Rhys-Q/album/hardware/reference/gdep133c02/README.md

# GDEP133C02 参考资料登记

审阅/获取日期：2026-10-01。用途：相框方案设计与后续 KiCad 电路审核。这里是厂家资料和人工整理表，不是已验证的 PCB 工程。当前结论（用户接受，2026-10-01）：**屏幕资料与设计决策已闭环，可进入最小驱动原型阶段**。到货匹配、器件选型与电气实测转实施验收，尚未完成；原图冲突仍保留，不声称厂家已解释。硬件尚未到货，未编译示例、未接屏或测量。

## 文件与来源

校验值、字节数、版本和审阅范围见 [manifest.json](manifest.json)。

| 文件 | 来源及用途 |
| --- | --- |
| [屏幕外围原理图](ESP32-133C02-screen-peripheral-V1.0.pdf) | [厂家附件](https://v4.cecdn.yun300.cn/100001_1909185148/Schematic%20for%20ESP32-133C02.pdf)，入口 [companyfile/2036](https://www.good-display.com/companyfile/2036.html)；13.3E6、V1.0、2024-07-17 更新、1 页。含电源、温度传感器、FPC；不含 MCU、SD、USB 或 AA 降压器。 |
| [开发板手册](EN-ESP32-133C02-Rev2.0.pdf) | [厂家附件](https://v4.cecdn.yun300.cn/100001_1909185148/EN-ESP32-133C02.pdf)，Rev2.0、2026-03-12、23 页。用于 GPIO、双片选与使用须知。 |
| [TPS22913 数据手册](TPS22913-SLVSB49F.pdf) | [TI 原文](https://www.ti.com/lit/ds/symlink/tps22913.pdf)，SLVSB49F、37 页。用于 U5 输入范围、使能、输出放电及封装审核。 |
| [TCN75A 数据手册](TCN75A-DS21935C.pdf) | [Microchip 原文](https://ww1.microchip.com/downloads/en/DeviceDoc/21935c.pdf)，DS21935C、32 页。用于 U4 电源、地址和功耗审核。 |
| [逐脚核对表](pin-map.csv) | 用户规格书 p6–7 与外围电路 p1 的人工交叉录入；60 行。电路详细节点仍以原图为准，不是自动生成的网表。 |
| [参考器件表](reference-bom.csv) | 外围电路 p1 的位号和值；包含 U1/U2/U3 三只 200mΩ 采样电阻。不是可直接下单的生产 BOM。 |

用户确认新增资料来自[商家提供的厂家产品页](https://www.good-display.cn/product/503.html)。用户提供的 [规格书](../../../docs/raw/GDEP133C02.pdf) 和 [源码 ZIP](<../../../docs/raw/GDEP133C02-ESP32 code example.zip>) 保留在原位置；不重复归档 ZIP 中约 48MB 的源码及旧构建缓存。源码审阅结果见 [PCB 方案 2.4](../../../docs/design/pcb.md#24-用户提供资料的审阅结果与闭环判定)。厂家 `Schematic for ESP32-133C02-IL.pdf` 与已归档单页电路 SHA-256 相同；不能因为文件名有 IL 就认定它解释了另一硬件版本。

附件来自厂家公开下载，未发现独立的再分发许可；保留原始版权，当前作为项目内部技术审阅资料，公开再发布时核对权利条件。用户已说明新增ZIP来源为商家提供的厂家页面；使用/再分发许可仍待核对。图纸含 EasyEDA 标志，仅作为电路参考；正式设计仍使用 KiCad。

下载注意：厂家 CDN 直接访问可能返回 403；本次通过官方站点 Referer 下载成功。归档时验证了 PDF 内容、页数和哈希；失败响应未作为 PDF 归档。后续核对附件版本，不以网页时间覆盖文档日期。

## 已取得的电路依据

- `EPD_VDD` → U5 → `VIN`；`VIN` 分成逻辑供电（L4 → EPD_3.3V → VDD/VDDIO）和模拟供电（L5/R31/C31/C32/R32 → AVDD）。电路本身没有输入稳压器；本项目选择前级稳压 3.3V，不能从 AA 原电池或 USB 5V 直接接入。
- 外置正/负压、电荷泵和 TFT_VCOM 使用面板控制/反馈脚与分立 MOS、BJT、二极管、电感；图中没有额外独立的专用升压控制 IC。本项目使用现有初始化与面板内置VCOM（规格书p12）；OTP/波形与温度命令按到货及最小显示结果验证。
- U4 TCN75A 与其 TSCL/TSDA 上拉均在 EPD_3.3V 域；A0–A2 接地。不能把它改为常供电，或直接当成 MCU I²C 外设。
- BUSY 通过 R1=2kΩ 上拉到 VDDIO。Pin12/18 为相连的内部 VCC；Pin13/14、16/17 分别为 VDDP/VDDN；六组源极输出/输入对分别相连。NC11/15/57 保持不接。连接器61/62为固定焊脚，不是面板信号61/62。
- 参考电容没有完整耐压、介质、有效容量或封装信息；15uH 电感没有 Isat/DCR。所有关键器件必须完成实际料号选型和布局审核。

## 采用决策及实施验收

用户于2026-10-01接受现有资料和以下方案，完成资料与设计决策闭环。详细流程以[PCB方案2.4.5](../../../docs/design/pcb.md#245-用户接受的设计基线与闭环判定)为准；资料闭环不代表硬件验证或生产放行。

| 项目 | 本项目采用决策 | 实施验收/历史差异 |
| --- | --- | --- |
| BS0/BS1及D/C | Standard SPI；BS0/BS1接受控VDD，D/C接GND | 规格书p6/8/13和8bit示例为依据。原图R24/R25接地矛盾保留，不复制到设计；不等待厂家解释 |
| DRVN2及VNCP | Pin40不接外部支路；Pin41经R16=0Ω接Pin56 | 沿用参考负压拓扑；原型测负压/显示，不宣称面板批次保证 |
| 面板/初始化 | 现有GDEP133C02规格书与原生示例，面板内置VCOM | 到货核对标签/FPC/连接器，验证OTP/波形与温度处理；不匹配时复核基线 |
| 正常关机 | 刷新完成、POF、正确等待BUSY、深睡、接口断电安全处理、关闭输入 | 规格书p22串口停止到输入下降间隔>10µs，原型起点1ms；全轨放电时间另测，不用固定20ms代替BUSY完成 |
| 异常掉电 | 未取得厂家安全保证，不声称已验证 | 原型阶段测试欠压、MCU复位、超时、各轨衰减、反灌及恢复；不得无限重试 |
| 纯手动刷新 | 无24h自动刷新或180s强制间隔 | 厂家建议差异保留，后续评估长期保持及快速换图的残影/寿命 |
| 器件与工程 | 按参考表推进自制KiCad最小原型 | 精确连接器、SI2/SI3未用输入处理、被动参数、完整采购BOM和电路审核在实施阶段完成 |

逐脚表新增 `adopted_design_connection` 字段；`reference_connection` 保留参考图事实。BS0/BS1、D/C和DRVN2按采用字段绘制项目电路；参考器件表仍是原图录入，R24/R25的原图值不能代替本项目绑带连接。

新增交叉依据：

- [微雪官方13.3寸驱动板原理图p1](https://files.waveshare.com/wiki/13.3inch%20e-Paper%20HAT%2B/13.3inch_e-Paper_HAT%2B.pdf)：也以0Ω连接VNCP_3P5V/VBB_3P5V，DRVN2没有外部支路，支持所选拓扑的工程推断。不同产品电感/器件值不直接移植，不将其当佳显面板批次保证。
- [GDEP133C02开源驱动](https://github.com/philippwaller/esphome-epaper-spectra6-133)：支持深睡后关闭外部电源，并要求验证开关关断行为。仅作实现交叉参考，不替代厂家资料或本项目实测。

上述在线资料未下载归档；URL及本次审阅范围登记在manifest的`online_references`中。

## 新增用户资料对比记录

- `GDEP133C02 (1).pdf` 与原规格书字节及SHA-256相同，不是新版本。
- `GDEP133C02-ESP32程序示例.zip` 与英文ZIP包装不同；统一工程路径后1432个文件内容全部相同，包含源码、配置及旧build，无驱动改动。
- 中文开发板手册标V1.1、2025/6/5，实际20页（页脚总数写21）；英文标Rev2.0、2026/03/12、23页。GPIO、双IC及电压/刷新建议一致，远程传图流程与附加刷机章节不同。
- 中文目录4.4、正文5.5.2与4.4下载入口混用，英文还有4.4.7章节；源码锁定4.4.4。首轮干净构建以源码基线为准，手册不能证明5.5.2兼容。

## 连接器采购线索

规格书给出 `196070-60041`；[P-TWO 196070 系列](https://www.p-two.com/index.php?do=prod&id=748) 为 0.5mm、前翻锁、下接触、2.2mm 高度；[TI 官方参考 BOM](https://www.ti.com/lit/df/tidrd16/tidrd16.pdf) 将该 60Pin 料号归于 P-TWO。外围图采用不同的 `FPC-05FB-60PH20`；[XUNPU 产品系列](https://www.xunpu.com.cn/product/413.html) 和 [嘉立创 C2856839](https://jlcpcb.com/partdetail/XUNPU-FPC_05FB60PH20/C2856839) 提供采购线索。两料号不能视为同封装替换；采购页面不替代厂家焊盘图、实际 FPC 插接或当前库存检查。

## 给厂家的具体确认清单

保留作后续适用说明和问题排查，不作为已接受方案闭环的前置条件。若厂家提供与采用基线不同的明确说明，记录差异并复核受影响电路/测试。

1. 对应实际屏幕标签/FPC批次的规格书、初始化、OTP/波形/VCOM和温度设置版本是哪一套？
2. 首版使用8bit单线 Standard 4-wire SPI：BS0/BS1、D/C#、SI2/SI3正确接法是什么？为何V1.0参考图两个BS电阻接地？
3. 该外围拓扑中 DRVN2 是否允许不接？Pin41与Pin56相连是否适用于此屏幕？
4. 正常 POF、等待 BUSY、0x07/0xA5、撤销输入的保证顺序是什么？刷新中 MCU 复位或输入消失时有哪些禁止条件、最大残压/放电时间和恢复程序？
5. 规格书电流对应哪个测量节点？高负载最低输入、浪涌/刷新最坏值与全温超时上限是什么？待机电流/功率矛盾如何解释？
6. 长期纯手动静态显示、超过24h不刷新和用户180s内连续换图是否允许？影响残影/寿命的条件是什么？
7. 提供连接器完整尺寸/焊盘图、关键电容耐压/电感规格、可复现 BOM 和示例使用许可。

仅准备了问题清单，未向厂家发送消息。Quad 不是首版必须项；后续希望启用时再获取对应协议与实测。
