Rhys-Q/album/hardware/pcb/gdep133c02-driver/releases/jlc-cn-review-v0.11-basic17-2026-10-11/README.md

# v0.11 17组基础库原型制造审阅包

147个装配件，145个顶面SMD，其中138个机器贴片、9个手工装配；36组完整BOM、29组机器BOM、7组手工BOM。BOM/CPL/制造文件来源见verification.json。

CAD及原生KiCad更新预览已通过；电气实板性能尚未验收。

Gerber压缩包含四层铜、双面阻焊/丝印、板框及PTH/NPTH钻孔。基础库17组由用户指定采用；3组参数审核通过，14组等效性能未验证。组合新增43件，不承诺订单总价节省。C15008 SMT库存未知，部分公开库存刷新未成功；订单重核。剩余7组保留原型号；E02/E07/E16/E23/E25由用户淘宝采购手工装配，机器贴片只保留E06/E24两组收费例外。J1/J2也手工装配。

新增密集区部分位号仅在F.Fab，装配时结合assembly-top.pdf与BOM。Q7保留R49；低栅压驱动、瞬态、偏压容量、温升、显示和安全掉电需焊后验收。

装配清单修订：2026-10-11，U4/U5/Q3/D3/D5/D6/FPC1从机器BOM及CPL移除，转入手工BOM。原理图、PCB、Gerber及钻孔字节不变；既有CAD验收结果沿用，本次验证装配集合和来源哈希。positions-kicad.csv仍含所有145个SMD，是CAD原生坐标参考；嘉立创下单只用bom-smt.csv和cpl-smt.csv。完整BOM保留147件；不要漏装手工器件。
