Rhys-Q/album/hardware/pcb/gdep133c02-driver/releases/jlc-cn-review-v0.10-e01-2026-10-11/README.md

# v0.10 E01 C440198 原型制造审阅包

104个装配件，102个顶面SMT；BOM/CPL/制造文件来源见verification.json。

CAD检查及GUI更新预览已通过；实板性能尚未验收。

Gerber压缩包包含四层铜、双面阻焊/丝印、板框及PTH/NPTH钻孔。钢网仅在锡膏工艺时按需使用。采购费用缺口留空，Q7国内现货未闭环。E01 22只改为C440198基础库0805 X5R，85℃上限；偏压容量/ESR/纹波等效未验证。较v0.9经济型规则再减少20元/订单；102件SMT仍全部列入机器BOM/CPL，其余24组普通扩展保留，尚未实施混合装配。其他加工费及完整采购仍有缺口，详见E01改版说明及采购CSV。
