Rhys-Q/album/hardware/pcb/gdep133c02-driver/releases/jlc-cn-review-v0.9-resistors-2026-10-10/README.md

# v0.9 三组电阻免换料费制造审阅包

104个装配件，102个顶面SMT；BOM/CPL/制造文件来源见verification.json。

CAD检查及GUI更新预览已通过；实板性能尚未验收。

Gerber压缩包包含四层铜、双面阻焊/丝印、板框及PTH/NPTH钻孔。钢网仅在锡膏工艺时按需使用。采购费用缺口留空，Q7国内现货未闭环。仅三组电阻改为免换料费型号，经济型规则下减少60元/订单；102件SMT仍全部列入机器BOM/CPL，其余25组普通扩展保留，尚未实施混合装配。其他加工费及完整采购仍有缺口，详见三组改版说明及采购CSV。
