Rhys-Q/album/docs/design/单独购买.md

# 自行购买元器件清单（v0.11）

依据最新release的`gdep133c02-driver-bom-manual.csv`整理，2026-10-11。以下为已分配手工装配的7组、每板9件；这不是未焊元件删减版电路，全部仍应按设计装配。

用户已下单，但本文件没有读取实际订单贴片数量。请按**需要完成焊接的板数**计算，不按工厂赠送/附带的裸板数直接购买。

| 位号 | 用途 | 准确型号 | 封装 | C编号（检索参考） | 每板必需 | 1板＋每型号2件备品 | 5板必需 | 5板＋每型号2件备品 |
|---|---|---|---|---|---:|---:|---:|---:|
|U4|温度传感器|TCN75AVOA713|SOIC-8|C144313|1|3|5|7|
|U5|电源负载开关|TPS22917DBVR|SOT-23-6|C2681320|1|3|5|7|
|Q3|PNP三极管|MMBT3906-7-F|SOT-23|C82762|1|3|5|7|
|D3,D5,D6|串联双肖特基二极管|BAT54SLT1G|SOT-23|C19726|3|5|15|17|
|FPC1|屏幕可插拔插座|FPC-05FB-60PH20|FPC 60P 0.5mm|C2856839|1|3|5|7|
|J1|3.3V输入，1×2直排针|TJC8-2.54-2A|PinHeader 1x02 2.54mm|C42410552|1|3|5|7|
|J2|主机接口，2×8直排针|SH-PZ254V-2x8P|PinHeader 2x08 2.54mm|C55629829|1|3|5|7|

数量公式：每种采购量＝每板用量×待装配板数＋备品。备品列统一按每种型号加2件，属于建议，不是强制；淘宝商家按包销售时向上取整。

- 完成1板：最低9件；按每型号加2件备品共23件。
- 完成5板：最低45件；按每型号加2件备品共59件。
- J1/J2虽然没有列在此前5组淘宝采购的例外中，但一直由用户手工装配，仍需自行准备。排针使用2.54mm直插，J1为单排2针，J2为双排2×8共16针；尺寸与原封装匹配，长排针可按实际结构裁切。

## 购买时核对

- TCN75AVOA713：SOIC-8；不要未经审核改用LM75/TMP75等相似名字的芯片。
- TPS22917DBVR：SOT-23-6；不要买成不同封装或功能不同的负载开关。
- MMBT3906-7-F：SOT-23，PNP，B/E/C=1/2/3；不要买成NPN的3904或直插2N3906。其他厂商3906不能仅凭简称确认等效。
- BAT54SLT1G：SOT-23，必须是**串联双肖特基**，1=A1、2=K2、3=中点；BAT54A/BAT54C内部连接不同，不能替代。
- FPC-05FB-60PH20：60P、0.5mm、现有接触方向/排线厚度/锁扣结构必须相同；不要只按“60P 0.5mm”购买。
- 淘宝商品标题或商家给出的同类替代不等于已通过本板审核；核对实物丝印、包装型号及封装。

## 不需要重复购买

E06的U1/U2/U3采样电阻、E24的L1/L2/L3功率电感仍在机器贴片BOM内；其他138个机器贴片器件也不在本清单中。此判断依据提交的release装配分配，若订单实际匹配时出现未贴/缺料，再补买对应器件。

铜测试点、安装孔是PCB结构，不是要购买的器件。屏幕、主机板、接口线缆、3.3V供电及安装螺丝不在这份手工BOM中；已拥有的无需重复采购，缺少的需另外准备。

## 来源

[最新手工BOM](../../hardware/pcb/gdep133c02-driver/releases/jlc-cn-review-v0.11-basic17-2026-10-11/gdep133c02-driver-bom-manual.csv)；[手焊说明](../../hardware/pcb/gdep133c02-driver/releases/jlc-cn-review-v0.11-basic17-2026-10-11/手焊说明-v0.11.md)。
