Rhys-Q/album/docs/design/原理图子图元器件统计与必要性.md

> 2026-10-10 v0.8：6组电阻共8位号换合格低价料；D3/D5/D6变为BAT54SLT1G；C28变为4.7µF/50V并入既有料，元件数量保持。逐项来源、成本及未采用原因见[降本审核](../../hardware/pcb/gdep133c02-driver/docs/降本审核-v0.8.md)。

> 2026-10-09 v0.7：L1–L3改用PCR1040-150-M，C28改用CL32B225KBJNNNE，C36改用0805CG102J500NT；连接与功能保持，参数和焊盘依据见工程docs/三组现货替代-v0.7.md。

# GDEP133C02驱动板：逐页、逐子图元器件统计与必要性

统计日期：2026-10-09。对象为当前 **v0.6 国内采购手焊版**原生KiCad工程，已按用户要求移除L4/L5、同步原理图/PCB及制造审阅文件，DNP状态不变。以下数量直接按当前原理图符号位号核对，并用本次KiCad导出网表确认器件值及网络，不以旧教程的标题数量推算。

## 1. 如何理解数量和“必须/可选”

每个实际器件位号计1件：60针FPC插座算1件，BAT54S内部两只二极管也只算1件；同型号并联的多只电容分别计数。GND/PWR_FLAG、标签、导线、连接点、NC叉号、功能框和分层入口不属于采购元器件；4个PCB安装孔不在原理图数量内。

| 判定 | 本文含义 | 当前装配建议 |
|---|---|---|
| **必须** | 实现当前电路、默认状态、容量/反馈预算所需；并不表示将来不能重新设计 | 按当前BOM装配 |
| **条件可选** | 有明确的替代接线、桥接或替代功能方案后可以取消；条件尚未验证 | 当前仍按BOM装配，不能仅因标“可选”少焊 |
| **可选（铜测试点）** | 只帮助测试；不参与电路功能，也不是要采购的器件 | PCB已有铜焊盘，无需装配 |

必要性判定是基于当前拓扑、接口约定和功能范围的工程判断，不是厂家给出的“最少元件数量”，也不是已经实测通过的减配结论。

本版104个装配件中：**92件按当前设计必须保留，12件为需改接线/验证的条件可选**；另有26个可选铜测试点。**当前没有已确认可以直接空焊而不改设计的装配件。** 未指定必须满足的新功能、并取得相关器件/面板数据及实测前，不能把“基本能亮”当作可以删件的依据。

## 2. 总数与子图导航

| 原理图 | 装配元件 | DNP铜测试点 | 非电源符号实体总数 | 说明 |
|---|---:|---:|---:|---|
| 顶层gdep133c02-driver.kicad_sch | 0 | 0 | 0 | 只提供三个分层页入口，不再重复计算页内元件 |
| power.kicad_sch | 56 | 2 | 58 | 六个电源功能区 |
| panel.kicad_sch | 37 | 0 | 37 | 四个功能框；含六组源极电容 |
| interface.kicad_sch | 11 | 24 | 35 | 主控连接器、五路输出和铜测试点 |
| **合计** | **104** | **26** | **130** | 102个SMT＋J1/J2两个直插装配件 |

子图按图中功能框和连线归属划分。Panel的C8/C9目前画在功能区2框内，本统计在那里列出，并注明实际为电极输出旁路；R20/R21虽然位于温度框外，按实际TSCL/TSDA连接归入温度功能区3。这样既能在现有图上找到元件，也不误解电路功能。Interface没有编号功能框，按同一行通道分子图；公共J2只计一次。

| 页面 | 子图 | 数量：装配/铜测试点 | 必须/条件可选/测试点可选 |
|---|---|---:|---:|
| power | P1 功能区1：3.3V输入、负载开关和供电分配 | 10/0 | 9/1/0 |
| power | P2 功能区2：VDDP正电源升压 | 7/0 | 7/0/0 |
| power | P3 功能区3：VDDN负电源反相 | 7/0 | 7/0/0 |
| power | P4 功能区4：VCOM所需负偏置供电 | 8/2 | 7/1/2 |
| power | P5 功能区5：VGH正栅极电荷泵 | 11/0 | 11/0/0 |
| power | P6 功能区6：VGL负栅极电荷泵 | 13/0 | 13/0/0 |
| panel | N1 功能区1：屏幕连接器与内部/边框旁路 | 4/0 | 4/0/0 |
| panel | N2 功能区2：SPI模式/信号默认状态及本框电极电容 | 5/0 | 5/0/0 |
| panel | N3 功能区3：屏幕控制的温度检测 | 4/0 | 0/4/0 |
| panel | N4 功能区4：六组源极输出配对与电容阵列 | 24/0 | 24/0/0 |
| interface | I1 主控连接器J2 | 1/0 | 0/1/0 |
| interface | I2 时钟SCLK输出通道 | 2/0 | 1/1/0 |
| interface | I3 写数据MOSI/SI0输出通道 | 2/0 | 1/1/0 |
| interface | I4 Master片选输出通道 | 2/0 | 1/1/0 |
| interface | I5 Slave片选输出通道 | 2/0 | 1/1/0 |
| interface | I6 RESET输出通道 | 2/0 | 1/1/0 |
| interface | I7 电源、状态和地参考铜测试点 | 0/24 | 0/0/24 |

两条没有独立元件的Interface连线也属于子电路：BUSY_N和SI1直接返回J2，新增器件数为0；EPD_PWR_EN从J2直接去电源页，新增器件数为0，U5/R30在power页统计。不能把跨页复用的器件再加一次。

## 3. Power：六个电源子图（56个装配件＋2个铜测试点）

能量路径为稳压3.3V输入→U5→逻辑/模拟分支→三路电感变换器及两路栅极泵。屏幕内部控制器负责GDR/DRV和反馈控制；SPI主控没有直接生成这些功率级PWM。

### P1 功能区1：3.3V输入、负载开关和供电分配

10件＝J1、U5、R30和7只电容。只有一台外部3.3V源，BENCH_3V3为开关前；EPD_3V3为开关后，逻辑与功率用同网铜线分支供电。L4/L5已删除，不需购买，也不需要0Ω替代。U5不是稳压器；QOD不能证明全部高压轨都已安全放电。

| 位号 | 当前值/器件类型 | 作用 | 必须或可选 | 保留理由或省略条件 |
|---|---|---|---|---|
| J1 | 3V3 BENCH ONLY | 稳压3.3V电源输入排针；1为正、2为地。 | **条件可选** | 只有改用可靠电线/其他连接器接原焊盘才可不装排针；电源连接本身必须存在。 |
| C28 | 4.7µF/50V | U5输入侧本地去耦，给开关启动与负载瞬态提供局部电荷。 | **必须** | 保留输入去耦，不能因外部电源已有大电容就直接省略。 |
| U5 | TPS22917DBVR | 高有效TPS22917负载开关，通断屏幕低压输入；QOD接输出参与关断放电。 | **必须** | 当前依赖它控制上电/关机；不装会断电，直接短接会取消受控供电及放电设计。 |
| R30 | 100kΩ | EPD_PWR_EN到地100k下拉，使主控高阻时U5默认关闭。 | **必须** | 必须保留明确的默认关断状态；EN=3.3V时该电阻电流约33µA。 |
| C29 | 4.7µF/50V | EPD_3V3到地4.7µF输出去耦，缓冲局部负载变化。 | **必须** | 与C30虽并联，但局部回路和总有效容量都要满足，未验证可减为单只。 |
| C30 | 4.7µF/50V | EPD_3V3到地第二只4.7µF去耦，按分布位置支持后级电流。 | **必须** | 不能只因与C29同网就判断重复；删减须重新验收容量和瞬态。 |
| C31 | 100µF/6.3V | EPD_3V3到地100µF储能，供应三路功率级的负载变化。 | **必须** | 与C32构成名义200µF容量组；减量或换料须核对偏压有效容量、启动和环路。 |
| C32 | 100µF/6.3V | EPD_3V3到地另一只100µF，与C31共同承担储能。 | **必须** | 不能按“并联所以可选”省略；当前容量预算包括这只。 |
| C33 | 100nF/50V | EPD_3V3到地100nF逻辑高频去耦。 | **必须** | 小电容和短回路处理快速扰动，不能由远处大储能电容替代。 |
| C36 | 1nF/50V C0G | 1nF软启动斜率电容，接U5 CT与芯片输入BENCH_3V3。 | **必须** | 本板的大电容启动方案依赖该参数；不可改接地，尚未验证可以不装。 |

### P2 功能区2：VDDP正电源升压

7件。Q1导通让L1储能，关断时经D1将能量送到VDDP；U1检测电流，C13维持输出。

输出电压依据：屏幕[GDEP133C02规格书](../raw/GDEP133C02.pdf)第21页的上电时序图标注VDDP为**+16～+19V**；不是第11页VGH的典型+27V。实际设定及容差需要匹配控制器初始化/内部配置并实测，不由15µH电感单独决定。L1=15µH、U1=0.2Ω、R2=1MΩ、C12=4.7µF、C13=10µF及Q1/D1型号沿用[厂家外围参考图](../../hardware/reference/gdep133c02/ESP32-133C02-screen-peripheral-V1.0.pdf)。目前属于参考设计取值，尚未取得实际开关频率、VDDP最大负载、RESEP峰值阈值及补偿参数，不能声称完成独立参数计算或硬件验收。详见[电源原理说明](../../hardware/pcb/gdep133c02-driver/docs/power-circuit-explained.md)。

| 位号 | 当前值/器件类型 | 作用 | 必须或可选 | 保留理由或省略条件 |
|---|---|---|---|---|
| L1 | 15µH | EPD_3V3到LX的15µH电感，Q1导通储能、关断向正输出送能。 | **必须** | 升压能量转换核心，不能删或用导线代替。 |
| Q1 | DMN3065LW-7 | NMOS低边开关，屏幕GDRP驱动它周期性将LX拉低。 | **必须** | 正升压开关核心；型号/引脚或驱动改变须重审。 |
| D1 | MBR230S1F-7 | LX到VDDP的肖特基整流，开关关断时向正输出送电。 | **必须** | 提供整流和续流路径，删掉不能正常建立正输出。 |
| U1 | 0.2Ω | 0.2Ω电流采样电阻，RESEP到GND，将Q1电流变为采样压差。 | **必须** | 虽用U位号，实际是电阻；短接或省略会破坏采样/电流回路。 |
| R2 | 1MΩ | 1M栅极下拉，GDRP高阻时使Q1倾向关闭。 | **必须** | 默认关断和栅极泄放功能应保留，不等同可删的测量电阻。 |
| C12 | 4.7µF/50V | 正升压输入EPD_3V3本地4.7µF去耦，缩短导通脉冲回路。 | **必须** | 远处C31/C32不能替代此处的局部回路。 |
| C13 | 10µF/50V | VDDP到地10µF输出储能，D1不送电时支持负载。 | **必须** | 维持正输出及纹波/环路条件；不能省略。 |

### P3 功能区3：VDDN负电源反相

7件。Q8高边导通给L2储能，关断时开关节点拉负，经D2形成VDDN；U2为高边采样。

| 位号 | 当前值/器件类型 | 作用 | 必须或可选 | 保留理由或省略条件 |
|---|---|---|---|---|
| Q8 | DMP3068L-7 | PMOS高边开关，GDRN使其导通，驱动L2反相变换。 | **必须** | 负电源功率开关核心，必须满足实际负VGS驱动。 |
| U2 | 0.2Ω | 0.2Ω高边采样，EPD_3V3到RESEN，检测反相支路电流。 | **必须** | 采样和主电流路径必须保留，不能改为普通0Ω。 |
| L2 | 15µH | SW_N到地15µH电感；关断时SW_N拉负形成负电源。 | **必须** | 反相储能核心，与L1不同接法，不能替代为导线。 |
| D2 | MBR230S1F-7 | VDDN到SW_N的肖特基，反相关断时给电感续流并从输出抽电荷。 | **必须** | 二极管方向决定负输出；删掉或反接会破坏变换。 |
| R3 | 1MΩ | 1M从EPD_3V3拉到GDRN，驱动高阻时使PMOS倾向关闭。 | **必须** | 保留默认关断，不能因阻值大就省略。 |
| C14 | 4.7µF/50V | 反相支路EPD_3V3本地4.7µF输入去耦。 | **必须** | 为高边开关脉冲提供局部回路。 |
| C15 | 10µF/50V | VDDN到地10µF负输出储能和纹波滤波。 | **必须** | 负输出所需；现用无极性陶瓷，换有极性电容须重新审核方向与参数。 |

### P4 功能区4：VCOM所需负偏置供电

8个装配件＋2个铜测试点。参考PMOS反相电路建立屏幕41/56脚负偏置，不是直接生成55脚TFT_VCOM波形；Q7/GDRC驱动匹配仍待测量。

| 位号 | 当前值/器件类型 | 作用 | 必须或可选 | 保留理由或省略条件 |
|---|---|---|---|---|
| Q7 | PJA3433_R1_00001 | 参考方案采用的PMOS高边开关，GDRC驱动负偏置支路。 | **必须** | 此支路必须有匹配的开关；规格书驱动描述与参考PMOS存在待测差异，保留不等于已验证。 |
| U3 | 0.2Ω | 0.2Ω高边采样，EPD_3V3到RESEC，检测偏置支路电流。 | **必须** | 不能删/短接采样元件。 |
| L3 | 15µH | SW_VCOM到地15µH电感，生成VCOM相关负偏置供电。 | **必须** | 偏置电源能量转换核心；不直接生成TFT_VCOM波形。 |
| D4 | B0530W-7-F | VBB_3P5V到SW_VCOM肖特基，给偏置反相支路整流/续流。 | **必须** | 必须保留方向和电流/耐压合适的整流通路。 |
| R13 | 1MΩ | 1M从EPD_3V3拉到Q7_GATE，使驱动释放时Q7趋向关闭。 | **必须** | 保留默认状态；实际驱动极性仍需测量。 |
| C19 | 4.7µF/50V | 负偏置支路EPD_3V3本地4.7µF去耦。 | **必须** | 支持局部脉冲电流，不能仅依赖总输入电容。 |
| C20 | 10µF/50V | VBB_3P5V到地10µF负偏置储能，供屏幕41/56脚共用节点。 | **必须** | 偏置轨必须有足够有效容量；不能直接省略。 |
| R49 | 0Ω，0805 | GDRC至Q7_GATE的可拆调试断点，正常工作连通屏幕输出与Q7栅极。 | **条件可选** | 当前按BOM装；取消电阻必须用铜线或可靠桥接替代，不能空焊。 |
| TP25 | GDRC | 屏幕驱动输出侧铜测试点。 | **可选（铜测试点）** | DNP，不采购；拆R49后可测控制器空载输出。 |
| TP26 | Q7_GATE | Q7栅极侧铜测试点。 | **可选（铜测试点）** | DNP，不采购；与RESEC差分测量VGS，R13保留在此侧。 |

### P5 功能区5：VGH正栅极电荷泵

**11件**。Q3/Q4控制正泵基准，C17和D3转移/整流电荷，R7/R8将输出电压反馈到FBP。旧电源教程该小节标题的“12件”多计1件，当前实际位号只有下面11件。

| 位号 | 当前值/器件类型 | 作用 | 必须或可选 | 保留理由或省略条件 |
|---|---|---|---|---|
| Q3 | MMBT3906-7-F | PNP高电位供电/调节管，从VDDP向正泵基准PUMP_P_LOW送电。 | **必须** | 正泵受控基准的核心，直接删除不能等效。 |
| Q4 | DMN3065LW-7 | NMOS由DRVP驱动，抽取Q3基极电流，实现高电位侧控制。 | **必须** | 屏幕低压控制到PNP控制的必要路径。 |
| R11 | 100kΩ | 100k从VDDP拉到Q3基极，Q4关闭时使PNP默认关闭。 | **必须** | 需要基极释放及确定默认状态。 |
| R12 | 1.5kΩ | 1.5k接Q4源极到地，源极退化并约束基极吸入电流。 | **必须** | 不是无功能跳线；短接会改变调节和电流条件。 |
| D3 | BAT54SLT1G | BAT54S双肖特基，分别给飞跨节点钳位和向VGH整流。 | **必须** | 两个内部二极管仍只算一个物理器件；正泵核心。 |
| C16 | 4.7µF/50V | VGH到地4.7µF最终正栅极输出储能。 | **必须** | 支持栅极负载及输出纹波。 |
| C17 | 470nF/50V | 470nF飞跨电容，LX跳变时搬运电荷到正泵。 | **必须** | 能量转移核心，不是普通可选去耦。 |
| C18 | 220nF/50V | 220nF接正泵受控基准到地，稳定Q3送电节点。 | **必须** | 基准储能/动态负载的一部分，改变会影响泵响应。 |
| R7 | 4.3kΩ | 4.3k从FBP到地，正输出电压反馈分压下臂。 | **必须** | 反馈必需，与R8共同设定检测比例；删/短会失去正确反馈。 |
| R8 | 110kΩ | 110k从VGH到FBP，正输出反馈分压上臂。 | **必须** | 反馈必需，不能为了省焊接改掉比例。 |
| R10 | 2.2Ω | 2.2Ω串在LX到正泵飞跨驱动中，阻尼并约束充放电脉冲。 | **必须** | 当前动态设计包括此阻值；未经波形/环路验证不能直接短接。 |

### P6 功能区6：VGL负栅极电荷泵

13件。Q6控制负泵基准，两级D6/C24与D5/C23建立VGL，R17/R18以REG_VGN为参考反馈。

| 位号 | 当前值/器件类型 | 作用 | 必须或可选 | 保留理由或省略条件 |
|---|---|---|---|---|
| Q6 | MMBT3904-7-F | NPN由DRVN驱动，下拉/钳位负泵基准节点。 | **必须** | 负泵控制核心；基极直接驱动能力仍需实测。 |
| D5 | BAT54SLT1G | BAT54S双肖特基，第二级负泵的钳位和整流。 | **必须** | 建立更负VGL的核心，不能删去一级。 |
| D6 | BAT54SLT1G | BAT54S双肖特基，第一级负泵的钳位和整流。 | **必须** | 建立中间负电位的核心。 |
| C21 | 4.7µF/50V | VGL到地4.7µF最终负栅极电源储能。 | **必须** | 维持负栅极轨及纹波。 |
| C22 | 1µF/50V | 1µF接两级负泵中间节点到地，存储第一级负电位。 | **必须** | 第二级所需储能基准，不与C21重复。 |
| C23 | 470nF/50V | 470nF第二级飞跨电容，驱动PUMP_N_UP。 | **必须** | 第二级电荷转移核心。 |
| C24 | 470nF/50V | 470nF第一级飞跨电容，驱动PUMP_N_DOWN。 | **必须** | 第一级电荷转移核心；与C23同值但不是可合并的同一节点。 |
| C25 | 1µF/50V | REG_VGN到地1µF去耦，稳定内部参考电压输出。 | **必须** | 负反馈使用该参考，不可把参考当成GND或省其去耦。 |
| C26 | 47nF/50V | 负泵Q6钳位节点到地47nF局部储能/去耦。 | **必须** | 决定基准瞬态的一部分，不能仅因容量小就删除。 |
| R17 | 200kΩ | 与R50串联，合计400kΩ，从VGL到FBN构成负输出反馈网络一臂。 | **必须** | 与R18/REG_VGN形成带参考电位的反馈，必须保留。 |
| R50 | 200kΩ | 与R17串联，使用常见0805阻值；中点VGL_FB_MID无额外负载。 | **必须** | 新增后两只均需装，不能单只空焊。 |
| R18 | 16kΩ | 16k从FBN到REG_VGN，负反馈的参考电位一臂。 | **必须** | 另一端不是地；删除或接地会改变负压调节。 |
| R19 | 2.2Ω | 2.2Ω串联驱动两个负泵飞跨电容，提供阻尼及脉冲约束。 | **必须** | 不能直接短接；其脉冲负担为两只飞跨电容之和。 |

## 4. Panel：四个子图（37件）

### N1 功能区1：屏幕连接器与内部/边框旁路

4件。FPC1是排线插座；C7旁路内部供电，C10/C11分别旁路Master/Slave边框驱动。

| 位号 | 当前值/器件类型 | 作用 | 必须或可选 | 保留理由或省略条件 |
|---|---|---|---|---|
| FPC1 | FPC-05FB-60PH20 | 60针0.5mm屏幕排线插座，连接电源、功率驱动、SPI和显示节点。 | **必须** | 当前用户要求可插拔排线底座；不能不焊底座并直接把软排线焊板作为本版实现。 |
| C7 | 10µF/50V | 10µF接VCC到地；FPC12内部LDO输出与18内部供电脚配对后的旁路。 | **必须** | 内部供电稳定所需，不能与外部3.3V直接合并。 |
| C10 | 470nF/50V | 470nF，Master边框驱动VCOMBD_M到地旁路/电荷缓冲。 | **必须** | 屏幕边框输出的参考负载和动态网络，未经面板资料及显示验证不删。 |
| C11 | 470nF/50V | 470nF，Slave边框驱动VCOMBD_S到地旁路/电荷缓冲。 | **必须** | 与C10作用类似但属于另一输出节点，不能合并。 |

### N2 功能区2：SPI模式/信号默认状态及本框电极电容

5件＝3只默认状态电阻＋2只画在此框中的电极旁路电容。BS0/BS1已直接接EPD_3V3，D/C直接接地，因此绑带本身新增器件数为0。

| 位号 | 当前值/器件类型 | 作用 | 必须或可选 | 保留理由或省略条件 |
|---|---|---|---|---|
| R1 | 2kΩ | BUSY_N到EPD_3V3的2k上拉，使忙状态线有正确供电域的高电平来源。 | **必须** | 沿用厂家接口；当前未证实可用内部驱动完全代替，不能改拉到主控常供电。 |
| R35 | 100kΩ | 100k从未用SI2输入到地，避免其悬空。 | **必须** | 当前未确认内部有可靠默认拉电阻，保留未用输入的明确状态。 |
| R36 | 100kΩ | 100k从未用SI3输入到地，避免其悬空。 | **必须** | 与R35作用类似但属于另一个输入；不能直接不接。 |
| C9 | 470nF/50V | 470nF，FPL_VCOM公共电极驱动输出到地旁路/电荷缓冲。 | **必须** | 虽画在SPI默认状态框中，功能属于电极驱动负载，不是SPI滤波电容。 |
| C8 | 4.7µF/50V | 4.7µF，TFT_VCOM公共电极驱动输出到地旁路/电荷缓冲。 | **必须** | 与C9不同节点及容量，不能认为两者重复；未经动态验证不删。 |

### N3 功能区3：屏幕控制的温度检测

4件。U4由屏幕专用温度接口控制，R20/R21上拉、C27去耦；不是J2上的主控I²C。U4.3 ALERT为NC，R22/R23已经删除。取消此功能需要先确认并实现替代温度方案，当前没有这样的固件验收。

| 位号 | 当前值/器件类型 | 作用 | 必须或可选 | 保留理由或省略条件 |
|---|---|---|---|---|
| U4 | TCN75AVOA713 | TCN75A温度传感器，由屏幕TSCL/TSDA接口读取，地址绑带0x48。 | **条件可选** | 只有确认屏幕固件可不用外部传感器、具备有效替代温度来源/策略并验证刷新后，才可整组删除；当前仍装。 |
| R20 | 4.7kΩ | 4.7k，TSCL到EPD_3V3上拉，为温度串行时钟提供释放后的高电平。 | **条件可选** | 使用当前温度通路时必须；放弃并验证替代温度方案时才可与整组删除。 |
| R21 | 4.7kΩ | 4.7k，TSDA到EPD_3V3上拉，为开漏数据线提供高电平。 | **条件可选** | 使用当前温度通路时必须；不能仅删一只仍期待传感器正常工作。 |
| C27 | 100nF/50V | 100nF，U4供电到地的本地去耦。 | **条件可选** | U4保留时必须；只有整组温度检测取消后它才不再需要。 |

### N4 功能区4：六组源极输出配对与电容阵列

24件。六组配对节点各用4只电容，按当前组合每只都计入所需容量；同网并联不等于任何一只可以随意删去。

| 源极网络 | 屏幕配对引脚 | 四个电容位号 | 名义总容量 |
|---|---|---|---|
| VSPH | 42/45 | C1、C103、C104、C105 | 3×10µF＋3.3µF＝33.3µF |
| VSPL | 43/46 | C2、C106、C107、C108 | 3×10µF＋3.3µF＝33.3µF |
| VSPL2 | 44/47 | C3、C109、C110、C111 | 3×10µF＋3.3µF＝33.3µF |
| VSNH | 48/53 | C4、C112、C113、C114 | 3×10µF＋3.3µF＝33.3µF |
| VSNL | 49/52 | C5、C115、C116、C117 | 3×10µF＋3.3µF＝33.3µF |
| VSNL2 | 50/51 | C6、C118、C119、C120 | 3×10µF＋3.3µF＝33.3µF |

下面仍逐只列出，避免把“六组电容”误统计成六个元件。

| 位号 | 当前值/器件类型 | 作用 | 必须或可选 | 保留理由或省略条件 |
|---|---|---|---|---|
| C1 | 10µF/50V | VSPH到地的10µF并联储能电容，组内第1只10µF；缓冲源极驱动电流并维持节点电压。 | **必须（容量组）** | 必须（按当前容量组）；每组3×10µF＋3.3µF，不能逐只当作冗余。少装或改单只替代须验证高压偏置有效容量、纹波和环路。 |
| C103 | 10µF/50V | VSPH到地的10µF并联储能电容，组内第2只10µF；缓冲源极驱动电流并维持节点电压。 | **必须（容量组）** | 必须（按当前容量组）；每组3×10µF＋3.3µF，不能逐只当作冗余。少装或改单只替代须验证高压偏置有效容量、纹波和环路。 |
| C104 | 10µF/50V | VSPH到地的10µF并联储能电容，组内第3只10µF；缓冲源极驱动电流并维持节点电压。 | **必须（容量组）** | 必须（按当前容量组）；每组3×10µF＋3.3µF，不能逐只当作冗余。少装或改单只替代须验证高压偏置有效容量、纹波和环路。 |
| C105 | 3.3µF/50V | VSPH到地的3.3µF并联储能电容，补足该组名义33.3µF；缓冲源极驱动电流并维持节点电压。 | **必须（容量组）** | 必须（按当前容量组）；每组3×10µF＋3.3µF，不能逐只当作冗余。少装或改单只替代须验证高压偏置有效容量、纹波和环路。 |
| C2 | 10µF/50V | VSPL到地的10µF并联储能电容，组内第1只10µF；缓冲源极驱动电流并维持节点电压。 | **必须（容量组）** | 必须（按当前容量组）；每组3×10µF＋3.3µF，不能逐只当作冗余。少装或改单只替代须验证高压偏置有效容量、纹波和环路。 |
| C106 | 10µF/50V | VSPL到地的10µF并联储能电容，组内第2只10µF；缓冲源极驱动电流并维持节点电压。 | **必须（容量组）** | 必须（按当前容量组）；每组3×10µF＋3.3µF，不能逐只当作冗余。少装或改单只替代须验证高压偏置有效容量、纹波和环路。 |
| C107 | 10µF/50V | VSPL到地的10µF并联储能电容，组内第3只10µF；缓冲源极驱动电流并维持节点电压。 | **必须（容量组）** | 必须（按当前容量组）；每组3×10µF＋3.3µF，不能逐只当作冗余。少装或改单只替代须验证高压偏置有效容量、纹波和环路。 |
| C108 | 3.3µF/50V | VSPL到地的3.3µF并联储能电容，补足该组名义33.3µF；缓冲源极驱动电流并维持节点电压。 | **必须（容量组）** | 必须（按当前容量组）；每组3×10µF＋3.3µF，不能逐只当作冗余。少装或改单只替代须验证高压偏置有效容量、纹波和环路。 |
| C3 | 10µF/50V | VSPL2到地的10µF并联储能电容，组内第1只10µF；缓冲源极驱动电流并维持节点电压。 | **必须（容量组）** | 必须（按当前容量组）；每组3×10µF＋3.3µF，不能逐只当作冗余。少装或改单只替代须验证高压偏置有效容量、纹波和环路。 |
| C109 | 10µF/50V | VSPL2到地的10µF并联储能电容，组内第2只10µF；缓冲源极驱动电流并维持节点电压。 | **必须（容量组）** | 必须（按当前容量组）；每组3×10µF＋3.3µF，不能逐只当作冗余。少装或改单只替代须验证高压偏置有效容量、纹波和环路。 |
| C110 | 10µF/50V | VSPL2到地的10µF并联储能电容，组内第3只10µF；缓冲源极驱动电流并维持节点电压。 | **必须（容量组）** | 必须（按当前容量组）；每组3×10µF＋3.3µF，不能逐只当作冗余。少装或改单只替代须验证高压偏置有效容量、纹波和环路。 |
| C111 | 3.3µF/50V | VSPL2到地的3.3µF并联储能电容，补足该组名义33.3µF；缓冲源极驱动电流并维持节点电压。 | **必须（容量组）** | 必须（按当前容量组）；每组3×10µF＋3.3µF，不能逐只当作冗余。少装或改单只替代须验证高压偏置有效容量、纹波和环路。 |
| C4 | 10µF/50V | VSNH到地的10µF并联储能电容，组内第1只10µF；缓冲源极驱动电流并维持节点电压。 | **必须（容量组）** | 必须（按当前容量组）；每组3×10µF＋3.3µF，不能逐只当作冗余。少装或改单只替代须验证高压偏置有效容量、纹波和环路。 |
| C112 | 10µF/50V | VSNH到地的10µF并联储能电容，组内第2只10µF；缓冲源极驱动电流并维持节点电压。 | **必须（容量组）** | 必须（按当前容量组）；每组3×10µF＋3.3µF，不能逐只当作冗余。少装或改单只替代须验证高压偏置有效容量、纹波和环路。 |
| C113 | 10µF/50V | VSNH到地的10µF并联储能电容，组内第3只10µF；缓冲源极驱动电流并维持节点电压。 | **必须（容量组）** | 必须（按当前容量组）；每组3×10µF＋3.3µF，不能逐只当作冗余。少装或改单只替代须验证高压偏置有效容量、纹波和环路。 |
| C114 | 3.3µF/50V | VSNH到地的3.3µF并联储能电容，补足该组名义33.3µF；缓冲源极驱动电流并维持节点电压。 | **必须（容量组）** | 必须（按当前容量组）；每组3×10µF＋3.3µF，不能逐只当作冗余。少装或改单只替代须验证高压偏置有效容量、纹波和环路。 |
| C5 | 10µF/50V | VSNL到地的10µF并联储能电容，组内第1只10µF；缓冲源极驱动电流并维持节点电压。 | **必须（容量组）** | 必须（按当前容量组）；每组3×10µF＋3.3µF，不能逐只当作冗余。少装或改单只替代须验证高压偏置有效容量、纹波和环路。 |
| C115 | 10µF/50V | VSNL到地的10µF并联储能电容，组内第2只10µF；缓冲源极驱动电流并维持节点电压。 | **必须（容量组）** | 必须（按当前容量组）；每组3×10µF＋3.3µF，不能逐只当作冗余。少装或改单只替代须验证高压偏置有效容量、纹波和环路。 |
| C116 | 10µF/50V | VSNL到地的10µF并联储能电容，组内第3只10µF；缓冲源极驱动电流并维持节点电压。 | **必须（容量组）** | 必须（按当前容量组）；每组3×10µF＋3.3µF，不能逐只当作冗余。少装或改单只替代须验证高压偏置有效容量、纹波和环路。 |
| C117 | 3.3µF/50V | VSNL到地的3.3µF并联储能电容，补足该组名义33.3µF；缓冲源极驱动电流并维持节点电压。 | **必须（容量组）** | 必须（按当前容量组）；每组3×10µF＋3.3µF，不能逐只当作冗余。少装或改单只替代须验证高压偏置有效容量、纹波和环路。 |
| C6 | 10µF/50V | VSNL2到地的10µF并联储能电容，组内第1只10µF；缓冲源极驱动电流并维持节点电压。 | **必须（容量组）** | 必须（按当前容量组）；每组3×10µF＋3.3µF，不能逐只当作冗余。少装或改单只替代须验证高压偏置有效容量、纹波和环路。 |
| C118 | 10µF/50V | VSNL2到地的10µF并联储能电容，组内第2只10µF；缓冲源极驱动电流并维持节点电压。 | **必须（容量组）** | 必须（按当前容量组）；每组3×10µF＋3.3µF，不能逐只当作冗余。少装或改单只替代须验证高压偏置有效容量、纹波和环路。 |
| C119 | 10µF/50V | VSNL2到地的10µF并联储能电容，组内第3只10µF；缓冲源极驱动电流并维持节点电压。 | **必须（容量组）** | 必须（按当前容量组）；每组3×10µF＋3.3µF，不能逐只当作冗余。少装或改单只替代须验证高压偏置有效容量、纹波和环路。 |
| C120 | 3.3µF/50V | VSNL2到地的3.3µF并联储能电容，补足该组名义33.3µF；缓冲源极驱动电流并维持节点电压。 | **必须（容量组）** | 必须（按当前容量组）；每组3×10µF＋3.3µF，不能逐只当作冗余。少装或改单只替代须验证高压偏置有效容量、纹波和环路。 |

## 5. Interface：主控及测试子图（11件＋24铜焊盘）

本版删除U6/U7、Q9/Q10及其外围，信号直连；33Ω和100k电阻不提供电平转换或掉电隔离。

### I1 主控连接器J2

1件。主控排针只计一次；16脚NC，不再连接HOST_3V3；BUSY_N、SI1为主控输入。

| 位号 | 当前值/器件类型 | 作用 | 必须或可选 | 保留理由或省略条件 |
|---|---|---|---|---|
| J2 | HOST DIRECT 3V3 | 2×8主控排针，承载SPI、BUSY、使能及共地；16脚NC。 | **条件可选** | 可改成可靠直焊线/其他连接器，但信号和共地连接必须保留；不装不是通信仍自动可用。 |

### I2 时钟SCLK输出通道

2件：33Ω串联＋100k默认下拉。

| 位号 | 当前值/器件类型 | 作用 | 必须或可选 | 保留理由或省略条件 |
|---|---|---|---|---|
| R39 | 33Ω | 33Ω串在HOST_SCLK到SCLK之间，减缓边沿振铃及脉冲尖峰。 | **条件可选** | 只有桥接/重画铜线并验证短排线SPI边沿和可靠性后才可取消串联电阻；空焊盘会直接断信号。 |
| R44 | 100kΩ | 100k将SCLK下拉到GND，使时钟默认低。 | **必须** | 保留复位/启动时的确定默认电平；这些拉电阻不能隔离或阻止错误GPIO高电平反灌。 |

### I3 写数据MOSI/SI0输出通道

2件：33Ω串联＋100k默认下拉。

| 位号 | 当前值/器件类型 | 作用 | 必须或可选 | 保留理由或省略条件 |
|---|---|---|---|---|
| R40 | 33Ω | 33Ω串在HOST_MOSI到SI0之间，减缓边沿振铃及脉冲尖峰。 | **条件可选** | 只有桥接/重画铜线并验证短排线SPI边沿和可靠性后才可取消串联电阻；空焊盘会直接断信号。 |
| R45 | 100kΩ | 100k将SI0下拉到GND，使写数据默认低。 | **必须** | 保留复位/启动时的确定默认电平；这些拉电阻不能隔离或阻止错误GPIO高电平反灌。 |

### I4 Master片选输出通道

2件：33Ω串联＋100k屏幕供电域上拉。

| 位号 | 当前值/器件类型 | 作用 | 必须或可选 | 保留理由或省略条件 |
|---|---|---|---|---|
| R41 | 33Ω | 33Ω串在HOST_CS_M_N到CS_M_N之间，减缓边沿振铃及脉冲尖峰。 | **条件可选** | 只有桥接/重画铜线并验证短排线SPI边沿和可靠性后才可取消串联电阻；空焊盘会直接断信号。 |
| R46 | 100kΩ | 100k将CS_M_N上拉到EPD_3V3，使屏幕有电且主控高阻时片选默认不选中。 | **必须** | 保留复位/启动时的确定默认电平；这些拉电阻不能隔离或阻止错误GPIO高电平反灌。 |

### I5 Slave片选输出通道

2件：33Ω串联＋100k屏幕供电域上拉。

| 位号 | 当前值/器件类型 | 作用 | 必须或可选 | 保留理由或省略条件 |
|---|---|---|---|---|
| R42 | 33Ω | 33Ω串在HOST_CS_S_N到CS_S_N之间，减缓边沿振铃及脉冲尖峰。 | **条件可选** | 只有桥接/重画铜线并验证短排线SPI边沿和可靠性后才可取消串联电阻；空焊盘会直接断信号。 |
| R47 | 100kΩ | 100k将CS_S_N上拉到EPD_3V3，使同理设置Slave片选默认不选中。 | **必须** | 保留复位/启动时的确定默认电平；这些拉电阻不能隔离或阻止错误GPIO高电平反灌。 |

### I6 RESET输出通道

2件：33Ω串联＋100k默认下拉。

| 位号 | 当前值/器件类型 | 作用 | 必须或可选 | 保留理由或省略条件 |
|---|---|---|---|---|
| R43 | 33Ω | 33Ω串在HOST_RES_N到RES_N之间，减缓边沿振铃及脉冲尖峰。 | **条件可选** | 只有桥接/重画铜线并验证短排线SPI边沿和可靠性后才可取消串联电阻；空焊盘会直接断信号。 |
| R48 | 100kΩ | 100k将RES_N下拉到GND，使主控高阻时保持复位。 | **必须** | 保留复位/启动时的确定默认电平；这些拉电阻不能隔离或阻止错误GPIO高电平反灌。 |

### I7 电源、状态和地参考铜测试点

24个铜测试点，实际装配数量为0；TP10虽然Value保留旧名字VNCP_3P5V，实际网络和TP9相同，均为VBB_3P5V；这只是两个探针位置，不是两路独立电源。

| 位号 | 当前值/器件类型 | 作用 | 必须或可选 | 保留理由或省略条件 |
|---|---|---|---|---|
| TP1 | BENCH_3V3 | BENCH_3V3网络的探针接触铜焊盘，用于测量该节点电压/状态。 | **可选（铜测试点）** | 已有铜焊盘，无需购买/焊接器件；改板时可删该测试位置，代价是测量和排查更难。 |
| TP2 | EPD_3V3 | EPD_3V3输出分配区域的探针接触铜焊盘，用于测量该节点电压/状态。 | **可选（铜测试点）** | 已有铜焊盘，无需购买/焊接器件；改板时可删该测试位置，代价是测量和排查更难。 |
| TP3 | EPD_3V3 | EPD_3V3功率分支的探针接触铜焊盘，用于测量该节点电压/状态。 | **可选（铜测试点）** | 已有铜焊盘，无需购买/焊接器件；改板时可删该测试位置，代价是测量和排查更难。 |
| TP4 | EPD_3V3 | EPD_3V3网络的探针接触铜焊盘，用于测量该节点电压/状态。 | **可选（铜测试点）** | 已有铜焊盘，无需购买/焊接器件；改板时可删该测试位置，代价是测量和排查更难。 |
| TP5 | VDDP | VDDP网络的探针接触铜焊盘，用于测量该节点电压/状态。 | **可选（铜测试点）** | 已有铜焊盘，无需购买/焊接器件；改板时可删该测试位置，代价是测量和排查更难。 |
| TP6 | VDDN | VDDN网络的探针接触铜焊盘，用于测量该节点电压/状态。 | **可选（铜测试点）** | 已有铜焊盘，无需购买/焊接器件；改板时可删该测试位置，代价是测量和排查更难。 |
| TP7 | VGH | VGH网络的探针接触铜焊盘，用于测量该节点电压/状态。 | **可选（铜测试点）** | 已有铜焊盘，无需购买/焊接器件；改板时可删该测试位置，代价是测量和排查更难。 |
| TP8 | VGL | VGL网络的探针接触铜焊盘，用于测量该节点电压/状态。 | **可选（铜测试点）** | 已有铜焊盘，无需购买/焊接器件；改板时可删该测试位置，代价是测量和排查更难。 |
| TP9 | VBB_3P5V | VBB_3P5V网络的探针接触铜焊盘，用于测量该节点电压/状态。 | **可选（铜测试点）** | 已有铜焊盘，无需购买/焊接器件；改板时可删该测试位置，代价是测量和排查更难。 |
| TP10 | VNCP_3P5V | VBB_3P5V网络的探针接触铜焊盘，用于测量该节点电压/状态。 | **可选（铜测试点）** | 已有铜焊盘，无需购买/焊接器件；改板时可删该测试位置，代价是测量和排查更难。 |
| TP11 | TFT_VCOM | TFT_VCOM网络的探针接触铜焊盘，用于测量该节点电压/状态。 | **可选（铜测试点）** | 已有铜焊盘，无需购买/焊接器件；改板时可删该测试位置，代价是测量和排查更难。 |
| TP12 | VCC | VCC网络的探针接触铜焊盘，用于测量该节点电压/状态。 | **可选（铜测试点）** | 已有铜焊盘，无需购买/焊接器件；改板时可删该测试位置，代价是测量和排查更难。 |
| TP13 | BUSY_N | BUSY_N网络的探针接触铜焊盘，用于测量该节点电压/状态。 | **可选（铜测试点）** | 已有铜焊盘，无需购买/焊接器件；改板时可删该测试位置，代价是测量和排查更难。 |
| TP14 | EPD_PWR_EN | EPD_PWR_EN网络的探针接触铜焊盘，用于测量该节点电压/状态。 | **可选（铜测试点）** | 已有铜焊盘，无需购买/焊接器件；改板时可删该测试位置，代价是测量和排查更难。 |
| TP15 | RES_N | RES_N网络的探针接触铜焊盘，用于测量该节点电压/状态。 | **可选（铜测试点）** | 已有铜焊盘，无需购买/焊接器件；改板时可删该测试位置，代价是测量和排查更难。 |
| TP16 | GND | GND网络的探针接触铜焊盘，作为测量地参考。 | **可选（铜测试点）** | 已有铜焊盘，无需购买/焊接器件；改板时可删该测试位置，代价是测量和排查更难。 |
| TP17 | GND | GND网络的探针接触铜焊盘，作为测量地参考。 | **可选（铜测试点）** | 已有铜焊盘，无需购买/焊接器件；改板时可删该测试位置，代价是测量和排查更难。 |
| TP18 | GND | GND网络的探针接触铜焊盘，作为测量地参考。 | **可选（铜测试点）** | 已有铜焊盘，无需购买/焊接器件；改板时可删该测试位置，代价是测量和排查更难。 |
| TP19 | GND | GND网络的探针接触铜焊盘，作为测量地参考。 | **可选（铜测试点）** | 已有铜焊盘，无需购买/焊接器件；改板时可删该测试位置，代价是测量和排查更难。 |
| TP20 | GND | GND网络的探针接触铜焊盘，作为测量地参考。 | **可选（铜测试点）** | 已有铜焊盘，无需购买/焊接器件；改板时可删该测试位置，代价是测量和排查更难。 |
| TP21 | GND | GND网络的探针接触铜焊盘，作为测量地参考。 | **可选（铜测试点）** | 已有铜焊盘，无需购买/焊接器件；改板时可删该测试位置，代价是测量和排查更难。 |
| TP22 | GND | GND网络的探针接触铜焊盘，作为测量地参考。 | **可选（铜测试点）** | 已有铜焊盘，无需购买/焊接器件；改板时可删该测试位置，代价是测量和排查更难。 |
| TP23 | GND | GND网络的探针接触铜焊盘，作为测量地参考。 | **可选（铜测试点）** | 已有铜焊盘，无需购买/焊接器件；改板时可删该测试位置，代价是测量和排查更难。 |
| TP24 | GND | GND网络的探针接触铜焊盘，作为测量地参考。 | **可选（铜测试点）** | 已有铜焊盘，无需购买/焊接器件；改板时可删该测试位置，代价是测量和排查更难。 |

## 6. 哪些是可选，实际能省什么

| 条件可选类别 | 位号 | 数量 | 必须做的替代/验证 |
|---|---|---:|---|
| 连接器本体 | J1、J2 | 2 | 改可靠接线方式，供电、共地和信号连接保留；FPC1仍按可插拔底座装配 |
| 信号串联阻尼 | R39–R43 | 5 | 桥接/重新布铜保证信号连续，验证短排线边沿、过冲、可靠性 |
| 外部温度检测功能 | U4、R20、R21、C27 | 4 | 确认面板支持替代温度方案，调整并验证控制器/固件；不能只删传感器、让程序继续等待外部温度 |
| MOS调试断点 | R49 | 1 | 若取消，须可靠桥接GDRC与Q7_GATE；正常装0Ω，拆除仅用于断电后的隔离调试 |
| 测试位置 | TP1–TP26 | 26个铜焊盘 | 不采购不焊接；本来就没有装配成本，删除不会少买24个器件 |

12个条件可选不能简单相加成为“可直接少焊12件”的建议。温度方案尚未验证；五只串联电阻取消后仍需重新改线和验证。当前BOM为104件；L4/L5已经从CAD/BOM删除，全部去耦保留，新增共用供电噪声验收项。

电源开关、启动电容、默认下拉、电感/MOS/整流、采样、反馈、飞跨电容及高压储能，均按当前功能判为必须。对C29/C30、C31/C32和六组并联电容，将来可以重新选择数量或封装，但必须满足有效容量和布局要求；那是重新设计，不是现成的可选焊接配置。标称33.3µF并不证明高压偏置下仍有33.3µF，当前项目尚未完成这一验收。

## 7. 当前图面与统计中容易混淆的地方

- Panel页仍有“R23 DNP: alert output is not strapped to ground”旧文字，但当前符号/网表没有R23，也没有R22；**不计入数量，也不采购**。该文字仅记录未使用的ALERT接法，与本次P1改版无关。
- 旧电源教程VGH子图标题写12件，实际为11件；本文以实际符号核数。电源总数为10＋7＋7＋8＋11＋12＝55，另有P4两个铜测试点。
- U1/U2/U3是三个0.2Ω采样电阻，不是三个IC；L4/L5已删除；L1/L2/L3仍是必需的功率储能电感。
- 26个TP是DNP铜焊盘；GND与PWR_FLAG符号、功能框、标签不算装配器件。4个PCB安装孔也不进入原理图BOM。
- C8/C9虽位于Panel功能区2框内，实际属于电极输出旁路；R20/R21位于温度框外，但电气上属于温度检测。元件归属按本节说明，避免同一元件在两个功能区重复计数。
- 必须保留的电路功能不等于器件型号、参数和硬件行为已验收。当前GUI打开已通过；实物FPC配接、功率峰值/温升、容量与全轨掉电仍有待验收项。

## 8. 查图、查详细原理与复核依据

当前工程：[KiCad项目](../../hardware/pcb/gdep133c02-driver/gdep133c02-driver.kicad_pro)、[整套原理图PDF](../../hardware/pcb/gdep133c02-driver/reports/schematic.pdf)。逐项原理：[Power详解](../../hardware/pcb/gdep133c02-driver/docs/power-circuit-explained.md)、[Panel详解](../../hardware/pcb/gdep133c02-driver/docs/panel-circuit-explained.md)、[Interface详解](../../hardware/pcb/gdep133c02-driver/docs/interface-circuit-explained.md)。

上电和关机约束见[接口供电约定](../../hardware/pcb/gdep133c02-driver/docs/interface-power-state.md)：3.3V逻辑、主控先上电最后断电、关屏前全部GPIO输出低/输入无上拉、禁止热插拔。需要更少器件时先明确保留哪些功能，再改原理图、PCB及固件，重新检查和实测。

本次复核：当前v0.8保持104个装配件、37组采购行，130个实体位号。原生ERC、DRC、未连接与原理图/PCB一致性检查均为0；KiCad工程模式更新预览无新增器件。来源与制造产物哈希见最新release的verification.json。实板性能仍需焊后验证。

统计所用原理图SHA256（用于日后判断本文是否对应当前图）：

| 原理图 | SHA256 |
|---|---|
| gdep133c02-driver.kicad_sch | `5fb141347861a05383ce12cd1c3f999ef93cf21704997589a919dcbec45026e1` |
| power.kicad_sch | `22a53dde8e58be364575dd9e47d62158d7dbaf09eb2f80d0cf11d9ce4ed27d6d` |
| panel.kicad_sch | `2057dee4422aa8bfc64c3f682547d8eddaecaf06d9fc9fd8a3792d1c41d226a2` |
| interface.kicad_sch | `3d2e5271d4cb08c107c6f6b832704c17050b8ceedcbfb118d3b716ec08812090` |
