Rhys-Q/album/docs/design/仓库目录与维护约定.md

# 仓库目录与维护约定

2026-10-08整理。正式工程和原厂资料保留，只保留最新制造审阅包。

| 目录 | 用途 |
|---|---|
| `docs/design/` | 总体/PCB设计、新手教程、器件统计及维护说明 |
| `docs/raw/` | 原始屏幕资料、厂家示例和嘉立创下单说明 |
| `hardware/reference/` | 屏幕外围电路和器件原厂参考资料 |
| `hardware/pcb/gdep133c02-driver/` | 当前KiCad原生工程、设计记录、本地库及所需模型 |
| 工程 `docs/` | 三页电路详解、供电/调试/配接和使用约定 |
| 工程 `reports/` | 当前ERC/DRC、网表、检查来源、GUI预览、图面及清理清单 |
| 工程 `releases/jlc-cn-review-v0.5-linkfix-2026-10-08/` | 唯一保留的当前制造审阅包 |
| 工程 `scripts/` | 当前检查、导出和原生文件解析工具 |

本次清理了旧release、历史CAD备份、失败/中间DRC和布线输入输出、旧专项审核文档、一次性迁移脚本、未使用的封装/符号/模型、完成的任务草稿及自动历史/缓存。原始PDF、厂家示例和用于选型的资料没有按日期删除；它们是设计依据。

当前CAD电路和制造几何没有变化；仍为103装配件、101顶面SMT、26铜测试点。源文件与当前库的SHA256已同步到检查来源及最新release清单。旧工程版本由主仓库Git历史查阅，不在当前目录堆放副本；Git主仓库和提交历史未删除。

删除前已备份待删除内容及相关文档，包含 `.history` 的未提交文件和内部Git数据，备份位于仓库外：`/tmp/album-cleanup-20261008-222921.tar.gz`。这是临时恢复备份，不是新的工程release；系统临时目录不适合长期归档，需要长期留存时另行保存。具体清理路径见工程 `reports/cleanup-manifest.json`。

后续修改先同步原理图/PCB/设计记录，检查ERC、DRC及符号关联，再导出新版本。确认新包完整后移除旧release，并更新README和下单说明。导出脚本拒绝覆盖现有目录，不能靠删除当前唯一release绕过保护。自动历史、锁文件、缓存和本机界面设置由ignore规则排除；不要在仓库复制完整旧工程。
