Rhys-Q/album/hardware/pcb/gdep133c02-driver/docs/剩余24组基础库重新审核-2026-10-11.md

> 本文是改版前的审核快照。2026-10-11用户随后指定采用其中3＋14组，当前CAD/BOM及未验证项见[基础库17组改版-v0.11.md](基础库17组改版-v0.11.md)。

# 剩余24组基础库重新审核（2026-10-11）

> 基线：当前 v0.10-e01 原生 KiCad 工程；E01 已实施，不在这24组中。本报告为选型审核，不是新release、生产批准或实板验收。正式工程及现有release没有修改。

## 1. 这次得到什么结论

24个是**型号组**，不是24只元器件。重新审核后，不能再说“这24组在基础库中都没有替代”。

- **3组具备下一轮实施条件**：E21普通低压去耦同0805替换；E20、E22用两只基础库电阻串联，参数审核通过，需增加位号和布局。
- **14组找到基础库候选或组合路径，但还未满足正式替换标准**：存在偏压容量、驱动/损耗、库存证据或调整收益问题。具体缺口逐组列出。
- **7组本轮未取得合格免费方案**：E02、E06、E07、E16、E23、E24、E25。它表示已查候选没有形成合格免费结论，**不是证明全库绝无替代**。扩展标签也不排除需另外核实的合作免换料费身份。

原生工程仍为37组、104件；本次没有新增符号、改封装、重新布线或发布。129个既有release源文件哈希均与当前文件一致。

完整商业记录：[候选与库存、MOQ、阶梯、1/5板费用CSV](剩余24组基础库候选-2026-10-11.csv)。设计取舍：[待决定CSV](剩余24组基础库待决定-2026-10-11.csv)。

## 2. 上次为什么漏查，如何避免重犯

上次检索脚本对原件是1210等封装时只保留原封装，而用户的约定是优先0805、允许改变封装。这是脚本自行加入的限制，并不是用户要求。此外，上次主要依赖商城给出的有限替代推荐，推荐列表没有某个C号，不能当作基础库没有该料的证据。

这次先按电路参数找型号，再核对准确C号的国内产品页面和原厂资料；原封装不作筛除条件。网上/海外目录只提供线索，国内基础库结论以本次国内页面为准。正常公开检索未能访问的页面记录为未知，不绕过滑动验证。

同时修正分类：找到型号、取得免费标签、取得SMT库存、完成电气核验、CAD实施通过，是不同阶段。本文用这些阶段解释保留原因。

## 3. 三组优先实施建议

|组|当前|建议|封装/数量变化|审核结论|
|---|---|---|---|---|
|E21 C27/C33|C1711 三星100nF/50V/X7R/0805|**C28233 / CL21B104KCFNNNE**，100nF/100V/X7R/0805|数量和XY封装不变；名义厚度0.85→1.25mm|3.3V去耦参数通过；CAD中需检查高度和丝印/装配属性|
|E20 R18|C2774511 16kΩ/0805/333mW|**C17475 / 0805W8F1502T5E** 15kΩ＋**C17513 / 0805W8F1001T5E** 1kΩ串联|两只0805，新增1只|阻值、误差、温漂与正常反馈功耗通过；需同意增加器件后实施|
|E22 R8|C5140228 110kΩ/0805|**C149504 / 0805W8F1003T5E** 100kΩ＋**C17414 / 0805W8F1002T5E** 10kΩ串联|两只0805，新增1只；100k料工程已有|反馈比例和功率审核通过；需同意增加器件后实施|

三组选定C号本次均为国内**SMT基础库**且有SMT库存。普通电阻两只各±1%，串联总阻值最坏误差仍±1%；有效TCR是阻值加权平均，保持±100ppm/℃界限，不能误写成±2%。与另一反馈臂组合后的比值误差仍要按两臂计算，并没有因此降为0。

### R18功率为什么可以用125mW的基础库电阻

正常高阻反馈输入下，R17＋R50=400kΩ，与R18=16kΩ串成VGL—FBN—REG_VGN反馈链。R18不是直接跨整路负输出。保守假设VGL与REG_VGN两端差100V（只是审核包络，不是允许工作电压），则：

```text
I ≈ 100V / (400kΩ + 16kΩ) = 0.2404mA
P15k ≈ I² × 15kΩ = 0.867mW
P1k  ≈ I² × 1kΩ  = 0.0578mW
```

±1%容差不会改变两个数量级的余量。厚声普通0805额定125mW@70℃，70℃以上按原厂曲线降额；在85℃仍约103mW。上述核算是正常反馈链，不能代替对异常电源波形、控制器反馈输入行为的实板验证。反馈取样走线要短，串联中点不接其他负载。

### R8串联方案

100kΩ＋10kΩ保持110kΩ，与原4.3kΩ下臂保持反馈比例。仅对上臂两端取50V审核包络，电流约0.4545mA，100k和10k分别约20.66mW、2.07mW，低于85℃降额能力；两只额定工作电压150V。50V是计算包络，实际电源仍应留耐压裕量并测尖峰。

## 4. 全24组结论

|组|当前位号 / 型号|本轮结论|主要候选|
|---|---|---|---|
|E02|U4<br>TCN75AVOA713 / C144313|本轮未取得合格免费方案|C7963, C30389, C636980, C28085|
|E03|C105,C108,C111,C114,C117,C120<br>GRM32DR71H335KA88L / C397310|需设计调整|C1021610, C28323, C28233|
|E04|C31,C32<br>GRM32ER60J107ME20L / C88154|已找到基础库，待证据|C15008, C96123, C16133, C49066|
|E05|C28,C29,C30,C12,C14,C19,C16,C21,C8<br>GRM32ER71H475KA88L / C86052|已找到基础库，按节点分审|C29823, C338088|
|E06|U1,U2,U3<br>WSL1206R2000FEA / C2073442|本轮未取得合格免费方案|C42460613|
|E07|U5<br>TPS22917DBVR / C2681320|本轮未取得合格免费方案|C5359093, C15127, C20917|
|E08|Q7<br>PJA3433_R1_00001 / C6628419|已找到基础库，驱动证据不足|C15127, C10487, C545575, C5337195, C5224069|
|E09|Q1,Q4<br>DMN3065LW-7 / C150506|已找到基础库，驱动证据不足|C20917, C3290106, C5245314|
|E10|Q8<br>DMP3068L-7 / C151010|已找到基础库，驱动证据不足|C15127, C10487|
|E11|D1,D2<br>MBR230S1F-7 / C151335|已找到基础库，损耗证据不足|C8678, C22452, C2480, C509950|
|E12|C26<br>0805B473K500NT / C1745|已找到基础库，容量证据不足|C1622|
|E13|C17,C23,C24,C9,C10,C11<br>GRM21BR71H474KA88L / C86043|已找到基础库，容量证据不足|C13967, C1623|
|E14|C36<br>0805CG102J500NT / C29925|需设计调整|C1636, C1588, C14858|
|E15|Q6<br>MMBT3904-7-F / C94514|已找到基础库，热/动态证据不足|C20526, C8512, C2145|
|E16|Q3<br>MMBT3906-7-F / C82762|本轮未取得合格免费方案|C2143, C8543|
|E17|D4<br>B0530W-7-F / C124188|已找到基础库，损耗证据不足|C8598, C2480|
|E18|C18<br>GRM21BR71H224KA01L / C86042|需设计调整|C21120, C28233, C1729|
|E19|C22,C25<br>GRM21BR71H105KA12L / C77083|已找到基础库，容量证据不足|C28323, C15849|
|E20|R18<br>HP05W3F1602T5E / C2774511|需设计调整；串联参数通过|C17490, C4210, C17475, C17513|
|E21|C33,C27<br>CL21B104KBCNNNC / C1711|电气参数通过，待CAD实施|C28233|
|E22|R8<br>SCR0805F110K / C5140228|需设计调整；串联参数通过|C17422, C25805, C149504, C17414|
|E23|D3,D5,D6<br>BAT54SLT1G / C19726|本轮未取得合格免费方案|C47546, C8591, C2500|
|E24|L1,L2,L3<br>PCR1040-150-M / C53896892|本轮未取得合格免费方案|C3040358, C167715, C9169|
|E25|FPC1<br>FPC-05FB-60PH20 / C2856839|本轮未取得合格免费方案|未取得配接一致的免费型号|

## 5. 每组实际要求、发现和保留原因

### E02：U4

U4：3.3V/I2C，地址脚接地；需要温度寄存器、分辨率、关断/唤醒及固件兼容。

LM75AD、TMP75、另一包装TCN75A均是国内扩展库标签，未取得国内明确免换料费证据；不能把I2C/SOIC8直接视为兼容。

**建议：** 保留TCN75A；SOIC8适合自焊，机器贴与自焊作为装配选择。

当前节点：U4:TSDA,TSCL,NC,GND,GND,GND,GND,EPD_3V3。

查询依据：[C7963国内商品页](https://item.szlcsc.com/8440.html)；[所附原厂资料](https://datasheet.lcsc.com/datasheet/pdf/839148d3214d46819d64b2ce62c66f50.pdf?productCode=C7963)。其余候选及每条查询时间见CSV。

### E03：C105,C108,C111,C114,C117,C120

六个源极储能支路各3×10µF＋3.3µF，标称33.3µF；六支路、50V及总容量不减少。

同值3.3µF/50V C1021610为扩展库。基础库可由每支路3×C28323(1µF)＋3×C28233(0.1µF)合成3.3µF，但总计新增30个电容，偏压有效容量/ESR仍需核算。

**建议：** 不建议为一组20元费用增加30件；保留单只3.3µF，自焊优先；组合未获准。

当前节点：C105:VSPH,GND；C108:VSPL,GND；C111:VSPL2,GND；C114:VSNH,GND；C117:VSNL,GND；C120:VSNL2,GND。

查询依据：[C1021610国内商品页](https://item.szlcsc.com/1111779.html)；[所附原厂资料](https://datasheet.lcsc.com/datasheet/pdf/c452b6d91307da20cc5991a8b4b3e46f.pdf?productCode=C1021610)。其余候选及每条查询时间见CSV。

### E04：C31,C32

C31/C32：3.3V输入侧储能，100µF/6.3V；需要3.3V有效容量、输入开关浪涌与ESR。

C15008是100µF/6.3V X5R 1206国内基础库、商城有货，但SMT库存未返回，不能当作0或有货；偏压曲线未取得。C96123为47µF/6.3V基础库，商城0、SMT有货，2×47µF＋4.7µF需调整且不可直接用标称证明。C16133钽电容ESR标称1.7Ω@100kHz，有极性和浪涌约束，不是陶瓷直替。

**建议：** 优先补C15008的国内SMT可用性及3.3V容量数据，保留原件直到核验通过。

当前节点：C31:EPD_3V3,GND；C32:EPD_3V3,GND。

查询依据：[C15008国内商品页](https://item.szlcsc.com/15681.html)；[所附原厂资料](https://datasheet.lcsc.com/datasheet/pdf/02336ea48ea44ca18c72517dd3cb7b47.pdf?productCode=C15008)。其余候选及每条查询时间见CSV。

### E05：C28,C29,C30,C12,C14,C19,C16,C21,C8

C28/C29/C30/C12/C14/C19是3.3V去耦；C16为VGH、C21为VGL、C8为TFT_VCOM输出储能。保持4.7µF/50V。

C29823：4.7µF/50V/X7R/±10%/1206，国内基础库、SMT有货。需要1210→1206焊盘；低压六只优先审核，高压三只需实际偏压容量和ESR证据，不能整组套用低压结论。C338088虽在海外线索中出现，国内标签为扩展库，不计免费。

**建议：** 先补C29823容量数据；若高压部分不能通过，允许分组采用，原型号仍占一个收费型号，不能声称整组省20元。

当前节点：C28:BENCH_3V3,GND；C29:EPD_3V3,GND；C30:EPD_3V3,GND；C12:EPD_3V3,GND；C14:EPD_3V3,GND；C19:EPD_3V3,GND；C16:VGH,GND；C21:VGL,GND；C8:TFT_VCOM,GND。

查询依据：[C29823国内商品页](https://item.szlcsc.com/30577.html)；[所附原厂资料](https://datasheet.lcsc.com/datasheet/pdf/09fe2daf22580a99fa7fea93ccb20fb7.pdf?productCode=C29823)。其余候选及每条查询时间见CSV。

### E06：U1,U2,U3

U1/U2/U3：0.2Ω、1%金属采样电阻；需要温漂、脉冲能量、寄生电感及Kelvin采样。

原WSL1206额定250mW、±75ppm/℃；候选MFCR1206为1W、±50ppm/℃但仍是扩展库，1W不自动证明短脉冲等效。没有拿普通厚膜低阻替换金属采样。

**建议：** 保留WSL，1206可自焊；现有候选未产生免换料费收益。

当前节点：U1:RESEP,GND；U2:EPD_3V3,RESEN；U3:EPD_3V3,RESEC。

查询依据：[C42460613国内商品页](https://item.szlcsc.com/44545414.html)；[所附原厂资料](https://datasheet.lcsc.com/datasheet/pdf/20a3f4fe86689d5b8dc6667972aa3137.pdf?productCode=C42460613)。其余候选及每条查询时间见CSV。

### E07：U5

U5：3.3V负载开关，CT软启动、QOD放电、反向阻断及低待机电流都要保留。

MX22917T23仍为扩展库且需要Ron/瞬态等对照。单只基础库MOS不同时提供CT、QOD及反灌阻断；简单删IC会改变上/掉电，不构成合格免费调整。

**建议：** 保留TPS22917；先比较一组机器换料费与SOT23-6自焊成本。

当前节点：U5:BENCH_3V3,GND,EPD_PWR_EN,SW_CT,EPD_3V3,EPD_3V3。

查询依据：[C5359093国内商品页](https://item.szlcsc.com/6170961.html)；[所附原厂资料](https://datasheet.lcsc.com/datasheet/pdf/4124348dd26a59864c44cab701c67afb.pdf?productCode=C5359093)。其余候选及每条查询时间见CSV。

### E08：Q7

Q7 P4：P沟道30V MOS；保留PJA3433与R49支路，核对真实GDRC栅源电压及驱动能力。

AO3401A C15127为30V基础库，但Qg典型7nC@4.5V，原PJA3433约1.6nC@4.5V；Ciss645pF对125pF。原件提供-1.8V的Ron保证，AO3401A最低Ron保证条件为-2.5V；不能用阈值代替导通保证。C10487为20V，耐压降低不通过。原Q7商城/SMT均0。

**建议：** 保持缺货未闭环；AO3401A仅候选，先取得驱动幅度/频率/电流或实测验证，不直接替换。

当前节点：Q7:Q7_GATE,RESEC,SW_VCOM。

查询依据：[C15127国内商品页](https://item.szlcsc.com/15801.html)；[所附原厂资料](https://datasheet.lcsc.com/datasheet/pdf/fee353dd1e9e0bc90b295f14f381aa4c.pdf?productCode=C15127)。其余候选及每条查询时间见CSV。

### E09：Q1,Q4

Q1 GDRP正升压；Q4 DRVP正泵开关，两处栅/源参考不同；N沟道30V。

AO3400A C20917国内基础库，SOT23需要替换SOT323焊盘，2.5V Ron≤48mΩ。Qg典型6nC@4.5V，对DMN3065约5.5nC@4.5V，条件并不完全相同；AO与原件栅源绝对限值均±12V，并未降低；Ciss典型630pF对原465pF，增约35%，需要分别核对Q1/Q4驱动负载与源极摆幅。-13包装候选SMT库存0且非免费。

**建议：** 分别审核Q1和Q4，不以一个型号组共用结论；电流/温升和驱动边界通过后才能采用。

当前节点：Q1:GDRP,RESEP,LX；Q4:DRVP,SOURCE_VGP,BASE_P。

查询依据：[C20917国内商品页](https://item.szlcsc.com/21629.html)；[所附原厂资料](https://datasheet.lcsc.com/datasheet/pdf/130876b936da464599428c58fd8de8f6.pdf?productCode=C20917)。其余候选及每条查询时间见CSV。

### E10：Q8

Q8 GDRN负升压：P沟道30V，SOT23，实际VGS、Qg、损耗和热能力。

AO3401A C15127有基础库库存，与原件同为栅源极±12V。Qg约7nC@4.5V对原7.3nC，不能说总栅电荷显著变大；但Qgd典型2.5nC对1.7nC，原DMP还提供-1.8V的Ron保证而AO只到-2.5V。需核对低栅压导通、Miller段驱动、体二极管恢复；20V C10487不满足保持30V耐压要求。

**建议：** 保留DMP3068L，获取GDRN真实驱动与尖峰后再批准AO3401A。

当前节点：Q8:GDRN,RESEN,SW_N。

查询依据：[C15127国内商品页](https://item.szlcsc.com/15801.html)；[所附原厂资料](https://datasheet.lcsc.com/datasheet/pdf/fee353dd1e9e0bc90b295f14f381aa4c.pdf?productCode=C15127)。其余候选及每条查询时间见CSV。

### E11：D1,D2

D1/D2：功率肖特基，至少30V/2A；两处导通/反偏波形不同，保持极性。

SS34 C8678(40V/3A)、SS54 C22452(40V/5A)为基础库，封装改SMA，需要Vf/I、结电容、反向漏电和热评估。SS14 C2480仅1A，不作2A直替。RBR2MM30A仍为扩展库。

**建议：** 优先评估SS34，不能凭更大额定电流宣告低损耗等效；为SMA预留功率回路重布线。

当前节点：D1:VDDP,LX；D2:SW_N,VDDN。

查询依据：[C8678国内商品页](https://item.szlcsc.com/9178.html)；[所附原厂资料](https://datasheet.lcsc.com/datasheet/pdf/dfa1ff67dea875d0135103ba9ada713a.pdf?productCode=C8678)。其余候选及每条查询时间见CSV。

### E12：C26

C26：PUMP_N_LOW对地47nF/50V/X7R/±10%，不能用3.3V输入去耦的判断。

C1622 CL10B473KB8NNNC为0603基础库，有国内SMT库存；标称参数匹配，但0805→0603偏压容量及泵纹波未对照。

**建议：** 保留50V；补节点电压与偏压容量后再缩封装。

当前节点：C26:PUMP_N_LOW,GND。

查询依据：[C1622国内商品页](https://item.szlcsc.com/1974.html)；[所附原厂资料](https://datasheet.lcsc.com/datasheet/pdf/02336ea48ea44ca18c72517dd3cb7b47.pdf?productCode=C1622)。其余候选及每条查询时间见CSV。

### E13：C17,C23,C24,C9,C10,C11

六只470nF/50V，包括飞跨电容；保持X7R/±10%和充放电能力。

C13967 CL21B474KBFNNNE为0805基础库、50V/X7R/±10%，无XY尺寸缩小；仍需高压偏压容量/ESR对照。C1623为25V，明确不通过。

**建议：** 优先补C13967工作电压下容量数据，合格后无需拓扑改动。

当前节点：C17:PUMP_P_MID,PUMP_P_AC；C23:PUMP_N_UP,PUMP_N_AC；C24:PUMP_N_DOWN,PUMP_N_AC；C9:FPL_VCOM,GND；C10:VCOMBD_M,GND；C11:VCOMBD_S,GND。

查询依据：[C13967国内商品页](https://item.szlcsc.com/14623.html)；[所附原厂资料](https://datasheet.lcsc.com/datasheet/pdf/02336ea48ea44ca18c72517dd3cb7b47.pdf?productCode=C13967)。其余候选及每条查询时间见CSV。

### E14：C36

C36：SW_CT与BENCH_3V3之间1nF/50V/C0G/±5%，定时稳定性必须保留。

C1636同参数0603为扩展库；C1588是X7R，不是C0G，网上表格错误，禁止直替。基础库C14858为100pF/50V/C0G/±5%，十只并联可得到1nF±5%，但多9件、多焊点和CT走线寄生。

**建议：** 建议保留单只C0G自焊，不为一组费用增加9只；十并联为待决定设计方案，未实施。

当前节点：C36:BENCH_3V3,SW_CT。

查询依据：[C1636国内商品页](https://item.szlcsc.com/1988.html)；[所附原厂资料](https://datasheet.lcsc.com/datasheet/pdf/09fe2daf22580a99fa7fea93ccb20fb7.pdf?productCode=C1636)。其余候选及每条查询时间见CSV。

### E15：Q6

Q6：DRVN驱动的NPN电荷泵开关，40V/200mA、B/E/C=1/2/3。

C20526 CJ MMBT3904为基础库，40V/200mA同脚序，hFE=100~300@10mA；额定200mW/625℃每W，原Diodes表列310/350mW(两种试验PCB)，需要脉冲电流与实际散热。CJ储存时间表给200ns，不能只按名字视为动态一致。C8512 2222A及C2145 5551为不同器件，不自动批准。

**建议：** 优先审核同族C20526；补Q6脉冲电流/频率及热预算，不把热额定差异当作已经失效。

当前节点：Q6:DRVN,GND,PUMP_N_LOW。

查询依据：[C20526国内商品页](https://item.szlcsc.com/21237.html)；[所附原厂资料](https://datasheet.lcsc.com/datasheet/pdf/9335632bcfa83df8351353eab379720e.pdf?productCode=C20526)。其余候选及每条查询时间见CSV。

### E16：Q3

Q3：正泵PNP，原40V/200mA SOT23；B/E/C=1/2/3。

同族CJ MMBT3906 C2143国内标签为扩展库，没有取得免换料费证据。基础库S9012 C8543仅25V且饱和/动态不同，不能降低原40V额定直接替换。

**建议：** 保留MMBT3906；继续核对合作免换料费身份或选择自焊。

当前节点：Q3:BASE_P,VDDP,PUMP_P_LOW。

查询依据：[C2143国内商品页](https://item.szlcsc.com/2500.html)；[所附原厂资料](https://datasheet.lcsc.com/datasheet/pdf/550597da53734df4a72fadeaed7e7aa7.pdf?productCode=C2143)。其余候选及每条查询时间见CSV。

### E17：D4

D4：P4功率肖特基30V/0.5A，SW_VCOM到VBB支路，核对低Vf及结电容。

C8598 B5819W SL为40V/1A/SOD123基础库；SS14 C2480为40V/1A/SMA基础库。额定值不降低，但需要实际电流下Vf、漏电、结电容及低压负电源效率对照。

**建议：** 优先C8598同封装，补D4波形/损耗后批准；SMA没有必要优先。

当前节点：D4:SW_VCOM,VBB_3P5V。

查询依据：[C8598国内商品页](https://item.szlcsc.com/9093.html)；[所附原厂资料](https://datasheet.lcsc.com/datasheet/pdf/4ac2c059be7c462694ab0715ce987a85.pdf?productCode=C8598)。其余候选及每条查询时间见CSV。

### E18：C18

C18：PUMP_P_LOW对地220nF/50V/X7R/±10%，保持未知峰值50V要求。

基础库C21120仅25V，不通过。2×C28233(100nF/100V)＋C1729(22nF/50V)为222nF，标称增加0.91%；总公差仍±10%，但多2件，偏压后容量、ESR和布局需要复核。

**建议：** 建议单只原料自焊；组合为待验证调整，不等于批准222nF替代。

当前节点：C18:PUMP_P_LOW,GND。

查询依据：[C21120国内商品页](https://item.szlcsc.com/21832.html)；[所附原厂资料](https://datasheet.lcsc.com/datasheet/pdf/02336ea48ea44ca18c72517dd3cb7b47.pdf?productCode=C21120)。其余候选及每条查询时间见CSV。

### E19：C22,C25

C22 PUMP_N_MID、C25 REG_VGN对地1µF/50V，两个节点独立核对。

C28323 CL21B105KBFNNNE为0805/50V/X7R/±10%国内基础库，有SMT库存。C15849虽免费但0603/X5R，温度及偏压属性变化更大，不优先。

**建议：** 优先同尺寸X7R C28323，补工作电压下有效容量与参考输出稳定性。

当前节点：C22:PUMP_N_MID,GND；C25:REG_VGN,GND。

查询依据：[C28323国内商品页](https://item.szlcsc.com/29074.html)；[所附原厂资料](https://datasheet.lcsc.com/datasheet/pdf/02336ea48ea44ca18c72517dd3cb7b47.pdf?productCode=C28323)。其余候选及每条查询时间见CSV。

### E20：R18

R18：FBN到REG_VGN 16kΩ，与VGL到FBN的400kΩ组成高阻反馈链；不是16k直接跨VGL。

C17490与C4210直接16k均为国内扩展库标签。基础库15k C17475＋1k C17513串联保持16k±1%、TCR界限±100ppm/℃；保守端点差100V、416k总链，电流约240µA，15k功耗约0.87mW，远低于125mW。两个0805、多1件、需新位号及反馈短线。

**建议：** 推荐串联方案；需决定增加一个0805器件的布局取舍，然后执行CAD验证。

当前节点：R18:FBN,REG_VGN。

查询依据：[C17490国内商品页](https://item.szlcsc.com/18178.html)；[所附原厂资料](https://datasheet.lcsc.com/datasheet/pdf/0a975aaa49b7c97f38a963127be4a823.pdf?productCode=C17490)。其余候选及每条查询时间见CSV。

### E21：C33,C27

C27/C33：3.3V低压去耦，100nF/50V/X7R/±10%0805；不是泵储能。

C28233 CL21B104KCFNNNE：100nF/100V/X7R/±10%0805基础库，有国内SMT库存；原/新同三星CL21B系列，耐压提升，温度特性保持。普通3.3V/100nF去耦不要求取得两份完全相同的高压偏压曲线才可推荐；保留旁边大电容。厚度代码C→F，名义0.85→1.25mm，实施时检查高度及courtyard。

**建议：** 推荐同0805直接换；正式原理图/PCB属性同步及CAD检查后才能发布。

当前节点：C33:EPD_3V3,GND；C27:EPD_3V3,GND。

查询依据：[C28233国内商品页](https://item.szlcsc.com/28983.html)；[所附原厂资料](https://datasheet.lcsc.com/datasheet/pdf/02336ea48ea44ca18c72517dd3cb7b47.pdf?productCode=C28233)。其余候选及每条查询时间见CSV。

### E22：R8

R8：VGH到FBP的110kΩ上臂，与4.3k下臂构成正反馈。

C17422(0805)与C25805(0603)国内均为扩展库标签，不用海外Basic代替国内结论。C149504基础库100k＋C17414基础库10k串联保持110k±1%、TCR界限±100ppm/℃；两只150V/125mW，在上臂端差50V保守条件下100k约20.66mW、10k约2.07mW，多1件。

**建议：** 推荐串联；100k沿用已在工程中的料，10k新免费组；须新增位号并复核反馈布局。

当前节点：R8:FBP,VGH。

查询依据：[C17422国内商品页](https://item.szlcsc.com/18110.html)；[所附原厂资料](https://datasheet.lcsc.com/datasheet/pdf/0a975aaa49b7c97f38a963127be4a823.pdf?productCode=C17422)。其余候选及每条查询时间见CSV。

### E23：D3,D5,D6

D3/D5/D6：BAT54S串联双肖特基30V；1=A1、2=K2、3=K1/A2。

C47546 BAT54S,215为扩展库标签，未取得明确免费合作证据；C8591 BAT54A为共阳连接，不能用；C2500 BAV99,215是国内基础库但为硅开关二极管，Vf/泵损耗不同，不能按串联双管直接替换。

**建议：** 保留BAT54SLT1G，三个SOT23可自焊；免费合作方案仍待直接国内SMT身份核验。

当前节点：D3:PUMP_P_LOW,VGH,PUMP_P_MID；D5:VGL,PUMP_N_MID,PUMP_N_UP；D6:PUMP_N_MID,PUMP_N_LOW,PUMP_N_DOWN。

查询依据：[C47546国内商品页](https://item.szlcsc.com/48551.html)；[所附原厂资料](https://datasheet.lcsc.com/datasheet/pdf/3fa70e0d1f2c320a83604c0e0e47ce24.pdf?productCode=C47546)。其余候选及每条查询时间见CSV。

### E24：L1,L2,L3

L1/L2/L3：15µH屏蔽功率电感；现PCR1040页面额定6.5A、Isat7A、DCR50mΩ，不能只按电感值替换。

FAUL0630-150MT C3040358为15µH、额定3A/Isat4A/DCR113mΩ且扩展库；体积变小但不能直接证明功率等效或免费。C167715实际3.3µH、C9169实际100µH，非合格候选。屏蔽、饱和定义、温升、DCR、绝缘及实际峰值都需OEM证据。

**建议：** 保留PCR1040；两端大焊盘自焊容易，缩小电感不是本轮免换料费收益。

当前节点：L1:EPD_3V3,LX；L2:SW_N,GND；L3:SW_VCOM,GND。

查询依据：[C3040358国内商品页](https://item.szlcsc.com/3597535.html)；[所附原厂资料](https://datasheet.lcsc.com/datasheet/pdf/32af2183bdd67e2b3e88428d2f37731f.pdf?productCode=C3040358)。其余候选及每条查询时间见CSV。

### E25：FPC1

FPC1：60P/0.5mm可插拔连接器，现有接触方向、屏幕尾线厚度及锁扣尺寸；保持接口位置。

未取得同配接条件的国内免费基础库/合作型号。不能拿常见排针、焊盘或不同接触方向连接器替换；当前料商城及SMT均有货。

**建议：** 保留原FPC；间距0.5mm自焊难度高，优先作为机器贴收费例外。

当前节点：FPC1:VCOMBD_M,RESEC,GDRC,RESEN,GDRN,RESEP,GDRP,GND,EPD_3V3,EPD_3V3,NC,VCC,VDDP,VDDP,NC,VDDN,VDDN,VCC,EPD_3V3,TSCL,TSDA,EPD_3V3,EPD_3V3,RES_N,BUSY_N,GND,CS_M_N,SCLK,SI0,SI1,SI2,SI3,DRVP,FBP,GND,VCOMBD_S,DRVN,FBN,REG_VGN,NC,VBB_3P5V,VSPH,VSPL,VSPL2,VSPH,VSPL,VSPL2,VSNH,VSNL,VSNL2,VSNL2,VSNL,VSNH,FPL_VCOM,TFT_VCOM,VBB_3P5V,NC,CS_S_N,VGH,VGL。

查询依据：[C2856839国内商品页](https://item.szlcsc.com/3056937.html)；[所附原厂资料](https://datasheet.lcsc.com/datasheet/pdf/bb83a8cf0950fd2606a9d5c5ac50ca05.pdf?productCode=C2856839)。其余候选及每条查询时间见CSV。

## 6. 采购与加工费分开算

[嘉立创国内经济型规则](https://m.jlc.com/portal/q2i38538.html)区分基础库/明确免费合作料与普通收费扩展型号。本次以准确C号的国内`productRecord.smtLabel`验证基础库，以`webData.smtStockNumber`记录SMT库存。商城现货字段另列。普通扩展标签没有明确免费标志时，本报告记为“未取得免费证据”，不会仅据这个字段断言合作料一定收费。

三组推荐若均在相同经济型订单中从普通收费型号改为免换料费型号，按20元/型号规则，**换料费一项可减少60元/订单**；不是本次已经实施的节省，也不是总订单净节省。新增两只电阻会增加贴装点数，C28233元件单价可能更高；元件费、贴装费、工程费、损耗、备品和运输需同条件订单复核。不能直接把60元从旧615元加工报价中扣掉，因为目前并未取得同条件新版报价。

下表为**商城独立采购**、各新MPN加2只备品、按本次公开人民币阶梯/MOQ/购买倍数计算，不是SMT报价，也不能与另一表中的SMT元件单价混用。相同C号必须在全板订单中合并；下表不累计成整板费用。

|组 / 候选|1板＋2备品：购买量 / 商城付款|5板＋2备品：购买量 / 商城付款|采购限制|
|---|---|---|---|
|E04 C15008|10只 / ¥7.712|20只 / ¥15.424|SMT库存未知，暂不能冻结SMT采购|
|E05 C29823|20只 / ¥20.548|50只 / ¥51.37|9只全换假设；未整组批准|
|E13 C13967|20只 / ¥2.796|40只 / ¥5.592|按独立采购计算，非正式采用|
|E19 C28323|10只 / ¥2.448|20只 / ¥4.896|按独立采购计算，非正式采用|
|E21 C28233|50只 / ¥10.21|50只 / ¥10.21|按独立采购计算，非正式采用|
|E20 C17475|100只 / ¥3.58|100只 / ¥3.58|按独立采购计算，非正式采用|
|E20 C17513|100只 / ¥2.11|100只 / ¥2.11|按独立采购计算，非正式采用|
|E22 C149504|100只 / ¥3.61|100只 / ¥3.61|按独立采购计算，非正式采用|
|E22 C17414|100只 / ¥2.02|100只 / ¥2.02|按独立采购计算，非正式采用|

C28233商城MOQ为50只，两个去耦电容的商城采购会被MOQ放大；SMT平台是否按实际消耗计价必须以订单为准。C29823商品费比当前4.7µF料更高，如果高压三只保留原料，原收费型号仍存在，拆分不能自动带来整组换料费节省。缺货的Q7价格即便返回，也不是可执行采购。

CSV保留1/5板、不加备品与每MPN加2备品四种商城方案。SMT单价、SMT购买倍数、损耗未取得的字段留空；查询缺失写“未知”，不写0。部分候选属于排查后拒绝，价格仅用于复核，不是购买推荐。

## 7. 证据边界与下一步

本次查询102个准确C号；24组正文和88条组内商业记录分别保留在JSON/CSV。其中若干C号来自参数搜索/公开索引的线索，查验后发现值不对或库身份不符，已经拒绝。网页返回是查询时刻的快照，不保证下一次下单库存相同。

原厂资料阅读结果与文件SHA256见[资料核验清单](../reports/basic-library-recheck-2026-10-11/datasheet-evidence.json)。取得的是一般MLCC规格书时，不把它冒充具体MPN的DC-bias曲线。个别资料URL下载超时已保留失败记录；同系列通用目录可以解释编码，但不能补出缺失的工作偏压有效容量。浏览器库存查询工具本轮超时，国内公开SSR产品数据正常可读；需要登录SMT页才可确定的合作免换料费标记/订单价格仍未确认。

电气证据缺口的具体下一步：

- C15008：取得国内SMT可用库存与3.3V容量数据；不能让用户仅凭商城有货批准。
- C29823/C13967/C28323/C1622：取得具体MPN的工作偏压容量数据，按实际节点审核；厂家最低所需有效容量与实际波形未明确的高压支路保持原件。
- AO3400A/AO3401A：分别记录GDRP、DRVP、GDRN、GDRC相对源极的VGS峰值、频率和驱动能力，完成损耗/热预算。Q7的原料缺货独立处理。
- 肖特基和Q6：补实际脉冲电流/频率、Vf或储存时间造成的损耗以及热预算。
- 标为扩展库的同族PNP、双肖特基、温度IC：继续以准确C号核查国内SMT合作免费标记；商品扩展标签不能替代这一步。

仅真正涉及设计取舍的组合方式与FPC装配建议进入待决定CSV；资料搜集和正常等效性审核仍由我继续完成，不要求用户自己逐组查资料。推荐下一轮先做E21与E20/E22；不建议为省单个型号费用把3.3µF拆成6只或把CT拆成10只。

冻结采用型号后才修改KiCad属性/本地封装/布局布线，保留旧UUID、新电阻新位号；再做ERC、DRC、未连接、原理图—PCB一致性、KiCad实际打开及重复更新检查，生成新release。未经这些验收，不把本报告候选加入生产BOM。显示、瞬态、温升、配接及安全掉电仍为焊后验收。
