Rhys-Q/album/hardware/pcb/gdep133c02-driver/docs/基础库17组改版-v0.11.md

# v0.11：17组基础库原型改版

用户于2026-10-11指定将“3＋14组”采用本轮找到的基础库器件。3组（E20/E21/E22）有参数审核结论；其余14组为用户指定的原型试验，**性能等效未验证**。本版不代表可以直接量产，也没有把“基础库有货”当作“电气合格”。E01此前指定的22只C440198不变，其偏压容量/纹波与85℃温度上限仍须验收。

## 实施内容

|组|本版器件或组合|变化|
|---|---|---|
|E03|C28323 1µF/50V＋C28233 100nF/100V|六支路每个3.3µF改3×1µF＋3×100nF，增加30件；原3×10µF保留，每支路标称33.3µF|
|E04|C15008 CL31A107MQHNNNE|100µF/6.3V，1210→1206；国内SMT库存未返回，保持未知|
|E05|C29823 1206B475K500NT|九只4.7µF/50V，1210→1206；低压去耦与高压输出分别验收|
|E08/E10|C15127 AO3401A|Q7/Q8，30V P沟道；Q7保留R49，−1.8V导通保证缺口及驱动动态待验收|
|E09|C20917 AO3400A|Q1/Q4，30V N沟道，SOT-323→SOT-23，分别核对栅源波形|
|E11|C8678 SS34|D1/D2，40V/3A SMA；正确K/A脚序，重新布置功率支路|
|E12|C1622 CL10B473KB8NNNC|C26 47nF/50V，0805→0603|
|E13|C13967 CL21B474KBFNNNE|六只470nF/50V/X7R/0805|
|E14|C14858 CL10C101JB8NNNC|C36＋C151–C159共10×100pF/50V/C0G并联为1nF，增加9件；连接BENCH_3V3与SW_CT，不接GND|
|E15|C20526 MMBT3904(RANGE:100-300)|Q6，SOT-23，B/E/C=1/2/3；热/储存时间待验收|
|E17|C8598 B5819W SL|D4，40V/1A/SOD-123；Vf/漏电/结电容待验收|
|E18|C28233＋C1729 CL21B223KBANNNC|C18＋C160＋C161为2×100nF＋22nF=222nF，标称增加0.91%，增加2件|
|E19|C28323 CL21B105KBFNNNE|C22/C25，1µF/50V/X7R/0805；两个不同节点分别验收|
|E20|C17475 15k＋C17513 1k|R18＋R51串联16k，新增R18_FB_MID；不改变400k反馈上臂|
|E21|C28233 CL21B104KCFNNNE|C27/C33，100nF/100V/X7R/0805|
|E22|C149504 100k＋C17414 10k|R8＋R52串联110k，新增R8_FB_MID；不改变4.3k反馈下臂|

104→147装配件，102→145顶面SMT，J1/J2仍为手工插件；共36组采购型号。新增43件：C121–C161、R51/R52；原有符号UUID保留，PCB与原生原理图关联不变。新增basic-composites.kicad_sch是组合补充页，原来的符号仍在各原理图页。

## 参数与费用边界

R18与400k串联反馈链在保守100V端点差下电流约240µA，15k约0.87mW，1k约0.058mW；R8上臂110k在50V端点差下，100k约20.66mW、10k约2.07mW，均低于125mW并有85℃降额余量。两个串联组合的最坏总公差仍为±1%，温漂界限±100ppm/℃。这些计算不能证明屏幕反馈环路实测稳定性。

未验收：所有换料电容的工作偏压有效容量/ESR/纹波，Q7原件Qg约1.6nC而AO3401A约7nC/Ciss约645pF，Q8的Miller驱动和−1.8V导通缺口，Q1/Q4实际栅源电压与驱动负载，Q6脉冲损耗/散热，肖特基实际Vf/漏电/结电容。保留50V或更高耐压，CT不采用X7R，双肖特基D3/D5/D6连接形式不变。

按经济型SMT普通扩展库20元/型号/订单的场景，原24组例外中的17组采用基础库标签器件后，收费例外剩7组，理论换料费480→140元，减少340元/订单。**这是规则估算，不是新订单报价或总价节省。** 43个新增贴片件、购买倍数、备品及贴片费会改变付款。615元旧加工报价的订单条件未完整取得，不能直接宣称新版只需195元加工费。商城单价不作为SMT订单单价，SMT单价、MOQ、损耗及其他加工费未知时留空。

采购CSV按准确C编号汇总1板/5板，以及每型号组加2件备品的商城理论付款；同型号合并后再计算MOQ/倍数，未取得公开价格的留空。不含运费。此次公开接口刷新有部分失败，CSV分别保留“有效查询时间”和“本次刷新状态”，不能把历史库存当作实时保证。C15008的SMT库存仍未知；订单提交前必须核对。

## 剩余7组

E02 U4温度传感器、E06金属采样电阻、E07负载开关、E16 Q3 PNP、E23串联双肖特基、E24功率电感、E25 FPC保持原型号。尚未决定混合装配，机器BOM/CPL仍包括145个SMT位号。Q7旧料缺货已改为有基础库候选的AO3401A，但其低栅压/驱动性能缺口仍未闭环。

## 使用与验收

CAD验收以reports/ERC、DRC、引脚映射、GUI更新预览及release/verification.json为准。CAD通过不等于实板性能通过。首次仅建议小批原型；限流3.3V供电，先验证软启动/安全掉电和各正负电源波形，再接屏幕运行显示与温升测试。尤其关注Q7/R49两端GDRC的VGS幅度、尖峰、占空比、驱动负载和发热，以及六组源极电源的纹波和最低电压。

来源：[嘉立创元件库及经济型规则](https://m.jlc.com/portal/q2i38538.html)；准确C编号、国内库标签、库存、时间及厂家PDF见采购CSV和reports/procurement-v011.json。旧v0.9/v0.10文档与24组审核是历史快照；以本版逐位号对照和采购清单为当前选型。
