Rhys-Q/album/hardware/pcb/gdep133c02-driver/docs/current-configuration.md

> 当前v0.10：用户指定E01全部22只改为村田C440198 / GRM21BR61H106KE43L、0805、X5R、10µF/50V。六组各3×10µF+3.3µF，数量保持；85℃上限，偏压容量等效未验证。见[E01改版](E01改版-v0.10.md)。以下历史说明涉及E01时以当前改版为准。

> 当前v0.9-resistors：仅R7、R10/R19、R17/R50改为免换料费料，104件与全102件SMT装配保持；其他v0.8配置继续有效。当前采购及型号见[三组改版](三组电阻免换料费改版-v0.9.md)。

> v0.8：C28为4.7µF/50V，与既有4.7µF合并采购；D3/D5/D6改为BAT54SLT1G；六组电阻替代见[降本审核](降本审核-v0.8.md)。历史版本详情仅作为变更记录，当前型号以v0.8 BOM为准。

# 当前驱动板配置与手焊说明

2026-10-10 v0.8改版说明：普通电阻已扩大0805；R17由400kΩ改为R17+R50两只200kΩ串联；部分小电容扩大0805。电路功能说明仍适用，现用型号、封装及装配数量以[本版审查](国内采购与手焊改版-v0.8.md)和本版BOM为准。GUI/采购缺口见当前验收记录，旧版验收不能替代新版。
2026-10-10，电路版本v0.8-cost，包含PCB符号关联修复。完整BOM为104件，其中102个顶面SMT、J1/J2两个直插排针；26个铜测试点不采购。

## 当前配置

- 外接稳压3.3V供电，外接3.3V主控，保留五路33Ω信号串联电阻及默认电平拉电阻。无SPI/BUSY/SI1硬件隔离，无板载主控、USB、SD或电池管理。
- U5为TPS22917DBVR/SOT-23-6：1=BENCH_3V3、2=GND、3=EPD_PWR_EN、4=SW_CT、5/6=EPD_3V3。C36=1nF/50V、C0G、0805，接CT与输入，不接地；QOD接输出。TPS22917L使能极性不同，不可直接混购。
- P1不装L4/L5，以EPD_3V3共网铜线分支供电，保留输入/输出及各功率级去耦。详见[P1说明](p1-supply.md)。
- 三路电感变换器、正负栅极电荷泵、采样反馈、温度传感器和高压储能保留。六组源极电容为50V陶瓷并联，名义每组33.3µF，偏压有效容量仍待验证。
- P4增加R49 0Ω/0805和TP25/TP26；R13位于Q7栅极侧。正常装R49，拆除只用于断电后的隔离调试，见[GDRC说明](gdrc-debug.md)。
- BS0/BS1直接接EPD_3V3，D/C接地；DRVN2、U4.3和J2.16不接。屏幕41/56脚共接VBB_3P5V，FPC底座可插拔。

## 手焊与使用

仍有0.5mm间距FPC插座、SOT-323；普通电阻和部分小电容已放大0805，需要助焊剂、细焊锡、吸锡带、放大观察及控温烙铁。先焊低矮件，检查桥连，最后装排针。板子双面有铜，SMT元件全部在顶面；钢网仅在使用锡膏回流工艺时按需要采购。

按[v0.8制造审阅包](../releases/jlc-cn-review-v0.9-resistors-2026-10-10/README.md)中的bom-all购买元件，备件不加入CPL。只用当前版本配套的Gerber/BOM/CPL；不按已删除的旧数量和隔离接法装配。

焊后先做断电短路检查，再按限流3.3V分阶段测量。主控先上电、最后断电；关屏先完成POF/深睡命令和BUSY等待，再处理GPIO、关闭U5，连接线及状态约束见[接口约定](interface-power-state.md)。

ERC/DRC和符号关联检查通过，GUI工程模式更新预览通过，按UUID匹配无重复新增器件；启动浪涌、稳态压降、温升、有效电容、功率峰值、采样Kelvin误差、实物配接、整套掉电波形及显示仍待实测，见[设计审核](design-review.md)。
