Rhys-Q/album/hardware/pcb/gdep133c02-driver/docs/Q7-替代料复核-2026-10-09.md

# Q7 PJA3433 国内现货替代复核

复核日期：2026-10-09。结论：查到同封装现货候选，但尚未找到有充分依据可直接用于本板的替代料。本轮不修改原理图、PCB，也不生成一个声称已完成替代的新 release；当前制造包仍是 v0.7。用户授权是找到合格料后替换，并不等于接受电气要求降低。

## 当前 Q7 的要求

Q7 位于 P4 负偏置供电支路，1=G/Q7_GATE、2=S/RESEC、3=D/SW_VCOM；R49 连接 GDRC 与栅极。保持 P 沟道、源漏方向和现有拓扑。屏幕规格书的 GDRC 驱动描述与厂家参考图的 P 管选择仍存在历史疑点，采购替换不能顺带把 Q7 改成 N 管。

[PANJIT 原厂 PJA3433 手册](https://www.panjit.com.cn/upload/datasheet/PJA3433.pdf)给出：SOT-23，1=G/2=S/3=D，VDS=-30V、VGS=±8V；RDS(on) 最大值为370mΩ@-4.5V、540mΩ@-2.5V、970mΩ@-1.8V，阈值电压幅值最高1.3V。Qg 典型1.6nC@-4.5V，Ciss 典型125pF@VDS=-15V。这些测试条件须一起比较。

原器件能在较低栅压下保证导通，且栅极负载小。只有“30V、P管、SOT-23”的候选不能自动当作等效料。阈值电压只是微安电流开始导通的条件，不代表功率开关已充分导通。

## 国内商城实时查询

库存取国内商品页数据，不采用海外 LCSC 搜索缓存。原始结构化记录及页面哈希见[查询记录](../reports/q7-sourcing-2026-10-09.json)。库存会变化。

| 型号/厂家 | 国内商城编号及页面 | 查询库存 | 购买倍数 | 判定 |
|---|---|---:|---:|---|
| PJA3433_R1_00001 / PANJIT | [C6628419](https://item.szlcsc.com/7583380.html) | 0 | 5 | 原型号缺货 |
| PJA3433-AU_R1_000A1 / PANJIT | [C6357487](https://item.szlcsc.com/7306678.html) | 0 | 1 | 同系列车规候选缺货；不能据其海外上架认定国内有货 |
| SI2303 / UMW | [C545575](https://item.szlcsc.com/566724.html) | 9941 | 20 | 有现货，低栅压保证不足，未采用 |
| BSS308PE-HXY / 华轩阳 | [C5337195](https://item.szlcsc.com/6103351.html) | 1436 | 10 | 有现货，低栅压保证与动态驱动证据不足，未采用 |
| DMP31D0U-7 / DIODES | [C5224069](https://item.szlcsc.com/5925250.html) | 1 | 5 | 页面标为无现货，库存不足购买倍数；电气上也不合适 |

## 现货候选为何暂不采用

**UMW SI2303（C545575）**：[厂家手册，经商城提供](https://datasheet.lcsc.com/datasheet/pdf/02aa239c720b83618fe1d3f97e2bb880.pdf?productCode=C545575)。30V P管，脚序与封装相同，Qg典型2nC@-4.5V，Ciss典型155pF@-15V，动态负载较接近。关键问题是阈值范围-1至-3V，手册只保证-10V/-4.5V下导通电阻，没有-2.5V/-1.8V保证。当前无法证明 GDRC 到 RESEC 之间最小有效栅源驱动满足其要求；不凭典型曲线将其写入正式 BOM。

**BSS308PE-HXY（C5337195）**：[华轩阳手册，经商城提供](https://datasheet.lcsc.com/datasheet/pdf/88b3bb70d7f735005cb99581ae99e480.pdf?productCode=C5337195)。30V P管，阈值最高幅值2.5V，导通电阻表只保证-10V/-4.5V；正文“可低至2.5V工作”不能替代该电压下的最大导通电阻保证。Qg典型5.22nC@-4.5V、Ciss典型463pF@-15V，相比原管分别约3.26倍和3.70倍。Qg测试的漏极电压/电流亦不同，比值仅用于指出驱动负载增大的风险，不能作为精确开关时间比。没有屏幕驱动能力与波形依据，不能确认开关损耗、转换时序、输出负偏置是否保持。

**DMP31D0U-7**：[DIODES原厂参数](https://www.diodes.com/part/view/DMP31D0U)。低栅压适应性与栅极负载较好，但导通电阻上限1Ω@-4.5V、1.5Ω@-2.5V、2Ω@-1.8V，明显高于原管。连续电流条件也不同且裕量更低；实际峰值/RMS电流与热预算未确认，不采用。

额外筛选的 AO3435 为20V，不能保持原30V要求；CJ2333原厂版为12V；不同厂家的同名或加后缀型号必须独立核验。DIODES DMP3099L也增加栅极负载且缺少本板所需的低栅压导通保证，未采用。

## 解除替代限制需要什么

可以从现货 SI2303 开始做独立试验，但它目前只是实验候选。应先用原管或厂家驱动板测量 Q7 的实际 VGS（G相对S，而不是G相对GND）、VDS尖峰、开关频率、导通期间电流和温升；确认低温/低输入电压时仍有驱动裕量，再比较替代管的转换边沿、RESEC采样波形、负偏置输出与显示/安全掉电。R49和现有测试点可辅助这些测量。

在取得驱动保证或实测依据前，现货数量不能消除上述资料缺口。当前 v0.7 保持原 Q7；它通过 CAD 检查，但 Q7 的国内采购缺口仍未闭环。
