Rhys-Q/album/hardware/pcb/gdep133c02-driver/docs/三组现货替代-v0.7.md

# v0.7 三组嘉立创商城现货替代

日期2026-10-09，KiCad10.0.6。104个装配件、102个顶面SMT，四层100×80mm，板框、安装孔、接口及电路连接不变。库存来自国内商城页面productRecord，不是国际站或SMT料库库存。

|位号|原型号|本版型号/立创编号|国内库存|MOQ/倍数|
|---|---|---|---:|---:|
|L1–L3|MSS1246-153MLC|JIERR PCR1040-150-M / C53896892|414|5/5|
|C36|C0805C102J5GACTU|FH 0805CG102J500NT / C29925|147532|50/50|
|C28|GRM32ER71H225KA88L|Samsung CL32B225KBJNNNE / C307587|28|5/5|

## 电感与PCB

PCR1040为屏蔽金属粉末磁芯、15µH±20%，DCR最大50mΩ；7A饱和为典型值且按降感30%定义，6.5A温升电流为典型值且按40℃温升定义，不能与原器件4.6A@10%降感或2.85A@20℃温升直接比较。原器件相同30%/40℃判据分别5.5A/3.8A。新品总工作温度最高125℃。频率范围、磁芯损耗和温度下饱和特性仍以实际电源波形/温升验证；电感更换不改变屏幕控制、采样0.2Ω或Q7拓扑。

原厂推荐焊盘图F=13.6mm为外侧总跨度，G=5.4mm为内侧间距，I=4.1mm为焊盘高度。因此两焊盘4.1×4.1mm，中心±4.75mm。本体11.5mm Max×10.5±0.5mm×4.0mm Max。本地封装L_JIERR_PCR1040按该图重建，1/2脚网络保持；器件位置/方向保持。较宽焊盘与邻近RESEN过孔冲突，该过孔及相连走线已移开，功率铜宽保持。重填GND铜区并调整电感丝印。PCR1040未提供随工程可用的准确STEP模型；不要用旧Coilcraft外形冒充新型号。

## 两只电容

C36位于TPS22917 CT定时支路，风华同为0805、1nF/50V、C0G、±5%，保留C0G稳定介质、容量、网络和焊盘。C28位于BENCH_3V3对地输入去耦，是稳压3.3V域；三星同为1210、2.2µF/50V、X7R、±10%，厚度2.5±0.2mm，保持现有焊盘。其他高压/飞跨/源极储能电容不变，不能据本次C28替代降低那些节点耐压。

## 采购及验收边界

1板用3只电感、各1只电容，国内起订分别买5、50、5只；5板用15、5、5只，分别买15、50、5只。费用空白表示尚未取得小量人民币报价，不使用页面最低大批价格作为实际付款。库存随订单变化，未预留。没有代用户下单。

原理图/PCB UUID保持，检查实际BOM属性、焊盘网络、路径、ERC/DRC/未连接/原理图一致性及GUI更新预览。制造文件与来源哈希见release verification.json。电源瞬态、磁芯温升、显示及安全掉电仍需焊后测试。

资料：原厂PDF保存在sources/v07/C53896892.pdf、C29925.pdf、C307587.pdf；采购来源及PDF哈希见reports/procurement-v07.json与采购CSV。立创商品页面分别为https://item.szlcsc.com/57092574.html、https://item.szlcsc.com/30679.html、https://item.szlcsc.com/291261.html。
