Rhys-Q/album/hardware/pcb/gdep133c02-driver/docs/降本审核-v0.8.md

# v0.8 按采购总价降本审核

维护日期2026-10-10；国内供货查询为2026-10-09晚至2026-10-10凌晨。价格/库存是查询快照，付款时必须再次复核。本轮以附件38组原报价259.24元为基线；旧型号未替换项保持原报价，不把新旧时间的市场价差算成工程收益。按原购买量比较，新版预计 **234.00元，减少25.24元（9.74%）**，不含运费、SMT、PCB及可能的平台优惠。正式装配仍104件、102顶面SMT；型号组38→37。另实施D3/D5/D6串联双二极管替代。

## 已实施

普通电阻六组：R7→C881377，R8→C5140228，R18→C2774511，R10/R19→C407467，R17/R50→C2989258，R49→C17477。阻值不变，R10/R19容差1%→0.5%，R18功率1/8W→1/3W，R17/R50温漂100→50ppm/℃。其他额定条件和0805实体/焊盘兼容已核对。所有电阻脚1/2无极性；既有焊盘1.20×1.40mm、中心距2.0mm，支持2.00×1.25mm体尺寸与端头公差。R7/R8按±1%反馈电阻保留容差；16k R18与两只200k不改变分压比，400k总值最坏静态偏差±1%，新200k总温漂上界50ppm/℃；未宣称独立随机误差可以抵消。新料来源PDF见sources/v08，与料号编码/温度/端头逐项对应。R49仍为零欧调试支路，≤50mΩ、额定2A/过载5A，栅极驱动路径正常装配，不通过降本去掉调试功能。

### D3/D5/D6串联双二极管

Diodes BAT54S-7-F（C83574）改为onsemi BAT54SLT1G（C19726），保持SOT-23及1=A、2=K、3=中点串联脚序，PCB焊盘坐标/极性/网络不变。原厂规格逐项比较：双方VR=30V、DC电流200mA、重复峰值300mA；同电流测试下Vf最大0.24/0.32/0.40/0.50/0.80V（0.1/1/10/30/100mA）；IR最大2µA@25V；结电容≤10pF@1V/1MHz；trr≤5ns@IF=IR=10mA。原件PD=200mW、Tj上限150℃，新件PD=225mW、25℃以上降额1.8mW/℃，Tj上限150℃；额定热能力没有下降，但厂商测试板条件不同，不把25mW差值当作本PCB可增加功率。新件低温范围-55℃（原-65℃）仍覆盖屏幕正常工作温度，不能宣传整机新增-65℃能力。

新件IFSM列600mA短脉冲和1A方波1s等级；保守继续沿用原600mA而非增加电荷泵电流指标。SOT-23实体约2.8–3.04mm长、1.2–1.4mm体宽、1.78–2.04mm脚中心距；本地焊盘及1.9mm引脚节距兼容，三脚映射逐脚核对。标称Vf、漏电、恢复和结电容上限相同，因此不引入更大的规格上限导通/恢复损耗；负载波形、两管实际温升和过冲仍需实板验证，未借采购替换提高电压或电流设计范围。旧/新原厂PDF保存在sources/v08，MPN和源极方向见原理图及BOM。

查询时国内库存173616只，MOQ及倍数1只；按原采购5只比较0.1551×5=0.7755元，较原3.52元节省2.7445元，不减少原备品2只。

### C28输入去耦与瞬态评审

C28在U5上游，BENCH_3V3至GND；从三星2.2µF/50V/1210改成既有村田GRM32ER71H475KA88L（C86052）4.7µF/50V/X7R/1210，非极性，焊盘和位置不变。TI TPS22917规格书第11节要求稳压输入，通常1µF足够；慢响应供电/大负载跳变可能仍需额外bulk，不把1µF当作所有工况保证。现设计只接受稳压3.3V输入。

Allegro原厂A80601-DS Rev.3的第37页明确记录此村田型号在25V时典型有效容量3.29µF。以较高25V偏压值作为低压3.3V输入的保守典型参考，再按10%初始容差和15%X7R温度变化估算3.29×0.9×0.85≈2.52µF，超过通常1µF要求。这是基于典型容量/常见偏压趋势的工程估算，**不是厂家保证的全角落最小容量**；老化/实际3.3V温度曲线尚无独立实测。该替换增加标称容量，不减少原设计输入储能，保留50V额定，ESR仍属MLCC，作为输入旁路没有LDO输出环路ESR稳定性限制。源文件保留厂家原始PDF（sources/v08/A80601-2021.pdf）及TI资料，未据此批准其他高压储能候选。

C28不在U5输出侧，C36 CT定时电容、输出C29–C33和QOD均不变，因此不增加由U5限斜率充电的输出负载；输入初次插电增加标称电荷(4.7−2.2)×3.3≈8.25µC（能量增加约13.6µJ）。输入插电浪涌取决于线缆/稳压源阻抗，尚无峰值实测；上电前限流供电，焊后测输入跌落/过冲/纹波，不允许热插拔屏幕。正常负载跳变下可增加旁路储能，不能替代实板瞬态测试。

采购C86052每板8→9只；原10只包仍覆盖一板（余量2→1）。取消C28原独立5只包：删除的是4只MOQ剩余和1只需求的单独型号采购，C28元件本身仍装配。其他已替换组按原报价购买量比较收益，未通过缩减备件夸大收益。

## 未采用的候选及供货缺口

贵的10µF、3.3µF、100µF仍是原件。三环C50767259有国内现货且25只约29.35元，三星100µF C49066等也便宜；缺对应本板偏压容量、ESR/纹波及原件对照，不能投入正式BOM。六组源极保持每组2×10µF+3.3µF，CT仍C0G。MOS实际驱动条件、电感脉冲/绝缘、采样电阻脉冲曲线及二极管热/峰值未有充分新证据的组均保留，逐组原因见下表和CSV。

Q7 PJA3433_R1_00001 C6628419国内现货为0；仍为采购未闭环项，海外历史2.65元不冒充国内现货价，替代MOS未通过VGS/Qg及拓扑审查。本版仍不能称为“全BOM嘉立创现货闭环”。J1/J2/FPC1/L1–L3国内库存单独取得，但未取得本次原购买量的实时完整人民币阶梯，采购CSV留空，附件报价仅作旧比较基线。其余所有新替代都有国内库存覆盖1板、5板及2备件。

## 38组审核（按原小计降序）

|顺序|原型号 / 位号|原采购额元|结果|
|---:|---|---:|---|
|1|GRM32ER71H106KA12L / C1,C103,C104,C106,C107,C109,C110,C112,C113,C115,C116,C118,C119,C13,C15,C2,C20,C3,C4,C5,C6,C7|50.56|保留：三环/信昌/风华/TDK等有现货低价，但未完成与原件在六组源极实际偏压、ESR及纹波条件的有效容量逐点对比；不把标称10µF相同当作容量闭环。|
|2|GRM32DR71H335KA88L / C105,C108,C111,C114,C117,C120|28.00|保留：信昌FS32X335K500EGG、火炬CC1210X7R50V335KN可省钱；缺实际偏压有效容量/ESR证据，六组容量配置不变。|
|3|GRM32ER60J107ME20L / C31,C32|14.64|保留：三星CL32A107MQVNNNE C49066有现货；同为100µF/6.3V/X5R/1210不代表3.3V容量相同；偏压容量对比未闭环。|
|4|TPS22917DBVR / U5|12.24|保留：MX22917T23虽支持QOD/CT/反灌保护，Ron约240mΩ而非原约80mΩ；完整静态电流、瞬态、反灌边界及热评审未通过，不能仅按引脚相同替换。|
|5|CL32B225KBJNNNE / C28|11.74|实施：C28输入BENCH_3V3旁路改用既有GRM32ER71H475KA88L；4.7µF由8→9只，采购10只不增加付款；取消独立2.2µF组的5只采购（含4只MOQ余量）。|
|6|GRM32ER71H475KA88L / C12,C14,C16,C19,C21,C29,C30,C8|8.86|保留原型号，新增C28并入此组；低价PSA/CCTC未提供本板工作偏压有效容量/ESR对比。|
|7|DMN3065LW-7 / Q1,Q4|8.63|保留：未找到同封装且实际栅压下RDS(on)、Qg/开关损耗均可证明不劣的低价候选。|
|8|TCN75AVOA713 / U4|7.80|保留：屏幕温度采集需兼容I2C地址/寄存器/精度；未取得有意义且固件兼容的等效降本证据。|
|9|WSL1206R2000FEA / U1,U2,U3|7.44|保留：RESI MFCR1206FR200QHR、华德STE1206M1W0R200F有现货，额定功率高；缺与WSL的脉冲能量曲线和实际采样峰值对应，不能仅靠1W替代。|
|10|DMP3068L-7 / Q8|6.86|保留：SLDMP3098L价格低，但最低实际栅压下导通能力、阈值、Qg和驱动损耗未闭环。|
|11|PCR1040-150-M / L1,L2,L3|6.23|保留：现PCR1040已是国内现货降本型，饱和/RMS/DCR/绝缘和焊盘曾复核；未找到证据充分且净付款更低的新料。替代接口未返回结果，单独核对现料库存。|
|12|RC0805FR-074K3L / R7|6.12|实施：4.3kΩ ±1%,125mW,150V,±100ppm/°C; same 0805 hand-solder pads|
|13|MBR230S1F-7 / D1,D2|5.70|保留：ROHM RBR2MM30ATFTR虽30V/2A同类且便宜，Vf额定值不同，未证明原高峰值功率回路的温升/浪涌/结电容和尺寸均兼容；不实施。|
|14|0805B473K500NT / C26|5.49|保留：按国内现货和原包装数量比较，没有合格且更低实际付款候选。|
|15|0805W8F1602T5E / R18|4.97|实施：16kΩ ±1%,333mW,150V,±100ppm/°C; same 0805, more rated power|
|16|TJC8-2.54-2A / J1|4.58|保留：接口位置及3A通流要求保持，未找到尺寸/镀层/额定电流齐全并值得改板的更低付款方案；单独核对现料库存。|
|17|0805W8F220KT5E / R10,R19|4.53|实施：2.2Ω ±0.5%,125mW,150V; same manufacturer series, tolerance improved; 2.2Ω ±0.5%,125mW,150V; same manufacturer series, tolerance improved|
|18|GRM21BR71H474KA88L / C10,C11,C17,C23,C24,C9|4.35|保留：0.47µF用于飞跨节点；IHHEC虽同50V且便宜，缺偏压容量、ESR与纹波比对。|
|19|0805CG102J500NT / C36|4.19|保留：CT时序必须C0G；未找到合格现货且更便宜者。|
|20|MMBT3904-7-F / Q6|3.92|保留：便宜CCX的200mW低于原件额定功耗；未完成电荷泵开关峰值、存储时间/温升评审。|
|21|MMBT3906-7-F / Q3|3.73|保留：便宜CCX/Nexperia功耗与原件不同；缺本电荷泵工作损耗及存储时间核算，不能只按3906型号替换。|
|22|B0530W-7-F / D4|3.68|保留：便宜R+O/PANJIT的Vf、漏电和脉冲曲线不同；电荷泵损耗与反向峰值证据不足。|
|23|0805W8F1003T5E / R11,R30,R35,R36,R44,R45,R46,R47,R48|3.61|保留：与原采购量相同比较未找到合格且更低实际付款的候选。|
|24|BAT54S-7-F / D3,D5,D6|3.52|实施：30V/200mA series dual, pin1=A/pin2=K/pin3=mid; Vf max 0.24/0.32/0.4/0.5/0.8V at same currents, CT<=10pF, trr<=5ns,225mW; same SOT-23; 30V/200mA series dual, pin1=A/pin2=K/pin3=mid; Vf max 0.24/0.32/0.4/0.5/0.8V at same currents, CT<=10pF, trr<=5ns,225mW; same SOT-23; 30V/200mA series dual, pin1=A/pin2=K/pin3=mid; Vf max 0.24/0.32/0.4/0.5/0.8V at same currents, CT<=10pF, trr<=5ns,225mW; same SOT-23|
|25|RC0805FR-07110KL / R8|3.40|实施：110kΩ ±1%,125mW,150V,±100ppm/°C; same 0805 hand-solder pads|
|26|0805W8F2003T5E / R17,R50|3.40|实施：200kΩ ±1%,125mW,150V,±50ppm/°C; feedback total remains 400kΩ; 200kΩ ±1%,125mW,150V,±50ppm/°C; feedback total remains 400kΩ|
|27|GRM21BR71H224KA01L / C18|3.38|保留：0.22µF飞跨/高压节点，廉价100V IHHEC不能仅靠更高耐压推定等效有效容量和ESR。|
|28|RC0805JR-070RL / R49|3.25|实施：0Ω jumper <50mΩ,2A rated/5A overload, same debug function|
|29|0805W8F4701T5E / R20,R21|3.06|保留：同采购量未找到合格且更便宜的现货候选。|
|30|0805W8F330JT5E / R39,R40,R41,R42,R43|2.85|保留：同采购量未找到合格且更便宜的现货候选。|
|31|PJA3433_R1_00001 / Q7|2.65|国内供货未闭环：PJA3433国内库存0。PPMT30V4/SI3401A的VGS限制与Qg/驱动能力不充分；保留PJA3433及R49，不改P4拓扑；原报价2.65元为海外代购历史价。|
|32|0805W8F1004T5E / R13,R2,R3|2.64|保留：同采购量未找到合格且更便宜的现货候选。|
|33|GRM21BR71H105KA12L / C22,C25|2.59|保留：Samsung CL21B105KBFNNNF有现货且便宜，但高压飞跨有效容量、ESR与纹波能力未闭环。|
|34|FPC-05FB-60PH20 / FPC1|2.45|保留：60P/0.5mm/下接触/可插拔FPC；尺寸、接触方向与屏幕配接要求严格，未获得价格收益及完整兼容证据；单独核对现料库存。|
|35|0805W8F2001T5E / R1|2.34|保留：同采购量未找到合格且更便宜的现货候选。|
|36|0805W8F1501T5E / R12|2.12|保留：同采购量未找到合格且更便宜的现货候选。|
|37|SH-PZ254V-2x8P / J2|1.88|保留：2x8直插接口位置及尺寸保持；未找到足够价格收益且完整兼容者；单独核对现料库存。|
|38|CL21B104KBCNNNC / C27,C33|1.84|保留：三环100V 0.1µF虽便宜，型号容量温度/尺寸与偏压证据未完成；收益有限，不用未经审核料。|

## 数据、工艺和验收边界

[降本对照CSV](降本对照-v0.8.csv)记录原购买量和候选净付款；[采购清单CSV](采购清单-v0.8.csv)记录最终37组、MPN/C号/来源/国内库存/包装倍数、1板、5板以及各组2件备品的付款。空白是缺口，不是零元；“5板+2备品”指该型号组总体2件额外备品。MOQ剩余与备品分开，不把100只包装当作每板必需量。国内公开接口阶梯数量以包装数返回，已乘theRatio换算实际只数；网页最低大批量价未用来计算MOQ付款。原始公开供货响应见reports/procurement-v08.json，可审计阶梯和查询来源。

此次12个位号更换全部使用原封装、同焊盘映射，不改走线/过孔/安装孔/接口位置；100×80mm四层及GND平面保持。重新填铜并用KiCad验证；CAD检查通过与上板性能是不同验收项。电源峰值、采样Kelvin、温升、偏压容量、显示刷新、FPC实物配接、安全掉电均仍需焊后验证。原件保留并不表示这些旧问题已经实测闭环。

[原厂TI TPS22917](https://www.ti.com/lit/ds/symlink/tps22917.pdf)、[EverOhms CR系列](https://www.everohms.com/data/10000/ftp/S-10-12-01-17.pdf)、[厚声HP系列](https://www.uni-royal.cn/images/userfile/file/1723267015d7bab4914ae1a4d5.pdf)。其他厂家规格书的经销商原始PDF链接在逐位号属性与采购CSV；本地存档见sources/v08。没有把分销商替代推荐本身当成电气合格证据。

## 最终CAD验收

KiCad 10.0.6最终版（含D3/D5/D6替代）重新实际打开、F8按UUID匹配；首次预览无操作及新增，应用并保存后再次F8仍无待执行变更。原理图/PCB所有焊盘网络、封装位置、走线、过孔、板框与v0.7一致；完整ERC/DRC/未连接/原理图一致性均0。预览只出现FPC机械焊脚61/62的2条提示，没有新增忽略规则。证据见reports/gui-open.json、update-preview-first-v08.txt、update-preview-v08.txt、cost-change-geometry-v08.json及配套verification.json。
