Rhys-Q/album/hardware/pcb/gdep133c02-driver/releases/jlc-cn-review-v0.11-basic17-2026-10-11/手焊说明-v0.11.md

# v0.11装配注意

本版147件；145个顶面SMD，其中138个机器贴片；手工装配9件：U4、U5、Q3、D3、D5、D6、FPC1，以及J1/J2插件。用户淘宝采购的5组器件已从机器BOM/CPL移除，但保留完整BOM。装配分配以assembly-plan.json为准。完整BOM和机器BOM/CPL来源必须匹配同版verification.json，不混用旧release。新增CT十只0603请用放大镜、细镊子和助焊剂；切勿用X7R代替C0G。新增源极组合按位号采购，六支路不能互相短接。R51/R52不能省略或装成0Ω。SS34以本地SMA焊盘的1=K/2=A和外壳阴极条纹核对，Q1/Q4/Q7/Q8的G/S/D=1/2/3，Q6的B/E/C=1/2/3。

参考编号见assembly-top.pdf的F.Fab标注；新增密集电容避免只凭丝印识别。先测电源、开关驱动和安全掉电，再接屏幕；关键电气等效未验证项见基础库17组改版说明。

用户自行采购须与手工BOM核对型号和封装。BAT54S必须为串联双管，不能买成BAT54A/BAT54C；FPC核对60P、0.5mm、接触方向、排线厚度与锁扣。U5为SOT-23-6、FPC为细间距连接器，手焊使用放大工具、助焊剂并检查桥连。原生positions-kicad.csv含全部145个SMD，不用于下单；下单仅上传bom-smt.csv与cpl-smt.csv。
