Rhys-Q/album/hardware/pcb/gdep133c02-driver/releases/jlc-cn-review-v0.10-e01-2026-10-11/E01改版-v0.10.md

# v0.10：E01 指定 C440198 / 0805 原型改版

2026-10-11，用户明确要求“直接使用村田 C440198，0805”。从v0.9更换E01全部22只，不更改其余器件或装配分配。37组、104件；102个顶面SMT、J1/J2人工插件。制造文件是原型审阅包，尚无实板性能放行。

|项目|原件|本版|
|---|---|---|
|MPN / C编号|GRM32ER71H106KA12L / C77102|GRM21BR61H106KE43L / C440198|
|标称容量 / 耐压|10µF / 50V|10µF / 50V|
|封装 / 介质|1210 / X7R|0805 / X5R，±10%|
|温度范围|−55～125℃|−55～85℃|
|国内库类别|普通扩展库|商品接口标注SMT基础库|

位号见逐位号替换对照-v0.10.csv。六组源极每组实际保留3×10µF＋1×3.3µF，即标称33.3µF：C1/C103/C104/C105、C2/C106/C107/C108、C3/C109/C110/C111、C4/C112/C113/C114、C5/C115/C116/C117、C6/C118/C119/C120。另C13在VDDP、C15在VDDN、C20在VBB_3P5V、C7在VCC。本版没有减数量、降耐压或改变电源拓扑；此前文档若写2×10µF，未包含原有C1～C6，应以原生CAD及本表为准。

## 电气证据和边界

[原厂资料（立创存档）](https://datasheet.lcsc.com/datasheet/pdf/8cca754305bc7d881114d4ba10b82bf2.pdf?productCode=C440198)已保存sources/v010/C440198-Murata.pdf。器件尺寸2.0±0.2×1.25±0.2×1.25±0.2mm；采用工程已有Driver:C_0805_HandSolder：焊盘中心±1.0375mm、尺寸1.175×1.45mm、内间隙0.9mm。本地封装及0805模型随工程管理，非极性两端器件，原网络/符号/焊盘UUID保留。

小封装X5R在直流偏压下的有效容量不能按标称10µF推断。尚未取得全部实际节点电压/峰值下的偏压容量、ESR、允许纹波和与原1210的等效证据；本次按用户明确型号实施原型，不能称为性能等效通过。50V仅为额定耐压，不意味着50V时仍有10µF。板上温升和环境必须保证器件处于85℃范围内。焊后需量测六组源极、电源输出的纹波/瞬态/显示、温升及安全掉电；失败时重新选型，不能用增加软件等待代替电源验证。

## PCB 与验收

板框100×80mm、四层、安装孔/接口位置保持；22个1210改正确0805手焊焊盘。调整RESEP/GDRC/VSNH附近局部走线与过孔，清理被替代的悬空支路，修正C1～C6丝印。功率电源原走线宽度保持，GND重新填充。符号UUID与PCB路径保持，更新不会重复添加元器件。CAD详细结果由发布包verification.json及reports记录，ERC、DRC、未连接和一致性均须为0，实际KiCad应用更新保存后二次预览须无变更，未增加忽略规则。

## 采购与成本

2026-10-11北京时间商品接口记录：商城480520只、SMT1371419只；MOQ1只、购买倍数5只；5只起1.2704元、50只起1.0596元、150只起0.9566元。证据见reports/procurement-v010.json；库存价格会变化，下单重核。SMT售价、损耗和MOQ未取得，不以商城价冒充贴片付款。

1板＋2备品需24只，买25只31.76元，旧价50.5575元，商城减少18.7975元；5板＋2备品买115只121.854元，旧价190.463元，减少68.609元。经济型规则基础库免该组换料费，较v0.9再减少20元/订单；其余24组普通扩展仍按原装配，规则额480元，不等于最终报价。其他加工费未知，不据此承诺完整订单价格。Q7 C6628419缺货未闭环，不能据本包认为可直接采购齐套。
