Rhys-Q/album/docs/design/嘉立创报价降本分析-2026-10-09.md

# 嘉立创报价降本分析（2026-10-09）

## 1. 结论及计算口径

以用户粘贴报价为基准：38组物料、104个装配件，逐行小计合计 **259.24元**。按装板数量乘报价单价计算，实际焊上板的元件约 **119.60元**；多买的起订量及备品约 **139.64元，占付款53.86%**。电容付款135.64元、普通电阻付款42.29元，是优先处理的类别。运费、贴片费和板费未包含。

报价数量按1套计算。本文以国内立创商城 `item.szlcsc.com` 的现货、人民币小量阶梯为依据，不把国际站美元价、海外代购、在途或订货算作国内现货。商城现货不等于嘉立创SMT专属库存；若后续委托SMT，还需在SMT订单核对料库及服务费。本项目当前采购意图是买回自己焊。

Chrome中用户BOM页面另显示总价247.69元及BOM优惠14元；这是实时页面另一口径，不能与附件259.24元直接混算。以下节省额统一相对附件各行小计计算，最终以重新配单为准，不叠加会员或BOM优惠。库存是查询快照，不代表锁货。

**优先改版建议：C28统一用料、R7更换厚声。** 两项合计预计省13.01元，附件基准约降到246.23元。电容、二极管的其他候选有国内现货，但电气替代还未全部通过，不能当作已获准装板的BOM。

本轮仅形成降本分析，原理图、PCB及v0.7 release未修改。

## 2. 已核实国内现货与实际付款

下表的价格来自Chrome实际商品页阶梯，未用页面最低批量价冒充小量价。采用原报价相同的备品数量比较，C28则保留合并后的1个备品。库存以页面读取为准，JSON中保留另一时刻接口快照，两者略有变化属正常。

|位号/用途|原报价付款|候选MPN、C编号及页面|国内现货/起订与倍数|本次付款及节省|电气状态|
|---|---:|---|---|---|---|
|C28，3.3V输入去耦|5×2.3489≈11.74元|沿用村田GRM32ER71H475KA88L，C86052，[商城](https://item.szlcsc.com/87228.html)|接口快照38,754个；5个一组|原4.7µF组8个，加入C28后9个，仍买10个；取消独立2.2µF组，省约11.74元|优先进入改版；2.2µF变4.7µF，1210及50V保持，布局/输入瞬态需复核|
|R7，4.3kΩ±1%0805|100×0.0612=6.12元|厚声0805W8F4301T5E，C17667，[商城](https://item.szlcsc.com/18355.html)|51,200个；100起/100倍数|100×0.0485=4.85元；省1.27元|标称阻值、精度、125mW、150V及±100ppm/℃满足对应普通电阻选型，优先替换|
|C31/C32，100µF6.3V1210|买5个，14.64元|三星CL32A107MQVNNNE，C49066，[商城](https://item.szlcsc.com/50074.html)|9,794个；1起/1倍数|同样买5个：5×1.5679≈7.84元，省6.80元；只买2个约3.14元，但无备品|优先电容候选；容量/耐压/X5R/精度相同，仍需比对3.3V偏压有效容量、ESR及启动/掉电时间|
|C105/C108/C111/C114/C117/C120，3.3µF50V1210|买10个，28.00元|火炬CC1210X7R50V335KN，C54157488，[商城](https://item.szlcsc.com/57394869.html)|1,895个；5起/5倍数|10×1.0774≈10.77元；潜在省17.23元|待验证：规格书未取得可用于该节点的偏压有效容量证据；不能直接替换六组源极储能电容|
|D3/D5/D6，串联双肖特基|买5个，3.52元|长晶BAT54S KL4，C8592，[商城](https://item.szlcsc.com/9087.html)|145,360个；20起/20倍数|20×0.1418≈2.84元；潜在省0.68元|待验证：SOT-23串联双管、30V；大电流Vf及热额定不可只凭BAT54S名称认定相同|
|D4，负偏置整流|买5个，3.68元|时科B0530W，C475611，[商城](https://item.szlcsc.com/482049.html)|2,860个；20起/20倍数|20×0.1595=3.19元；潜在省0.49元|待验证：SOD-123，30V/0.5A；需比较漏电、结电容、热条件及焊盘尺寸。页面折扣不计入基准|

若以上六项均通过电气/封装评审，按表中同备品口径，潜在合计省约 **38.21元，约降到221.03元**。这不是已验证新BOM总价。若三星100µF只买2个，会额外少付约4.70元，但同时少3个备品，不能称为纯替代收益。

### 1板、5板及备品对起订量的影响

以下是新候选自身费用；5板的旧料可能进入更低阶梯，因此没有拿1板旧单价推算5板精确节省。备品示例：三星100µF多留2个、3.3µF多留4个、BAT54S多留2个、D4多留1个。

|候选|1板无额外备品，实际需买/费用|5板无额外备品，实际需买/费用|5板加上述备品，实际需买/费用|
|---|---:|---:|---:|
|厚声R7|100 /4.85元|100 /4.85元|仍100 /4.85元|
|三星C31/C32|2 /3.14元|10 /11.58元|12 /13.89元|
|火炬六只3.3µF|10 /10.77元|30 /32.32元|35 /37.71元|
|长晶三只BAT54S|20 /2.84元|20 /2.84元|20 /2.84元|
|时科D4|20 /3.19元|20 /3.19元|20 /3.19元|

C28合并用料在1板时不增加既有4.7µF组购买数量；5板时该组从40个变45个，多买5个，仍可删除2.2µF组。具体5板节省应使用两组当日阶梯重新计算。

## 3. 为什么这些项目可以或不能改

### C28：减少独立采购组，比追求最低单价更划算

工程设计数据中C28接 `BENCH_3V3—GND`，位于U5输入端，不是CT定时电容，也不是电荷泵飞跨电容。将它改成已经采购的4.7µF/50V/1210，可以减少一组MPN。容量增加是电路调整，不是完全等值替换。

[TI TPS22917资料第11节](https://www.ti.com/lit/ds/symlink/tps22917.pdf)说明通常1µF输入电容足以抑制开通时的电压下降，较慢电源可需要更多容量。此处4.7µF是合理的改版方向；仍要确认3.3V偏压有效容量、输入端接线瞬态以及器件靠近VIN。新增容量在输入侧，不能把它误计为U5输出受CT控制的负载容量。C36的1nF C0G保持。

### C31/C32：同容量大幅降本，但不能跳过偏压检查

[三星原厂页面](https://product.samsungsem.com/mlcc/CL32A107MQVNNN.do)确认CL32A107MQVNNNE仍为量产型号，100µF±20%、6.3V、X5R、1210，尺寸3.20±0.40×2.50±0.30mm，厚2.50±0.30mm。商城当前1个起订，有国内现货。

这两只接 `EPD_3V3—GND`。替换后若有效容量不同，会影响开通浪涌和放电时间。现有三星商城PDF是通用目录，尚未完成新旧两料在3.3V下曲线对照，所以列为优先候选，而不是已经确认直接装配。也需复核2.8mm最大厚度的实物空间。

### 六组源极电容：火炬便宜，但容量标称相同不能证明等效

保持现有每组2×10µF+3.3µF的数量和标称配置，不用减少储能容量换价格。火炬候选仍是3.3µF、50V、X7R、1210，并且有1895个国内现货，但读取的规格书是扫描资料，未获得对应MPN的DC Bias曲线和完整纹波/ESR证据。需要与原村田料在对应源极电压、温度下比较有效容量，再决定能否纳入正式BOM。

22只10µF/50V组付款50.56元，是最大单项。三星CL32B106KBJNNNE C138687国内库存为0，故排除；不能拿国际站有货证明国内有货。其他浏览器列出的63V/100V候选，有的价格接近或高于原料，且容量曲线仍需核对，本轮未形成值得直接实施的10µF替换结论。高压和未知峰值节点保持50V要求。

### 分立器件：标称同名不一定有值得承担的收益

[长晶BAT54S规格书](https://datasheet.lcsc.com/datasheet/pdf/5b474f3ae31f4955b5e416442eaeaed8.pdf?productCode=C8592)列30V、连续200mA、200mW、30mA时Vf最大0.50V，100mA时最大1V。需与原Diodes BAT54S-7-F在实际泵电流条件下比较，不可换成BAT54A共阳或BAT54C共阴。原图的中点3脚映射仍需最终对照。

[时科B0530W规格书](https://datasheet.lcsc.com/datasheet/pdf/a8856f2e71ab97f1ffa2ebb2c8272eb8.pdf?productCode=C475611)列30V、0.5A、0.5A时Vf最大0.43V，30V时反向漏电最大130µA，1脚阴极、2脚阳极。当前D4是负偏置整流，热条件和漏电会影响转换与掉电。省不到1元，优先级低。

### Q7是现货要求的未闭环项

附件Q7的PJA3433_R1_00001 C6628419为 **海外代购DigiKey**，不是国内现货。前次复核没有找到可直接批准的国内现货等效替代，此次不凭¥2.65的海外价格宣称完成国内采购闭环。参见工程文档 `hardware/pcb/gdep133c02-driver/docs/Q7-替代料复核-2026-10-09.md`。保留Q7及R49调试支路；解决Q7供货须独立完成P4实际栅驱动、导通、栅电荷和耐压核对。

## 4. 全部38组的处理建议

表中付款来自附件，保留建议是本轮降本判断，不表示对新候选已通过完整硬件验收。

|位号|当前MPN/C编号|板用量/购买量|付款(元)|建议及原因|
|---|---|---:|---:|---|
|C1,C103,C104,C106,C107,C109,C110,C112,C113,C115,C116,C118,C119,C13,C15,C2,C20,C3,C4,C5,C6,C7|GRM32ER71H106KA12L / C77102|22 / 25|50.56|暂保留；三星C138687国内零库存；高压储能有效容量约束优先。|
|C105,C108,C111,C114,C117,C120|GRM32DR71H335KA88L / C397310|6 / 10|28.00|火炬C54157488现货候选；缺对应偏压容量证据，先不写入正式BOM。|
|C31,C32|GRM32ER60J107ME20L / C88154|2 / 5|14.64|三星C49066现货低价候选；补齐3.3V有效容量及启动/放电对照后替换。|
|U5|TPS22917DBVR / C2681320|1 / 5|12.24|保留TPS22917；需要反向阻断、低漏电、CT软启动与可控放电。贵在本次买5个。|
|C28|CL32B225KBJNNNE / C307587|1 / 5|11.74|优先改C28为既有C86052的4.7µF；减少一组采购，输入瞬态复核。|
|C12,C14,C16,C19,C21,C29,C30,C8|GRM32ER71H475KA88L / C86052|8 / 10|8.86|保留并评估覆盖C28；9个仍买10个。|
|Q1,Q4|DMN3065LW-7 / C150506|2 / 5|8.63|保留；SOT-323低栅压MOS，换SOT-23需改PCB，导通与栅电荷未核实。|
|U4|TCN75AVOA713 / C144313|1 / 1|7.80|保留TCN75；屏幕直接I2C访问，不能把LM75仅按封装当等效。|
|U1,U2,U3|WSL1206R2000FEA / C2073442|3 / 3|7.44|保留0.2Ω金属采样电阻；廉价厚膜不可只按阻值功率替换，需脉冲/温漂/采样走线证据。|
|Q8|DMP3068L-7 / C151010|1 / 5|6.86|保留；低栅压P沟道MOS不能用AO3401等仅凭阈值替换。|
|L1,L2,L3|PCR1040-150-M / C53896892|3 / 5|6.23|保留现有国内电感；三只买5个仅6.23元，进一步替换要重做DCR/Isat/温升核对。|
|R7|RC0805FR-074K3L / C137518|1 / 100|6.12|优先改厚声C17667；100个约4.85元，省1.27元。|
|D1,D2|MBR230S1F-7 / C151335|2 / 5|5.70|保留30V2A整流；不以廉价SS14等1A二极管替换，须验证Vf/漏电及热。|
|C26|0805B473K500NT / C1745|1 / 50|5.49|保留47nF/50V X7R；已国产0805，避免降低未知峰值节点耐压。|
|R18|0805W8F1602T5E / C17490|1 / 100|4.97|保留当前0805电阻；已是低价小额组，100个MOQ使付款高于实际装板消耗。保持阻值、±1%、功率及温漂，不退回0603或5%以省小额费用。|
|J1|TJC8-2.54-2A / C42410552|1 / 20|4.58|保持接口；20个起订导致4.58元，查MOQ1同型需核对座体和直插脚尺寸，暂无合格新料。|
|R10,R19|0805W8F220KT5E / C17521|2 / 100|4.53|保留当前0805电阻；已是低价小额组，100个MOQ使付款高于实际装板消耗。保持阻值、±1%、功率及温漂，不退回0603或5%以省小额费用。|
|C10,C11,C17,C23,C24,C9|GRM21BR71H474KA88L / C86043|6 / 10|4.35|暂保留470nF/50V；国产替代需分节点审查有效容量，现价买10个4.35元。|
|C36|0805CG102J500NT / C29925|1 / 50|4.19|保留1nF/50V C0G定时电容；50个起订是费用原因，不换X7R。|
|Q6|MMBT3904-7-F / C94514|1 / 10|3.92|暂保留；CJ C20526国内库存0；新品牌还要热额定和hFE比较，小量收益很小。|
|Q3|MMBT3906-7-F / C82762|1 / 10|3.73|暂保留；低价品牌应比较hFE、VCE(sat)、热额定，MOQ后未形成批准候选。|
|D4|B0530W-7-F / C124188|1 / 5|3.68|时科C475611现货候选；需核对漏电/结电容/热条件，省0.49元优先级低。|
|R11,R30,R35,R36,R44,R45,R46,R47,R48|0805W8F1003T5E / C149504|9 / 100|3.61|保留当前0805电阻；已是低价小额组，100个MOQ使付款高于实际装板消耗。保持阻值、±1%、功率及温漂，不退回0603或5%以省小额费用。|
|D3,D5,D6|BAT54S-7-F / C83574|3 / 5|3.52|长晶C8592现货候选；需核对双管连接/Vf/热条件，省0.68元优先级低。|
|R8|RC0805FR-07110KL / C137599|1 / 100|3.40|保留当前0805电阻；已是低价小额组，100个MOQ使付款高于实际装板消耗。保持阻值、±1%、功率及温漂，不退回0603或5%以省小额费用。|
|R17,R50|0805W8F2003T5E / C17539|2 / 100|3.40|保留当前0805电阻；已是低价小额组，100个MOQ使付款高于实际装板消耗。保持阻值、±1%、功率及温漂，不退回0603或5%以省小额费用。|
|C18|GRM21BR71H224KA01L / C86042|1 / 5|3.38|暂保留220nF/50V；飞跨/高压节点不降低耐压，MOQ5付款3.38元。|
|R49|RC0805JR-070RL / C96345|1 / 100|3.25|保留当前0805电阻；已是低价小额组，100个MOQ使付款高于实际装板消耗。保持阻值、±1%、功率及温漂，不退回0603或5%以省小额费用。|
|R20,R21|0805W8F4701T5E / C17673|2 / 100|3.06|保留当前0805电阻；已是低价小额组，100个MOQ使付款高于实际装板消耗。保持阻值、±1%、功率及温漂，不退回0603或5%以省小额费用。|
|R39,R40,R41,R42,R43|0805W8F330JT5E / C17634|5 / 100|2.85|保留当前0805电阻；已是低价小额组，100个MOQ使付款高于实际装板消耗。保持阻值、±1%、功率及温漂，不退回0603或5%以省小额费用。|
|Q7|PJA3433_R1_00001 / C6628419|1 / 1|2.65|海外代购，不满足国内现货；暂无已验证可直接替代料。|
|R13,R2,R3|0805W8F1004T5E / C17514|3 / 100|2.64|保留当前0805电阻；已是低价小额组，100个MOQ使付款高于实际装板消耗。保持阻值、±1%、功率及温漂，不退回0603或5%以省小额费用。|
|C22,C25|GRM21BR71H105KA12L / C77083|2 / 10|2.59|暂保留1µF/50V；不是高额单项，替代须检查偏压容量。|
|FPC1|FPC-05FB-60PH20 / C2856839|1 / 1|2.45|保留可插拔FPC；MOQ1、2.45元，不能改变接触面、60脚及0.5mm间距。|
|R1|0805W8F2001T5E / C17604|1 / 100|2.34|保留当前0805电阻；已是低价小额组，100个MOQ使付款高于实际装板消耗。保持阻值、±1%、功率及温漂，不退回0603或5%以省小额费用。|
|R12|0805W8F1501T5E / C4310|1 / 100|2.12|保留当前0805电阻；已是低价小额组，100个MOQ使付款高于实际装板消耗。保持阻值、±1%、功率及温漂，不退回0603或5%以省小额费用。|
|J2|SH-PZ254V-2x8P / C55629829|1 / 5|1.88|保留2.54mm直插排针；5个仅1.88元，收益有限。|
|C27,C33|CL21B104KBCNNNC / C1711|2 / 20|1.84|保留三星100nF/50V0805；买20个仅1.84元。|

## 5. 落地顺序与数据缺口

1. 优先以C28合并用料和R7为改版范围，预计省约13.01元。原理图属性和采购清单需一起更新，C28容量变化要留设计记录；改版之后才生成新release。
2. 若希望进一步降本，优先完成三星100µF的3.3V容量对照，再验证火炬3.3µF的六个工作节点。分别潜在省6.80元、17.23元，但资料缺口不能通过“库存充足”替代。
3. BAT54S、B0530W虽有国内现货，MOQ后的收益合计约1.17元，可晚于电容评审。报价中的廉价国产电阻可用多板共享剩余数量，不为了本板消耗几分而整包换品牌。
4. 当前国内现货目标仍受Q7海外代购影响；它需要独立设计验证，不能包含在“全部国内现货已闭环”的结论中。
5. 提交最终新BOM之前按实际套数重新配单；5板通常能摊薄MOQ，但不会让只需5个却需买100个的电阻消耗完。不要用最低批量阶梯价估算小量订单。

资料：附件报价逐行计算；国内商城商品页及Chrome实际人民币阶梯；三星和TI原厂资料；分立器件厂家PDF由立创托管。查询记录见同目录JSON；未采信国际站库存替代国内库存。实际CAD/电气/实板验证尚未执行，本报告不是制造放行文件。

## 6. 补充复核：10µF/50V的低价国内现货候选

应用户进一步要求，扩大精确型号检索后找到以下两款；本节更新前文“暂未形成值得实施的10µF替换结论”的采购候选范围，电气放行状态仍为待验证。查询日期2026-10-09，人民币价格来自Chrome实际国内商城页面。

|型号及C编号|标称规格|国内现货|起订/购买倍数|本次购买及费用|相对附件50.56元的节省|
|---|---|---:|---:|---:|---:|
|三环 TCC1210X7R106K500MT / C50767259，[商城](https://item.szlcsc.com/53406434.html)|10µF、50V、X7R、±10%、1210|18,400|5/5|25×1.1741=29.35元|约21.21元（42%）|
|风华 1210B106K500NT / C116808，[商城](https://item.szlcsc.com/118063.html)|10µF、50V、X7R、±10%、1210|13,772|2/2|26×1.3487=35.07元|约15.49元；比原多1个备品|

三环优先级更高。1板用22个，按原来3个备品买25个，5个阶梯单价1.1741元；5板用110个，无备品时110×0.9257=101.83元，另留3个备品需买115个约106.46元。风华1板无备品买22个约29.67元，保留至少3个备品需买26个；不能在不同备品数量之间直接宣称纯单价收益。

三环[厂家承认书](https://datasheet.lcsc.com/datasheet/pdf/71a9f8eccc4da164324d4a716182c5e3.pdf?productCode=C50767259)是通用系列DRAAW108N/0，共56页。已核对命名：106=10µF、K=±10%、500=50V、M=2.50mm厚、T=小盘编带，1210=3.20×2.50mm；X7R温度范围-55~125℃、温变±15%。末尾M代表厚度，不能误读为容量±20%。仍未取得这个具体型号的工作偏压有效容量、阻抗/ESR/纹波曲线，故不直接写入正式BOM。

当前22只分布于六组源极储能、VDDP/VDDN、VBB和VCC等节点。即使标称相同，工作电压下容量也可能不同；六组源极各两只10µF特别需要验证，不能用仅低压节点的验证覆盖所有22只。若完成曲线比较和必要实测，保持原容量、数量及50V要求即可评估三环替换；若资料不足，保留原村田。风华候选也需同样检查，不因品牌知名而自动视为偏压等效。

火炬C17702791国内仅5个，不足本板22只，而且±20%，排除本次整组采购；三星C138687仍为国内零库存。没有为降本改用X5R/Y5V或25V元件。本次未修改CAD和release。
