Rhys-Q/album/docs/design/缺价14组其他渠道采购核查.md

# 缺价14组：其他渠道采购核查

> 核查日期：2026-10-08。基准为v0.5-linkfix正式BOM。公开网页和检索索引存在更新延迟，价格、库存和交期为快照；未创建订单、发送询价或修改正式工程。

## 1. 结果

**14组均已逐项处理：11组有精确原型号公开报价，3组有明确替代候选和报价。不能据此宣称已经全部现货闭环。** 当前共有35/38组原型号有报价，另3组需要采购替代方案。电感库存有冲突；跨境费用和得捷人民币订单门槛仍影响实际付款。

PJA3433已找到原型号，无需为了买料先改P4 MOS；3.3µF原型号在得捷有库存快照，暂时无需改成4.7µF。C26原型号停产、C28原型号无价无库存、R17精确400k原型号缺可靠小量报价，按下述候选处理。

## 2. 14组购买来源与一板数量

单价采用实际数量档位，列出的付款只包含货值。人民币和美元分别记录，美元不是立创国内报价。大部分得捷项目可选剪切带CT，勿选另收卷盘费的Digi-Reel。

| 原型号 / 位号 | 推荐采购型号、渠道与链接 | 需求→购买 | 单价 / 货值 | 库存与处理状态 |
|---|---|---:|---:|---|
| WSL1206R2000FEA<br>U1,U2,U3 | [WSL1206R2000FEA](https://www.digikey.com/en/products/detail/vishay-dale/WSL1206R2000FEA/712503)<br>DigiKey | 3→3 | USD 0.74 / USD 2.22 | 公开网页报价；下单复核；快照库存47228 |
| MSS1246-153MLC<br>L1,L2,L3 | [MSS1246-153MLC](https://br.mouser.com/en/ProductDetail/Coilcraft/MSS1246-153MLC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)<br>Mouser | 3→3 | USD 2.14 / USD 6.42 | 有价但库存冲突；不足3只，未闭环；快照库存1 |
| C0805C102J5GACTU<br>C36 | [C0805C102J5GACTU](https://www.digikey.cn/zh/products/detail/kemet/C0805C102J5GACTU/411135)<br>DigiKey | 1→1 | ¥1.41 / ¥1.41 | 公开网页报价；下单复核；快照库存303043 |
| RC0603FR-072R2L<br>R10,R19 | [RC0603FR-072R2L](https://www.digikey.com/en/products/detail/yageo/RC0603FR-072R2L/2827592)<br>DigiKey | 2→2 | USD 0.1 / USD 0.20 | 公开网页报价；下单复核；快照库存24831 |
| GRM32ER71H225KA88L<br>C28 | [CL32B225KBJNNNE](https://www.digikey.com/en/products/detail/samsung-electro-mechanics/CL32B225KBJNNNE/3890970)<br>DigiKey；替代候选 | 1→1 | USD 0.44 / USD 0.44 | 原件未解决；候选库存166612，待工程核验 |
| GRM32DR71H335KA88L<br>C105,C108,C111,C114,C117,C120 | [GRM32DR71H335KA88L](https://www.digikey.com/en/products/detail/murata-electronics/GRM32DR71H335KA88L/702649)<br>DigiKey | 6→6 | USD 1.29 / USD 7.74 | 公开网页报价；下单复核；快照库存1380；NRND |
| RC0603FR-0733RL<br>R39,R40,R41,R42,R43 | [RC0603FR-0733RL](https://www.digikey.cn/zh/products/detail/yageo/RC0603FR-0733RL/727158)<br>DigiKey | 5→10 | ¥0.207 / ¥2.07 | 公开网页报价；下单复核；快照库存1055411 |
| TSW-102-07-G-S<br>J1 | [TSW-102-07-G-S](https://www.digikey.cn/zh/products/detail/samtec-inc/TSW-102-07-G-S/1101325)<br>DigiKey | 1→1 | ¥1.74 / ¥1.74 | 公开网页报价；下单复核；快照库存23704 |
| RC0603FR-07400KL<br>R17 | [RT0603BRD07402KL](https://www.digikey.com/en/products/detail/yageo/RT0603BRD07402KL/5927949)<br>DigiKey；替代候选 | 1→1 | USD 0.1 / USD 0.10 | 原件未解决；候选库存1907，待工程核验 |
| GRM188R71H473KA61D<br>C26 | [CL10B473KB8NNNC](https://item.szlcsc.com/1974.html)<br>立创；替代候选 | 1→100 | ¥0.0357 / ¥3.57 | 原件未解决；候选库存401300，待工程核验 |
| B0530W-7-F<br>D4 | [B0530W-7-F](https://www.digikey.cn/zh/products/detail/diodes-incorporated/B0530W-7-F/815315)<br>DigiKey | 1→1 | ¥2.23 / ¥2.23 | 公开网页报价；下单复核；快照库存38934 |
| TSW-108-07-G-D<br>J2 | [TSW-108-07-G-D](https://www.digikey.cn/zh/products/detail/samtec-inc/TSW-108-07-G-D/1101269)<br>DigiKey | 1→1 | ¥11.99 / ¥11.99 | 厂方供货2096；本地库存快照冲突；快照库存0；厂方2096只/约2周 |
| MBR230S1F-7<br>D1,D2 | [MBR230S1F-7](https://www.digikey.cn/zh/products/detail/diodes-incorporated/MBR230S1F-7/4948462)<br>DigiKey | 2→2 | ¥4.88 / ¥9.76 | 公开网页报价；下单复核；快照库存1806 |
| PJA3433_R1_00001<br>Q7 | [PJA3433_R1_00001](https://www.digikey.cn/zh/products/detail/panjit-international-inc/PJA3433-R1-00001/14661637)<br>DigiKey | 1→1 | ¥2.65 / ¥2.65 | 公开网页报价；下单复核；快照库存9001 |

33Ω原件买5只按1+档付款¥4.15；跨到10+档只需¥2.07。CSV已选择多买5只的更低付款方案。其他行同样比较需求数量和已知价格门槛，不把数量最少误认为付款最少。库存足够前提下方可采用。

## 3. 三个替代候选的工程判断

### C26：47nF电容

原GRM188R71H473KA61D在[得捷原型号页](https://www.digikey.com/en/products/detail/murata-electronics/GRM188R71H473KA61D/702551)标为Obsolete。沿用既有候选[CL10B473KB8NNNC](https://item.szlcsc.com/1974.html)，0603、47nF、50V、X7R、±10%，立创MOQ100/倍数100，100+¥0.0357，付款¥3.57。标称参数由[三星原厂](https://product.samsungsem.com/mlcc/CL10B473KB8NNN.do)支持。封装尺寸、实际偏压下有效容量仍须核验，停产原件无价格，不计算相对原件的节省。

### C28：2.2µF输入去耦

[唯样原件页](https://www.oneyac.com/product/245271.html)库存0、无价格，MOQ2000，不适合首板少量采购。推荐核验三星CL32B225KBJNNNE；[原厂资料](https://product.samsungsem.com/mlcc/CL32B225KBJNNN.do)给出1210、2.2µF、50V、X7R、±10%，本体3.2×2.5mm、厚2.5±0.2mm。得捷单件报价见上表，选取较新的3890970快照，其他同型号缓存1+USD0.34，未混用较低价格。

当前C28跨BENCH_3V3—GND，位于TPS22917输入侧，实际直流偏压为3.3V。保留50V采购规格便于同封装核验，仍需确认3.3V下有效容量、焊盘与高度空间；此处并非50V高压储能支路。替换无须改变电路拓扑，但工程MPN/品牌和release必须在批准实施时同步。

### R17：400kΩ反馈电阻

原RC0603FR-07400KL未找到可靠的小量可下单报价。[Walsin WR06X4003FTL](https://www.lcsc.com/product-detail/C7152196.html)标称400kΩ/1%/0603，但库存0；[Meritek CR164003F](https://www.ic-components.pl/products/Meritek/CR164003F.jsp)有经销商参考价和库存宣称，缺可核实的有效订单/小量条件，不能将其当成已闭环现货。

可核验[RT0603BRD07402KL](https://www.digikey.com/en/products/detail/yageo/RT0603BRD07402KL/5927949)：402kΩ±0.1%、0603、0.1W、75V、±25ppm/℃，剪切带1件起订。型号B、D及0603规格由[Yageo原厂RT数据手册](https://yageogroup.com/content/datasheet/asset/file/PYU-RT_1-TO-0-01_ROHS_L)支持。

- 原400kΩ±1%的室温阻值范围：396.000～404.000kΩ。
- 候选402kΩ±0.1%的室温范围：401.598～402.402kΩ，落在原范围内。
- 标称阻值增加0.5%，不能把402kΩ当成同一标称型号；402kΩ±1%的上界406.020kΩ则超出原范围，不能混买。

R17跨VGL—FBN，R18为FBN—REG_VGN的16kΩ。基尔霍夫关系给出：VVGL=VFBN+(R17/R18)×(VFBN−VREG_VGN)。比例由25变25.125，相对于同一VFBN的负压幅度变化+0.5%，实际VVGL还取决于两个内部参考电位。室温电阻范围匹配是有用的候选依据，但不代替反馈目标、参考误差、全温漂移和实测VGL审核。保持75V/0.1W并检查支路实际电压、功耗；正式实施时记录400k→402k设计变更。

## 4. 电感供货问题不能忽略

[贸泽精确原件的美元报价](https://br.mouser.com/en/ProductDetail/Coilcraft/MSS1246-153MLC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)为1+USD2.14、10+USD1.82、25+USD1.68，MOQ/倍数1，剪切带可买。该页库存1只，无法覆盖首板3只；[澳洲页面](https://au.mouser.com/en/ProductDetail/Coilcraft/MSS1246-153MLC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)缓存203只，两者不是独立仓库数量，不能相加。[法国页](https://www.mouser.fr/fr/ProductDetail/Coilcraft/MSS1246-153MLC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)列200只预计2026-11-30、厂期13周，属于预计时间。

[Coilcraft原厂](https://www.coilcraft.com/en-us/products/power/shielded-inductors/ferrite-drum/mss-mos/mss1246/mss1246-153/)给出1+USD2.28，却同时显示所选配置不可购买，因此不能据此保证现货。[Farnell系列页](https://uk.farnell.com/c/passive-components/inductors/power-inductors/smd-power-inductors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)精确型号1+GBP2.28、5+GBP2.11、10+GBP1.94，但未取得可确认库存和中国下单条件。均为备用路径。

结论：原电感的价格缺口已补上，即刻供货缺口仍在。第一板优先保留原电感，可接受确认后的订货交期；不因库存问题直接采用SMMS1050等不同封装方案。应获得能覆盖3/5/15/17只的实际分配数量和预计发货日；未完成前不称现货全套闭环。

## 5. 全38组条件性货值预算

以下使用原35组报价，并假设C26/C28/R17三项候选通过工程核验，电感允许订货。它覆盖103个装配件，不包含其他降本候选，**只是完整组数的条件性货值估算，尚不是可直接付款的订单总额**。按国内/美元两种币种分列，未擅自用固定汇率换算。

| 场景 | 人民币货值小计 | 美元货值小计 |
|---|---:|---:|
| 1板无备品 | ¥195.58 | USD 17.12 |
| 1板含备品 | ¥249.70 | USD 24.82 |
| 5板无备品 | ¥536.20 | USD 62.28 |
| 5板含备品 | ¥649.54 | USD 69.13 |

含备品按每个SMT型号额外2件、J1/J2/FPC1各额外1件，针对整个批次。CSV记录最小起订量、购买倍数、各档价和四种采购数量。每行付款舍入后相加，和上一版未舍入小计可能差几分钱。

人民币小计包含立创与得捷两家，不能合在一起判断某家的订单门槛。美元小计包含得捷及贸泽；这些国际站报价不保证中国收货时的相同税费和运费。暂未确认的送料费、关税、汇兑费、订单凑单增加额都未计入。

### 得捷订单条件

[得捷人民币服务说明](https://www.digikey.cn/zh/help/features)列最小订购金额人民币300元、订单免运费、人民币价格/发票含税；[配送说明](https://www.digikey.cn/zh/help-support/delivery-information)列DDP和通常7～10工作日。商品MOQ1只是元器件行的起订量，不能理解成¥1～¥20的小额人民币订单已可结账。官网横幅同时使用“免运费最低订购金额”措辞，实际是否允许低于300元并另付运费需结账或官方确认；预算按可能存在300元最低订单限制处理。

不要为少数小件盲目凑到300元。可以与本项目确有需求的其他元器件合单，或以MOQ更合适的本地渠道集中采购，但要重新查每件价格。只凑单则整单最低付款/新增余料必须计入；将既有立创元件移到得捷也不能沿用立创单价。Marketplace从合作伙伴发货，税费/运费规则与得捷自营不同。

### 3.3µF更低价的备用渠道

[Unikey公开原型号页](https://www.unikeyic.com/products/ceramic-capacitors/grm32dr71h335ka88l/7160520.html)列库存977、MOQ5/倍数5、批次2536+，5+USD0.4013、50+USD0.3203。一板6只需买10只，货值USD4.013，相比本表得捷6只USD7.74低；五板30只买30只，货值USD12.039，相比得捷USD25.20低。但它增加一个经销商订单，运费、实际批次及原装来源未核实，未将其替换为主预算。

## 6. 现在还差什么才可下完整订单

原型号路线剩下C26停产、C28无现货报价、R17精确400k缺可核实小量订单三项采购障碍。候选路线已有对应具体MPN、规格和报价，接下来需要核验三项候选、确认电感足量交期，以及取得覆盖中国收货/订单门槛/税运的可结账金额。PJA3433、两个排针的跨页面库存也须在同一时间复核。

所有采购候选未写入KiCad或正式release。若实施R17/C28/C26变更，同步原理图参数与品牌/MPN、必要的PCB封装/模型、BOM，按项目约定做ERC/DRC及工程打开检查，再重新release。此文档不冒充已经完成这些步骤。
