Rhys-Q/album/hardware/pcb/gdep133c02-driver/docs/E06基础库替代复查-2026-10-11.md

# E06：0.2Ω电流采样电阻基础库替代复查

查询日期：2026-10-11。对象：U1、U2、U3，当前 WSL1206R2000FEA / C2073442。

本轮结论：尚未确认同时满足国内基础库、SMT现货和本电路电气要求的替代。找到串联候选线索，不能把“未完成核实”写成“基础库不存在”。本次不修改原理图、PCB或已验收的v0.11 release。

## 候选与证据

| 候选 | 参数与路径 | 库类别证据 | 结论 |
|---|---|---|---|
| C25335，1206W4F200LT5E | 厚声，1206，0.2Ω±1%，0.25W，厚膜，±800ppm/℃ | 海外JLCPCB页面为Extended；国内类别本次未取得 | 未满足国内基础库证据；温漂明显变大，不批准直替 |
| C25334，1206W4F100LT5E | 厚声，1206，0.1Ω±1%，0.25W，厚膜，±800ppm/℃；每支路两只串联合成0.2Ω | 海外JLCPCB页面明确Basic；国内基础库类别和SMT库存未确认 | 可研究的设计调整线索；不是已经合格的替代 |
| C136988，RL1206FR-7W0R2L | 国巨，1206，0.2Ω±1%，0.5W，厚膜，±600ppm/℃ | LCSC商品参数；国内基础库证据和当前SMT库存未取得 | 功率提高不能抵消温漂及脉冲证据缺口 |
| C42460613，MFCR1206FR200QHR | RESI，1206，0.2Ω金属采样，既有审核记录1W、±50ppm/℃ | 2026-10-11既有国内快照为SMT扩展库；库存为历史记录 | 可作扩展库降采购价候选，但不是免换料费方案；重复脉冲等效仍待评审 |

## 两只0.1Ω串联为什么还不能直接批准

- 标称总阻值0.2Ω，最坏情况公差仍为±1%；三路共6只，比当前增加3只。
- 理想相同散热条件下总额定功率为0.5W；每只耗散 I_RMS²×0.1Ω。不能把两只相加的额定值当成已经验证的PCB散热能力。
- 串联不改善温漂：两只同规格仍按±800ppm/℃界限考虑。温升50℃时线性估算阻值变化上限约4%，当前±75ppm/℃对应约0.375%。这是比较算例，不是已测温升或已知允许误差。
- 还需取得重复脉冲/过载、寄生电感资料，结合真实RESE门限、峰值和RMS波形评估；采样应从整串外侧两端引出，并重新检查布线与焊点压降。
- 不能因温漂更大就断言不能工作，也不能在允许误差未知时断言等效。当前归类为“找到候选，国内供货及电气验证待完成”。

## 本轮访问限制

国内嘉立创搜索页返回网站校验，立创搜索页也未返回商品结果；公开详情接口返回403。电脑控制工具两次初始化超时，无法使用现有Chrome登录会话。未绕过网站校验，未将海外Basic标签冒充国内基础库证据。当前国内库存、MOQ、人民币价格未知，不引用海外库存/美元价格填充。

## 来源

- [C25334海外JLCPCB：Basic及参数](https://jlcpcb.com/partdetail/26077-1206W4F100LT5E/C25334)
- [C25334 LCSC商品页](https://www.lcsc.com/product-detail/C25334.html)
- [C25335海外JLCPCB：Extended及参数](https://jlcpcb.com/partdetail/26078-1206W4F200LT5E/C25335)
- [C136988 LCSC商品页](https://www.lcsc.com/product-detail/C136988.html)
- [现用WSL原厂规格书](https://www.vishay.com/docs/30100/wsl.pdf)
- C42460613国内历史快照：`../reports/basic-library-recheck-2026-10-11/products.json`；不代表本次实时查询。
