Rhys-Q/album/hardware/pcb/gdep133c02-driver/reports/gui-observation-v011.md

# v0.11 原生 KiCad GUI 观察记录

使用cua_repl实际打开工程管理器及PCB编辑器（KiCad10.0.6）。F8从原理图更新PCB：未启用按位号重链接；启用替换封装及更新符号字段。第一轮显示新增组合元件的sheetname/元数据更新（并非新增实体元件）。点击“更新PCB”，窗口确认“变更已应用于PCB”，随后关闭预览、Cmd+S保存，再次F8。

第二轮关闭“信息”过滤，只显示“错误/警告/操作”：整个列表只有下面两个机械焊盘提示，没有任何操作。错误计数0，警告计数2。FPC1的61/62是两个机械固定焊盘，无原理图电气引脚；它们仍为net0，没有新增规则忽略。第二轮没有重复新增封装，也没有待执行变更。原生保存报告对话框的Save按钮不可用，尝试后取消；本次文本报告是CUA截图内容的人工转录，**不是原生导出的全量日志**。不把第一轮截断内容伪造成完整日志。

实际界面观察：

- 根据参考位号重新链接=0
- 替换原有封装=1
- 更新符号字段=1
- 第二轮错误=0，警告=2，操作过滤启用，操作列表空
- 警告：找不到元件FPC1的焊盘62的网络（引脚62不存在于符号中）
- 警告：找不到元件FPC1的焊盘61的网络（引脚61不存在于符号中）

磁盘验证：C121等新增封装的sheetname由未带斜线改为/Basic-library composite additions/，且原生增加pintype等字段，证实应用和保存确已完成；封装位号/UUID/路径没有重复。保存后ZONE_FILLER重新填充/保存的源文件SHA256完全不变。原理图通过原生F8载入并生成工程网表，未单独打开原理图编辑器窗口；原理图PDF另经KiCad CLI导出检查。

电脑随后锁屏，不再继续GUI操作；以上更新和保存验证在锁屏前完成。ERC/DRC/未连接/一致性最终结果另见相应JSON及制造包verification.json；硬件性能未验证。
