Rhys-Q/album/hardware/pcb/gdep133c02-driver/docs/三组电阻免换料费改版-v0.9.md

# v0.9：仅三组电阻免换料费改版

2026-10-10，用户明确授权“先将三组电阻更换，更换后重新release”。本版从v0.8出发，仅实施3组/5个位号，不实施候选方案中的混合装配。37组、104件保持；102个顶面SMT及J1/J2两个人工插件保持。

|位号|v0.8|v0.9|库身份|
|---|---|---|---|
|R10/R19|0805W8D220KT5E C407467|0805W8F220KT5E C17521|基础库，免换料费|
|R17/R50|TC0550F2003T5G C2989258|0805W8F2003T5E C17539|基础库，免换料费|
|R7|CR0805F4K30P05Z C881377|0805W8F4301T5E C17667|扩展库明确免换料费的优选合作料|

3组均为厚声0805，焊盘、引脚、阻值和数量保持。R10/R19容差0.5%恢复参考1%；R17/R50温漂50恢复100ppm/℃，400kΩ总静态误差最坏±1%，与16k下臂比值初始约±2.02%；50℃温差独立最坏比值温漂约1%（原0.75%）。这些是明确取舍，不宣称性能更好。R7保留1%/125mW/150V/100ppm，与原件额定匹配。

原厂规格存档sources/v09-review/Uniroyal-General.pdf；按[厚声原厂](https://www.uni-royal.cn/en/images/userfile/file/1668661899c56505e6d9ab55c7.pdf)核对。原生符号及PCB同步MPN、品牌、C号、资料、库类别、免费证据、查询时间及装配决定；所有UUID保持。布局/走线/焊盘/网络/板框保持，报告cost-change-geometry-v09.json记录结构核对。

SMT网站直接核验时间2026-10-10北京时间21:18—21:27：C17521库存281124，C17539库存652598，C17667库存102438。直接公共阶梯和库身份见reports/v09-review/smt-search.json及采购清单。库存会变化，下单重核。

[嘉立创经济型规则](https://m.jlc.com/portal/q2i38538.html)下三组普通扩展转免换料费，减少60元/订单。原v0.8按28组规则额560元；本版仍25组普通扩展，规则额500元，含缺货Q7一组，因此不是可执行完整订单报价。1板公开SMT只数理论价差-0.028元，5板+0.009元；不含损耗、最小订单、其他加工费，不能直接承诺与旧615元报价相比总费减少多少。此前“仅两组收费40元”的混合装配建议没有实施。

Q7 C6628419商城/SMT0库存；其余25组例外保留现料，未授权的缩封装、功率降额和电容替代不实施。SMT MOQ/损耗、部分商城价格缺口留空。完整采购尚未闭环；CAD通过不代表屏幕实板已验证。输入瞬态、温升、显示、FPC配接与安全掉电仍待焊后测试。

CAD发布验收：ERC、DRC、未连接、原理图与PCB一致性0；KiCad实际打开、原理图更新PCB应用保存后再次预览无新增/待执行；制造文件、BOM/CPL位号坐标及来源哈希核对。实际结果见发布包verification.json与reports/validation-status.json；失败保留旧release。
