Rhys-Q/album/hardware/pcb/gdep133c02-driver/docs/免换料费候选审核-v0.9.md

> 后续决定：2026-10-10用户仅授权三组电阻替换并重新release；其余25组例外保持原型号和原装配方式。当前实施见[三组电阻改版](三组电阻免换料费改版-v0.9.md)。以下为此前候选评审快照，混合装配建议尚未实施。

# v0.9 免换料费优先：候选审核与例外决定

2026-10-10，阶段：**候选评审，未冻结、未发布**。当前正式工程及唯一 release 仍为 v0.8：37组、104件装配件，102顶面SMD＋2直插。原生CAD、design-data与v0.8发布来源哈希一致。本轮没有修改正式型号、焊盘或装配分配；后续ERC/DRC、实际KiCad更新验证与制造导出在例外决定后执行。

你要求“先提交完整候选表和例外清单，逐项选择后再冻结正式选型”。本阶段交付37组审核、104件逐位号候选、806行检索候选与25项例外，铜测试点/安装孔不采购。检索明细是线索库，不能上传作生产BOM。

## 免费身份与供货证据

[嘉立创官方经济型规则](https://m.jlc.com/portal/q2i38538.html)：基础库及SMT优选合作免换料费，普通扩展库20元/型号/订单；标准型规则不同。费用按型号组、订单收，不是每只或每块板收。

全部35组原SMD已在国内SMT搜索页按准确C号/型号核实库身份，另外核实7组候选。查询窗口为2026-10-10北京时间21:17—21:28；42条直接页面证据、人民币阶梯和SMT库存保存在reports/v09-review/smt-search.json。基础库和“扩展库（免换料费）”分别识别；详情页可能不显示优选免费，因此用搜索结果中的明确免换料费文字判断。商城8%补贴不等于免换料费，商城库存不等于SMT库存。

查询806条国内商品记录，20条候选网络/解析失败明确保留；全部37组原料查询成功。替代接口每组最多返回99条，并按允许封装筛选，不宣称穷尽全库。原厂资料、商城库存/时间/MOQ/购买倍数与SMT库存/时间/阶梯分别记录；SMT下单MOQ、损耗、备品交付和其他加工费用未取得，留空。

原v0.8有7组基础库。下列三组建议后为**9组基础库＋1组明确免费优选合作，共10组、27件**。另外25组仍为普通扩展例外；J1/J2是人工插件，不计SMT换料费。

Q1/Q4 C150506直接SMT库存7392只，商城接口未返回SMT库存不能判断缺货；包装后缀-13候选库存均0，保留原型号即可。**Q7 C6628419商城和SMT库存均0**。自焊也不会解决这个供货缺口，不能宣布完整采购闭环。

## 三组建议替换（尚未实施）

|位号|v0.8型号/C号|建议型号/C号|直接SMT库存|依据与取舍|
|---|---|---|---:|---|
|R10、R19|0805W8D220KT5E / C407467|0805W8F220KT5E / C17521|281124|2.2Ω/0805/125mW/150V/200ppm保持，容差0.5%恢复原参考1%，基础库免费|
|R17、R50|TC0550F2003T5G / C2989258|0805W8F2003T5E / C17539|652598|两只200kΩ/0805/1%/125mW/150V保持，温漂50恢复100ppm，基础库免费|
|R7|CR0805F4K30P05Z / C881377|0805W8F4301T5E / C17667|102438|4.3kΩ/0805/1%/125mW/150V/100ppm匹配，扩展库明确免换料费，无需缩0603|

[厚声原厂普通电阻规格](https://www.uni-royal.cn/en/images/userfile/file/1668661899c56505e6d9ab55c7.pdf)已存档sources/v09-review/Uniroyal-General.pdf。相同焊盘可以保留；正式实施时仍需核对原理图属性、PCB属性和来源一致性。

R17/R50的400kΩ总静态误差最坏±1%，与16kΩ下臂比值初始最坏约±2.02%；上下臂独立最坏温漂约200ppm/℃（v0.8约150ppm），50℃温差额外约1%（v0.8约0.75%）。这是恢复原参考方案的取舍，不宣称性能更好。R10/R19的脉冲波形仍需焊后确认。

同经济型条件下，三组普通扩展转免费，换料费规则减少**60元/订单**。按公开SMT只数阶梯，三组元件理论价差如下，不包含损耗、MOQ和平台费用：

|数量|候选相对原料的元件价差|换料费减少|理论净节省|
|---|---:|---:|---:|
|1板＋每组0备品|-0.0280元|60元|60.0280元|
|1板＋每组2备品|-0.0198元|60元|60.0198元|
|5板＋每组0备品|+0.0090元|60元|59.9910元|
|5板＋每组2备品|+0.0470元|60元|59.9530元|

## 37组逐项结论

|序号|位号|原C号|建议C号|直接库身份|SMT库存|例外/状态|
|---:|---|---|---|---|---:|---|
|1|C13,C15,C20,C1,C103,C104,C2,C106,C107,C3,C109,C110,C4,C112,C113,C5,C115,C116,C6,C118,C119,C7|C77102|C77102|扩展库|37069|E01|
|2|U4|C144313|C144313|扩展库|534|E02|
|3|C105,C108,C111,C114,C117,C120|C397310|C397310|扩展库|3073|E03|
|4|C31,C32|C88154|C88154|扩展库|19155|E04|
|5|C28,C29,C30,C12,C14,C19,C16,C21,C8|C86052|C86052|扩展库|45538|E05|
|6|U1,U2,U3|C2073442|C2073442|扩展库|2094|E06|
|7|U5|C2681320|C2681320|扩展库|23889|E07|
|8|Q7|C6628419|C6628419|扩展库|0|E08|
|9|Q1,Q4|C150506|C150506|扩展库|7392|E09|
|10|Q8|C151010|C151010|扩展库|23089|E10|
|11|D1,D2|C151335|C151335|扩展库|41298|E11|
|12|C26|C1745|C1745|扩展库|59065|E12|
|13|C17,C23,C24,C9,C10,C11|C86043|C86043|扩展库|8699|E13|
|14|C36|C29925|C29925|扩展库|154204|E14|
|15|Q6|C94514|C94514|扩展库|265330|E15|
|16|Q3|C82762|C82762|扩展库|37890|E16|
|17|D4|C124188|C124188|扩展库|10761|E17|
|18|R30,R11,R35,R36,R44,R45,R46,R47,R48|C149504|C149504|基础库 (免换料费)|3923011|基础库；免换料费候选，保留|
|19|C18|C86042|C86042|扩展库|8454|E18|
|20|R20,R21|C17673|C17673|基础库 (免换料费)|4704531|基础库；免换料费候选，保留|
|21|R39,R40,R41,R42,R43|C17634|C17634|基础库 (免换料费)|1516041|基础库；免换料费候选，保留|
|22|R49|C17477|C17477|基础库 (免换料费)|6466409|基础库；免换料费候选，保留|
|23|R2,R3,R13|C17514|C17514|基础库 (免换料费)|2325315|基础库；免换料费候选，保留|
|24|C22,C25|C77083|C77083|扩展库|109368|E19|
|25|R1|C17604|C17604|基础库 (免换料费)|5275955|基础库；免换料费候选，保留|
|26|R18|C2774511|C2774511|扩展库|400|E20|
|27|R12|C4310|C4310|基础库 (免换料费)|670095|基础库；免换料费候选，保留|
|28|C33,C27|C1711|C1711|扩展库|855525|E21|
|29|R8|C5140228|C5140228|扩展库|1260|E22|
|30|R7|C881377|C17667|扩展库 (免换料费)|102438|优选合作；明确免换料费，建议同0805替换|
|31|D3,D5,D6|C19726|C19726|扩展库|163060|E23|
|32|R17,R50|C2989258|C17539|基础库 (免换料费)|652598|基础库；免换料费候选，建议恢复原料|
|33|R10,R19|C407467|C17521|基础库 (免换料费)|281124|基础库；免换料费候选，建议恢复原料|
|34|J1|C42410552|C42410552|人工插件|2577|人工插件；不计SMT换料费|
|35|L1,L2,L3|C53896892|C53896892|扩展库|414|E24|
|36|J2|C55629829|C55629829|人工插件|500|人工插件；不计SMT换料费|
|37|FPC1|C2856839|C2856839|扩展库|7645|E25|

## 未批准候选与电气边界

- R8：0805 C17422仍收费；0603 C25805明确免费、库存239411。110kΩ/1%/100mW/75V/100ppm；按VGH=50V审查包络，上臂约21.05mW/48.12V，125℃降额约35mW。还需明确实际温度、瞬态边界及缩封装布局，暂不批准。50V是审查包络，不是允许实板输出。
- R18：0805 C17490明确免费、库存286873，但333mW降125mW。它跨FBN与REG_VGN，故障/瞬态峰值未闭环，保留HP料。0603 C4210进一步降100mW，不能直接采用。
- C27/C33：三星C28233基础库100nF/100V/X7R/0805是候选；[三星原厂](https://product.samsungsem.com/mlcc/CL21B104KCFNNN.do)额定和尺寸已确认，3.3V偏压/阻抗对照缺失，暂保留原件。C13967基础库470nF/50V还缺飞跨电容偏压、ESR、纹波证据。
- C36：C1636为0603、1nF/50V/C0G/5%，仍普通扩展库收费，缩封装不能免换料费。原厂风华通用规格已存档，保持现0805。
- 六组源极储能每组2×10µF＋3.3µF保持；高压/未知峰值节点50V不降低。大电容、电感、采样、MOS、二极管和IC未证实的候选不进入正式BOM。Q7候选SI2303 C545575、BSS308PE C5337195、DMP31D0U C5224069均有低栅压/栅电荷/热能力缺口，不能以现货或免费标签代替电气批准。

完整逐项候选、原厂资料、拒绝理由见候选CSV与例外清单。当前保留件是已设计所需，不能为了免换料费全部删掉。

## 装配与成本选择

1. 候选替换后全部机器贴：25组普通扩展，按经济型规则换料费**500元/订单**，其中Q7一组缺货，无法执行完整方案。原v0.8为28组，规则额560元；与旧报价560元数值相同不证明订单条件一致，其他加工费未知，不能据此承诺总价。
2. 建议混合装配：10组免费27件＋FPC1＋Q1/Q4机器贴，共30件；其余72件SMD及J1/J2共74件人工装配。FPC细间距、Q1/Q4 SOT-323较难自焊，两收费组规则额**40元/订单**。这是逐项建议，尚未得到你的决定；Q7仍须解决来源。
3. 最低换料费：仅10组免费27件机器贴，其余77件人工，规则换料费0元，但FPC/小MOS手焊风险、工具和时间成本更高，且Q7仍缺货。

[采购加工成本场景](采购加工成本-v0.9.csv)列出1板、5板，0与每组总计2件备品。SMT元件金额按公开“只”阶梯计算，仅理论额，未把商城整包MOQ套入机器贴报价；手工采购按商城MOQ和购买倍数向上取整。无库存Q7不计入可执行采购小计。价格缺口、库存缺口分别列出，完整总费用留空。运费、工程/钢网/焊盘/插件、SMT损耗、起贴条件、优惠及人工成本未报价。

## 逐项决定后实施

[25项例外清单](例外清单-v0.9.md)每项附必要性、候选拒绝原因、价格/库存、自焊难度和建议。请按E编号选择机器贴、自焊或补证后调整设计；也可确认清单中的逐项建议。Q7应单独选择保留原件机器贴/自焊，或继续审查替代；保留原件可完成CAD发布，但缺货必须明确记录，完整采购仍未闭环。未决定项保持v0.8。

决定后更新KiCad原生属性和装配字段，保留UUID，同步PCB并调整必要封装布局布线，输出完整/机器/手工三份BOM与机器件CPL；ERC/DRC/未连接/原理图—PCB一致性均为0，实际KiCad两次更新预览无新增/待执行，再核对哈希发布v0.9。失败保留v0.8。显示、瞬态、温升、FPC配接、安全掉电另列焊后验收。

## 文件

- [37组审核与1/5板费用](候选审核-v0.9.csv)
- [104件逐位号候选](逐位号候选对照-v0.9.csv)
- [806行检索候选](检索候选明细-v0.9.csv)
- [可填写逐项决定表](例外决定-v0.9.csv)
- 来源快照：reports/v09-review；review-status.json包含保持v0.8的CAD哈希与未发布状态。
