Rhys-Q/album/hardware/pcb/gdep133c02-driver/docs/国内采购与手焊改版-v0.8.md

# v0.8 当前选型入口

基线为v0.7；按38组采购总价审查后实施6组电阻、1组二极管以及C28合并，共12位号。详见[降本审核](降本审核-v0.8.md)、[采购清单](采购清单-v0.8.csv)、[逐位号对照](逐位号替换对照-v0.8.csv)。所有型号的当前真源为原生原理图与design-data.json，焊后性能未验收。
