Rhys-Q/album/hardware/pcb/gdep133c02-driver/docs/国内采购与手焊改版-v0.7.md

> 本版在v0.6基础上仅更换L1–L3、C28、C36；其余既有改版说明保留。新旧逐位号表以v0.6为对照基准。新三组证据见三组现货替代-v0.7.md；原v0.6资料仍位于sources/v06。

# v0.7 国内采购与手焊改版审查

日期：2026-10-09。KiCad 10.0.6。当前正式工程为本目录上一层；100×80mm、四层、安装孔和接口位置保持。104个装配件（102个顶面SMT、2个直插），铜测试点和安装孔不计采购数量。逐位号对照见 `逐位号替换对照-v0.7.csv`；本版采购需求见 `采购清单-v0.7.csv`。

## 本次采用的替换

普通电阻采用厚声/国巨0805、1/8W、±1%；阻值保持，使用本地手焊焊盘，焊盘中心±1.0mm、尺寸1.2×1.4mm。R49仍为0805零欧调试隔离。0.2Ω金属采样电阻U1/U2/U3保留Vishay WSL1206R2000FEA：采购替代未取得完整脉冲曲线、TCR与金属电阻结构对照，不能用普通厚膜0.2Ω替代。

R17由400kΩ改200kΩ，新增R50为200kΩ；VGL→R50→VGL_FB_MID→R17→FBN，R18仍16kΩ。串联总阻值396–404kΩ，与原400kΩ±1%相同。两只电阻各±100ppm/℃时，总阻值温漂是阻值加权平均，最坏仍100ppm/℃，不能按独立随机误差开平方缩小。R18计入后，(1+R上/R下)范围24.505–25.505，约±2%；这是分压比误差，不是屏幕实际输出电压的完整精度，尚需考虑内部基准、反馈输入电流和控制器温漂。

C27/C33采用三星CL21B104KBCNNNC，100nF/50V/X7R/±10%，由0603放大0805；两个节点工作在3.3V域。C26采用风华0805B473K500NT，47nF/50V/X7R/±10%，封装扩大0805。50V要求不降低；C26所在P6负电荷泵PUMP_N_LOW节点的工作偏压容量、纹波及尖峰仍需实测，通用系列资料没有提供本型号完整直流偏压曲线。不能据标称47nF声称工作时一定保有47nF。

Q1/Q4仍为DMN3065LW-7（SOT-323），焊盘仅向外延长0.4mm，内侧边缘、0.65mm引脚排列和脚序保持；使用原封装模型。SOT-23候选DMN3053L虽有更低2.5V栅压导通电阻，但Qg由5.5增至7.3nC、Ciss由465增至676pF，屏幕GDR驱动能力未明确，暂不采用。Q7保留PJA3433_R1_00001及R49，不改变P4拓扑。

J1采用DLL TJC8-2.54-2A，2.54mm、0.64mm方针、3A，孔径改1.05mm对应原厂1.02mm建议孔；位置、方向和脚序保持。3D模型为几何参考，须以原厂尺寸/实物为准。J2候选BOOMELE 2.54-2*8P(C68234)库存较多，但其链接PDF实际为2.54-1xN单排图，不能证明双排本体尺寸；该候选未采用。继续核查XKB C706898，其D30商品链接的PDF却标为D75（尾针7.5mm），也未采用。最终J2采用首韩SH-PZ254V-2x8P（C55629829），原厂图明确2×8、20.32×5.0mm本体、2.54mm双排间距、0.64mm方针、总长11.5±0.25mm、尾针3±0.2mm、3A；孔径改1.05mm，位置及脚序保持。

## 保留件及替换边界

L1–L3改用JIERR PCR1040-150-M，15µH±20%、DCR最大50mΩ，饱和7A按降感30%定义、温升6.5A按40℃定义；原型号相同判据分别5.5A/3.8A。原厂推荐焊盘已重建，磁芯损耗、温度下饱和和实际波形仍需焊后测试；本轮不提供实板性能签核。

C9/C10/C11和C17/C23/C24仍为Murata 470nF/50V，前三只位于供电相关节点，后三只是电荷泵飞跨电容；三星候选CL21B474KBFNNNE仅取得通用目录，未取得偏压有效容量/脉冲纹波的同条件比较，未采用。其余高压MLCC均保留50V原型号。六组源极电容每组仍为3×10µF+3.3µF=33.3µF标称；数量没有减少。原件工作偏压后的有效容量也尚无完整验收记录，保留原件不是完成性能验证。

C31/C32为3.3V域100µF/6.3V原件，不在高压/飞跨节点；仍保留。C36 CT电容改为风华0805CG102J500NT，1nF/50V/C0G/±5%，不能用X7R替代以免启动斜率漂移。

D1/D2保留30V/2A Schottky MBR230S1F-7（SOD-123F）；D4保留30V/0.5A B0530W-7-F（SOD-123）；D3/D5/D6保留BAT54S-7-F（SOT-23串联双管）。BAT54S的内部串联方式及中点脚不可换成BAT54A/C。普通二极管或相同电流但不同反向漏电/结电容器件没有做动态等效证明。

Q3/Q6为MMBT3906/3904的PNP/NPN，Q8为DMP3068L-7 PMOS，均已有SOT-23；引脚与极性保持。U4 SOIC-8 TCN75A温度接口和U5 SOT-23-6 TPS22917保持。FPC1保持可插拔FPC-05FB-60PH20及现有接触方向，必须在装配前用屏幕排线确认1脚与接点朝向。

## 采购费用口径和资料缺口

CSV覆盖所有实际装配型号，分别给出1板/5板、无备品/每组多2只的需求、国内MOQ进位后的采购量和可确认费用。库存不是预留量。新选型的国内库存、MOQ和购买倍数来自2026-10-09立创产品页面数据；LCSC国际接口有美元梯度报价，但不是国内人民币结账价。保留件使用2026-10-08上一轮报价，日期明确列出。费用空白表示未取得有效报价，不能按零元计算；CNY和USD不相加，不含未确认运费/税费。国内页最低价格往往是大批阶梯价，未用其乘MOQ冒充小量付款。

国内电阻通常100只起买，1板和5板付款可能相同；适合购买小包同规格0805备料，但无准确品牌/MPN的淘宝散料不得用于升压采样、MOS、飞跨电容和FPC。采购本轮尚未达到所有型号的国内小量付款闭环；缺价/缺图/偏压资料已经明确列出，禁止用候选替代已验证型号而不复核。

## 布局布线与验收边界

保留三组升压功率器件位置、采样器件和屏幕接口；本轮扩大被动件焊盘后重布冲突线路、移动R50与TP26，并重排顶面位号。In1.Cu仍为完整GND参考层，重新填充铜区。新增分压中点仅接R17/R50，没有额外负载。原符号UUID保持，R50使用新UUID与位号；工程检查同时核对原理图字段、网络、PCB焊盘及层级链接。

ERC/DRC/未连接/原理图与PCB一致性均按KiCad原生检查，禁止忽略违规。命令行通过与GUI“从原理图更新PCB”预览分别记录，实际状态见reports/validation-status.json、reports/gui-open.json和release verification.json。CAD合格不等同于实板性能合格：电源瞬态、采样Kelvin误差、温升、VCOM/电荷泵纹波、显示和安全掉电需焊后测试。

## 本版装配型号逐组审查索引

|位号|型号|封装|决定及原因|
|---|---|---|---|
|J1|TJC8-2.54-2A|Connector_PinHeader_2.54mm__PinHeader_1x02_P2.54mm_Vertical|国内2.54mm直插排针，3A，孔距及脚序不变。|
|C28|CL32B225KBJNNNE|Capacitor_SMD__C_1210_3225Metric|3.3V输入去耦；同为2.2µF/50V、X7R、±10%、1210。|
|U5|TPS22917DBVR|Package_TO_SOT_SMD__SOT-23-6|保留原型号/封装；本轮逐项复核，关键动态参数未有充分替代证据。|
|R30,R11,R35,R36,R44,R45,R46,R47,R48|0805W8F1003T5E|R_0805_HandSolder|同阻值±1%常用0805；手焊加长焊盘。|
|C29,C30,C12,C14,C19,C16,C21,C8|GRM32ER71H475KA88L|Capacitor_SMD__C_1210_3225Metric|保留原型号/封装；本轮逐项复核，关键动态参数未有充分替代证据。|
|C31,C32|GRM32ER60J107ME20L|Capacitor_SMD__C_1210_3225Metric|保留原型号/封装；本轮逐项复核，关键动态参数未有充分替代证据。|
|C33,C27|CL21B104KBCNNNC|C_0805_HandSolder|100nF/50V X7R±10%；0603增大为0805。|
|L1,L2,L3|PCR1040-150-M|L_JIERR_PCR1040|采用国内现货型号，按原厂推荐焊盘重建；动态性能待实测。|
|Q1,Q4|DMN3065LW-7|SOT323_HandSolder|保留DMN3065LW；SOT23候选Qg更高，改为同封装外伸焊盘。|
|Q8|DMP3068L-7|Package_TO_SOT_SMD__SOT-23|保留原型号/封装；本轮逐项复核，关键动态参数未有充分替代证据。|
|Q7|PJA3433_R1_00001|Package_TO_SOT_SMD__SOT-23|保留原型号/封装；本轮逐项复核，关键动态参数未有充分替代证据。|
|U1,U2,U3|WSL1206R2000FEA|Resistor_SMD__R_1206_3216Metric|保留原型号/封装；本轮逐项复核，关键动态参数未有充分替代证据。|
|R2,R3,R13|0805W8F1004T5E|R_0805_HandSolder|同阻值±1%常用0805；手焊加长焊盘。|
|D1,D2|MBR230S1F-7|Diode_SMD__D_SOD-123F|保留原型号/封装；本轮逐项复核，关键动态参数未有充分替代证据。|
|D4|B0530W-7-F|Diode_SMD__D_SOD-123|保留原型号/封装；本轮逐项复核，关键动态参数未有充分替代证据。|
|C13,C15,C20,C1,C103,C104,C2,C106,C107,C3,C109,C110,C4,C112,C113,C5,C115,C116,C6,C118,C119,C7|GRM32ER71H106KA12L|Capacitor_SMD__C_1210_3225Metric|保留原型号/封装；本轮逐项复核，关键动态参数未有充分替代证据。|
|Q3|MMBT3906-7-F|Package_TO_SOT_SMD__SOT-23|保留原型号/封装；本轮逐项复核，关键动态参数未有充分替代证据。|
|R12|0805W8F1501T5E|R_0805_HandSolder|同阻值±1%常用0805；手焊加长焊盘。|
|D3,D5,D6|BAT54S-7-F|Package_TO_SOT_SMD__SOT-23|保留原型号/封装；本轮逐项复核，关键动态参数未有充分替代证据。|
|C17,C23,C24,C9,C10,C11|GRM21BR71H474KA88L|Capacitor_SMD__C_0805_2012Metric|保留原型号/封装；本轮逐项复核，关键动态参数未有充分替代证据。|
|C18|GRM21BR71H224KA01L|Capacitor_SMD__C_0805_2012Metric|保留原型号/封装；本轮逐项复核，关键动态参数未有充分替代证据。|
|R7|RC0805FR-074K3L|R_0805_HandSolder|同阻值±1%常用0805；手焊加长焊盘。|
|R8|RC0805FR-07110KL|R_0805_HandSolder|同阻值±1%常用0805；手焊加长焊盘。|
|R10,R19|0805W8F220KT5E|R_0805_HandSolder|同阻值±1%常用0805；手焊加长焊盘。|
|Q6|MMBT3904-7-F|Package_TO_SOT_SMD__SOT-23|保留原型号/封装；本轮逐项复核，关键动态参数未有充分替代证据。|
|C22,C25|GRM21BR71H105KA12L|Capacitor_SMD__C_0805_2012Metric|保留原型号/封装；本轮逐项复核，关键动态参数未有充分替代证据。|
|C26|0805B473K500NT|C_0805_HandSolder|47nF/50V X7R±10%；风华0805，保留耐压，动态波形待实测。|
|R17,R50|0805W8F2003T5E|R_0805_HandSolder|同阻值±1%常用0805；手焊加长焊盘。|
|R18|0805W8F1602T5E|R_0805_HandSolder|同阻值±1%常用0805；手焊加长焊盘。|
|U4|TCN75AVOA713|Package_SO__SOIC-8_3.9x4.9mm_P1.27mm|保留原型号/封装；本轮逐项复核，关键动态参数未有充分替代证据。|
|R20,R21|0805W8F4701T5E|R_0805_HandSolder|同阻值±1%常用0805；手焊加长焊盘。|
|R1|0805W8F2001T5E|R_0805_HandSolder|同阻值±1%常用0805；手焊加长焊盘。|
|C105,C108,C111,C114,C117,C120|GRM32DR71H335KA88L|Capacitor_SMD__C_1210_3225Metric|保留原型号/封装；本轮逐项复核，关键动态参数未有充分替代证据。|
|R39,R40,R41,R42,R43|0805W8F330JT5E|R_0805_HandSolder|同阻值±1%常用0805；手焊加长焊盘。|
|J2|SH-PZ254V-2x8P|Connector_PinHeader_2.54mm__PinHeader_2x08_P2.54mm_Vertical|首韩2×8直插排针；原厂图20.32×5.0mm、2.54mm双排、0.64mm方针、3A；孔径1.05mm。|
|FPC1|FPC-05FB-60PH20|FPC_05FB_60PH20|保留原型号/封装；本轮逐项复核，关键动态参数未有充分替代证据。|
|C36|0805CG102J500NT|Capacitor_SMD__C_0805_2012Metric|风华1nF/50V/C0G/±5%，封装及网络保持。|
|R49|RC0805JR-070RL|Resistor_SMD__R_0805_2012Metric|保留原型号/封装；本轮逐项复核，关键动态参数未有充分替代证据。|

资料：新候选原厂文件保存在sources/v07，确切原厂URL、立创号、国内产品URL均见采购CSV；未采用的候选PDF仍保留作为拒绝替换的证据。
