Rhys-Q/album/hardware/pcb/gdep133c02-driver/reports/preview/schematic-panel.png

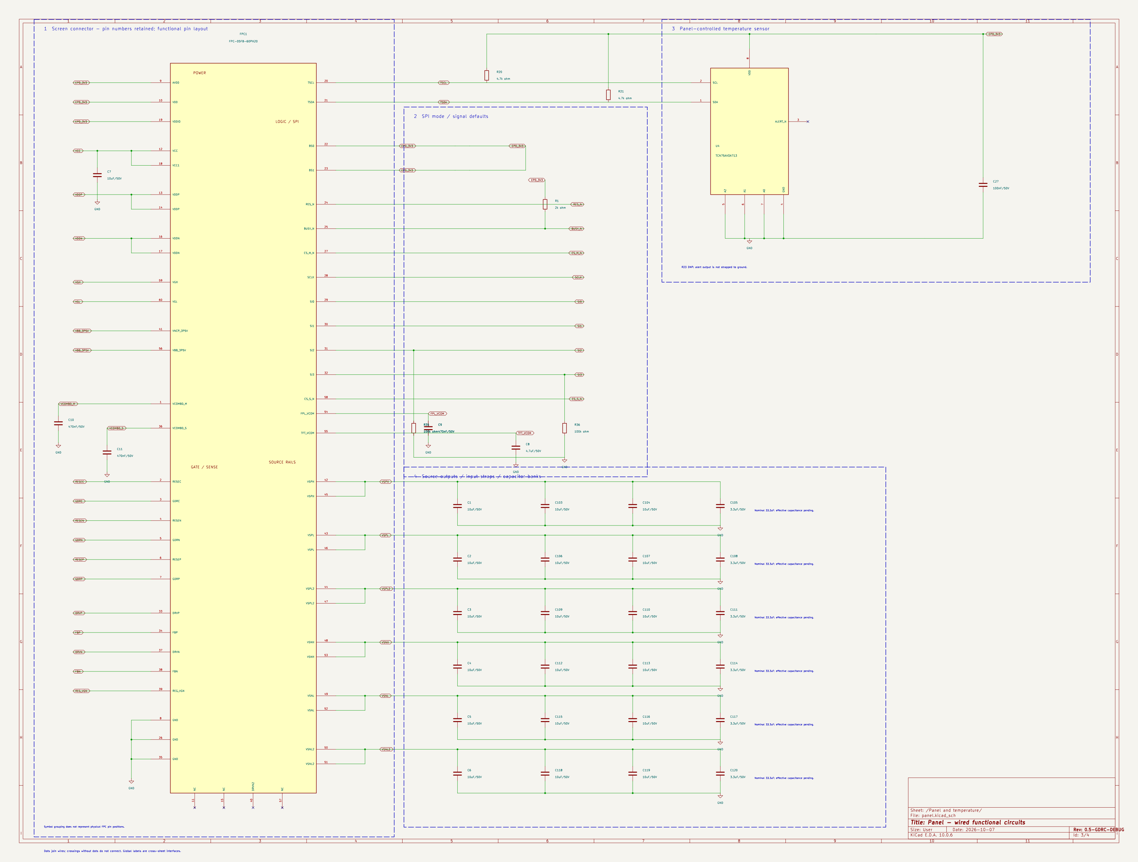
hardware/pcb/gdep133c02-driver/reports/preview/schematic-panel.png
