Rhys-Q/album/hardware/pcb/gdep133c02-driver/reports/preview/schematic-power.png

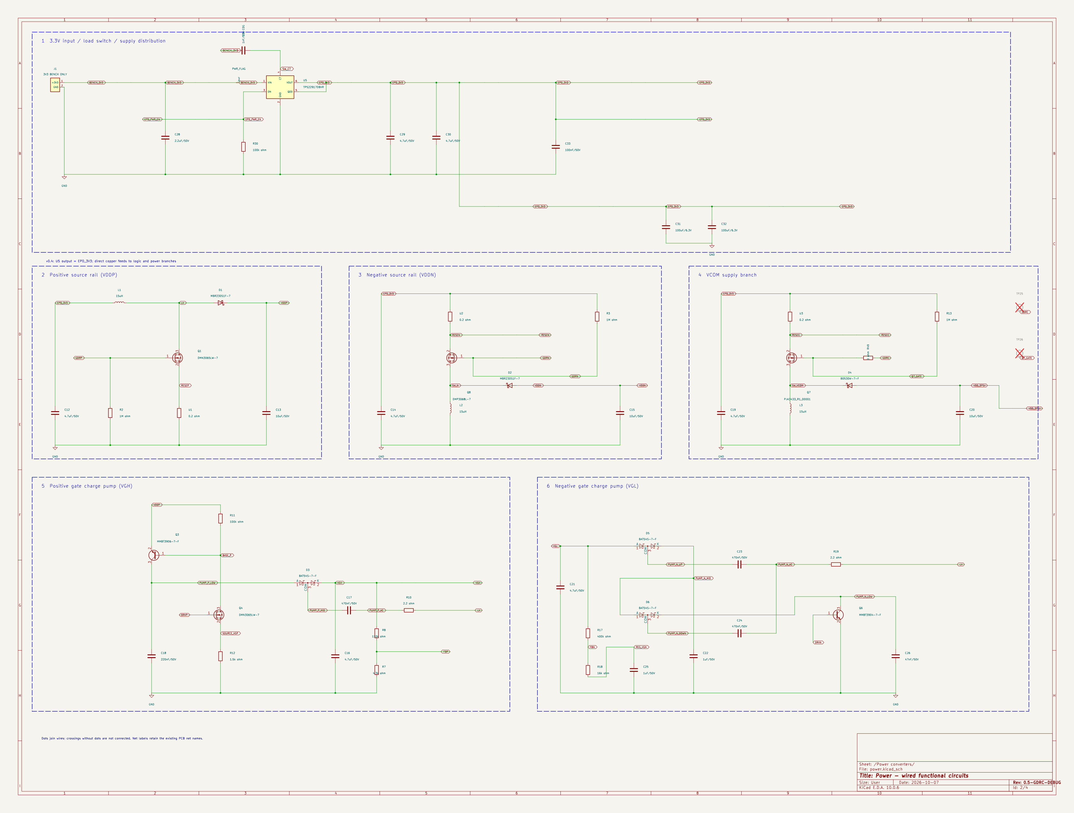
hardware/pcb/gdep133c02-driver/reports/preview/schematic-power.png
