Rhys-Q/album/hardware/pcb/gdep133c02-driver/docs/例外清单-v0.9.md

# 历史v0.9例外清单

当前17组原型替换见[基础库17组改版-v0.11.md](基础库17组改版-v0.11.md)和[当前决定清单](17组决定及剩余例外-v0.11.csv)。下文保留原审核记录，不能作为当前BOM。

> 当前v0.10：用户指定E01全部22只改为村田C440198 / GRM21BR61H106KE43L、0805、X5R、10µF/50V。六组各3×10µF+3.3µF，数量保持；85℃上限，偏压容量等效未验证。见[E01改版](E01改版-v0.10.md)。以下历史说明涉及E01时以当前改版为准。

> 后续决定：2026-10-10用户仅授权三组电阻替换并重新release；其余25组例外保持原型号和原装配方式。当前实施见[三组电阻改版](三组电阻免换料费改版-v0.9.md)。以下为此前候选评审快照，混合装配建议尚未实施。

# v0.9 例外清单：25组逐项装配决定

2026-10-10，待用户决定，正式CAD/release仍v0.8。全部以下原型号SMT搜索页为普通扩展库，经济型公开换料费20元/组/订单；Q7库存0不可执行。标价与库存会变化，下单需重核。

推荐FPC1、Q1/Q4机器贴，其余现料自焊；Q7独立解决供货。每个例外保持原型号，未审替代不能通过选择“调整”直接变为合格。J1/J2是人工插件，不在以下收费例外中。

SMT金额是公开只数阶梯理论额，不含损耗/MOQ；商城金额按MOQ/倍数，未含运费。Q7商城金额仅无库存价格参考，不能付款采购。库存和查询时间/链接/完整阶梯见候选CSV。

|编号|位号|推荐|机器贴换料费/单|
|---|---|---|---:|
|E01|C13,C15,C20,C1,C103,C104,C2,C106,C107,C3,C109,C110,C4,C112,C113,C5,C115,C116,C6,C118,C119,C7|原料自焊|20元|
|E02|U4|原料自焊|20元|
|E03|C105,C108,C111,C114,C117,C120|原料自焊|20元|
|E04|C31,C32|原料自焊|20元|
|E05|C28,C29,C30,C12,C14,C19,C16,C21,C8|原料自焊|20元|
|E06|U1,U2,U3|原料自焊|20元|
|E07|U5|原料自焊|20元|
|E08|Q7|保留原件，装配方式待选；供货另补|不可执行；有货后20元|
|E09|Q1,Q4|机器贴|20元|
|E10|Q8|原料自焊|20元|
|E11|D1,D2|原料自焊|20元|
|E12|C26|原料自焊|20元|
|E13|C17,C23,C24,C9,C10,C11|原料自焊|20元|
|E14|C36|原料自焊|20元|
|E15|Q6|原料自焊|20元|
|E16|Q3|原料自焊|20元|
|E17|D4|原料自焊|20元|
|E18|C18|原料自焊|20元|
|E19|C22,C25|原料自焊|20元|
|E20|R18|原料自焊|20元|
|E21|C33,C27|原料自焊|20元|
|E22|R8|原料自焊|20元|
|E23|D3,D5,D6|原料自焊|20元|
|E24|L1,L2,L3|原料自焊|20元|
|E25|FPC1|机器贴|20元|

## E01：C13,C15,C20,C1,C103,C104,C2,C106,C107,C3,C109,C110,C4,C112,C113,C5,C115,C116,C6,C118,C119,C7 — GRM32ER71H106KA12L / C77102

- 必要性：必须；保持该组数量/功能，本轮不通过删件降费。用途/节点：C13:VDDP,GND；C15:VDDN,GND；C20:VBB_3P5V,GND；C1:VSPH,GND；C103:VSPH,GND；C104:VSPH,GND；C2:VSPL,GND；C106:VSPL,GND；C107:VSPL,GND；C3:VSPL2,GND；C109:VSPL2,GND；C110:VSPL2,GND；C4:VSNH,GND；C112:VSNH,GND；C113:VSNH,GND；C5:VSNL,GND；C115:VSNL,GND；C116:VSNL,GND；C6:VSNL2,GND；C118:VSNL2,GND；C119:VSNL2,GND；C7:VCC,GND。
- 替代审核：三环C50767259等标称10µF/50V/1210；未获六组源极及各输出实际偏压容量、ESR和纹波证据，不通过减少容量或降耐压节省费用。
- 已查候选：C50767259。详细型号/封装/原厂资料见检索明细；检索候选未全面批准。
- 原料商城/SMT库存：0 / 37069只；查询时库存满足1/5板＋备品；订单时须重核。
- 商城1板＋2备品：50.5575元；5板＋2备品：190.463元。
- SMT1板＋2备品理论元件费：48.5352元；5板＋2备品：185.472元。普通扩展机器贴20元/组/订单，其他加工费未知。
- 自焊难度：低：0805/1210两端器件。
- 推荐：优先保留原料自焊，以免该组换料费；自焊工具/时间成本未报价。
- 你的决定：**待定**（机器贴 / 自焊 / 补证后调整设计）。Q7供货另行决定。

## E02：U4 — TCN75AVOA713 / C144313

- 必要性：必须；保持该组数量/功能，本轮不通过删件降费。用途/节点：U4:TSDA,TSCL,GND,GND,GND,GND,EPD_3V3。
- 替代审核：TCN75A温度传感器需I2C地址/寄存器、分辨率、精度和固件兼容；TMP75/LM75不能只按同SOIC8判定。未获合格免费替代。
- 已查候选：C636980,C28085,C30389。详细型号/封装/原厂资料见检索明细；检索候选未全面批准。
- 原料商城/SMT库存：436 / 534只；查询时库存满足1/5板＋备品；订单时须重核。
- 商城1板＋2备品：23.4元；5板＋2备品：54.6元。
- SMT1板＋2备品理论元件费：23.4元；5板＋2备品：54.6元。普通扩展机器贴20元/组/订单，其他加工费未知。
- 自焊难度：中：三脚/SOIC，核对极性脚序。
- 推荐：优先保留原料自焊，以免该组换料费；自焊工具/时间成本未报价。
- 你的决定：**待定**（机器贴 / 自焊 / 补证后调整设计）。Q7供货另行决定。

## E03：C105,C108,C111,C114,C117,C120 — GRM32DR71H335KA88L / C397310

- 必要性：必须；保持该组数量/功能，本轮不通过删件降费。用途/节点：C105:VSPH,GND；C108:VSPL,GND；C111:VSPL2,GND；C114:VSNH,GND；C117:VSNL,GND；C120:VSNL2,GND。
- 替代审核：信昌C1021610等3.3µF/50V候选缺工作偏压/ESR对照；六组每组2×10µF+3.3µF配置保持。
- 已查候选：C1021610。详细型号/封装/原厂资料见检索明细；检索候选未全面批准。
- 原料商城/SMT库存：3015 / 3073只；查询时库存满足1/5板＋备品；订单时须重核。
- 商城1板＋2备品：21.357元；5板＋2备品：74.7495元。
- SMT1板＋2备品理论元件费：17.088元；5板＋2备品：68.352元。普通扩展机器贴20元/组/订单，其他加工费未知。
- 自焊难度：低：0805/1210两端器件。
- 推荐：优先保留原料自焊，以免该组换料费；自焊工具/时间成本未报价。
- 你的决定：**待定**（机器贴 / 自焊 / 补证后调整设计）。Q7供货另行决定。

## E04：C31,C32 — GRM32ER60J107ME20L / C88154

- 必要性：必须；保持该组数量/功能，本轮不通过删件降费。用途/节点：C31:EPD_3V3,GND；C32:EPD_3V3,GND。
- 替代审核：三星C49066等100µF/6.3V候选缺3.3V有效容量及输入开关瞬态/ESR对照；不以同标称容量直接通过。
- 已查候选：C49066。详细型号/封装/原厂资料见检索明细；检索候选未全面批准。
- 原料商城/SMT库存：19155 / 19155只；查询时库存满足1/5板＋备品；订单时须重核。
- 商城1板＋2备品：14.641元；5板＋2备品：43.923元。
- SMT1板＋2备品理论元件费：11.712元；5板＋2备品：35.136元。普通扩展机器贴20元/组/订单，其他加工费未知。
- 自焊难度：低：0805/1210两端器件。
- 推荐：优先保留原料自焊，以免该组换料费；自焊工具/时间成本未报价。
- 你的决定：**待定**（机器贴 / 自焊 / 补证后调整设计）。Q7供货另行决定。

## E05：C28,C29,C30,C12,C14,C19,C16,C21,C8 — GRM32ER71H475KA88L / C86052

- 必要性：必须；保持该组数量/功能，本轮不通过删件降费。用途/节点：C28:BENCH_3V3,GND；C29:EPD_3V3,GND；C30:EPD_3V3,GND；C12:EPD_3V3,GND；C14:EPD_3V3,GND；C19:EPD_3V3,GND；C16:VGH,GND；C21:VGL,GND；C8:TFT_VCOM,GND。
- 替代审核：4.7µF/50V输出储能与输入去耦组；便宜同容值料缺偏压/ESR证据。C28在上游的增容已在v0.8评审，本轮不重复改变电路。
- 已查候选：C381466,C33546021,C2840282,C6120035,C49451356。详细型号/封装/原厂资料见检索明细；检索候选未全面批准。
- 原料商城/SMT库存：37790 / 45538只；查询时库存满足1/5板＋备品；订单时须重核。
- 商城1板＋2备品：13.2885元；5板＋2备品：36.615元。
- SMT1板＋2备品理论元件费：9.746元；5板＋2备品：41.642元。普通扩展机器贴20元/组/订单，其他加工费未知。
- 自焊难度：低：0805/1210两端器件。
- 推荐：优先保留原料自焊，以免该组换料费；自焊工具/时间成本未报价。
- 你的决定：**待定**（机器贴 / 自焊 / 补证后调整设计）。Q7供货另行决定。

## E06：U1,U2,U3 — WSL1206R2000FEA / C2073442

- 必要性：必须；保持该组数量/功能，本轮不通过删件降费。用途/节点：U1:RESEP,GND；U2:EPD_3V3,RESEN；U3:EPD_3V3,RESEC。
- 替代审核：0.2Ω金属采样电阻需脉冲能量、温漂、Kelvin采样与尺寸匹配；C42460613等1W标称不能证明实际脉冲优于WSL。保留现料。
- 已查候选：C42460613。详细型号/封装/原厂资料见检索明细；检索候选未全面批准。
- 原料商城/SMT库存：2094 / 2094只；查询时库存满足1/5板＋备品；订单时须重核。
- 商城1板＋2备品：12.4元；5板＋2备品：32.81元。
- SMT1板＋2备品理论元件费：12.4元；5板＋2备品：32.81元。普通扩展机器贴20元/组/订单，其他加工费未知。
- 自焊难度：低：0805/1210两端器件。
- 推荐：优先保留原料自焊，以免该组换料费；自焊工具/时间成本未报价。
- 你的决定：**待定**（机器贴 / 自焊 / 补证后调整设计）。Q7供货另行决定。

## E07：U5 — TPS22917DBVR / C2681320

- 必要性：必须；保持该组数量/功能，本轮不通过删件降费。用途/节点：U5:BENCH_3V3,GND,EPD_PWR_EN,SW_CT,EPD_3V3,EPD_3V3。
- 替代审核：MX22917T23 C5359093的Ron约240mΩ，原TPS约80mΩ；CT、QOD、反灌、静态电流与热/瞬态未完成对照。不取消安全掉电功能。
- 已查候选：C5359093。详细型号/封装/原厂资料见检索明细；检索候选未全面批准。
- 原料商城/SMT库存：21355 / 23889只；查询时库存满足1/5板＋备品；订单时须重核。
- 商城1板＋2备品：12.2405元；5板＋2备品：24.481元。
- SMT1板＋2备品理论元件费：7.344元；5板＋2备品：17.136元。普通扩展机器贴20元/组/订单，其他加工费未知。
- 自焊难度：中：三脚/SOIC，核对极性脚序。
- 推荐：优先保留原料自焊，以免该组换料费；自焊工具/时间成本未报价。
- 你的决定：**待定**（机器贴 / 自焊 / 补证后调整设计）。Q7供货另行决定。

## E08：Q7 — PJA3433_R1_00001 / C6628419

- 必要性：必须；保持该组数量/功能，本轮不通过删件降费。用途/节点：Q7:Q7_GATE,RESEC,SW_VCOM。
- 替代审核：Q7国内商城与SMT库存均0。先前SI2303 C545575、BSS308PE-HXY C5337195及DMP31D0U C5224069的低栅压导通、Qg/驱动或热能力未通过；供应链缺口独立存在，自焊也不会自动解决缺货。保持R49调试支路。
- 已查候选：C545575,C5337195,C5224069,C6357487。详细型号/封装/原厂资料见检索明细；检索候选未全面批准。
- 原料商城/SMT库存：0 / 0只；否：Q7商城/SMT均0库存。
- 商城1板＋2备品：9.7605元；5板＋2备品：19.521元。
- SMT1板＋2备品理论元件费：未知/缺货元；5板＋2备品：未知/缺货元。普通扩展机器贴20元/组/订单，其他加工费未知。
- 自焊难度：中：三脚/SOIC，核对极性脚序。
- 推荐：暂缓采购闭环；先解决原件国内来源。缺货期间机器贴/自焊都不可执行，不批准现有替代。
- 你的决定：**待定**（机器贴 / 自焊 / 补证后调整设计）。Q7供货另行决定。

## E09：Q1,Q4 — DMN3065LW-7 / C150506

- 必要性：必须；保持该组数量/功能，本轮不通过删件降费。用途/节点：Q1:GDRP,RESEP,LX；Q4:DRVP,SOURCE_VGP,BASE_P。
- 替代审核：Q1/Q4保持DMN3065；直接SMT页面查到7392只，普通扩展库20元/组/单，商城接口未返回不能当作SMT缺货。包装后缀-13 C3290106/C5245314均SMT0，无需为了采购改后缀；其他NMOS缺实际栅压、Qg和损耗证据。
- 已查候选：C3290106,C5245314。详细型号/封装/原厂资料见检索明细；检索候选未全面批准。
- 原料商城/SMT库存：1115 / 7392只；查询时库存满足1/5板＋备品；订单时须重核。
- 商城1板＋2备品：8.625元；5板＋2备品：25.875元。
- SMT1板＋2备品理论元件费：6.9元；5板＋2备品：20.7元。普通扩展机器贴20元/组/订单，其他加工费未知。
- 自焊难度：较高：SOT-323小管，需放大观察。
- 推荐：保留原料机器贴（经济型普通扩展库20元/组/单）。
- 你的决定：**待定**（机器贴 / 自焊 / 补证后调整设计）。Q7供货另行决定。

## E10：Q8 — DMP3068L-7 / C151010

- 必要性：必须；保持该组数量/功能，本轮不通过删件降费。用途/节点：Q8:GDRN,RESEN,SW_N。
- 替代审核：PMOS同额定电压不足以通过：需低栅压RDS(on)、VGS、Qg/驱动电流和热能力对照；未取得合格免费替代。
- 已查候选：C41354966,C5342419,C48581021,C313499,C55591809。详细型号/封装/原厂资料见检索明细；检索候选未全面批准。
- 原料商城/SMT库存：22640 / 23089只；查询时库存满足1/5板＋备品；订单时须重核。
- 商城1板＋2备品：6.8635元；5板＋2备品：13.727元。
- SMT1板＋2备品理论元件费：4.119元；5板＋2备品：9.611元。普通扩展机器贴20元/组/订单，其他加工费未知。
- 自焊难度：中：三脚/SOIC，核对极性脚序。
- 推荐：优先保留原料自焊，以免该组换料费；自焊工具/时间成本未报价。
- 你的决定：**待定**（机器贴 / 自焊 / 补证后调整设计）。Q7供货另行决定。

## E11：D1,D2 — MBR230S1F-7 / C151335

- 必要性：必须；保持该组数量/功能，本轮不通过删件降费。用途/节点：D1:VDDP,LX；D2:SW_N,VDDN。
- 替代审核：MBR230S1F-7功率肖特基需Vf、振铃反压、浪涌、结电容、热及SOD-123F尺寸对照；C509950等未通过，不因基础/优选标签降低规格。
- 已查候选：C509950。详细型号/封装/原厂资料见检索明细；检索候选未全面批准。
- 原料商城/SMT库存：41295 / 41298只；查询时库存满足1/5板＋备品；订单时须重核。
- 商城1板＋2备品：5.702元；5板＋2备品：17.106元。
- SMT1板＋2备品理论元件费：4.56元；5板＋2备品：13.68元。普通扩展机器贴20元/组/订单，其他加工费未知。
- 自焊难度：中：三脚/SOIC，核对极性脚序。
- 推荐：优先保留原料自焊，以免该组换料费；自焊工具/时间成本未报价。
- 你的决定：**待定**（机器贴 / 自焊 / 补证后调整设计）。Q7供货另行决定。

## E12：C26 — 0805B473K500NT / C1745

- 必要性：必须；保持该组数量/功能，本轮不通过删件降费。用途/节点：C26:PUMP_N_LOW,GND。
- 替代审核：47nF/50V/X7R泵基准旁路；100V候选C3037662仍为普通扩展标签，免费及动态对照未证明。
- 已查候选：C3037662。详细型号/封装/原厂资料见检索明细；检索候选未全面批准。
- 原料商城/SMT库存：54550 / 59065只；查询时库存满足1/5板＋备品；订单时须重核。
- 商城1板＋2备品：5.49元；5板＋2备品：5.49元。
- SMT1板＋2备品理论元件费：0.33元；5板＋2备品：0.77元。普通扩展机器贴20元/组/订单，其他加工费未知。
- 自焊难度：低：0805/1210两端器件。
- 推荐：优先保留原料自焊，以免该组换料费；自焊工具/时间成本未报价。
- 你的决定：**待定**（机器贴 / 自焊 / 补证后调整设计）。Q7供货另行决定。

## E13：C17,C23,C24,C9,C10,C11 — GRM21BR71H474KA88L / C86043

- 必要性：必须；保持该组数量/功能，本轮不通过删件降费。用途/节点：C17:PUMP_P_MID,PUMP_P_AC；C23:PUMP_N_UP,PUMP_N_AC；C24:PUMP_N_DOWN,PUMP_N_AC；C9:FPL_VCOM,GND；C10:VCOMBD_M,GND；C11:VCOMBD_S,GND。
- 替代审核：C13967为三星470nF/50V/X7R/0805基础库；本组含飞跨电容，需工作偏压容量、ESR、纹波/峰值对照，未验证不替换。
- 已查候选：C13967。详细型号/封装/原厂资料见检索明细；检索候选未全面批准。
- 原料商城/SMT库存：8690 / 8699只；查询时库存满足1/5板＋备品；订单时须重核。
- 商城1板＋2备品：4.347元；5板＋2备品：17.388元。
- SMT1板＋2备品理论元件费：3.48元；5板＋2备品：13.92元。普通扩展机器贴20元/组/订单，其他加工费未知。
- 自焊难度：低：0805/1210两端器件。
- 推荐：优先保留原料自焊，以免该组换料费；自焊工具/时间成本未报价。
- 你的决定：**待定**（机器贴 / 自焊 / 补证后调整设计）。Q7供货另行决定。

## E14：C36 — 0805CG102J500NT / C29925

- 必要性：必须；保持该组数量/功能，本轮不通过删件降费。用途/节点：C36:BENCH_3V3,SW_CT。
- 替代审核：CT必须1nF、C0G、±5%、50V；已查0603CG102J500NT C1636，同介质/容差/耐压，但SMT仍普通扩展库收费，缩0603不免换料费，收益不足，保留0805。风华原厂通用规格已存档。
- 已查候选：C1636。详细型号/封装/原厂资料见检索明细；检索候选未全面批准。
- 原料商城/SMT库存：146450 / 154204只；查询时库存满足1/5板＋备品；订单时须重核。
- 商城1板＋2备品：4.19元；5板＋2备品：4.19元。
- SMT1板＋2备品理论元件费：0.2514元；5板＋2备品：0.5866元。普通扩展机器贴20元/组/订单，其他加工费未知。
- 自焊难度：低：0805/1210两端器件。
- 推荐：优先保留原料自焊，以免该组换料费；自焊工具/时间成本未报价。
- 你的决定：**待定**（机器贴 / 自焊 / 补证后调整设计）。Q7供货另行决定。

## E15：Q6 — MMBT3904-7-F / C94514

- 必要性：必须；保持该组数量/功能，本轮不通过删件降费。用途/节点：Q6:DRVN,GND,PUMP_N_LOW。
- 替代审核：C8512 MMBT2222A为基础库，但非3904直接等效：驱动电流、饱和压降、存储时间/动态损耗未核算。保留3904。
- 已查候选：C8512。详细型号/封装/原厂资料见检索明细；检索候选未全面批准。
- 原料商城/SMT库存：263320 / 265330只；查询时库存满足1/5板＋备品；订单时须重核。
- 商城1板＋2备品：3.922元；5板＋2备品：3.922元。
- SMT1板＋2备品理论元件费：1.176元；5板＋2备品：2.744元。普通扩展机器贴20元/组/订单，其他加工费未知。
- 自焊难度：中：三脚/SOIC，核对极性脚序。
- 推荐：优先保留原料自焊，以免该组换料费；自焊工具/时间成本未报价。
- 你的决定：**待定**（机器贴 / 自焊 / 补证后调整设计）。Q7供货另行决定。

## E16：Q3 — MMBT3906-7-F / C82762

- 必要性：必须；保持该组数量/功能，本轮不通过删件降费。用途/节点：Q3:BASE_P,VDDP,PUMP_P_LOW。
- 替代审核：3906候选不同厂家有功耗及动态差异，电荷泵峰值、基极驱动和存储时间尚无完整对照；保留现PNP。
- 已查候选：C84105,C79604,C460100,C14488,C87445。详细型号/封装/原厂资料见检索明细；检索候选未全面批准。
- 原料商城/SMT库存：37740 / 37890只；查询时库存满足1/5板＋备品；订单时须重核。
- 商城1板＋2备品：3.728元；5板＋2备品：3.728元。
- SMT1板＋2备品理论元件费：1.119元；5板＋2备品：2.611元。普通扩展机器贴20元/组/订单，其他加工费未知。
- 自焊难度：中：三脚/SOIC，核对极性脚序。
- 推荐：优先保留原料自焊，以免该组换料费；自焊工具/时间成本未报价。
- 你的决定：**待定**（机器贴 / 自焊 / 补证后调整设计）。Q7供货另行决定。

## E17：D4 — B0530W-7-F / C124188

- 必要性：必须；保持该组数量/功能，本轮不通过删件降费。用途/节点：D4:SW_VCOM,VBB_3P5V。
- 替代审核：B0530W替代需Vf、漏电、反向峰值/开关损耗及封装映射；普通B5819/SS14同为肖特基不代表可替换。
- 已查候选：C82046,C236079,C52747980,C513043,C53100355。详细型号/封装/原厂资料见检索明细；检索候选未全面批准。
- 原料商城/SMT库存：10760 / 10761只；查询时库存满足1/5板＋备品；订单时须重核。
- 商城1板＋2备品：3.6815元；5板＋2备品：7.363元。
- SMT1板＋2备品理论元件费：2.208元；5板＋2备品：5.152元。普通扩展机器贴20元/组/订单，其他加工费未知。
- 自焊难度：中：三脚/SOIC，核对极性脚序。
- 推荐：优先保留原料自焊，以免该组换料费；自焊工具/时间成本未报价。
- 你的决定：**待定**（机器贴 / 自焊 / 补证后调整设计）。Q7供货另行决定。

## E18：C18 — GRM21BR71H224KA01L / C86042

- 必要性：必须；保持该组数量/功能，本轮不通过删件降费。用途/节点：C18:PUMP_P_LOW,GND。
- 替代审核：220nF/50V泵基准电容；候选有效容量/峰值/ESR未闭环，保留50V和现封装。
- 已查候选：C513710,C307542,C913663,C6119933,C7472966。详细型号/封装/原厂资料见检索明细；检索候选未全面批准。
- 原料商城/SMT库存：8450 / 8454只；查询时库存满足1/5板＋备品；订单时须重核。
- 商城1板＋2备品：3.378元；5板＋2备品：6.756元。
- SMT1板＋2备品理论元件费：2.028元；5板＋2备品：4.732元。普通扩展机器贴20元/组/订单，其他加工费未知。
- 自焊难度：低：0805/1210两端器件。
- 推荐：优先保留原料自焊，以免该组换料费；自焊工具/时间成本未报价。
- 你的决定：**待定**（机器贴 / 自焊 / 补证后调整设计）。Q7供货另行决定。

## E19：C22,C25 — GRM21BR71H105KA12L / C77083

- 必要性：必须；保持该组数量/功能，本轮不通过删件降费。用途/节点：C22:PUMP_N_MID,GND；C25:REG_VGN,GND。
- 替代审核：1µF/50V飞跨及中间储能；候选有效容量/峰值/纹波未闭环，不按标称替代。
- 已查候选：C22367837,C5370002,C5445369,C6119928,C22392392。详细型号/封装/原厂资料见检索明细；检索候选未全面批准。
- 原料商城/SMT库存：98890 / 109368只；查询时库存满足1/5板＋备品；订单时须重核。
- 商城1板＋2备品：2.589元；5板＋2备品：5.178元。
- SMT1板＋2备品理论元件费：1.036元；5板＋2备品：3.108元。普通扩展机器贴20元/组/订单，其他加工费未知。
- 自焊难度：低：0805/1210两端器件。
- 推荐：优先保留原料自焊，以免该组换料费；自焊工具/时间成本未报价。
- 你的决定：**待定**（机器贴 / 自焊 / 补证后调整设计）。Q7供货另行决定。

## E20：R18 — HP05W3F1602T5E / C2774511

- 必要性：必须；保持该组数量/功能，本轮不通过删件降费。用途/节点：R18:FBN,REG_VGN。
- 替代审核：C17490为免费原0805/16k/1%/125mW候选；C4210为0603/100mW，免费身份尚未直接核实。R18跨FBN与REG_VGN，不是跨整个VGL；未知REG_VGN全工况/故障峰值，不据低功耗猜测允许333mW降到100mW。保留HP系列或人工装配。
- 已查候选：C17490,C4210。详细型号/封装/原厂资料见检索明细；检索候选未全面批准。
- 原料商城/SMT库存：400 / 400只；查询时库存满足1/5板＋备品；订单时须重核。
- 商城1板＋2备品：2.23元；5板＋2备品：2.23元。
- SMT1板＋2备品理论元件费：0.0669元；5板＋2备品：0.1561元。普通扩展机器贴20元/组/订单，其他加工费未知。
- 自焊难度：低：0805/1210两端器件。
- 推荐：优先保留原料自焊，以免该组换料费；自焊工具/时间成本未报价。
- 你的决定：**待定**（机器贴 / 自焊 / 补证后调整设计）。Q7供货另行决定。

## E21：C33,C27 — CL21B104KBCNNNC / C1711

- 必要性：必须；保持该组数量/功能，本轮不通过删件降费。用途/节点：C33:EPD_3V3,GND；C27:EPD_3V3,GND。
- 替代审核：C28233为三星100nF/100V/X7R/±10%/0805，国内基础库，尺寸2.00×1.25×1.25mm；C27/C33均在3.3V去耦。已核对额定/尺寸，但尚缺与旧CL21B104KBCNNNC的3.3V偏压/阻抗曲线对比，不将更高耐压自动当作充分等效证据。候选待补资料。
- 已查候选：C28233。详细型号/封装/原厂资料见检索明细；检索候选未全面批准。
- 原料商城/SMT库存：203600 / 855525只；查询时库存满足1/5板＋备品；订单时须重核。
- 商城1板＋2备品：1.836元；5板＋2备品：1.836元。
- SMT1板＋2备品理论元件费：0.3672元；5板＋2备品：1.1016元。普通扩展机器贴20元/组/订单，其他加工费未知。
- 自焊难度：低：0805/1210两端器件。
- 推荐：优先补C28233偏压/阻抗对照；暂时保留原料自焊，不先写入正式BOM。
- 你的决定：**待定**（机器贴 / 自焊 / 补证后调整设计）。Q7供货另行决定。

## E22：R8 — SCR0805F110K / C5140228

- 必要性：必须；保持该组数量/功能，本轮不通过删件降费。用途/节点：R8:FBP,VGH。
- 替代审核：C17422同阻值0805，C25805为0603/110k/1%/100mW/75V/100ppm。按分压总114.3k、VGH=50V包络，上臂约21.05mW、48.12V；仍须结合降额、温度和瞬态审查。C17422明确普通扩展库收费，C25805明确免费。125℃下100mW降额约35mW，高于21.05mW；但尚需明确全工况温度和瞬态峰值，未批准缩封装。
- 已查候选：C17422,C25805。详细型号/封装/原厂资料见检索明细；检索候选未全面批准。
- 原料商城/SMT库存：1200 / 1260只；查询时库存满足1/5板＋备品；订单时须重核。
- 商城1板＋2备品：1.3元；5板＋2备品：1.3元。
- SMT1板＋2备品理论元件费：0.039元；5板＋2备品：0.091元。普通扩展机器贴20元/组/订单，其他加工费未知。
- 自焊难度：低：0805/1210两端器件。
- 推荐：保留原0805自焊；免费0603 C25805待温度/瞬态边界和PCB布局审查后调整。
- 你的决定：**待定**（机器贴 / 自焊 / 补证后调整设计）。Q7供货另行决定。

## E23：D3,D5,D6 — BAT54SLT1G / C19726

- 必要性：必须；保持该组数量/功能，本轮不通过删件降费。用途/节点：D3:PUMP_P_LOW,VGH,PUMP_P_MID；D5:VGL,PUMP_N_MID,PUMP_N_UP；D6:PUMP_N_MID,PUMP_N_LOW,PUMP_N_DOWN。
- 替代审核：串联双管BAT54S必须1=A、2=K、3=中点；检索候选内部连接、Vf/漏电/结电容/恢复/热证据不足，不用BAT54C/A直接替换。
- 已查候选：C181201,C2926174,C83935,C145531,C194858。详细型号/封装/原厂资料见检索明细；检索候选未全面批准。
- 原料商城/SMT库存：163060 / 163060只；查询时库存满足1/5板＋备品；订单时须重核。
- 商城1板＋2备品：0.7755元；5板＋2备品：1.9567元。
- SMT1板＋2备品理论元件费：0.775元；5板＋2备品：1.955元。普通扩展机器贴20元/组/订单，其他加工费未知。
- 自焊难度：中：三脚/SOIC，核对极性脚序。
- 推荐：优先保留原料自焊，以免该组换料费；自焊工具/时间成本未报价。
- 你的决定：**待定**（机器贴 / 自焊 / 补证后调整设计）。Q7供货另行决定。

## E24：L1,L2,L3 — PCR1040-150-M / C53896892

- 必要性：必须；保持该组数量/功能，本轮不通过删件降费。用途/节点：L1:EPD_3V3,LX；L2:SW_N,GND；L3:SW_VCOM,GND。
- 替代审核：15µH PCR1040已复核尺寸、饱和/RMS电流、DCR等；替代接口未返回候选，未找到合格免费料。不能用小封装普通15µH直接换。
- 已查候选：未找到有证据的免费方案。详细型号/封装/原厂资料见检索明细；检索候选未全面批准。
- 原料商城/SMT库存：410 / 414只；查询时库存满足1/5板＋备品；订单时须重核。
- 商城1板＋2备品：未知元；5板＋2备品：未知元。
- SMT1板＋2备品理论元件费：6.235元；5板＋2备品：21.199元。普通扩展机器贴20元/组/订单，其他加工费未知。
- 自焊难度：中：大电感端子吸热，需预热。
- 推荐：优先保留原料自焊，以免该组换料费；自焊工具/时间成本未报价。
- 你的决定：**待定**（机器贴 / 自焊 / 补证后调整设计）。Q7供货另行决定。

## E25：FPC1 — FPC-05FB-60PH20 / C2856839

- 必要性：必须；保持该组数量/功能，本轮不通过删件降费。用途/节点：FPC1:VCOMBD_M,RESEC,GDRC,RESEN,GDRN,RESEP,GDRP,GND,EPD_3V3,EPD_3V3,VCC,VDDP,VDDP,VDDN,VDDN,VCC,EPD_3V3,TSCL,TSDA,EPD_3V3,EPD_3V3,RES_N,BUSY_N,GND,CS_M_N,SCLK,SI0,SI1,SI2,SI3,DRVP,FBP,GND,VCOMBD_S,DRVN,FBN,REG_VGN,VBB_3P5V,VSPH,VSPL,VSPL2,VSPH,VSPL,VSPL2,VSNH,VSNL,VSNL2,VSNL2,VSNL,VSNH,FPL_VCOM,TFT_VCOM,VBB_3P5V,CS_S_N,VGH,VGL。
- 替代审核：60P/0.5mm可插拔FPC，下接触及插入方向不变；未找到脚序、底座尺寸、接触方向相符且证明免费的候选。建议保留机器贴，细间距手焊返工风险高。
- 已查候选：未找到有证据的免费方案。详细型号/封装/原厂资料见检索明细；检索候选未全面批准。
- 原料商城/SMT库存：7645 / 7645只；查询时库存满足1/5板＋备品；订单时须重核。
- 商城1板＋2备品：未知元；5板＋2备品：未知元。
- SMT1板＋2备品理论元件费：7.353元；5板＋2备品：17.157元。普通扩展机器贴20元/组/订单，其他加工费未知。
- 自焊难度：高：0.5mm/60针底座，桥连/塑料热损伤。
- 推荐：保留原料机器贴（经济型普通扩展库20元/组/单）。
- 你的决定：**待定**（机器贴 / 自焊 / 补证后调整设计）。Q7供货另行决定。
