Rhys-Q/album/hardware/pcb/gdep133c02-driver/docs/采购清单-v0.11.csv

C编号 | 型号 | 品牌 | 位号 | 每板数量 | 封装 | 装配方式 | 国内库类别 | 商城库存 | SMT库存 | 有效查询时间 | 本次刷新状态 | 采购倍数 | MOQ只 | 商城人民币阶梯 | SMT单价 | SMT采购费用 | 采购链接 | 原厂资料 | 审查状态 | 新增换料费估算 | 1板+每型号0备品商城购买量 | 1板+每型号0备品商城付款元 | 1板+每型号2备品商城购买量 | 1板+每型号2备品商城付款元 | 5板+每型号0备品商城购买量 | 5板+每型号0备品商城付款元 | 5板+每型号2备品商城购买量 | 5板+每型号2备品商城付款元
C13967 | CL21B474KBFNNNE | Samsung Electro-Mechanics | C17,C23,C24,C9,C10,C11 | 6 | Driver:C_0805_HandSolder | 机器SMT | SMT基础库 | 6720 | 398011 | 2026-10-11T14:59:18.560335+08:00 | OK | 20 | 20 | 20只起:0.1398;200只起:0.1118;600只起:0.0962;2000只起:0.0736 |  |  | https://item.szlcsc.com/14623.html | https://datasheet.lcsc.com/datasheet/pdf/02336ea48ea44ca18c72517dd3cb7b47.pdf?productCode=C13967 | 2026-10-11 user selected 3+14 groups; E13; PROTOTYPE ONLY - electrical equivalence NOT VERIFIED | 0（按国内基础库标签，订单重核） | 20 | 2.796 | 20 | 2.796 | 40 | 5.592 | 40 | 5.592
C144313 | TCN75AVOA713 | Microchip | U4 | 1 | Driver:Package_SO__SOIC-8_3.9x4.9mm_P1.27mm | 手工装配（用户淘宝采购） | SMT扩展库 | 436 | 534 | 2026-10-11T14:07:45.813101+08:00 | 未刷新；历史记录 | 1 | 1 | 1只起:7.8;10只起:6.61;30只起:5.96;100只起:5.22 |  |  | https://item.szlcsc.com/155645.html | https://ww1.microchip.com/downloads/en/DeviceDoc/21935c.pdf | 保持原件 | 不机器贴片，不计该组换料费 | 1 | 7.8 | 3 | 23.4 | 5 | 39.0 | 7 | 54.6
C14858 | CL10C101JB8NNNC | Samsung Electro-Mechanics | C36,C151,C152,C153,C154,C155,C156,C157,C158,C159 | 10 | Driver:Capacitor_SMD__C_0603_1608Metric | 机器SMT | SMT基础库 | 406700 | 3517389 | 2026-10-11T14:59:25.237944+08:00 | OK | 50 | 50 | 50只起:0.0527;500只起:0.0395;1500只起:0.0336;4000只起:0.0291;24000只起:0.0274;48000只起:0.0262 |  |  | https://item.szlcsc.com/15530.html | https://datasheet.lcsc.com/datasheet/pdf/02336ea48ea44ca18c72517dd3cb7b47.pdf?productCode=C14858 | 2026-10-11 user selected 3+14 groups; E14; PROTOTYPE ONLY - electrical equivalence NOT VERIFIED | 0（按国内基础库标签，订单重核） | 50 | 2.635 | 50 | 2.635 | 50 | 2.635 | 100 | 5.27
C149504 | 0805W8F1003T5E | UNI-ROYAL | R30,R11,R8,R35,R36,R44,R45,R46,R47,R48 | 10 | Driver:R_0805_HandSolder | 机器SMT | SMT基础库 | 2043800 | 3907357 | 2026-10-11T14:59:19.482730+08:00 | OK | 100 | 100 | 100只起:0.0361;1000只起:0.0286;5000只起:0.0248;10000只起:0.0223;50000只起:0.0213;100000只起:0.0206 |  |  | https://item.szlcsc.com/160838.html | https://datasheet.lcsc.com/datasheet/pdf/0a975aaa49b7c97f38a963127be4a823.pdf?productCode=C149504 | 保持原件 | 0（按国内基础库标签，订单重核） | 100 | 3.61 | 100 | 3.61 | 100 | 3.61 | 100 | 3.61
C15008 | CL31A107MQHNNNE | Samsung Electro-Mechanics | C31,C32 | 2 | Driver:C_1206_HandSolder | 机器SMT | SMT基础库 | 1039860 | 未知 | 2026-10-11T14:12:33.174140+08:00 | INCOMPLETE | 10 | 10 | 10只起:0.7712;100只起:0.5579;300只起:0.4538;2000只起:0.3609;4000只起:0.3354;10000只起:0.32 |  |  | https://item.szlcsc.com/15681.html | https://datasheet.lcsc.com/datasheet/pdf/02336ea48ea44ca18c72517dd3cb7b47.pdf?productCode=C15008 | 2026-10-11 user selected 3+14 groups; E04; PROTOTYPE ONLY - electrical equivalence NOT VERIFIED | 0（按国内基础库标签，订单重核） | 10 | 7.712 | 10 | 7.712 | 10 | 7.712 | 20 | 15.424
C15127 | AO3401A | AOS | Q8,Q7 | 2 | Driver:Package_TO_SOT_SMD__SOT-23 | 机器SMT | SMT基础库 | 147560 | 682420 | 2026-10-11T14:08:47.923870+08:00 | INCOMPLETE | 5 | 5 | 5只起:0.6245;50只起:0.5046;150只起:0.4429;500只起:0.3921;3000只起:0.3744;6000只起:0.3624 |  |  | https://item.szlcsc.com/15801.html | https://datasheet.lcsc.com/datasheet/pdf/fee353dd1e9e0bc90b295f14f381aa4c.pdf?productCode=C15127 | 2026-10-11 user selected 3+14 groups; E10; PROTOTYPE ONLY - electrical equivalence NOT VERIFIED | 0（按国内基础库标签，订单重核） | 5 | 3.1225 | 5 | 3.1225 | 10 | 6.245 | 15 | 9.3675
C1622 | CL10B473KB8NNNC | Samsung Electro-Mechanics | C26 | 1 | Driver:Capacitor_SMD__C_0603_1608Metric | 机器SMT | SMT基础库 | 325700 | 570983 | 2026-10-11T14:59:23.102043+08:00 | OK | 100 | 100 | 100只起:0.0357;1000只起:0.0267;4000只起:0.0227;8000只起:0.0197;48000只起:0.0185;100000只起:0.0177 |  |  | https://item.szlcsc.com/1974.html | https://datasheet.lcsc.com/datasheet/pdf/02336ea48ea44ca18c72517dd3cb7b47.pdf?productCode=C1622 | 2026-10-11 user selected 3+14 groups; E12; PROTOTYPE ONLY - electrical equivalence NOT VERIFIED | 0（按国内基础库标签，订单重核） | 100 | 3.57 | 100 | 3.57 | 100 | 3.57 | 100 | 3.57
C1729 | CL21B223KBANNNC | Samsung Electro-Mechanics | C161 | 1 | Driver:C_0805_HandSolder | 机器SMT | SMT基础库 | 0 | 176389 | 2026-10-11T14:59:25.729520+08:00 | OK | 50 | 50 | 50只起:0.06;500只起:0.0486;1500只起:0.0423;4000只起:0.0385;24000只起:0.0352;48000只起:0.0334 |  |  | https://item.szlcsc.com/2081.html | https://datasheet.lcsc.com/datasheet/pdf/02336ea48ea44ca18c72517dd3cb7b47.pdf?productCode=C1729 | 2026-10-11 user selected 3+14 groups; E18; PROTOTYPE ONLY - electrical equivalence NOT VERIFIED | 0（按国内基础库标签，订单重核） | 50 | 3.0 | 50 | 3.0 | 50 | 3.0 | 50 | 3.0
C17414 | 0805W8F1002T5E | UNI-ROYAL | R52 | 1 | Driver:R_0805_HandSolder | 机器SMT | SMT基础库 | 47167900 | 58437969 | 2026-10-11T14:59:27.845378+08:00 | OK | 100 | 100 | 100只起:0.0202;1000只起:0.0154;5000只起:0.0108;10000只起:0.0095;50000只起:0.0085 |  |  | https://item.szlcsc.com/18102.html | https://datasheet.lcsc.com/datasheet/pdf/0a975aaa49b7c97f38a963127be4a823.pdf?productCode=C17414 | 2026-10-11 user selected 3+14 groups; E22; parametric review PASS, CAD validation pending | 0（按国内基础库标签，订单重核） | 100 | 2.02 | 100 | 2.02 | 100 | 2.02 | 100 | 2.02
C17475 | 0805W8F1502T5E | UNI-ROYAL | R18 | 1 | Driver:R_0805_HandSolder | 机器SMT | SMT基础库 | 319100 | 726353 | 2026-10-11T14:59:23.686347+08:00 | OK | 100 | 100 | 100只起:0.0358;1000只起:0.0283;5000只起:0.0236;10000只起:0.0211;50000只起:0.0189;100000只起:0.0178 |  |  | https://item.szlcsc.com/18163.html | https://datasheet.lcsc.com/datasheet/pdf/0a975aaa49b7c97f38a963127be4a823.pdf?productCode=C17475 | 2026-10-11 user selected 3+14 groups; E20; parametric review PASS, CAD validation pending | 0（按国内基础库标签，订单重核） | 100 | 3.58 | 100 | 3.58 | 100 | 3.58 | 100 | 3.58
C17477 | 0805W8F0000T5E | UNI-ROYAL | R49 | 1 | Driver:Resistor_SMD__R_0805_2012Metric | 机器SMT | SMT基础库 | 3864300 | 6466409 | 2026-10-10T21:01:23.137541+08:00 | 未刷新；历史记录 | 100 | 1.0 | 100.0只起:0.0268;1000.0只起:0.0214;5000.0只起:0.0181;10000.0只起:0.0163;50000.0只起:0.0155;100000.0只起:0.0151 |  |  | https://item.szlcsc.com/18165.html | https://datasheet.lcsc.com/datasheet/pdf/0a975aaa49b7c97f38a963127be4a823.pdf?productCode=C17477 | 保持原件 | 0（按国内基础库标签，订单重核） | 100 | 2.68 | 100 | 2.68 | 100 | 2.68 | 100 | 2.68
C17513 | 0805W8F1001T5E | UNI-ROYAL | R51 | 1 | Driver:R_0805_HandSolder | 机器SMT | SMT基础库 | 38681100 | 45413171 | 2026-10-11T14:59:27.154691+08:00 | OK | 100 | 100 | 100只起:0.0211;1000只起:0.0166;5000只起:0.0135;10000只起:0.0122;50000只起:0.0112 |  |  | https://item.szlcsc.com/18201.html | https://datasheet.lcsc.com/datasheet/pdf/0a975aaa49b7c97f38a963127be4a823.pdf?productCode=C17513 | 2026-10-11 user selected 3+14 groups; E20; parametric review PASS, CAD validation pending | 0（按国内基础库标签，订单重核） | 100 | 2.11 | 100 | 2.11 | 100 | 2.11 | 100 | 2.11
C17514 | 0805W8F1004T5E | UNI-ROYAL | R2,R3,R13 | 3 | Driver:R_0805_HandSolder | 机器SMT | SMT基础库 | 1283800 | 2325315 | 2026-10-10T21:01:17.958679+08:00 | 未刷新；历史记录 | 100 | 1.0 | 100.0只起:0.0264;1000.0只起:0.021;5000.0只起:0.0171;10000.0只起:0.0153;50000.0只起:0.0137;100000.0只起:0.0129 |  |  | https://item.szlcsc.com/18202.html | https://datasheet.lcsc.com/datasheet/pdf/0a975aaa49b7c97f38a963127be4a823.pdf?productCode=C17514 | 保持原件 | 0（按国内基础库标签，订单重核） | 100 | 2.64 | 100 | 2.64 | 100 | 2.64 | 100 | 2.64
C17521 | 0805W8F220KT5E | UNI-ROYAL | R10,R19 | 2 | Driver:R_0805_HandSolder | 机器SMT | SMT基础库 | 46900 | 281124 | 2026-10-10T21:01:23.490236+08:00 | 未刷新；历史记录 | 100 | 1.0 | 100.0只起:0.0453;1000.0只起:0.0364;5000.0只起:0.0306;10000.0只起:0.0276;50000.0只起:0.0251;100000.0只起:0.0237 |  |  | https://item.szlcsc.com/18209.html | https://www.uni-royal.cn/en/images/userfile/file/1668661899c56505e6d9ab55c7.pdf | 2026-10-10 user authorized three resistor groups only; all other assembly unchanged | 0（按国内基础库标签，订单重核） | 100 | 4.53 | 100 | 4.53 | 100 | 4.53 | 100 | 4.53
C17539 | 0805W8F2003T5E | UNI-ROYAL | R17,R50 | 2 | Driver:R_0805_HandSolder | 机器SMT | SMT基础库 | 412400 | 652598 | 2026-10-10T21:01:23.566114+08:00 | 未刷新；历史记录 | 100 | 1.0 | 100.0只起:0.034;1000.0只起:0.0266;5000.0只起:0.0218;10000.0只起:0.0193;50000.0只起:0.0171;100000.0只起:0.016 |  |  | https://item.szlcsc.com/18227.html | https://www.uni-royal.cn/en/images/userfile/file/1668661899c56505e6d9ab55c7.pdf | 2026-10-10 user authorized three resistor groups only; all other assembly unchanged | 0（按国内基础库标签，订单重核） | 100 | 3.4 | 100 | 3.4 | 100 | 3.4 | 100 | 3.4
C17604 | 0805W8F2001T5E | UNI-ROYAL | R1 | 1 | Driver:R_0805_HandSolder | 机器SMT | SMT基础库 | 3473200 | 5275955 | 2026-10-10T21:01:23.294793+08:00 | 未刷新；历史记录 | 100 | 1.0 | 100.0只起:0.0234;1000.0只起:0.0182;5000.0只起:0.0149;10000.0只起:0.0136;50000.0只起:0.0119 |  |  | https://item.szlcsc.com/18292.html | https://datasheet.lcsc.com/datasheet/pdf/0a975aaa49b7c97f38a963127be4a823.pdf?productCode=C17604 | 保持原件 | 0（按国内基础库标签，订单重核） | 100 | 2.34 | 100 | 2.34 | 100 | 2.34 | 100 | 2.34
C17634 | 0805W8F330JT5E | UNI-ROYAL | R39,R40,R41,R42,R43 | 5 | Driver:R_0805_HandSolder | 机器SMT | SMT基础库 | 1140600 | 1516041 | 2026-10-10T21:01:23.842264+08:00 | 未刷新；历史记录 | 100 | 1.0 | 100.0只起:0.0285;1000.0只起:0.0222;5000.0只起:0.0182;10000.0只起:0.0162;50000.0只起:0.0143;100000.0只起:0.0134 |  |  | https://item.szlcsc.com/18322.html | https://datasheet.lcsc.com/datasheet/pdf/0a975aaa49b7c97f38a963127be4a823.pdf?productCode=C17634 | 保持原件 | 0（按国内基础库标签，订单重核） | 100 | 2.85 | 100 | 2.85 | 100 | 2.85 | 100 | 2.85
C17667 | 0805W8F4301T5E | UNI-ROYAL | R7 | 1 | Driver:R_0805_HandSolder | 机器SMT | SMT扩展库 | 45600 | 102438 | 2026-10-10T21:06:31.809769+08:00 | 未刷新；历史记录 | 100 | 1.0 | 100.0只起:0.0485;1000.0只起:0.0389;5000.0只起:0.0333;10000.0只起:0.0301 |  |  | https://item.szlcsc.com/18355.html | https://www.uni-royal.cn/en/images/userfile/file/1668661899c56505e6d9ab55c7.pdf | 2026-10-10 user authorized three resistor groups only; all other assembly unchanged | 未知或扩展库20元/型号/订单，订单重核 | 100 | 4.85 | 100 | 4.85 | 100 | 4.85 | 100 | 4.85
C17673 | 0805W8F4701T5E | UNI-ROYAL | R20,R21 | 2 | Driver:R_0805_HandSolder | 机器SMT | SMT基础库 | 1397900 | 4704531 | 2026-10-10T21:01:22.580128+08:00 | 未刷新；历史记录 | 100 | 1.0 | 100.0只起:0.0306;1000.0只起:0.0243;5000.0只起:0.021;10000.0只起:0.0189;50000.0只起:0.0181;100000.0只起:0.0175 |  |  | https://item.szlcsc.com/18361.html | https://datasheet.lcsc.com/datasheet/pdf/0a975aaa49b7c97f38a963127be4a823.pdf?productCode=C17673 | 保持原件 | 0（按国内基础库标签，订单重核） | 100 | 3.06 | 100 | 3.06 | 100 | 3.06 | 100 | 3.06
C19726 | BAT54SLT1G | onsemi | D3,D5,D6 | 3 | Driver:Package_TO_SOT_SMD__SOT-23 | 手工装配（用户淘宝采购） | SMT扩展库 | 160906 | 160906 | 2026-10-11T14:08:13.145131+08:00 | 未刷新；历史记录 | 1 | 1 | 1只起:0.1551;10只起:0.1151;30只起:0.0973;100只起:0.084;500只起:0.0786;1000只起:0.0751 |  |  | https://item.szlcsc.com/20435.html | https://www.onsemi.com/download/data-sheet/pdf/bat54slt1-d.pdf | 保持原件 | 不机器贴片，不计该组换料费 | 3 | 0.4653 | 5 | 0.7755 | 15 | 1.7265 | 17 | 1.9567
C20526 | MMBT3904(RANGE:100-300) | JSCJ | Q6 | 1 | Driver:Package_TO_SOT_SMD__SOT-23 | 机器SMT | SMT基础库 | 0 | 335060 | 2026-10-11T14:59:20.697323+08:00 | OK | 50 | 50 | 50只起:0.0707;500只起:0.0561;3000只起:0.0496;6000只起:0.0447;24000只起:0.0428;51000只起:0.0415 |  |  | https://item.szlcsc.com/21237.html | https://datasheet.lcsc.com/datasheet/pdf/9335632bcfa83df8351353eab379720e.pdf?productCode=C20526 | 2026-10-11 user selected 3+14 groups; E15; PROTOTYPE ONLY - electrical equivalence NOT VERIFIED | 0（按国内基础库标签，订单重核） | 50 | 3.535 | 50 | 3.535 | 50 | 3.535 | 50 | 3.535
C2073442 | WSL1206R2000FEA | Vishay | U1,U2,U3 | 3 | Driver:Resistor_SMD__R_1206_3216Metric | 机器SMT | SMT扩展库 | 2094 | 2094 | 2026-10-11T14:07:49.903629+08:00 | 未刷新；历史记录 | 1 | 1 | 1只起:2.48;10只起:1.93;30只起:1.7;100只起:1.41;500只起:1.27;1000只起:1.2 |  |  | https://item.szlcsc.com/2165027.html | https://atta.szlcsc.com/upload/public/pdf/source/20210602/CE5897E13CB99DCF20BCC39AB0A05E7D.pdf | 保持原件 | 未知或扩展库20元/型号/订单，订单重核 | 3 | 7.44 | 5 | 12.4 | 15 | 28.95 | 17 | 32.81
C20917 | AO3400A | AOS | Q1,Q4 | 2 | Driver:Package_TO_SOT_SMD__SOT-23 | 机器SMT | SMT基础库 | 207590 | 811728 | 2026-10-11T14:59:04.427281+08:00 | OK | 5 | 5 | 5只起:0.5463;50只起:0.4402;150只起:0.3856;500只起:0.3407;3000只起:0.325;6000只起:0.3144 |  |  | https://item.szlcsc.com/21629.html | https://datasheet.lcsc.com/datasheet/pdf/130876b936da464599428c58fd8de8f6.pdf?productCode=C20917 | 2026-10-11 user selected 3+14 groups; E09; PROTOTYPE ONLY - electrical equivalence NOT VERIFIED | 0（按国内基础库标签，订单重核） | 5 | 2.7315 | 5 | 2.7315 | 10 | 5.463 | 15 | 8.1945
C2681320 | TPS22917DBVR | Texas Instruments | U5 | 1 | Driver:Package_TO_SOT_SMD__SOT-23-6 | 手工装配（用户淘宝采购） | SMT扩展库 | 21115 | 23689 | 2026-10-11T14:07:51.055422+08:00 | 未刷新；历史记录 | 5 | 5 | 5只起:2.4481;50只起:1.8942;150只起:1.6568;500只起:1.3606;3000只起:1.2287;6000只起:1.1496 |  |  | https://item.szlcsc.com/2775165.html | https://www.ti.com/lit/ds/symlink/tps22917.pdf | 保持原件 | 不机器贴片，不计该组换料费 | 5 | 12.2405 | 5 | 12.2405 | 5 | 12.2405 | 10 | 24.481
C28233 | CL21B104KCFNNNE | Samsung Electro-Mechanics | C33,C18,C27,C123,C124,C125,C128,C129,C130,C133,C134,C135,C138,C139,C140,C143,C144,C145,C148,C149,C150,C160 | 22 | Driver:C_0805_HandSolder | 机器SMT | SMT基础库 | 320500 | 1148962 | 2026-10-11T14:59:04.424016+08:00 | OK | 50 | 50 | 50只起:0.2042;500只起:0.1554;2000只起:0.1338;4000只起:0.1175;24000只起:0.111;50000只起:0.1067 |  |  | https://item.szlcsc.com/28983.html | https://datasheet.lcsc.com/datasheet/pdf/02336ea48ea44ca18c72517dd3cb7b47.pdf?productCode=C28233 | 2026-10-11 user selected 3+14 groups; E21; parametric review PASS, CAD validation pending | 0（按国内基础库标签，订单重核） | 50 | 10.21 | 50 | 10.21 | 150 | 30.63 | 150 | 30.63
C28323 | CL21B105KBFNNNE | Samsung Electro-Mechanics | C22,C25,C105,C108,C111,C114,C117,C120,C121,C122,C126,C127,C131,C132,C136,C137,C141,C142,C146,C147 | 20 | Driver:C_0805_HandSolder | 机器SMT | SMT基础库 | 214670 | 2037121 | 2026-10-11T14:59:21.591297+08:00 | OK | 10 | 10 | 10只起:0.2448;100只起:0.1877;300只起:0.1584;2000只起:0.1342;4000只起:0.1258;10000只起:0.12 |  |  | https://item.szlcsc.com/29074.html | https://datasheet.lcsc.com/datasheet/pdf/02336ea48ea44ca18c72517dd3cb7b47.pdf?productCode=C28323 | 2026-10-11 user selected 3+14 groups; E19; PROTOTYPE ONLY - electrical equivalence NOT VERIFIED | 0（按国内基础库标签，订单重核） | 20 | 4.896 | 30 | 7.344 | 100 | 18.77 | 110 | 20.647
C2856839 | FPC-05FB-60PH20 | Xunpu | FPC1 | 1 | Driver:FPC_05FB_60PH20 | 手工装配（用户淘宝采购） | SMT扩展库 | 7645 | 7645 | 2026-10-11T14:08:14.857524+08:00 | 未刷新；历史记录 | 1 | 1 |  |  |  | https://item.szlcsc.com/3056937.html | https://atta.szlcsc.com/upload/public/pdf/source/20210922/C2856839_B700DB1A2B95976B214AB1FEFC031E2B.pdf | 保持原件 | 不机器贴片，不计该组换料费 | 1 |  | 3 |  | 5 |  | 7
C29823 | 1206B475K500NT | FH | C28,C29,C30,C12,C14,C19,C16,C21,C8 | 9 | Driver:C_1206_HandSolder | 机器SMT | SMT基础库 | 11780 | 530443 | 2026-10-11T14:08:16.690356+08:00 | INCOMPLETE | 10 | 10 | 10只起:1.0274;100只起:0.7875;300只起:0.6704;2000只起:0.566;4000只起:0.5373;10000只起:0.5201 |  |  | https://item.szlcsc.com/30577.html | https://datasheet.lcsc.com/datasheet/pdf/09fe2daf22580a99fa7fea93ccb20fb7.pdf?productCode=C29823 | 2026-10-11 user selected 3+14 groups; E05; PROTOTYPE ONLY - electrical equivalence NOT VERIFIED | 0（按国内基础库标签，订单重核） | 10 | 10.274 | 20 | 20.548 | 50 | 51.37 | 50 | 51.37
C42410552 | TJC8-2.54-2A | DLL | J1 | 1 | Driver:Connector_PinHeader_2.54mm__PinHeader_1x02_P2.54mm_Vertical | 手工 | SMT扩展库 | 2560 | 2577 | 2026-10-10T21:01:16.229769+08:00 | 未刷新；历史记录 | 20 | 1.0 |  |  |  | https://item.szlcsc.com/44387857.html | https://datasheet.lcsc.com/datasheet/pdf/e9f3c2915a9e3fc695b50dadc57635c3.pdf?productCode=C42410552 | 保持原件 | 未知或扩展库20元/型号/订单，订单重核 | 20 |  | 20 |  | 20 |  | 20
C4310 | 0805W8F1501T5E | UNI-ROYAL | R12 | 1 | Driver:R_0805_HandSolder | 机器SMT | SMT基础库 | 134900 | 670095 | 2026-10-10T21:01:19.160974+08:00 | 未刷新；历史记录 | 100 | 1.0 | 100.0只起:0.0212;1000.0只起:0.0165;5000.0只起:0.0131;10000.0只起:0.012;50000.0只起:0.0105 |  |  | https://item.szlcsc.com/4717.html | https://datasheet.lcsc.com/datasheet/pdf/0a975aaa49b7c97f38a963127be4a823.pdf?productCode=C4310 | 保持原件 | 0（按国内基础库标签，订单重核） | 100 | 2.12 | 100 | 2.12 | 100 | 2.12 | 100 | 2.12
C440198 | GRM21BR61H106KE43L | Murata | C13,C15,C20,C1,C103,C104,C2,C106,C107,C3,C109,C110,C4,C112,C113,C5,C115,C116,C6,C118,C119,C7 | 22 | Driver:C_0805_HandSolder | 机器SMT | SMT基础库 | 480520 | 1371419 | 2026-10-11T11:28:17.670114+08:00 | 未刷新；历史记录 | 5 | 1.0 | 5.0只起:1.2704;50.0只起:1.0596;150.0只起:0.9566;500.0只起:0.8648;3000.0只起:0.8152;6000.0只起:0.8 |  |  | https://item.szlcsc.com/439567.html | https://datasheet.lcsc.com/datasheet/pdf/8cca754305bc7d881114d4ba10b82bf2.pdf?productCode=C440198 | 2026-10-11 user explicitly selected C440198 for E01; prototype, effective capacitance/ESR/ripple equivalence unverified | 0（按国内基础库标签，订单重核） | 25 | 31.76 | 25 | 31.76 | 110 | 116.556 | 115 | 121.854
C53896892 | PCR1040-150-M | JIERR | L1,L2,L3 | 3 | Driver:L_JIERR_PCR1040 | 机器SMT | SMT扩展库 | 410 | 414 | 2026-10-11T14:08:14.553463+08:00 | 未刷新；历史记录 | 5 | 5 |  |  |  | https://item.szlcsc.com/57092574.html | https://datasheet.lcsc.com/datasheet/pdf/e6a3215768ac43dd7ce4fb124bc75d91.pdf?productCode=C53896892 | 保持原件 | 未知或扩展库20元/型号/订单，订单重核 | 5 |  | 5 |  | 15 |  | 20
C55629829 | SH-PZ254V-2x8P | SHOU HAN | J2 | 1 | Driver:Connector_PinHeader_2.54mm__PinHeader_2x08_P2.54mm_Vertical | 手工 | SMT扩展库 | 500 | 500 | 2026-10-10T21:01:22.469107+08:00 | 未刷新；历史记录 | 5 | 1.0 |  |  |  | https://item.szlcsc.com/59737003.html | https://datasheet.lcsc.com/datasheet/pdf/a15807adb16db6524ac1ac5d15bcc78a.pdf?productCode=C55629829 | 保持原件 | 未知或扩展库20元/型号/订单，订单重核 | 5 |  | 5 |  | 5 |  | 10
C82762 | MMBT3906-7-F | Diodes | Q3 | 1 | Driver:Package_TO_SOT_SMD__SOT-23 | 手工装配（用户淘宝采购） | SMT扩展库 | 37640 | 37861 | 2026-10-11T14:08:03.054016+08:00 | 未刷新；历史记录 | 10 | 10 | 10只起:0.3728;100只起:0.2938;300只起:0.2544;3000只起:0.2248;6000只起:0.2011;9000只起:0.1892 |  |  | https://item.szlcsc.com/83922.html | https://atta.szlcsc.com/upload/public/pdf/source/20221028/DE85DC0248B2C64D4CE838286525BEA1.pdf | 保持原件 | 不机器贴片，不计该组换料费 | 10 | 3.728 | 10 | 3.728 | 10 | 3.728 | 10 | 3.728
C8598 | B5819W SL | JSCJ | D4 | 1 | Driver:Diode_SMD__D_SOD-123 | 机器SMT | SMT基础库 | 3000 | 399290 | 2026-10-11T14:59:16.569735+08:00 | OK | 20 | 20 | 20只起:0.1717;200只起:0.1342;600只起:0.1176;3000只起:0.1051 |  |  | https://item.szlcsc.com/9093.html | https://datasheet.lcsc.com/datasheet/pdf/4ac2c059be7c462694ab0715ce987a85.pdf?productCode=C8598 | 2026-10-11 user selected 3+14 groups; E17; PROTOTYPE ONLY - electrical equivalence NOT VERIFIED | 0（按国内基础库标签，订单重核） | 20 | 3.434 | 20 | 3.434 | 20 | 3.434 | 20 | 3.434
C8678 | SS34 | MDD(Microdiode Semiconductor) | D1,D2 | 2 | Driver:D_SMA_HandSolder | 机器SMT | SMT基础库 | 3320560 | 4166894 | 2026-10-11T14:12:14.414733+08:00 | INCOMPLETE | 20 | 20 | 20只起:0.2138;200只起:0.1716;600只起:0.1529;5000只起:0.1039;10000只起:0.0982;20000只起:0.0945 |  |  | https://item.szlcsc.com/9178.html | https://datasheet.lcsc.com/datasheet/pdf/dfa1ff67dea875d0135103ba9ada713a.pdf?productCode=C8678 | 2026-10-11 user selected 3+14 groups; E11; PROTOTYPE ONLY - electrical equivalence NOT VERIFIED | 0（按国内基础库标签，订单重核） | 20 | 4.276 | 20 | 4.276 | 20 | 4.276 | 20 | 4.276
