Rhys-Q/album/hardware/pcb/gdep133c02-driver/releases/jlc-cn-review-v0.10-e01-2026-10-11/gdep133c02-driver-bom-manual.csv

Comment | Designator | Footprint | Quantity | Manufacturer | MPN | LCSC Part #
3V3 BENCH ONLY TJC8-2.54-2A | J1 | PinHeader 1x02 2.54mm | 1 | DLL | TJC8-2.54-2A | C42410552
HOST DIRECT 3V3 SH-PZ254V-2x8P | J2 | PinHeader 2x08 2.54mm | 1 | SHOU HAN | SH-PZ254V-2x8P | C55629829
