Rhys-Q/album/docs/design/BOM价格分析与降本方案.md

# BOM价格分析与降本方案

> 最新补充：其他渠道已找到11组原型号报价及3组替代候选，详见[缺价14组其他渠道采购核查](缺价14组其他渠道采购核查.md)。当前原型号报价覆盖35/38组；电感足量库存、三项替代核验及税运/订单门槛仍未闭环。下文第3节保留此前24组国内价格基准，不是最新完整货值。

> 查询日期：2026-10-08。采购目标：1块板，并比较5块板。币种：人民币。此文档和配套CSV是采购分析，不能直接作为SMT下单BOM。

## 1. 结论与适用范围

当前release共有38组型号、103个装配件。此前取得24组原型号的国内网页梯度报价；本次扩展其他渠道后共有35组原型号报价，另3组需候选替代。第3节仍是**此前24组的小计，不是整板完整价格**。未知项未按零元计算；国际站美元报价单独记账，不冒充立创国内价格。

最值得先做的是优化少量采购渠道和10µF/50V电容品牌；无需为了电阻起订量重新设计整块PCB。可以考虑淘宝小份装，但须比较正确规格对应的数量、运费和实际付款。FPC插座单件约¥2.45，保留原型号。MOS、电感、采样电阻与高压储能不能仅凭便宜换成同名器件。

本轮仅新增本说明和[BOM采购价格对照.csv](BOM采购价格对照.csv)，未修改KiCad、正式BOM或release。候选均未实板验证。原工程资料在`hardware/pcb/gdep133c02-driver/docs/sources/`与`hardware/reference/`。

分析基准：[当前release BOM](../../hardware/pcb/gdep133c02-driver/releases/jlc-cn-review-v0.5-linkfix-2026-10-08/gdep133c02-driver-bom-all.csv)。

## 2. 如何计算真正的采购费用

- 每个MPN合并全部位号后计算；按起订量和购买倍数向上取整，整盘数量不等于起订量。
- 无备品：需求量=每板数量×板数。含备品：每个SMT型号额外2件，连接器J1/J2/FPC1每个型号额外1件；不是每板额外加。
- 购买量=向上取整到购买倍数(max(需求量,MOQ))。按购买量选择价格梯度。付款=购买量×单价；板上用料价值=装配数量×该档单价。
- 余料不算本板耗用，但第一单必须付款。运费、工具、PCB、屏幕、主控板及优惠券均未计入。每行付款保留2位小数，小计从未舍入金额求和后再舍入，可能与逐行显示相加差几分钱。
- 价格为网页公开显示价，不含会员折扣；库存是查询快照，下单前复核。CSV保存价格梯度，未知金额留空。

例如22只村田10µF/50V需要买25只，单价¥2.0223，付款¥50.56。页面¥1.226属于5000只档；不能据此估算一块板。

## 3. 原型号预算：24组已知价格小计

| 采购场景 | 元器件付款小计 | 装配用料价值合计 | 分摊付款/板 |
|---|---:|---:|---:|
| 1板，无备品 | ¥160.15 | ¥82.25 | ¥160.15 |
| 1板，含备品 | ¥178.20 | ¥82.25 | ¥178.20 |
| 5板，无备品 | ¥398.36 | ¥371.00 | ¥79.67 |
| 5板，含备品 | ¥485.33 | ¥371.00 | ¥97.07 |

这24组覆盖74个装配件；其余14组的新价格及条件性完整货值见第8节。此处保留原24组比较基准，不计入新增报价。

## 4. 38组逐项价格与处理建议

此表汇总35组原件报价；另外3组候选和供货条件见第8节。单价为1块板无备品的实际购买档位；费用不含运费。更完整的1/5板、含/不含备品结果见CSV。

| 型号 / 位号 | 每板数量 | 渠道 / MOQ / 倍数 | 单价及币种 | 1板购买量 / 货值 | 处理建议 |
|---|---:|---|---:|---:|---|
| [RC0805JR-070RL](https://item.szlcsc.com/97549.html)<br>R49 | 1 | 立创 / 100 / 100 | ¥0.0325 | 100 / ¥3.25 | 保留0Ω调试隔离；淘宝可买0805零欧，但核对允许电流。 |
| [WSL1206R2000FEA](https://www.digikey.com/en/products/detail/vishay-dale/WSL1206R2000FEA/712503)<br>U1,U2,U3 | 3 | DigiKey / 1 / 1 | USD 0.74 | 3 / USD 2.22 | 精确原型号金属采样电阻；保留0.2Ω、1%、0.25W和脉冲指标。国内分类页另见1+¥6.12，但缺完整梯度，采用美元剪切带报价。 |
| [RC0603FR-071K5L](https://item.szlcsc.com/115912.html)<br>R12 | 1 | 立创 / 100 / 100 | ¥0.0214 | 100 / ¥2.14 | 分压/反馈；保留1.5kΩ±1%，不改阻值。 |
| [RC0603FR-07100KL](https://item.szlcsc.com/15343.html)<br>R11,R30,R35,R36,R44,R45,R46,R47,R48 | 9 | 立创 / 100 / 100 | ¥0.0158 | 100 / ¥1.58 | 上拉/下拉与默认状态；可换合格0603 100kΩ±1%厚膜。 |
| [GRM188R71H104KA93D](https://item.szlcsc.com/78182.html)<br>C27,C33 | 2 | 立创 / 50 / 50 | ¥0.1034 | 50 / ¥5.17 | 局部去耦；保留0603 100nF/50V X7R。 |
| [GRM32ER60J107ME20L](https://item.szlcsc.com/89332.html)<br>C31,C32 | 2 | 立创 / 5 / 5 | ¥2.9282 | 5 / ¥14.64 | 3.3V储能；保留100µF/6.3V与偏压后的有效容量，不能按标称容量盲换。 |
| [GRM32ER71H106KA12L](https://item.szlcsc.com/78229.html)<br>C1,C103,C104,C106,C107,C109,C110,C112,C113,C115,C116,C118,C119,C13,C15,C2,C20,C3,C4,C5,C6,C7 | 22 | 立创 / 5 / 5 | ¥2.0223 | 25 / ¥50.56 | 22只10µF/50V分布在输入、高压储能与六组源极电容；华瓷候选仅标称参数通过，偏压/ESR/纹波尚待验证。 |
| [RC0603FR-07110KL](https://item.szlcsc.com/149123.html)<br>R8 | 1 | 立创 / 100 / 100 | ¥0.0333 | 100 / ¥3.33 | 反馈分压110kΩ；可同规格换品牌，不能用100kΩ替换。 |
| [MSS1246-153MLC](https://br.mouser.com/en/ProductDetail/Coilcraft/MSS1246-153MLC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)<br>L1,L2,L3 | 3 | Mouser / 1 / 1 | USD 2.14 | 3 / USD 6.42 | 不同地区缓存为1/203/215只，不能相加或按203只保证现货；部分页200只预计2026-11-30，厂期13周。原厂网页同时显示不可购买配置。 |
| [RC0603FR-0716KL](https://item.szlcsc.com/149104.html)<br>R18 | 1 | 立创 / 100 / 100 | ¥0.0301 | 100 / ¥3.01 | 反馈分压16kΩ；保持阻值和精度。 |
| [RC0603FR-071ML](https://item.szlcsc.com/106793.html)<br>R13,R2,R3 | 3 | 立创 / 100 / 100 | ¥0.0254 | 100 / ¥2.54 | 高阻反馈/偏置；可同规格换品牌，保留1MΩ±1%。 |
| [C0805C102J5GACTU](https://www.digikey.cn/zh/products/detail/kemet/C0805C102J5GACTU/411135)<br>C36 | 1 | DigiKey / 1 / 1 | ¥1.41 | 1 / ¥1.41 | 负载开关CT定时；1nF/50V C0G±5% 0805。不能简单换X7R或删除。 |
| [GRM21BR71H105KA12L](https://item.szlcsc.com/78210.html)<br>C22,C25 | 2 | 立创 / 10 / 10 | ¥0.2589 | 10 / ¥2.59 | 高压滤波/去耦；保留1µF/50V X7R 0805。 |
| [RC0603FR-072R2L](https://www.digikey.com/en/products/detail/yageo/RC0603FR-072R2L/2827592)<br>R10,R19 | 2 | DigiKey / 1 / 1 | USD 0.1 | 2 / USD 0.20 | 小阻值支路；保留2.2Ω及功率/脉冲能力。 |
| [GRM32ER71H225KA88L](https://www.oneyac.com/product/245271.html)<br>C28 | 1 | 原件未解决，见第8节 | 无有效报价 | 另有候选 | 滤波/定时支路；保留2.2µF/50V X7R 1210。 |
| [GRM21BR71H224KA01L](https://item.szlcsc.com/87218.html)<br>C18 | 1 | 立创 / 5 / 5 | ¥0.6756 | 5 / ¥3.38 | 滤波；保留220nF/50V X7R 0805。 |
| [RC0603FR-072KL](https://item.szlcsc.com/106791.html)<br>R1 | 1 | 立创 / 100 / 100 | ¥0.0135 | 100 / ¥1.35 | 反馈/偏置2kΩ；可同规格换品牌。 |
| [GRM32DR71H335KA88L](https://www.digikey.com/en/products/detail/murata-electronics/GRM32DR71H335KA88L/702649)<br>C105,C108,C111,C114,C117,C120 | 6 | DigiKey / 1 / 1 | USD 1.29 | 6 / USD 7.74 | NRND但有库存；保留精确原料号。另有Unikey MOQ5/倍数5，5+USD0.4013，独立渠道须核验批次/供货及到手费。 |
| [RC0603FR-0733RL](https://www.digikey.cn/zh/products/detail/yageo/RC0603FR-0733RL/727158)<br>R39,R40,R41,R42,R43 | 5 | DigiKey / 1 / 1 | ¥0.207 | 10 / ¥2.07 | 5只USD/CNY档差异以对应站点价格为准；单件起订，但买10只¥2.07比买5只¥4.15便宜。 |
| [TSW-102-07-G-S](https://www.digikey.cn/zh/products/detail/samtec-inc/TSW-102-07-G-S/1101325)<br>J1 | 1 | DigiKey / 1 / 1 | ¥1.74 | 1 / ¥1.74 | 调试电源入口；可选择尺寸匹配的2.54mm 1×2直排针，按额定电流和插接高度核对。 |
| [RC0603FR-074K3L](https://item.szlcsc.com/149028.html)<br>R7 | 1 | 立创 / 100 / 100 | ¥0.0224 | 100 / ¥2.24 | 反馈分压4.3kΩ；不能用4.7kΩ代替。 |
| [RC0603FR-074K7L](https://item.szlcsc.com/100996.html)<br>R20,R21 | 2 | 立创 / 100 / 100 | ¥0.0202 | 100 / ¥2.02 | 接口上拉4.7kΩ；可同规格换品牌。 |
| [GRM32ER71H475KA88L](https://item.szlcsc.com/87228.html)<br>C12,C14,C16,C19,C21,C29,C30,C8 | 8 | 立创 / 5 / 5 | ¥0.8859 | 10 / ¥8.86 | 高压储能/电荷泵；保留4.7µF/50V X7R 1210。 |
| RC0603FR-07400KL<br>R17 | 1 | 原件未解决，见第8节 | 无有效报价 | 另有候选 | 反馈分压400kΩ；常见390kΩ不等价；需先重算输出才可改值。 |
| [GRM21BR71H474KA88L](https://item.szlcsc.com/87219.html)<br>C10,C11,C17,C23,C24,C9 | 6 | 立创 / 10 / 10 | ¥0.4347 | 10 / ¥4.35 | 高压电荷泵/滤波；保留470nF/50V X7R 0805。 |
| [GRM188R71H473KA61D](https://www.digikey.com/en/products/detail/murata-electronics/GRM188R71H473KA61D/702551)<br>C26 | 1 | 原件未解决，见第8节 | 无有效报价 | 另有候选 | 原页面标为停产；候选三星CL10B473KB8NNNC需核对尺寸/有效容量，保持47nF/50V X7R。 |
| [B0530W-7-F](https://www.digikey.cn/zh/products/detail/diodes-incorporated/B0530W-7-F/815315)<br>D4 | 1 | DigiKey / 1 / 1 | ¥2.23 | 1 / ¥2.23 | 采用页面¥2.23剪切带保守报价；其他缓存显示¥2.00，不能混用梯度。 |
| [BAT54S-7-F](https://item.szlcsc.com/84739.html)<br>D3,D5,D6 | 3 | 立创 / 5 / 5 | ¥0.7044 | 5 / ¥3.52 | 串联双肖特基；须保持BAT54S连接形式及引脚，不能换BAT54A/C或单管BAT54。 |
| [DMN3065LW-7](https://item.szlcsc.com/161844.html)<br>Q1,Q4 | 2 | 立创 / 5 / 5 | ¥1.725 | 5 / ¥8.63 | 升压/偏置N-MOS；保留SOT-323脚位、3.3V栅压下Rds(on)、Qg和耐压。 |
| [DMP3068L-7](https://item.szlcsc.com/162350.html)<br>Q8 | 1 | 立创 / 5 / 5 | ¥1.3727 | 5 / ¥6.86 | 负电源P-MOS；核对Vgs=-2.5/-3.3V的导通能力和负压尖峰。 |
| [FPC-05FB-60PH20](https://item.szlcsc.com/3056937.html)<br>FPC1 | 1 | 立创 / 1 / 1 | ¥2.451 | 1 / ¥2.45 | 已匹配60Pin/0.5mm/0.3mm排线的插座；保留原型号，避免接触面/锁扣/焊盘不符。 |
| [TSW-108-07-G-D](https://www.digikey.cn/zh/products/detail/samtec-inc/TSW-108-07-G-D/1101269)<br>J2 | 1 | DigiKey / 1 / 1 | ¥11.99 | 1 / ¥11.99 | 厂方2096只，按订单供货，页面厂期2周；另缓存现货1676，按保守厂方供货处理。 |
| [MBR230S1F-7](https://www.digikey.cn/zh/products/detail/diodes-incorporated/MBR230S1F-7/4948462)<br>D1,D2 | 2 | DigiKey / 1 / 1 | ¥4.88 | 2 / ¥9.76 | 功率肖特基；保留30V/2A、SOD-123F，核对生命周期及尖峰余量。 |
| [MMBT3904-7-F](https://item.szlcsc.com/95712.html)<br>Q6 | 1 | 立创 / 10 / 10 | ¥0.3922 | 10 / ¥3.92 | NPN驱动；廉价同类须确认SOT-23脚位、增益/电流/耐压。 |
| [MMBT3906-7-F](https://item.szlcsc.com/83922.html)<br>Q3 | 1 | 立创 / 10 / 10 | ¥0.3728 | 10 / ¥3.73 | PNP驱动；不能拿NPN替换，核对脚位/增益/耐压。 |
| [PJA3433_R1_00001](https://www.digikey.cn/zh/products/detail/panjit-international-inc/PJA3433-R1-00001/14661637)<br>Q7 | 1 | DigiKey / 1 / 1 | ¥2.65 | 1 / ¥2.65 | 精确P-MOS原型号；另页面库存1只，需复核9,001库存，贸泽有原型号小量报价备选；型号驱动疑问不因有货而解决。 |
| [TCN75AVOA713](https://item.szlcsc.com/155645.html)<br>U4 | 1 | 立创 / 1 / 1 | ¥7.8 | 1 / ¥7.80 | I2C温度传感器；影响温度适配，保留Microchip原型号。国产同名不是已验证等价件。 |
| [TPS22917DBVR](https://item.szlcsc.com/2775165.html)<br>U5 | 1 | 立创 / 5 / 5 | ¥2.4481 | 5 / ¥12.24 | 受控供电/软启动/反向阻断；保留非L的TPS22917，不用普通MOS直接替换。 |

## 5. 方案A：兼容现有PCB的采购优化

### 5.1 先保留电路，只改采购渠道

普通电阻可考虑合格的厚声/富捷等品牌或淘宝小份装，保持封装、阻值、精度、功率、工作电压与温漂。0603是英制1608公制，不能买成公制0603的0201器件。R17仍需400kΩ，390kΩ不能直接代替；R7的4.3kΩ不能用4.7kΩ代替。U1/U2/U3是200mΩ采样电阻，需单独核验，不能混在普通电阻套装里。

J1/J2原Samtec型号已有第4节报价；也可采购尺寸匹配的普通直排针。普通替代排针尚未获得可确认的具体料号和报价，不能把任意2.54mm排针认定为已审核替代。购买前确认1×2/2×8、针距、针宽、孔径、插接高度、尾针长度和电流。FPC1继续保留。

### 5.2 华瓷10µF/50V：值得验证的主要降本候选

候选HGC1210R7106K500NSVK（C7472976）标称1210、10µF±10%、50V、X7R，与原型号标称参数相符。原厂通用系列承认书支持型号编码，但没有足够的本型号直流偏压曲线证明22处全部等价。**状态：同焊盘候选，尚未批准写入正式BOM。**

| 场景 | 原村田付款 | 华瓷候选付款 | 潜在减少 |
|---|---:|---:|---:|
| 1板，无备品 | 25只 / ¥50.56 | 25只 / ¥37.08 | ¥13.48 |
| 1板，含备品 | 25只 / ¥50.56 | 25只 / ¥37.08 | ¥13.48 |
| 5板，无备品 | 110只 / ¥182.18 | 110只 / ¥129.87 | ¥52.32 |
| 5板，含备品 | 115只 / ¥190.46 | 115只 / ¥135.77 | ¥54.69 |

替换前逐网记录电容两端最大直流电压和纹波，取得原件与候选的有效容量、ESR/阻抗和温升数据；检查六组源极储能、高压输出、输入去耦各自的要求。首板测启动、满屏刷新、掉电、纹波与温升，不能拿“50V、10µF”标称值证明偏压后的容量满足要求。保持50V耐压，不降成16V/25V，不删并联支路。

其他两款三星候选没有实际采购优势：CL32B106KBJNNNE无现货，22只按10+档为¥35.16但交期未确认；CL32B106KBJNNWE仅3只现货，22只报价¥80.96且库存不足。不能算入当前可采购方案。

### 5.3 原47nF电容停产

GRM188R71H473KA61D页面标注停产。候选CL10B473KB8NNNC（C1622）为0603、47nF±10%、50V、X7R，原厂标称参数匹配；100只起订、购买倍数100，付款¥3.57。仍需最终尺寸/偏压核对。此项是解决可采购性，原件无现行价格，不能证明节省金额。

### 5.4 方案A预算如何理解

原件路线还有3项采购障碍；第8节提供采用三项候选的条件性全38组货值，另计税运和订单门槛。若华瓷候选验证通过，只对相同24组覆盖范围比较，小计可分别减少上表金额；C26替代新增¥3.57，但原C26本来未计价，不能把它加进差额后声称是整板节省。其余未批准器件仍保持原型号。

## 6. 方案B：允许重新布局的电感及料号合并优化

方案B继承方案A的采购思路，并新增以下候选；本轮没有实施PCB改版。

### 6.1 15µH电感

原Coilcraft MSS1246-153MLC：15µH±20%，DCR最大54.1mΩ，Isat按电感下降10%/20%/30%分别为4.6/5.2/5.5A，Irms按温升20/40℃分别为2.85/3.8A。不同厂商的“额定电流”不能直接对比。国内精确型号报价未确认，不用原厂美元价格估算国内付款。

候选SMMS1050-150M（C149545）网页列15µH±20%、55mΩ、4.5A额定电流和7A饱和电流。原厂系列资料给出30VDC绝缘最大值；**饱和电流判据、尺寸/焊盘、最大DCR和尖峰余量仍需具体型号承认书确认**。不同封装不能直接作为现有MSS1246的替代。3只买5只约¥7.58；5板15只买15只约¥22.74；这只是候选支路人民币货值，原件已有美元报价；须统一币种并纳入运费才可比较节省。

重新设计前量出L1–L3的峰值和有效值电流，确认候选在该电流下的实际电感和温升；检查输入与负压开关节点的线圈端电压及尖峰是否满足30V限制。再画准确焊盘、调整开关回路并重跑ERC、DRC和KiCad实际打开验证。未验证前继续原型号；不优先采用只有“15µH/4.5A”而缺Isat数据的普通电感。

### 6.2 六个3.3µF并入4.7µF型号

当前每组3×10+3.3=33.3µF。把六个3.3µF都换成既有4.7µF可变成34.7µF，数量仍为103个，型号组数由38变37；仅减少料号，不减少焊点。需要重新检查有效容量、软启动、充电电流与掉电时间。此改动保持现有1210封装，但影响电气参数，属于设计变更候选。

合并后4.7µF总数由8变14：1板无备品买15只付款¥13.29，相比原4.7µF行多付¥4.43，再减去原3.3µF采购费才是净变化；5板买70只进入50+档约¥51.26，相比原40只费用多¥15.83。原3.3µF已有得捷美元报价，跨渠道的净节省仍需结合汇率、税运及设计核验后比较。含备品应对合并后一个型号只加2件，CSV中的合并候选行不能再与原8只行相加。

不建议为了料号数量把反馈电阻强行改成常见阻值，也不建议把六组高压陶瓷储能换成未经核验的单个铝电解。方案B替代电感/容量变更仍待核验，税运和供货条件也未锁定，尚不能声称一定比A便宜。

## 7. 淘宝少量采购：可以做，但按订单比较

淘宝适合尝试普通电阻小份装、普通排针，以及明确原型号的少量半导体。优先集中到一两家店，运费可能抵消节省。高压电容需明确品牌和完整MPN，电感需承认书；仅写“1210 106”“15µH 4.5A”的商品不能直接通过筛选。

### 7.1 本轮找到的公开线索

| 线索 | 用途 | 核验状态 |
|---|---|---|
| [深圳优信：三星CL32B475KBJNNNE线索](https://tao.hooos.com/goods_554770281885.html) | 4.7µF/50V/1210/X7R候选，淘宝商品ID 554770281885 | 聚合站旧索引，现行SKU价格、份数、库存及运费未核实；不计入预算 |
| [1210 10µF多耐压商品线索](https://tao.hooos.com/goods_600334862127.html) | 淘宝/天猫商品ID 600334862127 | 多规格链接；须选50V/X7R，品牌及MPN待确认；不使用首页最低价 |
| [110kΩ少量电阻线索](https://tao.hooos.com/tag_110k%E7%94%B5%E9%98%BB.html) | 索引有0603、110kΩ、1%、50只装 | 非实时卖家报价；可在淘宝按完整规格检索，不计入预算 |

淘宝直接页面的电脑控制被工具禁止，登录不会解除此限制；公开检索未得到足以核算现行淘宝订单的价格、SKU份数和运费，因此CSV没有虚构淘宝现价。聚合站的促销价仅作为找商品的线索；规格判断仍使用原厂资料。

### 7.2 值得下单的价格边界

以下为1板无备品的立创付款基准。淘宝对应的合格数量包价加**该订单新增运费**低于此数，才有付款优势；买少了要按包装份数向上取整。已有同店其他商品时，可按整个订单的增量费用比较。

| 采购对象 | 至少装配需求 | 立创付款基准 | 淘宝判断 |
|---|---:|---:|---|
| 原型号10µF/50V | 22只 | ¥50.56 | 同原型号且足量，到手费用低于此值才省；华瓷候选验证后基准降到¥37.08 |
| 原型号100µF/6.3V | 2只 | ¥14.64 | 封装/有效容量相符；不要用铝电解当作直接替代 |
| TPS22917DBVR | 1只 | ¥12.24（立创买5只） | 可寻找单只原型号，但含运费和备品后重新比较；不能买L版本 |
| DMN3065LW-7 | 2只 | ¥8.63（买5只） | 原型号/脚位与SOT-323相符 |
| DMP3068L-7 | 1只 | ¥6.86（买5只） | 注意P沟道、完整型号与低栅压导通能力 |
| TCN75AVOA713 | 1只 | ¥7.80 | 立创已1只起订；淘宝同型号不一定更便宜 |
| FPC-05FB-60PH20 | 1只 | ¥2.45 | 低价本身不值得冒机械不兼容风险 |
| R8：110kΩ 0603 1% | 1只 | ¥3.33（买100只） | 小份装有机会降低付款；不要把套装中100k/120k当作110k |

普通电阻按CSV每个型号的付款比较。例：100kΩ原件买100只仅¥1.58，有些淘宝小份装反而更贵。套装常缺1.5k、2.2Ω、4.3k、16k、110k、400k等确切数值，先核清内容再买。淘宝的“原装”标题不是完成型号核验的证据。

可复制给卖家的询价要求：完整品牌/MPN、封装、所选SKU、每份件数、所需份数、是否新料、批次、实际库存、运费与预计发货时间；电容补充耐压/介质，电感补充DCR及Isat判据/Irms/尺寸图。确认后再把有效报价补入CSV。

## 8. 原14组缺价项的最新处理

已逐项扩展得捷、贸泽、唯样、Farnell及独立经销商渠道，完整链接、币种、阶梯价、库存冲突和候选依据见[缺价14组其他渠道采购核查](缺价14组其他渠道采购核查.md)。11组原型号有报价；C26、C28、R17按明确候选核验。配套CSV已补报价币种和供货状态列，外币报价的CNY金额留空。

得捷人民币官方说明存在300元最低订购金额；不能把单件MOQ与整单门槛混为一谈。电感少量库存快照冲突，尚不能保证3只即刻供货。条件性全38组货值有了估算，但完整现货及最终到手费用仍未闭环。

## 9. 关键原厂依据与查价依据

- [华瓷通用MLCC承认书](https://www.chinocera.com/Public/Upload/file/2025/0513/20250513084503590.pdf)：型号编码、尺寸与介质；尚不足以证明该候选的有效容量。
- [华瓷候选规格书（商城提供的厂商资料）](https://atta.szlcsc.com/upload/public/pdf/source/20260723/7EB3BDFEECF66494B0D077AF4F87288B.pdf)：替换前应进一步核对具体偏压数据。
- [三星CL10B473KB8NNN系列](https://product.samsungsem.com/mlcc/CL10B473KB8NNN.do)；[三星CL32B106KBJNNN系列](https://product.samsungsem.com/mlcc/CL32B106KBJNNN.do)：标称规格及型号后缀。
- [Coilcraft MSS1246-153](https://www.coilcraft.com/zh-cn/products/power/shielded-inductors/ferrite-drum/mss-mos/mss1246/mss1246-153/)；[SXN SMMS系列原厂资料（商城托管）](https://atta.szlcsc.com/upload/public/pdf/source/20210810/BBF24330FB2F5029F637830BA9C42C0D.pdf)：电流/封装/绝缘要求。
- [TI TPS22917数据手册](https://www.ti.com/lit/ds/symlink/tps22917.pdf)：保持软启动/反向阻断及正确版本。
- [Panjit PJA3433原厂资料](https://www.panjit.com.cn/upload/datasheet/PJA3433.pdf)：本轮保留型号，驱动问题独立验证。
- 价格来源为第4节商品直链与CSV中的“价格来源”；查价日期均为2026-10-08。24组实时价是当日浏览器可见报价，不是搜索摘要的宣传最低价。

## 10. 文件核对记录

CSV包含38条原型号记录及8条候选记录，原型号装配数量合计103；候选行不能追加到原BOM相加。核对了1/5板、起订量、购买倍数、梯度选择及备品计算。KiCad及release文件本轮内容不变；未把本次价格分析当作新增电气验证。
