Rhys-Q/album/hardware/pcb/gdep133c02-driver/models/R_0805_2012Metric.step

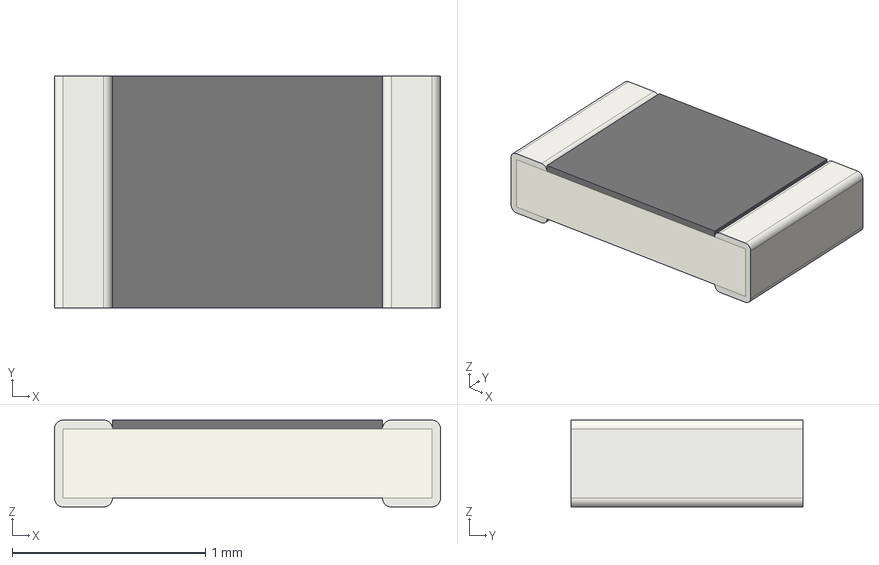
[picture p3: CAD file, 2026-10-07]
hardware/pcb/gdep133c02-driver/models/R_0805_2012Metric.step
2.00 x 1.20 x 0.45 mm
