Rhys-Q/album/hardware/pcb/gdep133c02-driver/models/D_SOD-123.step

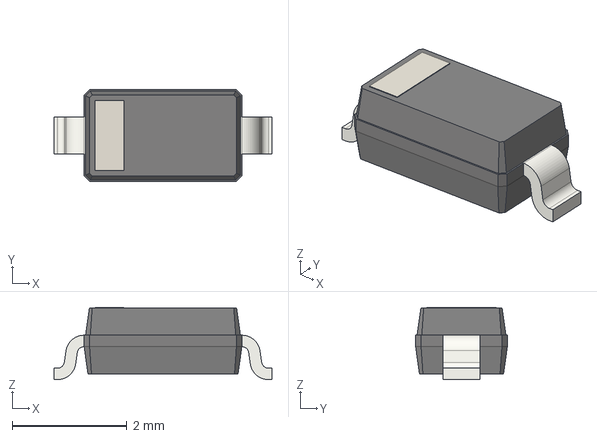
[picture p4: CAD file, 2026-10-02]
hardware/pcb/gdep133c02-driver/models/D_SOD-123.step
3.80 x 1.60 x 1.26 mm
