Rhys-Q/album/hardware/pcb/gdep133c02-driver/models/SOT-23.step

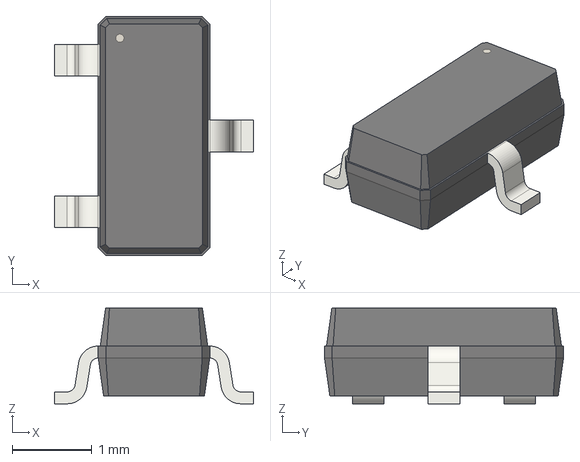
[picture p6: CAD file, 2026-10-02]
hardware/pcb/gdep133c02-driver/models/SOT-23.step
2.50 x 3.00 x 1.20 mm
