Rhys-Q/album/hardware/pcb/gdep133c02-driver/models/L_Coilcraft_MSS1246T-XXX.step

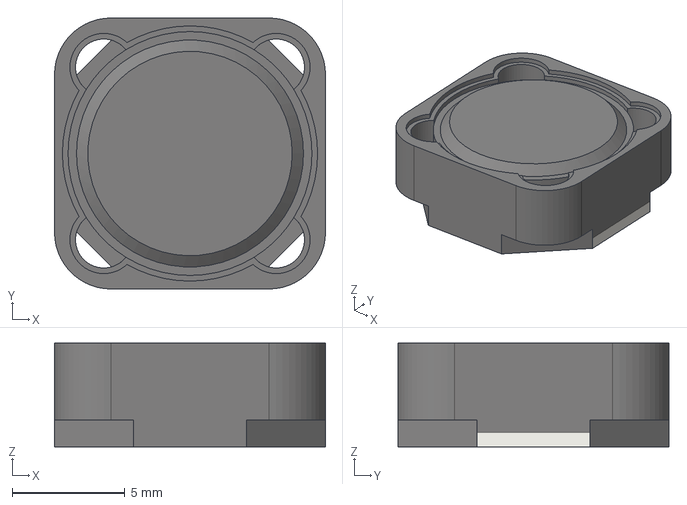
[picture p7: CAD file, 2026-10-02]
hardware/pcb/gdep133c02-driver/models/L_Coilcraft_MSS1246T-XXX.step
12.0 x 12.0 x 4.60 mm
