Rhys-Q/album/hardware/pcb/gdep133c02-driver/models/SOIC-8_3.9x4.9mm_P1.27mm.step

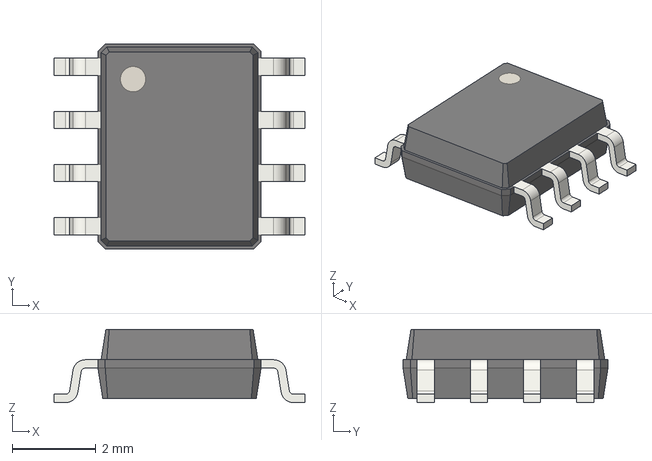
[picture p8: CAD file, 2026-10-02]
hardware/pcb/gdep133c02-driver/models/SOIC-8_3.9x4.9mm_P1.27mm.step
6.00 x 4.90 x 1.75 mm
