Rhys-Q/album/hardware/pcb/gdep133c02-driver/models/R_1206_3216Metric.step

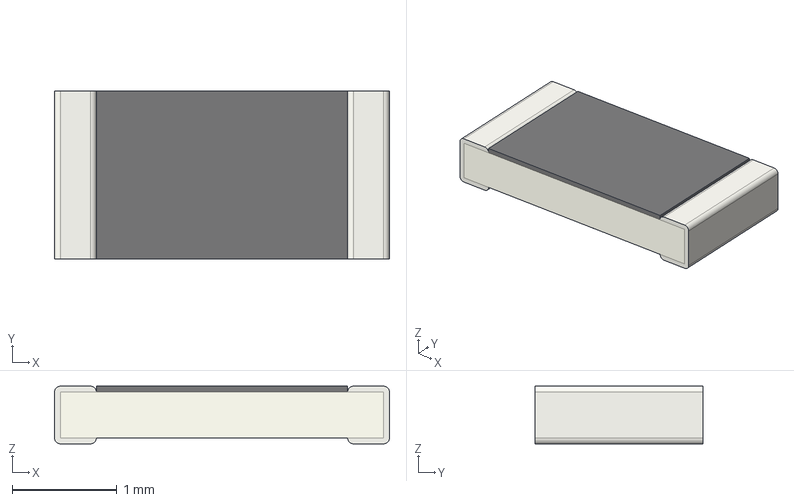
[picture p9: CAD file, 2026-10-02]
hardware/pcb/gdep133c02-driver/models/R_1206_3216Metric.step
3.20 x 1.60 x 0.55 mm
