Rhys-Q/album/hardware/pcb/gdep133c02-driver/models/C_1210_3225Metric.step

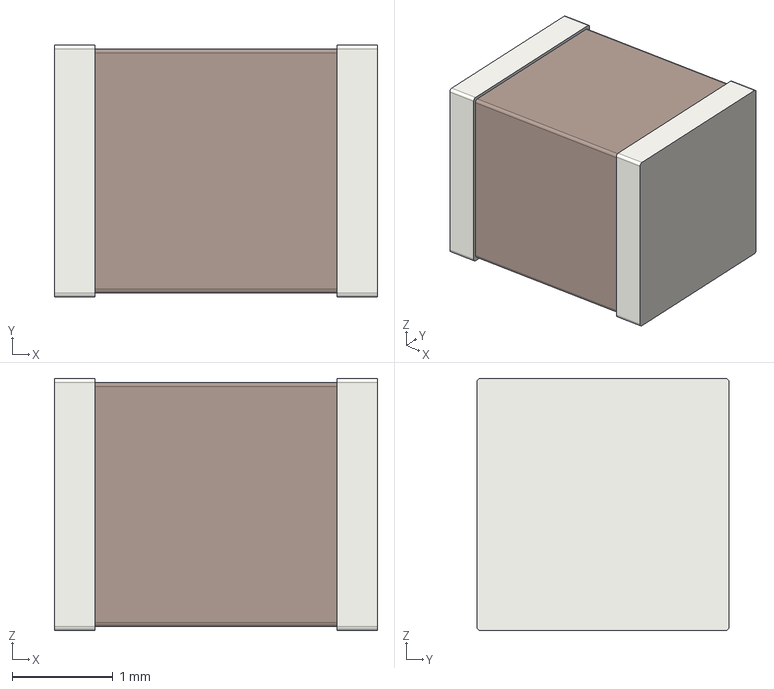
[picture p10: CAD file, 2026-10-02]
hardware/pcb/gdep133c02-driver/models/C_1210_3225Metric.step
3.20 x 2.50 x 2.50 mm
