Rhys-Q/album/hardware/pcb/gdep133c02-driver/models/PinHeader_2x08_P2.54mm_Vertical.step

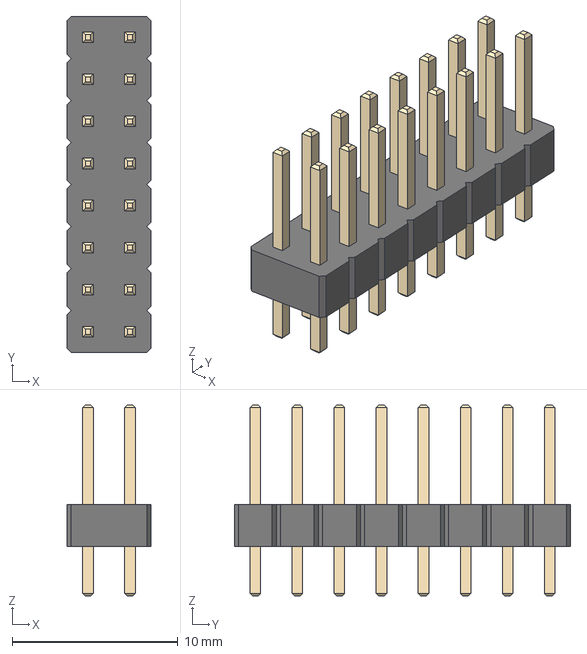
[picture p11: CAD file, 2026-10-02]
hardware/pcb/gdep133c02-driver/models/PinHeader_2x08_P2.54mm_Vertical.step
5.08 x 20.3 x 11.5 mm
