Rhys-Q/album/hardware/pcb/gdep133c02-driver/models/C_0805_2012Metric.step

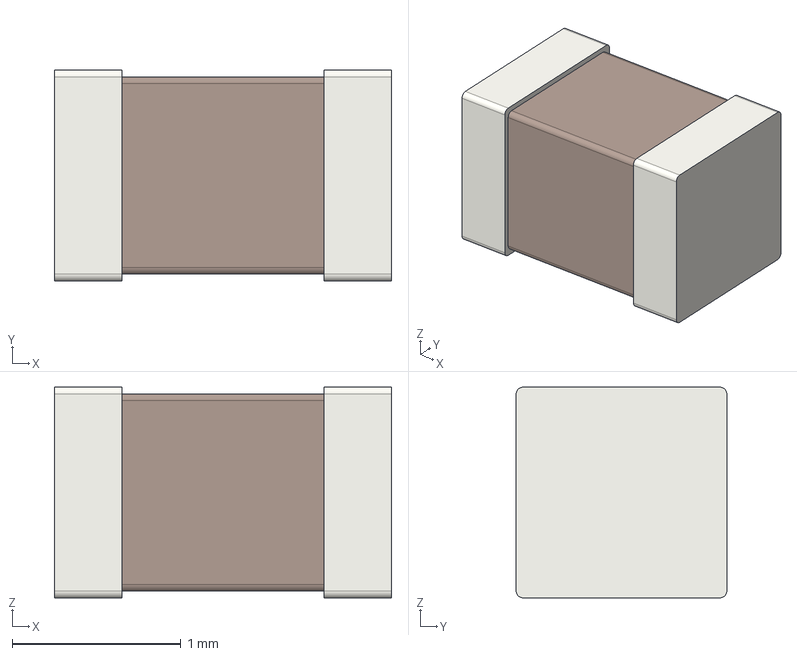
[picture p12: CAD file, 2026-10-02]
hardware/pcb/gdep133c02-driver/models/C_0805_2012Metric.step
2.00 x 1.25 x 1.25 mm
