Rhys-Q/album/hardware/pcb/gdep133c02-driver/models/C_0603_1608Metric.step

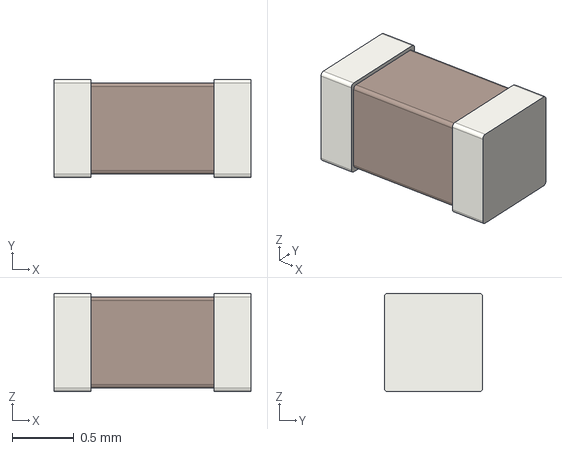
[picture p13: CAD file, 2026-10-02]
hardware/pcb/gdep133c02-driver/models/C_0603_1608Metric.step
1.60 x 0.8 x 0.8 mm
