Rhys-Q/album/hardware/pcb/gdep133c02-driver/models/D_SOD-123F.step

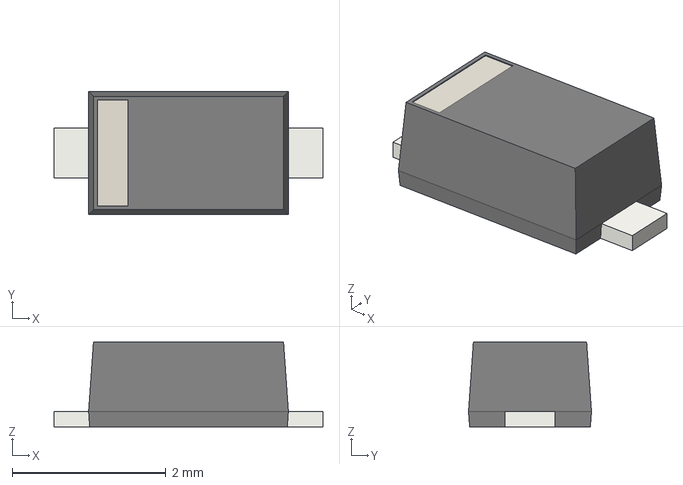
[picture p14: CAD file, 2026-10-02]
hardware/pcb/gdep133c02-driver/models/D_SOD-123F.step
3.50 x 1.60 x 1.10 mm
