Rhys-Q/album/hardware/pcb/gdep133c02-driver/models/PinHeader_1x02_P2.54mm_Vertical.step

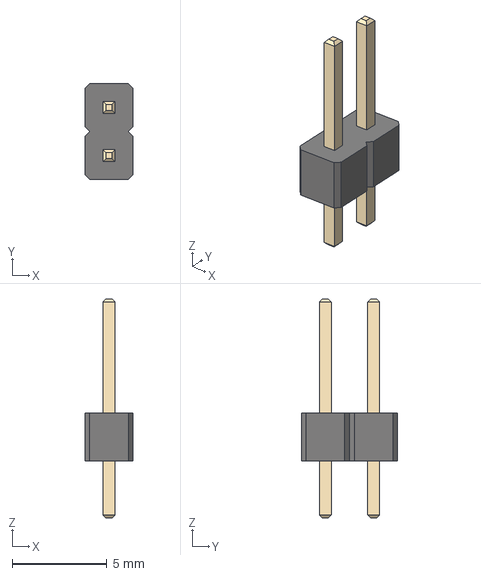
[picture p15: CAD file, 2026-10-02]
hardware/pcb/gdep133c02-driver/models/PinHeader_1x02_P2.54mm_Vertical.step
2.54 x 5.08 x 11.5 mm
