Rhys-Q/album/hardware/pcb/gdep133c02-driver/models/SOT-323_SC-70.step

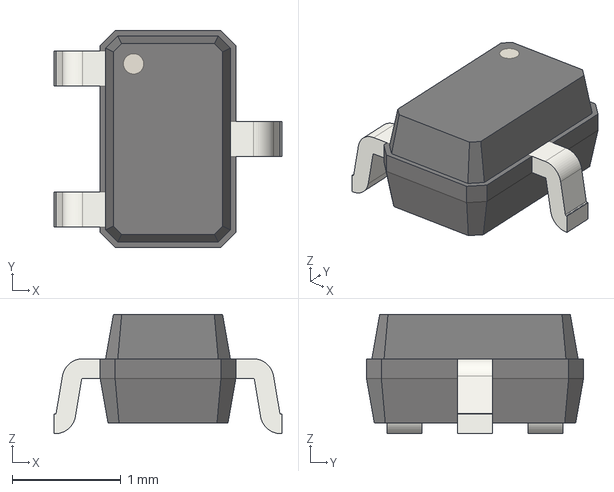
[picture p16: CAD file, 2026-10-02]
hardware/pcb/gdep133c02-driver/models/SOT-323_SC-70.step
2.10 x 2.00 x 1.10 mm
