Rhys-Q/album/firmware/gdep133c02-eval/docs/validation.md

# 验证记录

目标：自制驱动板 v0.11 + 微雪 ESP32-S3-DEV-KIT-N8R8。
工具版本采用用户本机 ESP-IDF v6.1，提交 `fff9895c82d744c7237be8847347bdd1b07c6643`。最终结果和产物哈希见软件 release 的 `verification.json`。

## 软件检查

- 干净构建：以独立 `build/idf6.1` 目录构建，不沿用5.5.1或厂家build。
- C测试：EPF精确长度、字段、保留字、CRC、非法索引；六色色码、旋转和主从拼接；完整事务中每个SPI调用失败点；BUSY一直高、一直低及命令期间短忙脉冲；故障锁存；正常POF/深睡顺序。
- Python测试：打包、非法输入、等比留白、透明背景白底。
- 代码检查不替代示波器测量；不自动连接、烧录用户硬件。

## 实板记录（全部待测）

| 项目 | 记录内容 | 状态 |
|---|---|---|
| 启动默认关闭 | EN、SCLK、MOSI、CS、RESET，BUSY/MISO无反灌 | 未测 |
| 存储与串口 | 8MB PSRAM、115200日志、无屏不复位 | 未测 |
| 上电/复位 | J1输入、软启动、RESET、BUSY波形 | 未测 |
| 主从通信 | F2原始三字节、片选及SPI时序 | 未测 |
| 六色/方向 | 四角、边框、拼接、照片 | 未测 |
| 刷新时序 | PON/DRF/POF置忙延迟与忙时长 | 未测 |
| 电源/温升 | 刷新峰值、压降、高压纹波、元器件温升 | 未测 |
| 正常关机 | 07/A5、接口低、EN低、各高压轨残压/衰减 | 未测 |
| 故障恢复 | 不无限重试、不误报成功；受控恢复过程 | 未测 |
| 温度范围 | 温度相关初始化及室温以外显示 | 未测 |

实板填写：硬件版本与修改、屏幕标签、固件SHA、输入电源/限流、仪器、测试图、日志、波形文件和判定。不能以 `result=0` 代替光学和电气验收。
