Rhys-Q/album/hardware/pcb/gdep133c02-driver/reports/schematic.pdf

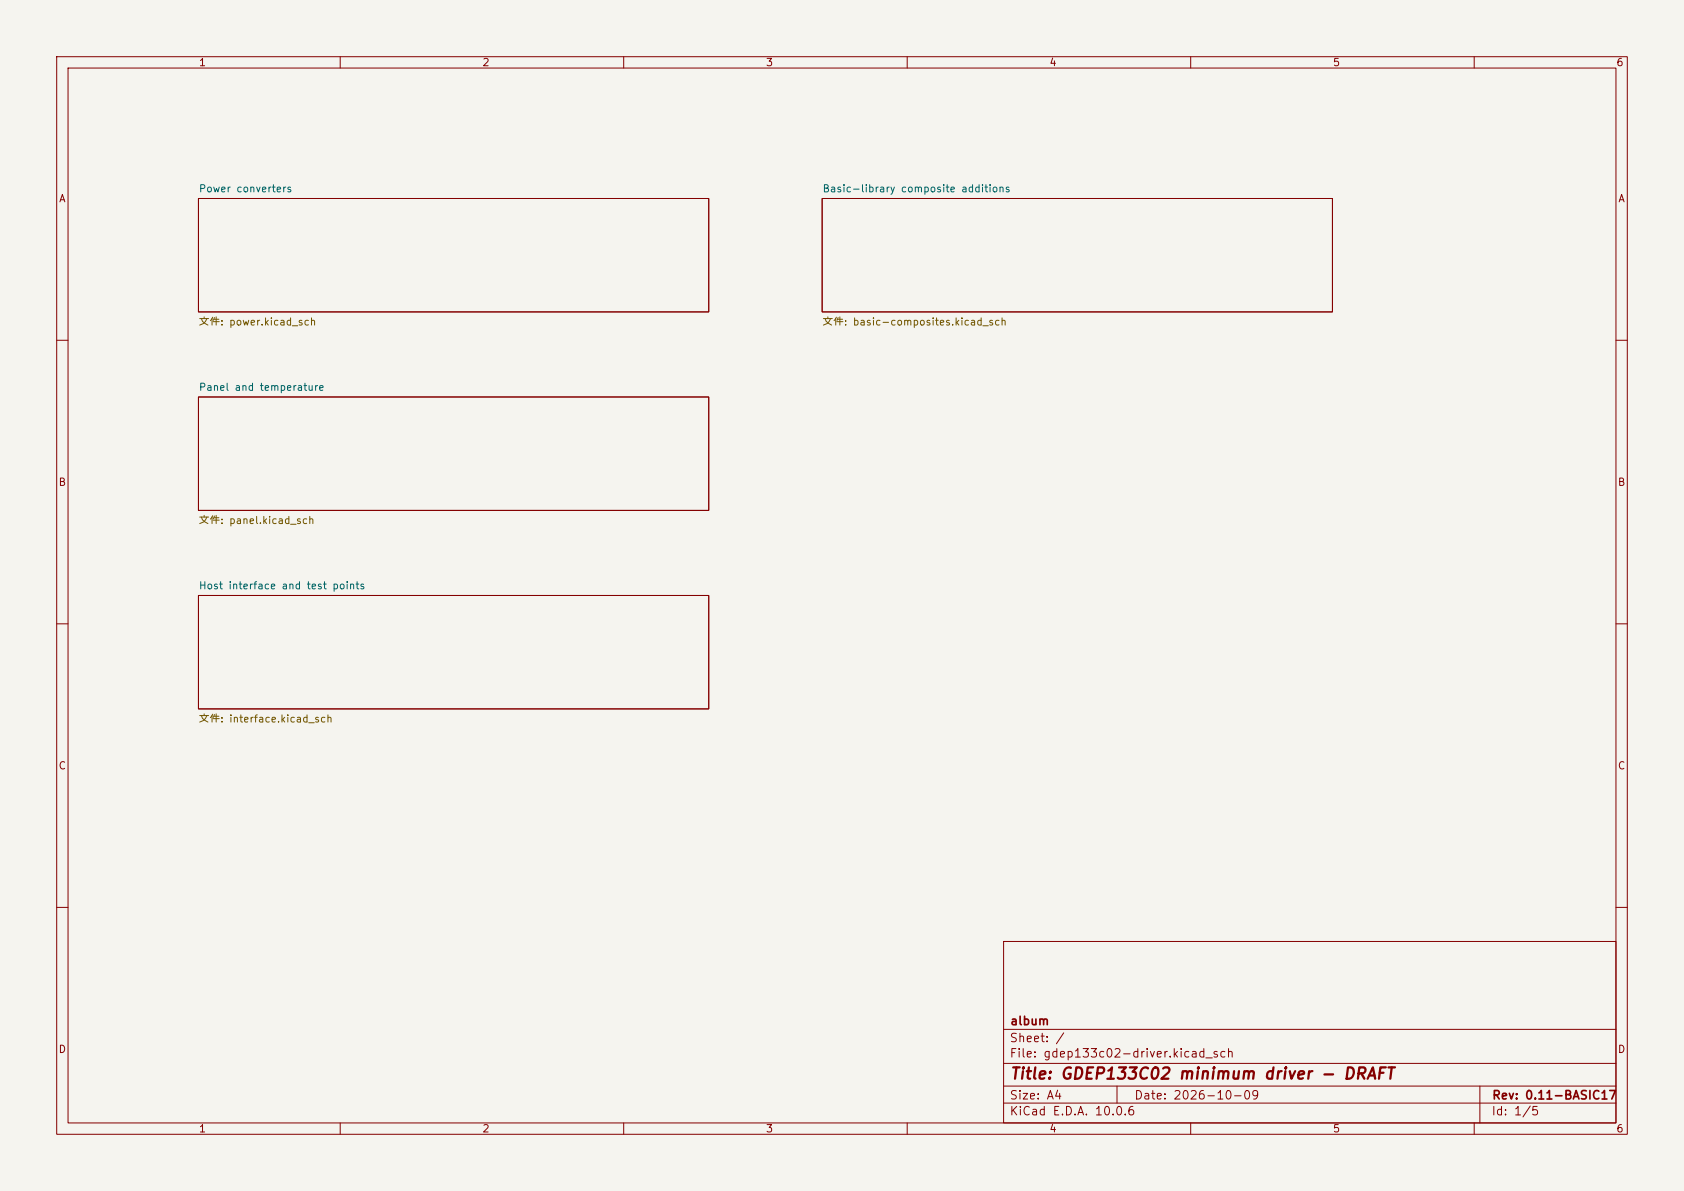
[picture p17: page 1]

Power converters 文件: power.kicad_sch Panel and temperature

Basic-library composite additions 文件: basic-composites.kicad_sch

Host interface and test points

album
Sheet: /
File: gdep133c02-driver.kicad_sch
Title: GDEP133C02 minimum driver - DRAFT

Size: A4 | Rev: 0.11-BASIC17
KiCad E.D.A. 10.0.6 | Id: 1/5

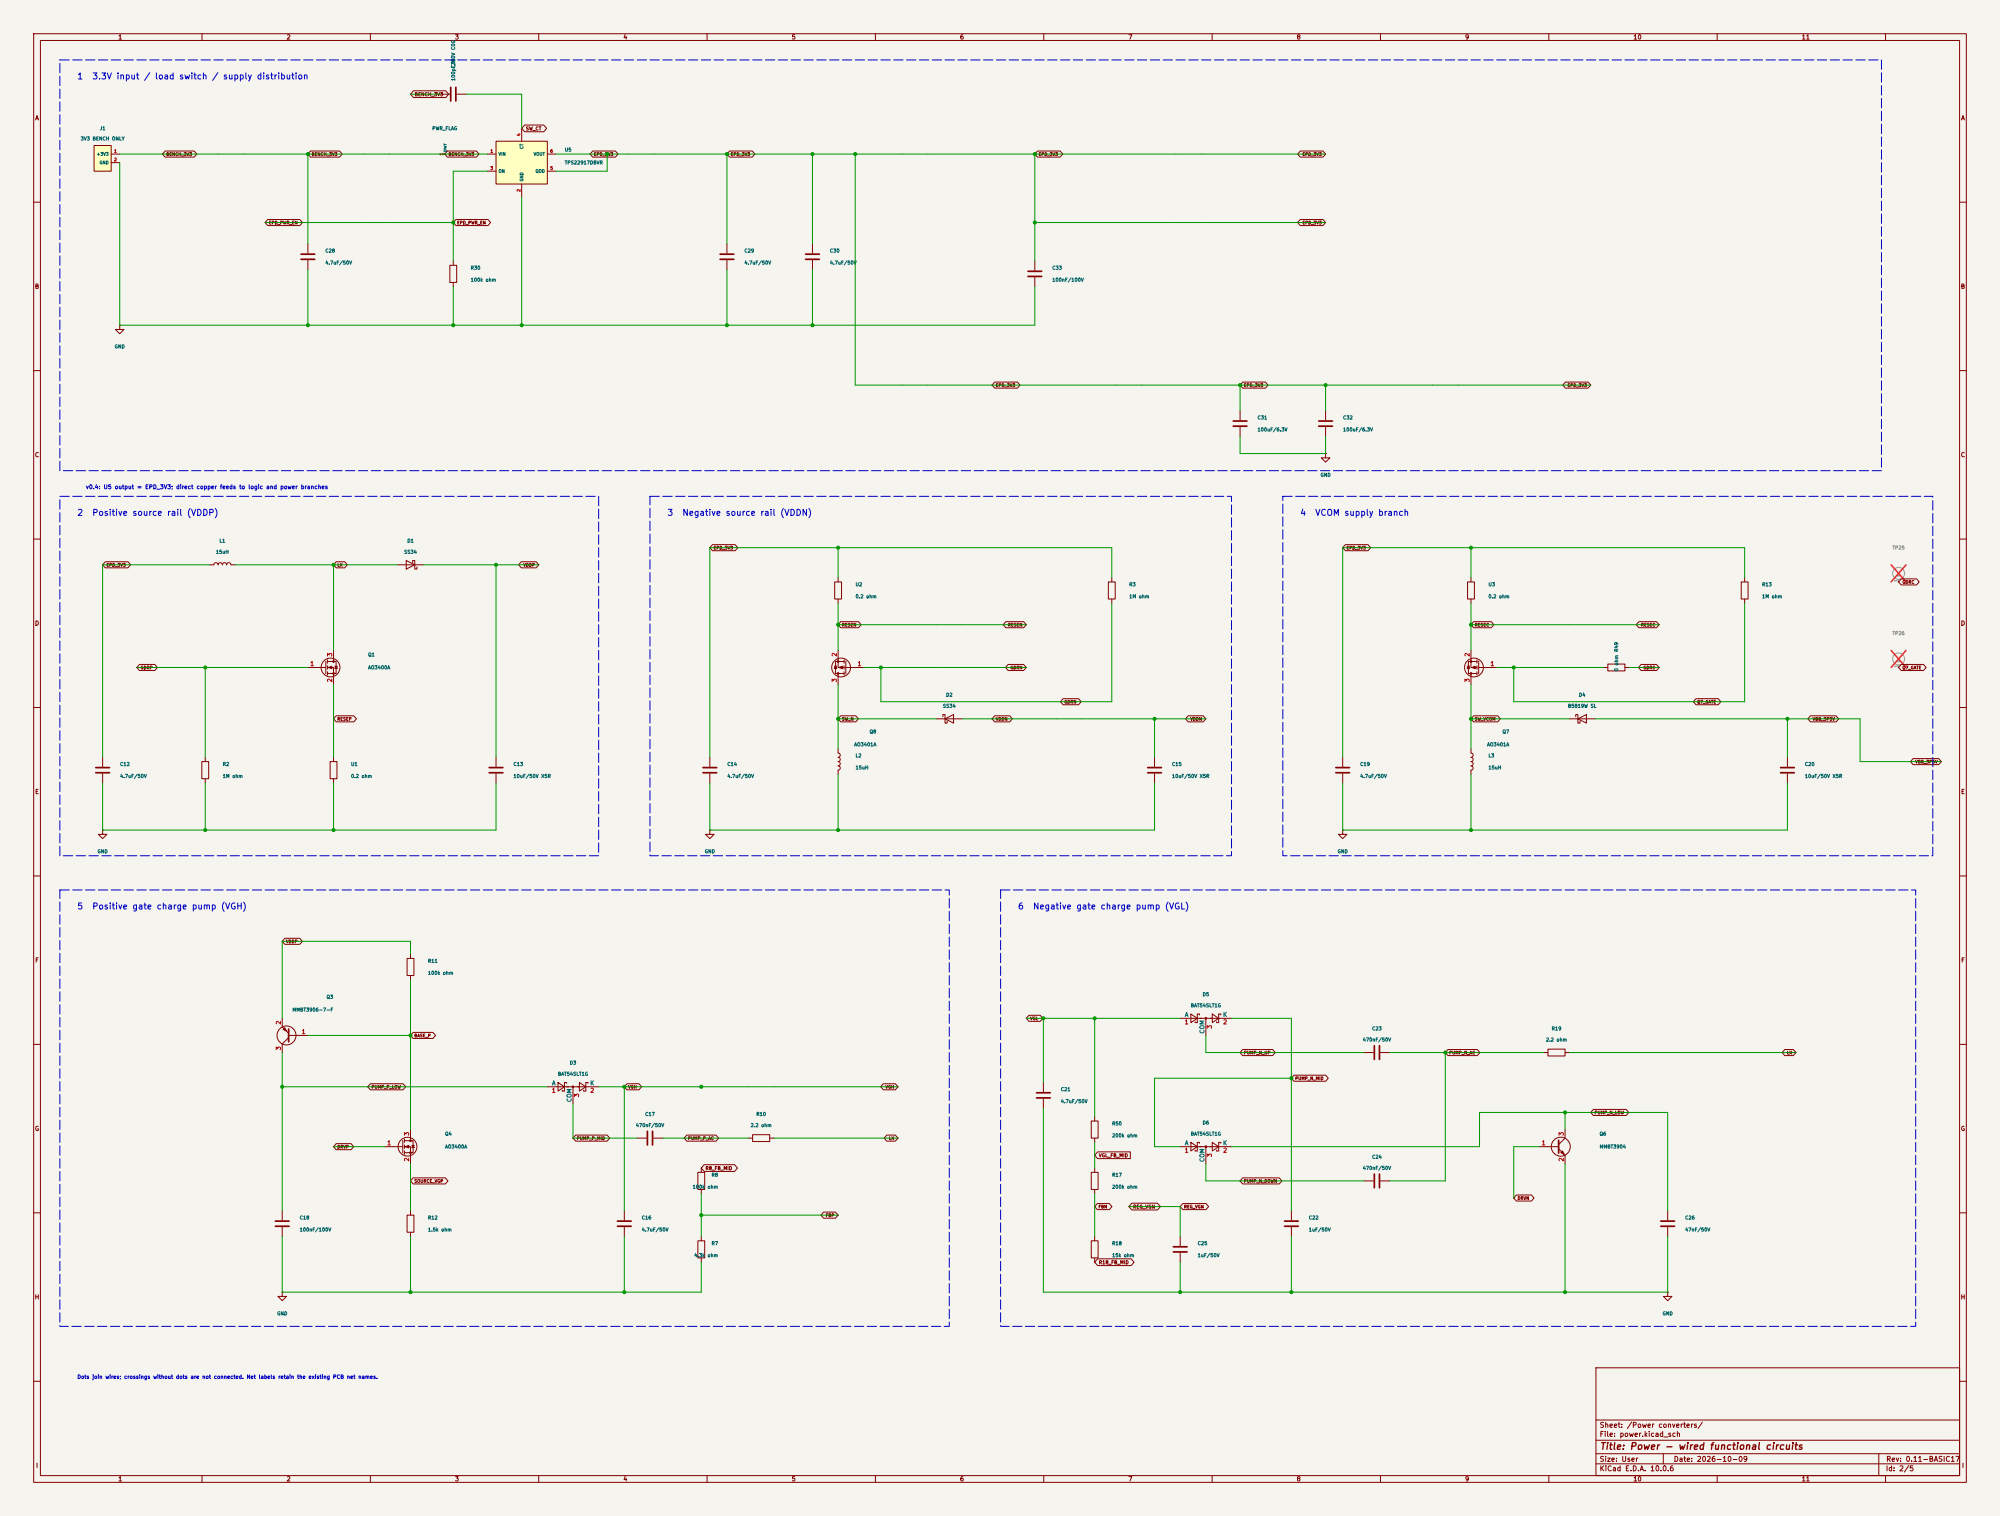
[picture p18: page 2]

1 3.3V input / load switch / supply distribution

v0.4: U5 output = EPD_3V3; direct copper feeds to logic and power branches 2 Positive source rail (VDDP)

Dots join wires; crossings without dots are not connected. Net labels retain the existing PCB net names.

Sheet: /Power converters/
File: power.kicad_sch
Title: Power - wired functional circuits

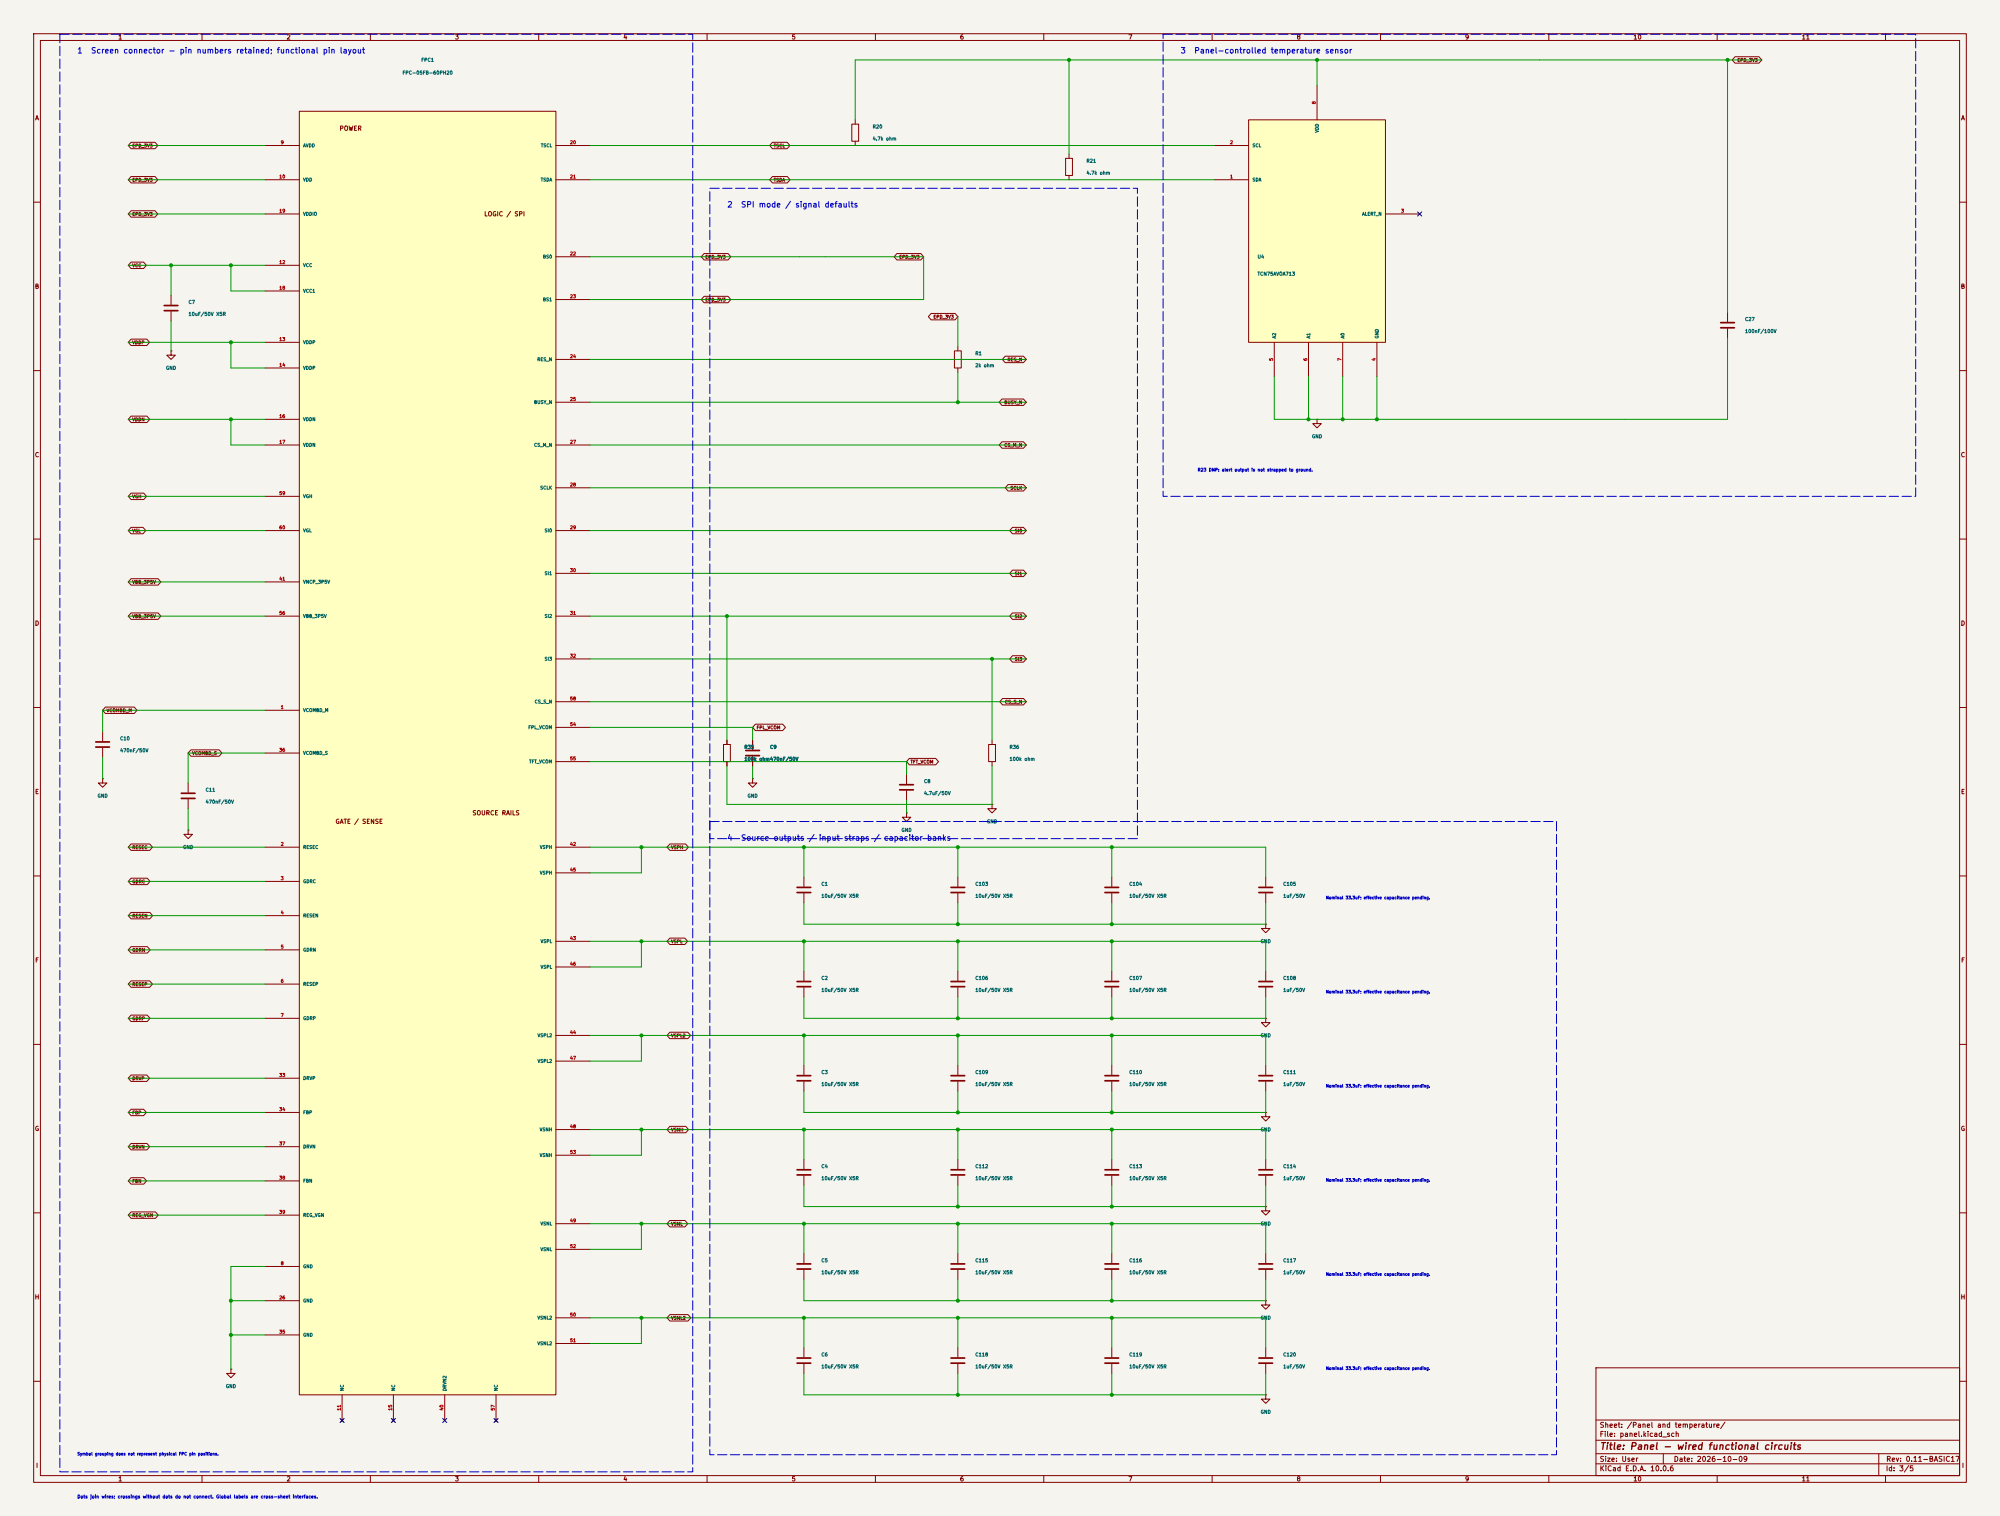
[picture p19: page 3]

1 Screen connector - pin numbers retained; functional pin layout

3 Panel-controlled temperature sensor

2 SPI mode / signal defaults

R23 DNP: alert output is not strapped to ground.

Nominal 33.3uF; effective capacitance pending. 4 Source outputs / input straps / capacitor banks

Nominal 33.3uF; effective capacitance pending. Nominal 33.3uF; effective capacitance pending. Nominal 33.3uF; effective capacitance pending. Nominal 33.3uF; effective capacitance pending. Nominal 33.3uF; effective capacitance pending.

Sheet: /Panel and temperature/
File: panel.kicad_sch
Title: Panel - wired functional circuits

Symbol grouping does not represent physical FPC pin positions.

Dots join wires; crossings without dots do not connect. Global labels are cross-sheet interfaces.

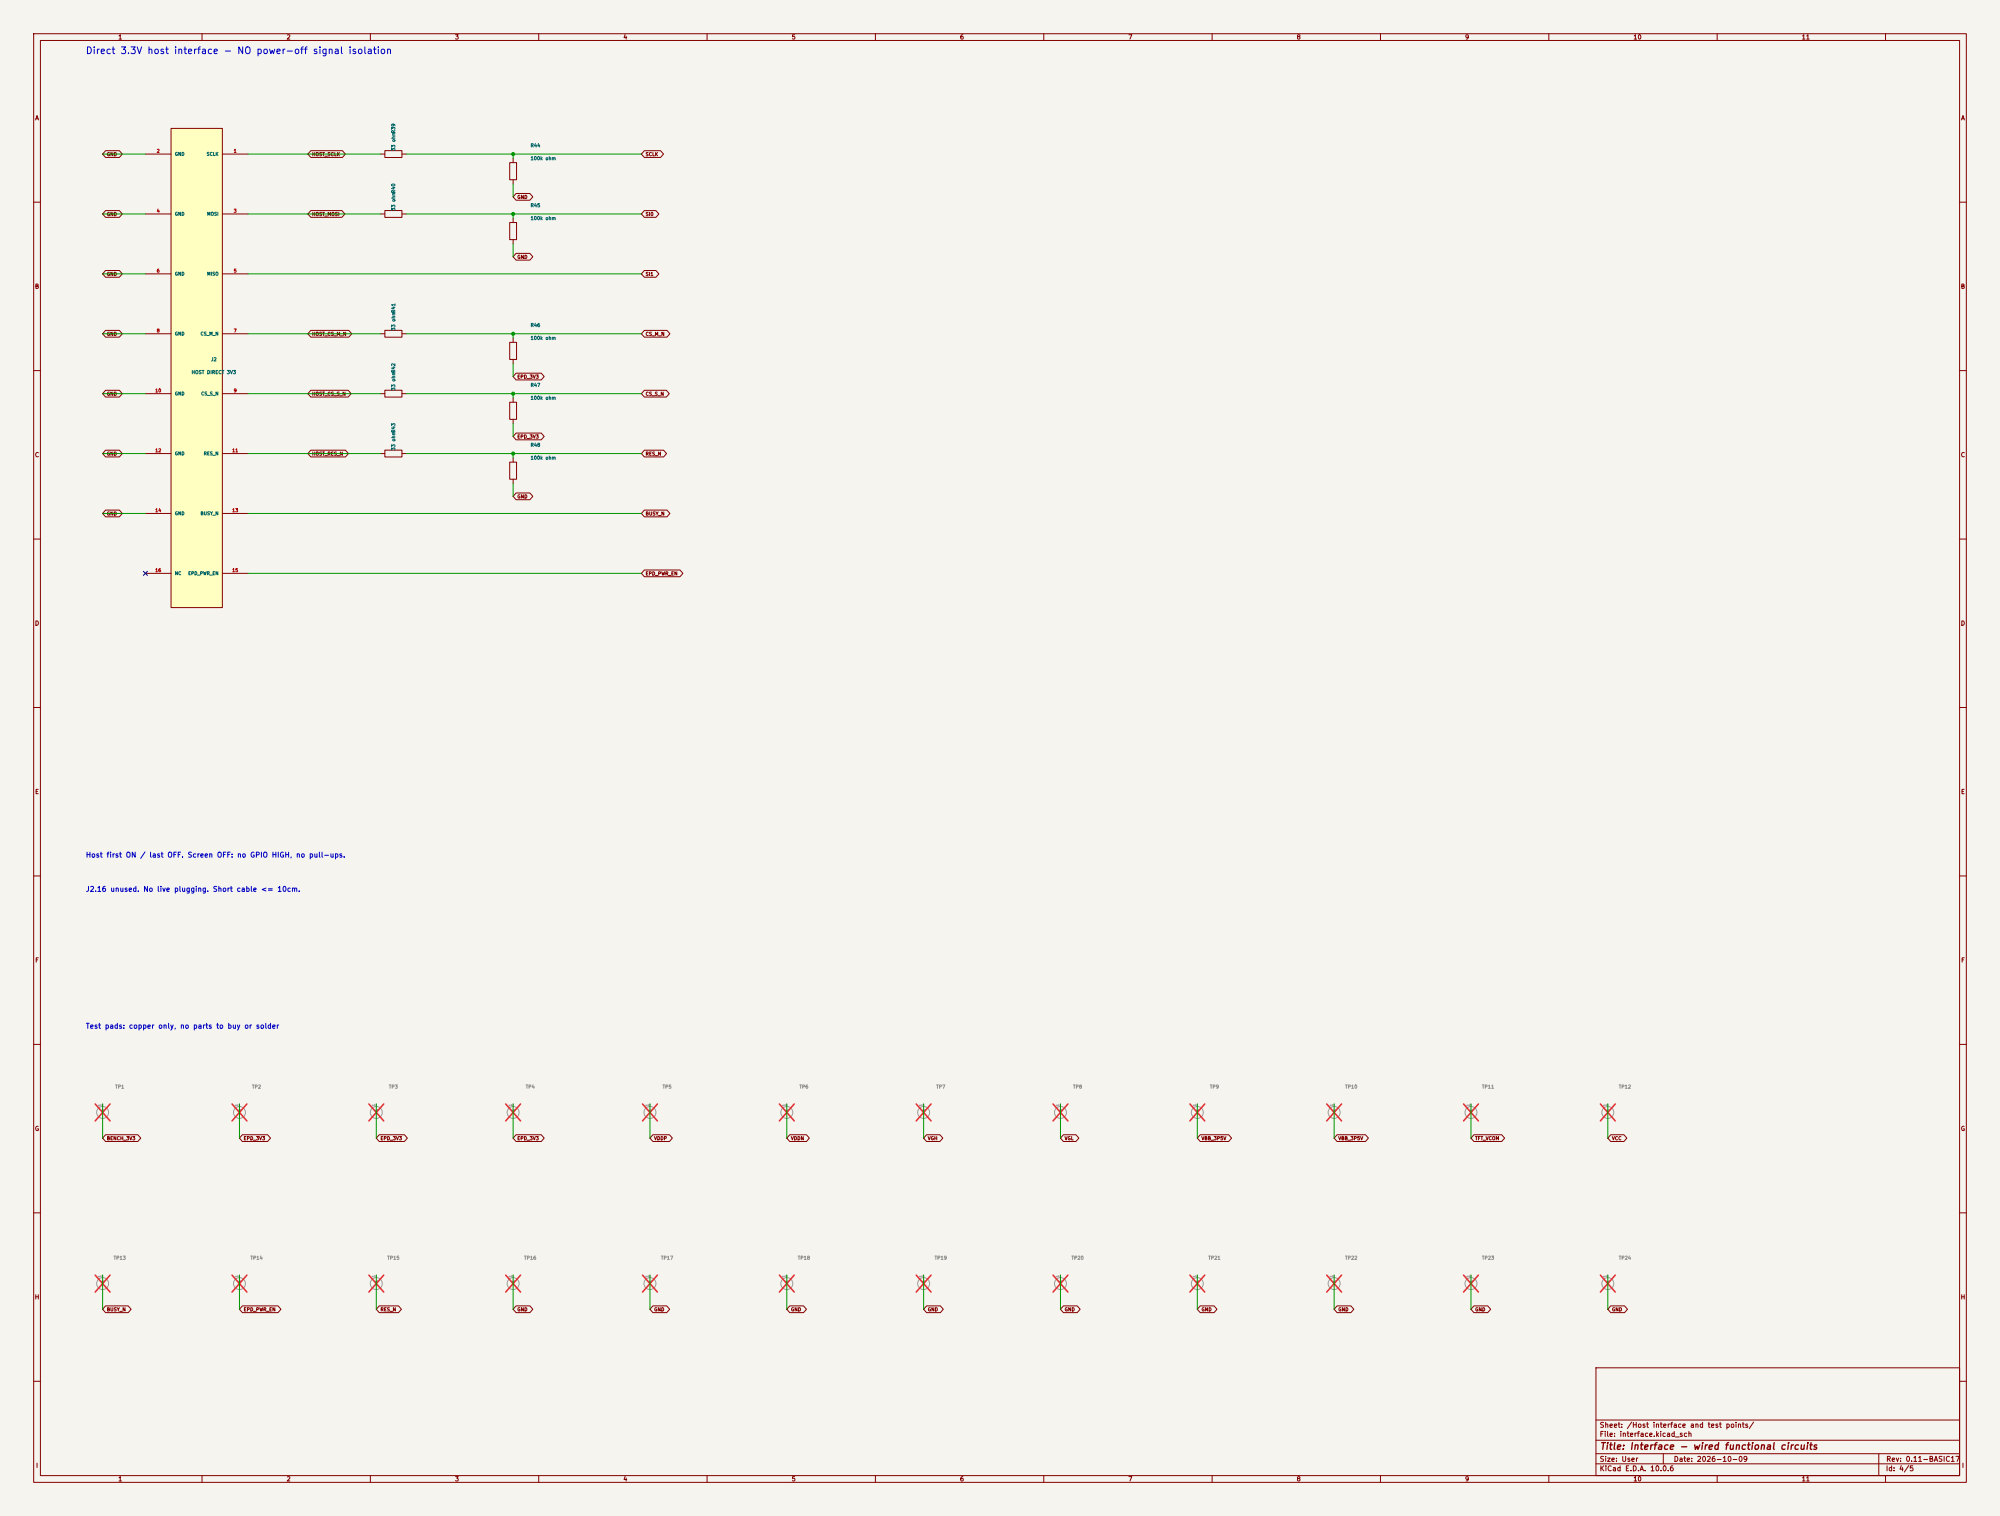
[picture p20: page 4]

Direct 3.3V host interface - NO power-off signal isolation

100k ohm R42 33 ohm R41 33 ohm R39 33 ohm

Host first ON / last OFF. Screen OFF: no GPIO HIGH, no pull-ups.

J2.16 unused. No live plugging. Short cable <= 10cm.

Test pads: copper only, no parts to buy or solder

Sheet: /Host interface and test points/
File: interface.kicad_sch
Title: Interface - wired functional circuits

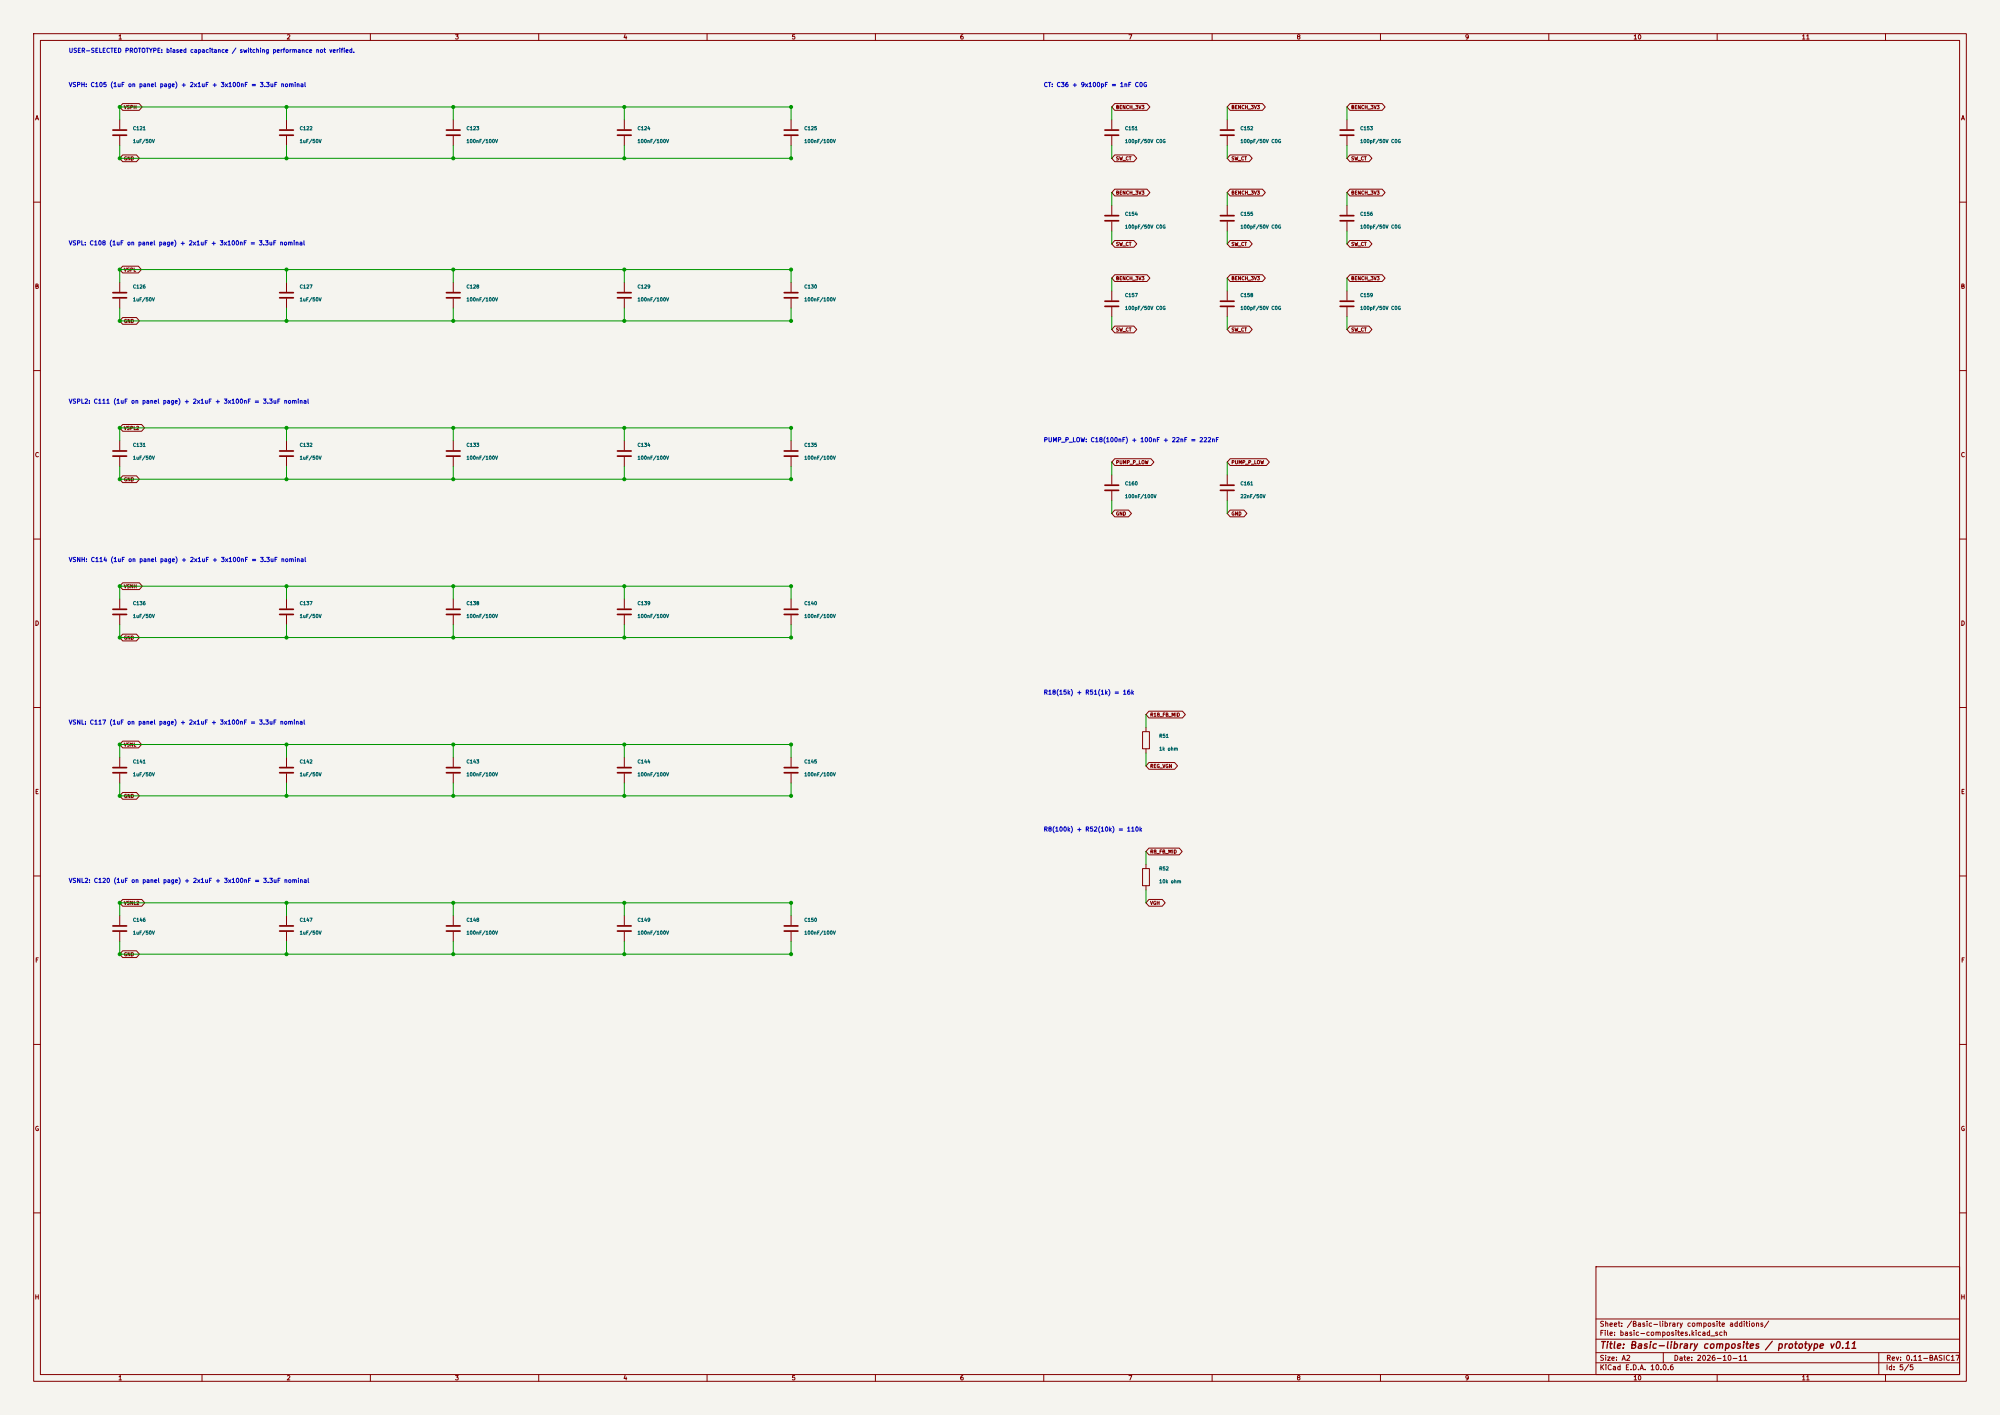
[picture p21: page 5]

VSPH: C105 (1uF on panel page) + 2x1uF + 3x100nF = 3.3uF nominal USER-SELECTED PROTOTYPE: biased capacitance / switching performance not verified.

BENCH_3V3 GND
VSPL: C108 (1uF on panel page) + 2x1uF + 3x100nF = 3.3uF nominal VSPL2: C111 (1uF on panel page) + 2x1uF + 3x100nF = 3.3uF nominal VSNH: C114 (1uF on panel page) + 2x1uF + 3x100nF = 3.3uF nominal VSNL: C117 (1uF on panel page) + 2x1uF + 3x100nF = 3.3uF nominal

R18(15k) + R51(1k) = 16k R8(100k) + R52(10k) = 110k VSNL2: C120 (1uF on panel page) + 2x1uF + 3x100nF = 3.3uF nominal

Sheet: /Basic-library composite additions/
File: basic-composites.kicad_sch
Title: Basic-library composites / prototype v0.11
