Rhys-Q/album/hardware/pcb/gdep133c02-driver/releases/jlc-cn-review-v0.9-resistors-2026-10-10/schematic-v0.9.pdf

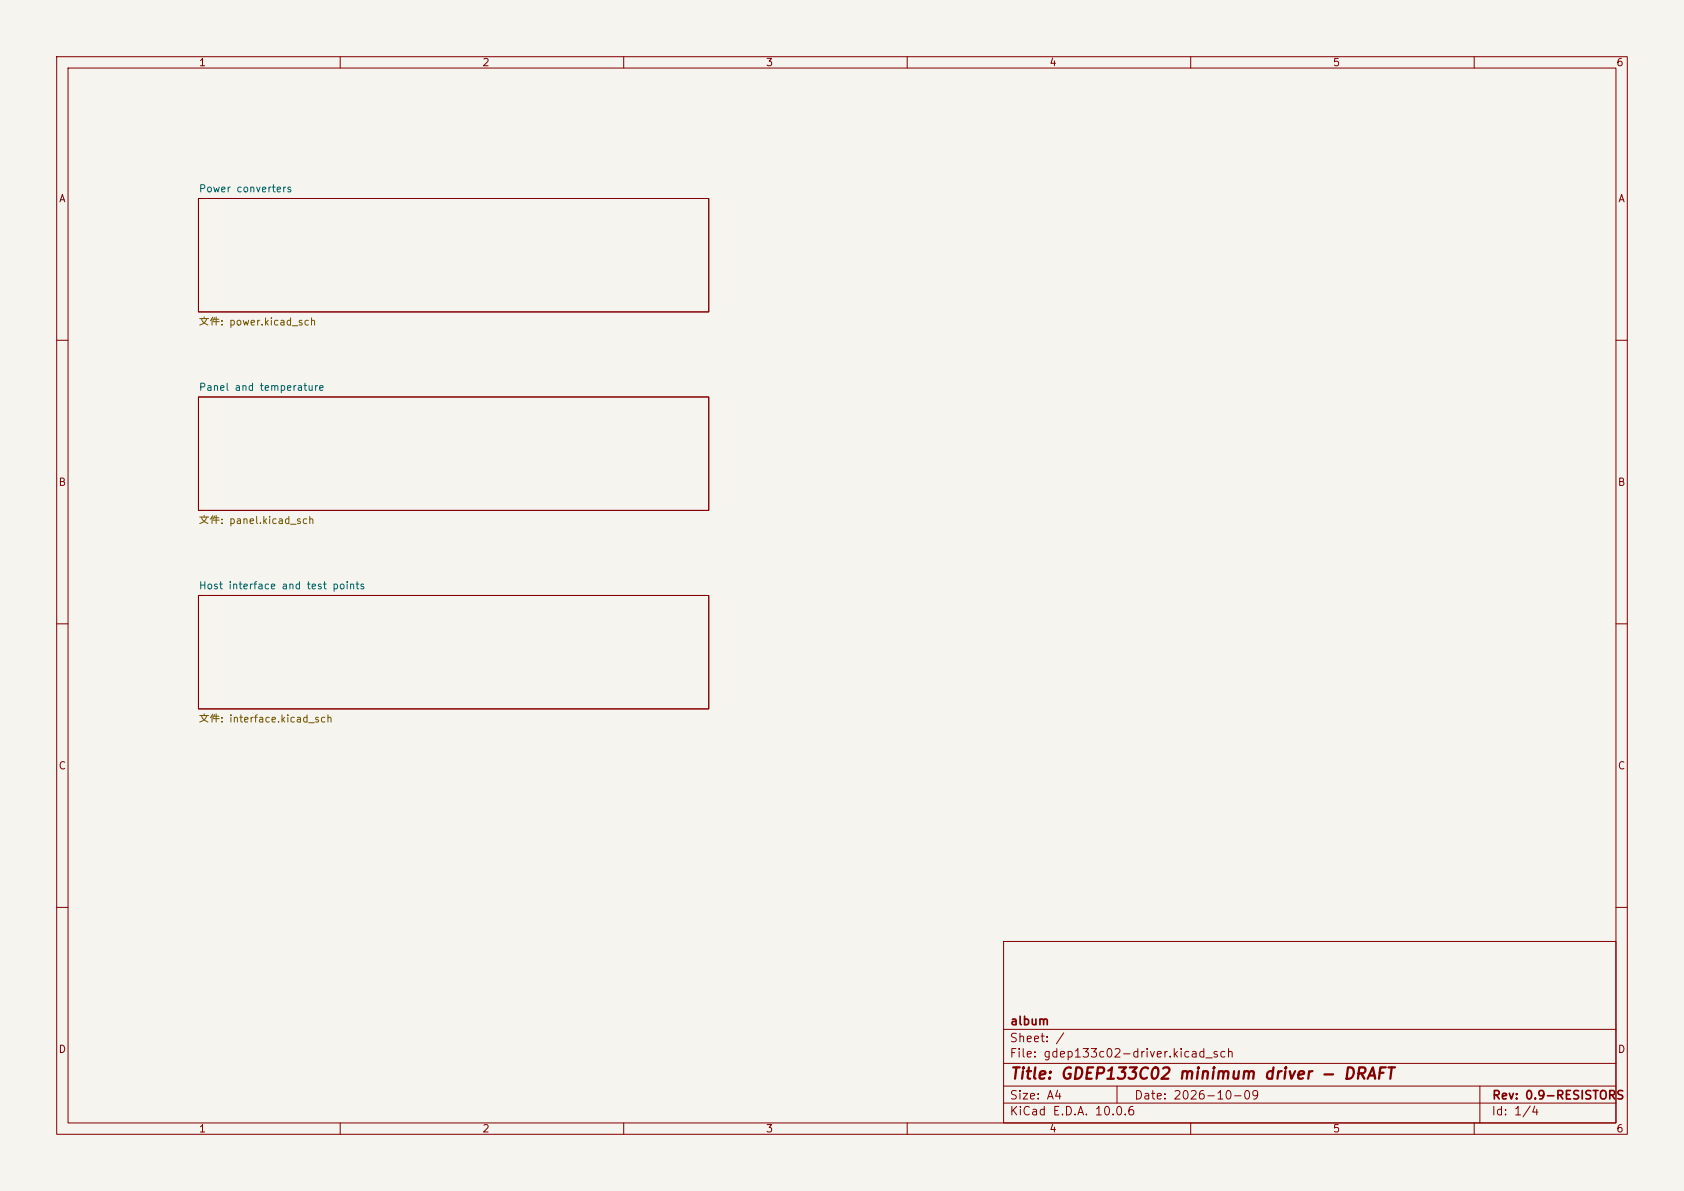
[picture p26: page 1]

Power converters 文件: power.kicad_sch Panel and temperature

Host interface and test points

album
Sheet: /
File: gdep133c02-driver.kicad_sch
Title: GDEP133C02 minimum driver - DRAFT

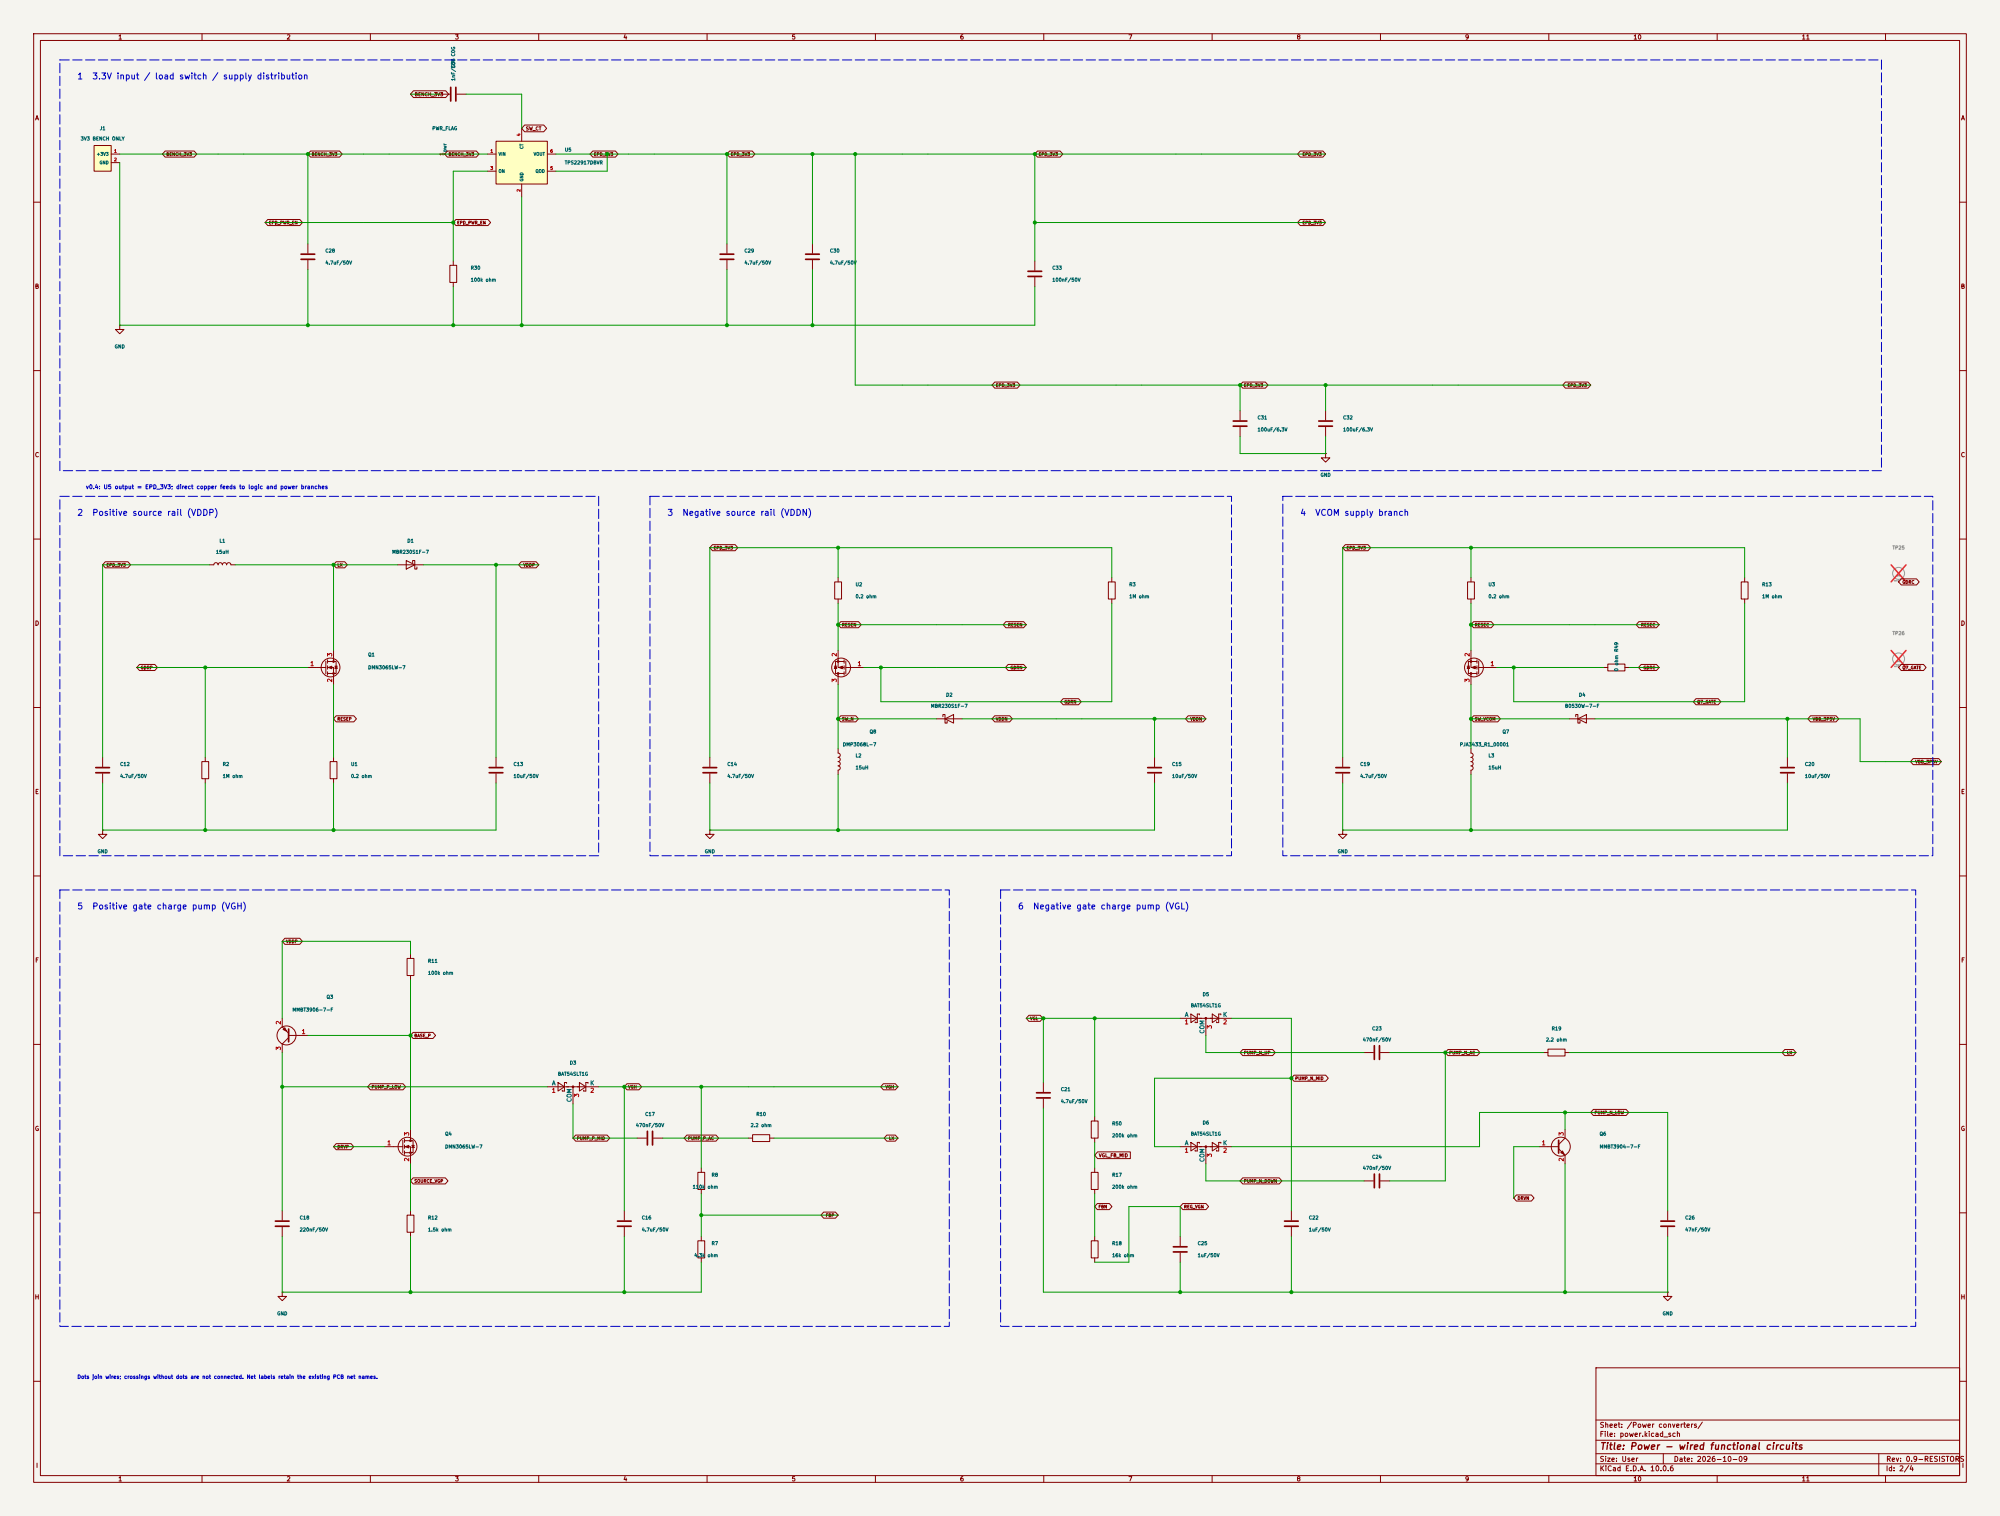
[picture p27: page 2]

1 3.3V input / load switch / supply distribution
3V3 BENCH ONLY GND

v0.4: U5 output = EPD_3V3; direct copper feeds to logic and power branches 2 Positive source rail (VDDP)

3 Negative source rail (VDDN)

5 Positive gate charge pump (VGH)

Dots join wires; crossings without dots are not connected. Net labels retain the existing PCB net names.

Sheet: /Power converters/
File: power.kicad_sch
Title: Power - wired functional circuits

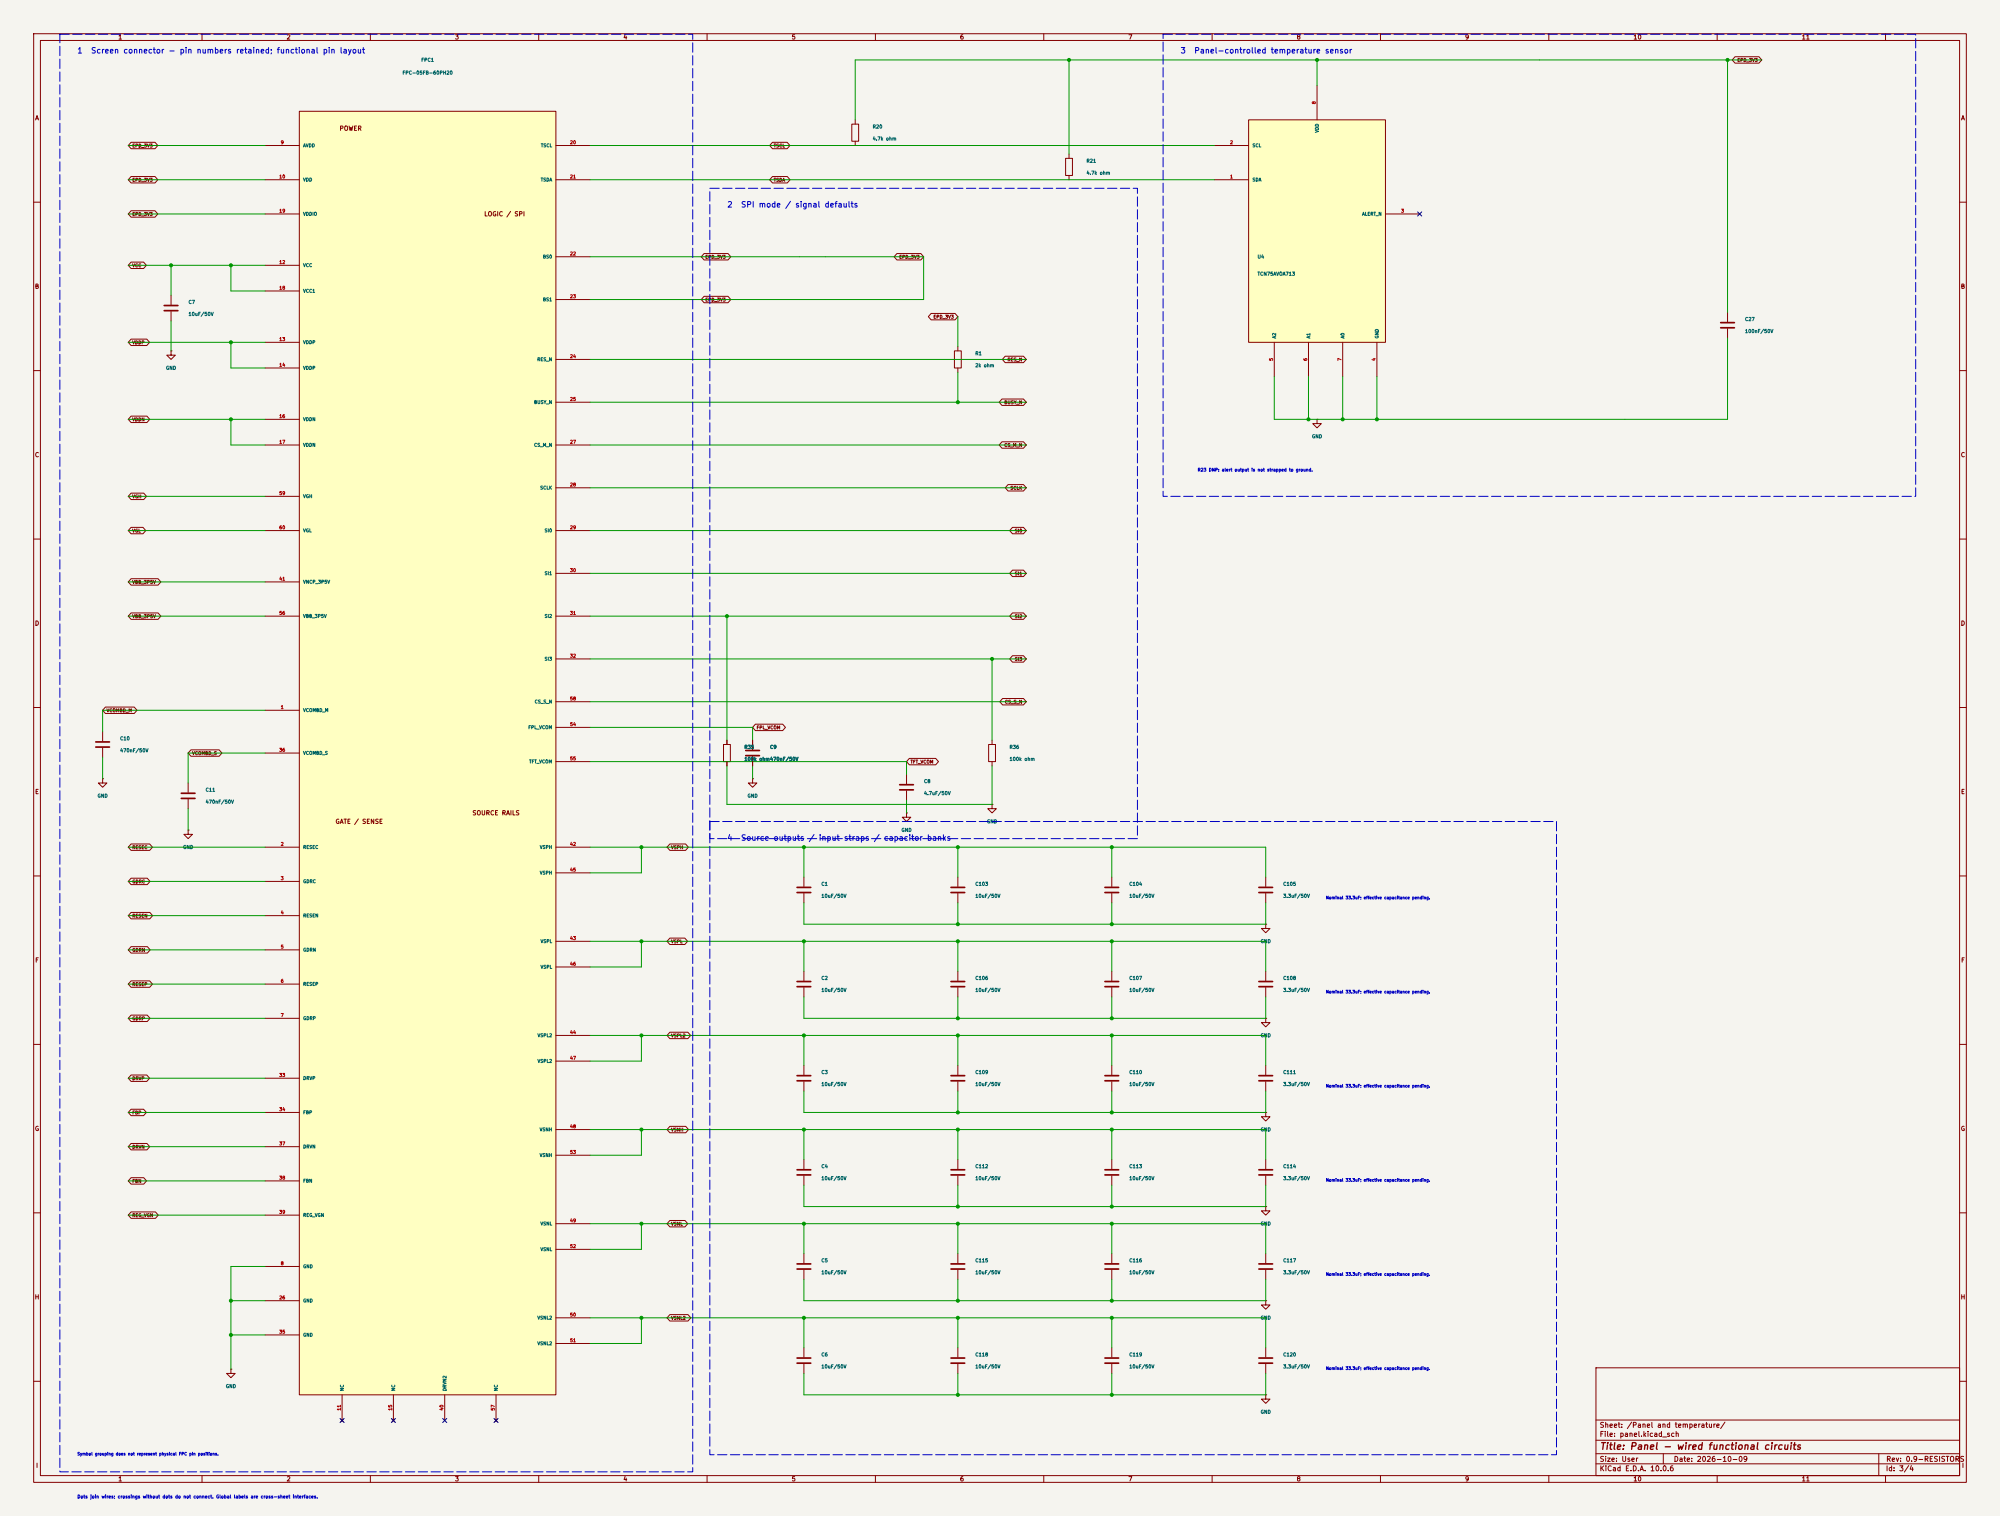
[picture p28: page 3]

1 Screen connector - pin numbers retained; functional pin layout

3 Panel-controlled temperature sensor

2 SPI mode / signal defaults

R23 DNP: alert output is not strapped to ground.

4 Source outputs / input straps / capacitor banks

10uF/50V C104
10uF/50V 10uF/50V C106 | C110 10uF/50V C107

3.3uF/50V GND
Nominal 33.3uF; effective capacitance pending. Nominal 33.3uF; effective capacitance pending. Nominal 33.3uF; effective capacitance pending. Nominal 33.3uF; effective capacitance pending. Nominal 33.3uF; effective capacitance pending.

Nominal 33.3uF; effective capacitance pending.

Sheet: /Panel and temperature/
File: panel.kicad_sch
Title: Panel - wired functional circuits

Dots join wires; crossings without dots do not connect. Global labels are cross-sheet interfaces. Symbol grouping does not represent physical FPC pin positions.

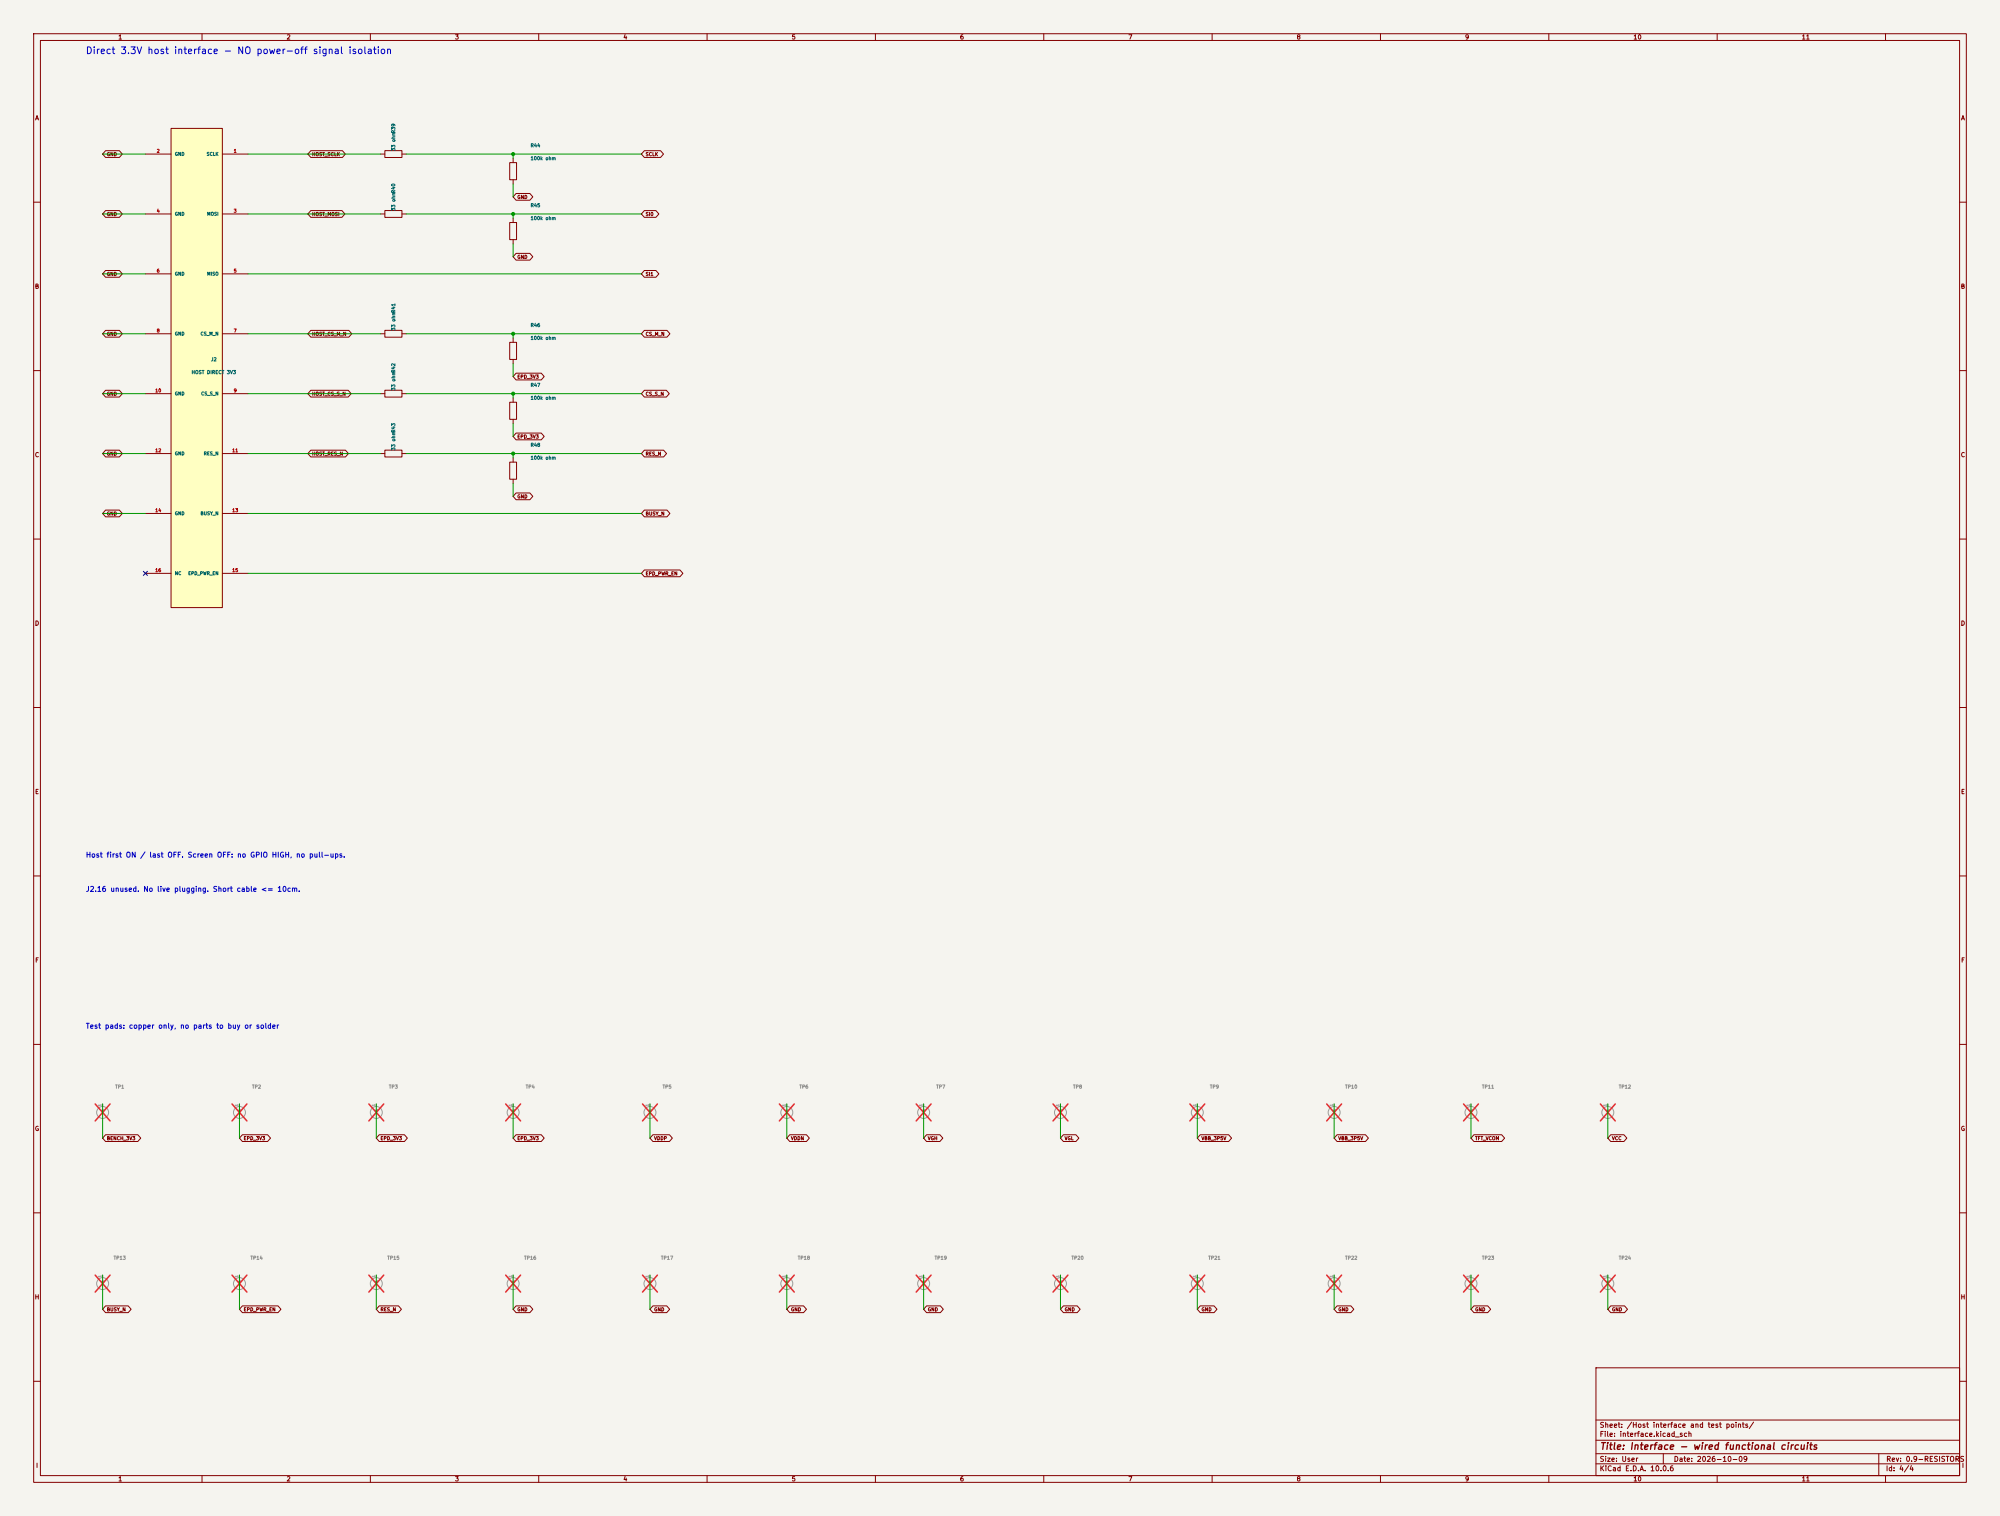
[picture p29: page 4]

Direct 3.3V host interface - NO power-off signal isolation

100k ohm R42 33 ohm R41 33 ohm R39 33 ohm

Host first ON / last OFF. Screen OFF: no GPIO HIGH, no pull-ups.

J2.16 unused. No live plugging. Short cable <= 10cm.

Test pads: copper only, no parts to buy or solder

Sheet: /Host interface and test points/
File: interface.kicad_sch
Title: Interface - wired functional circuits
