Rhys-Q/album/hardware/pcb/gdep133c02-driver/releases/jlc-cn-review-v0.11-basic17-2026-10-11/assembly-top.pdf

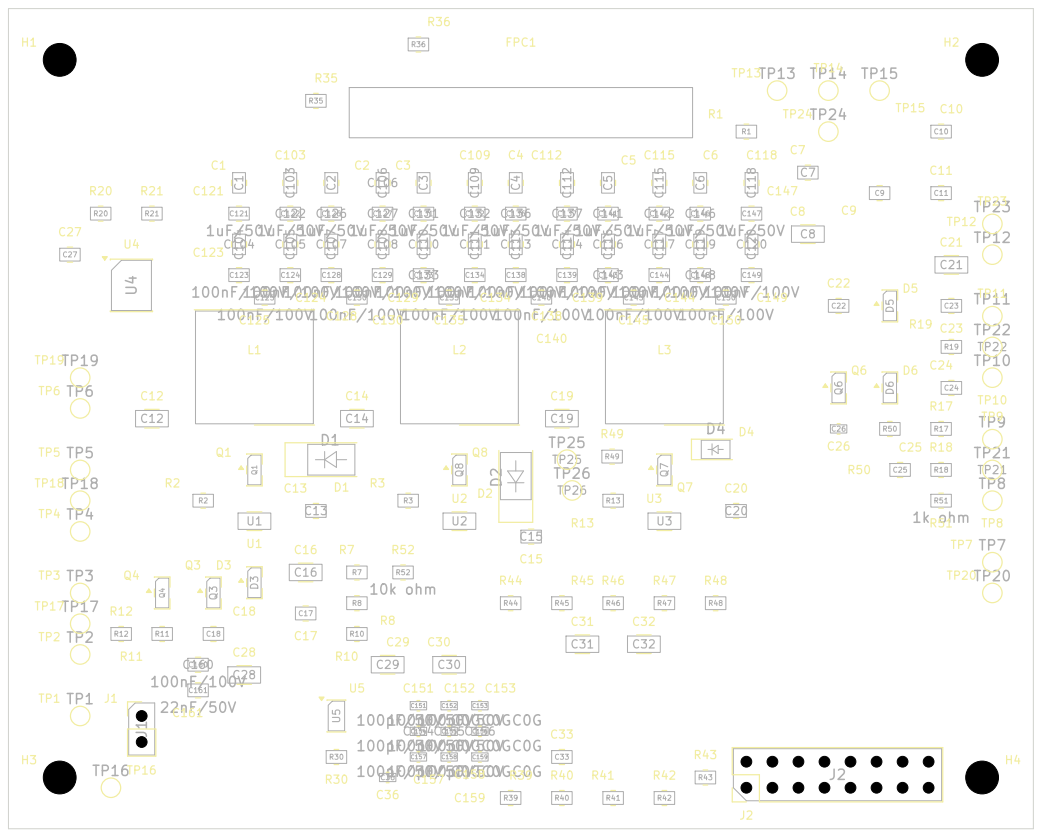
[picture p30: page 1]
