Rhys-Q/album/hardware/pcb/gdep133c02-driver/releases/jlc-cn-review-v0.11-basic17-2026-10-11/pcb-v0.11.pdf

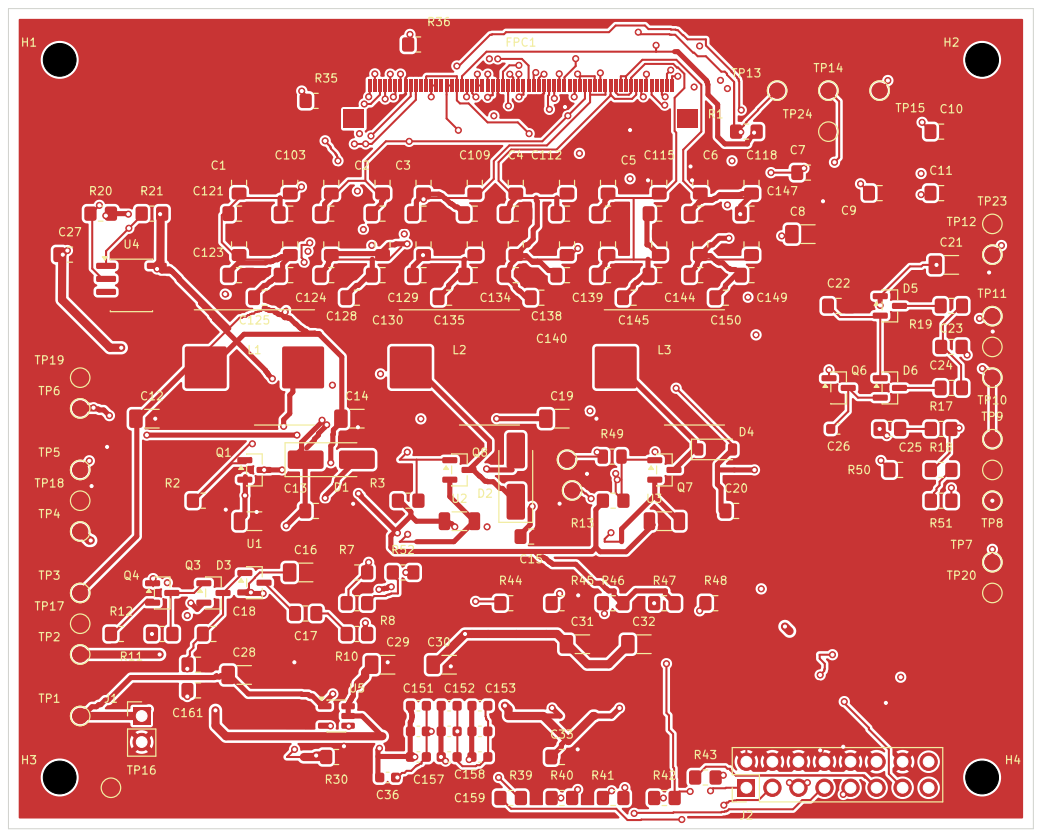
[picture p31: page 1]
