Rhys-Q/album/hardware/pcb/gdep133c02-driver/releases/jlc-cn-review-v0.10-e01-2026-10-11/pcb-v0.10.pdf

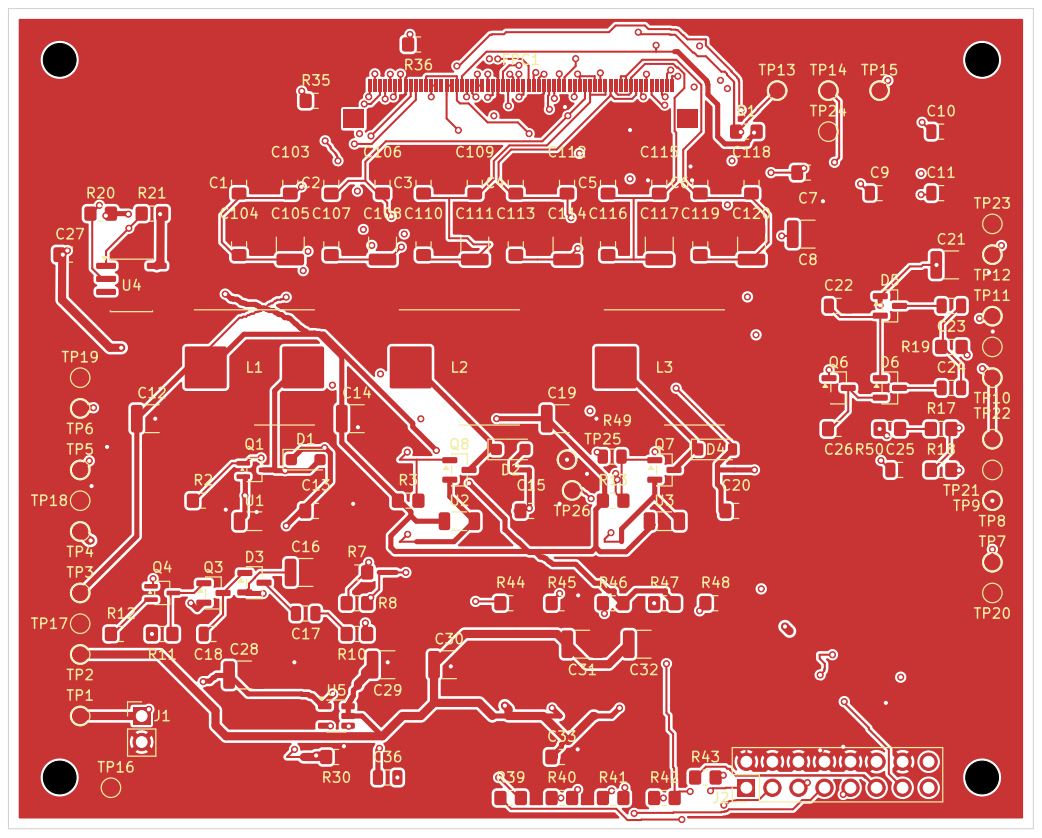
[picture p33: page 1]
