Rhys-Q/album/hardware/pcb/gdep133c02-driver/releases/jlc-cn-review-v0.9-resistors-2026-10-10/assembly-top.pdf

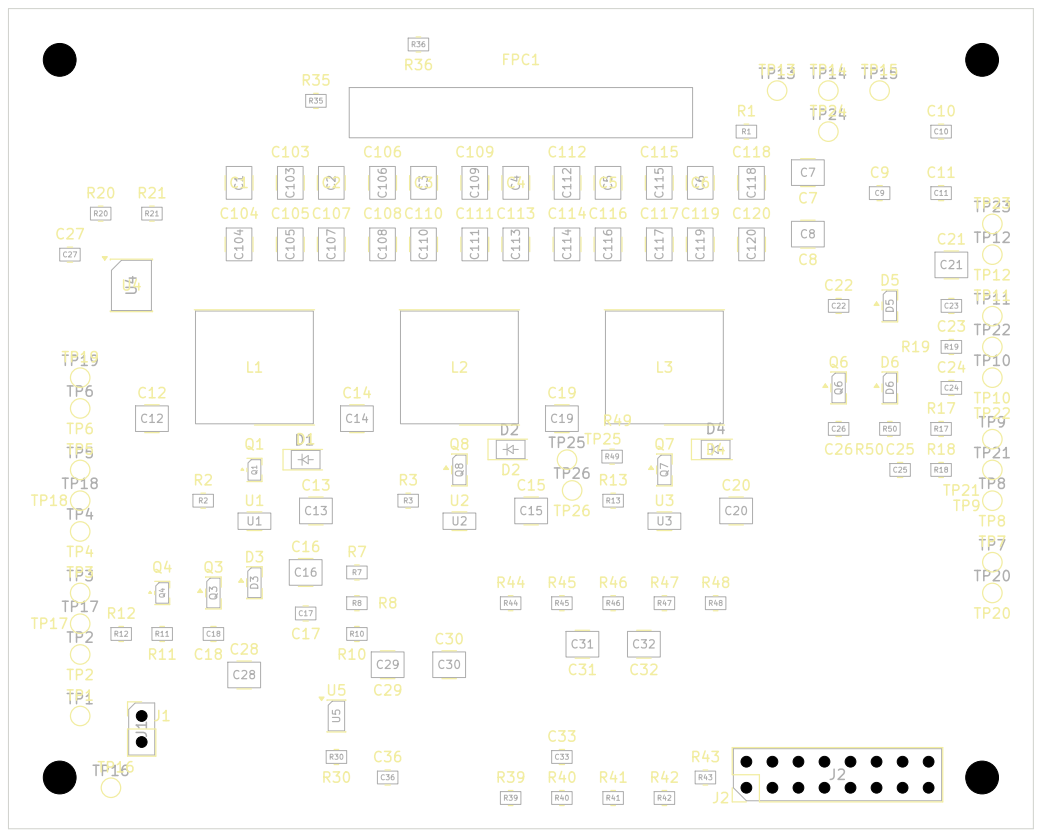
[picture p34: page 1]
