Rhys-Q/album/hardware/pcb/gdep133c02-driver/releases/jlc-cn-review-v0.9-resistors-2026-10-10/pcb-v0.9.pdf

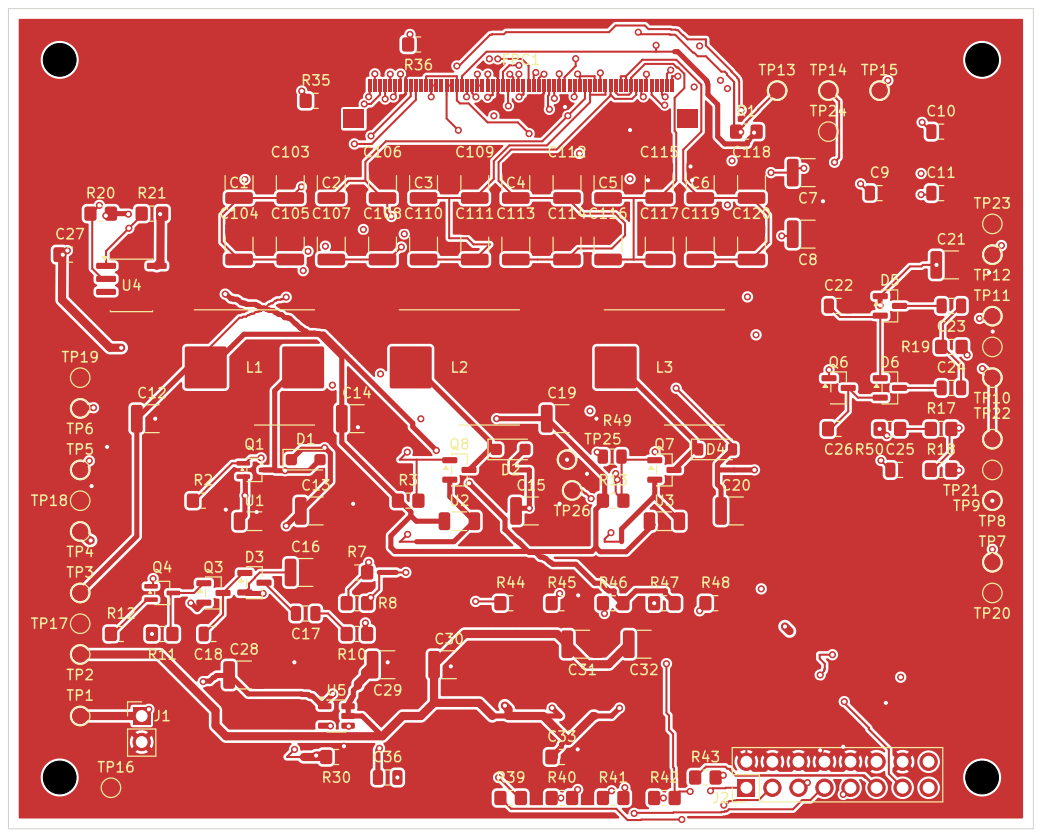
[picture p35: page 1]
