Rhys-Q/album/hardware/pcb/gdep133c02-driver/reports/preview/board.pdf

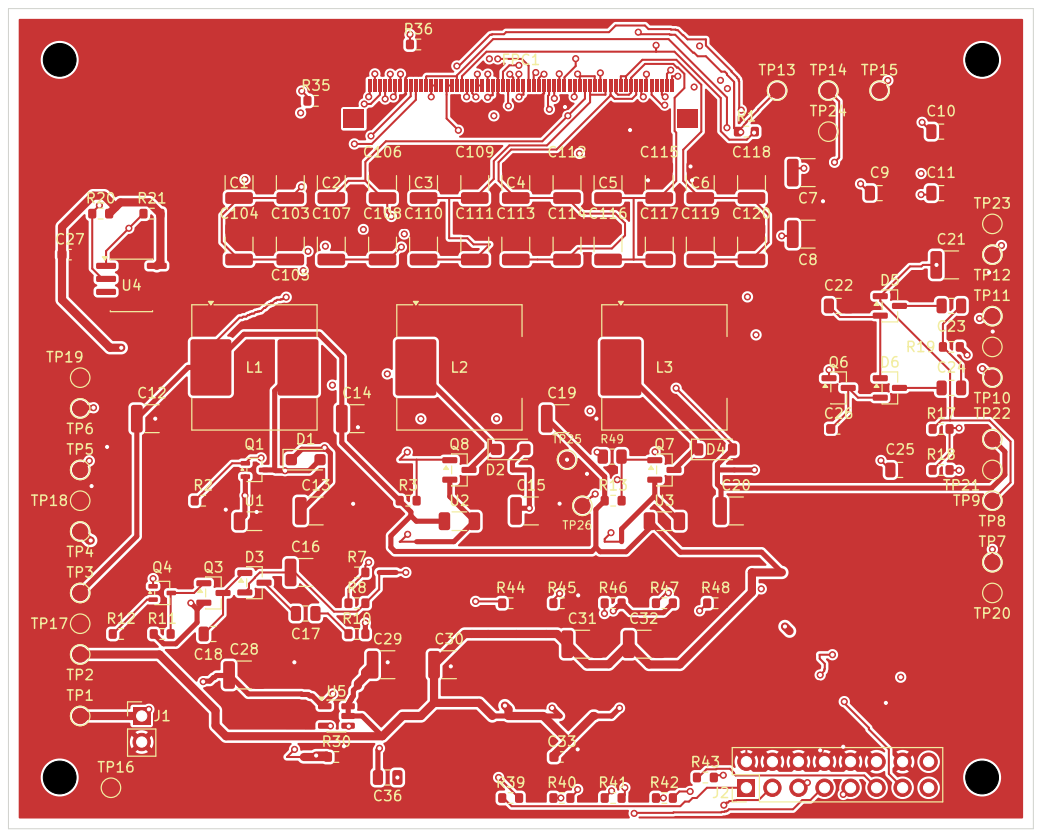
[picture p36: page 1]
