Rhys-Q/album/hardware/pcb/gdep133c02-driver/gdep133c02-driver.kicad_pcb

## KiCad design hardware/pcb/gdep133c02-driver/gdep133c02-driver.kicad_pcb (2026-10-11)

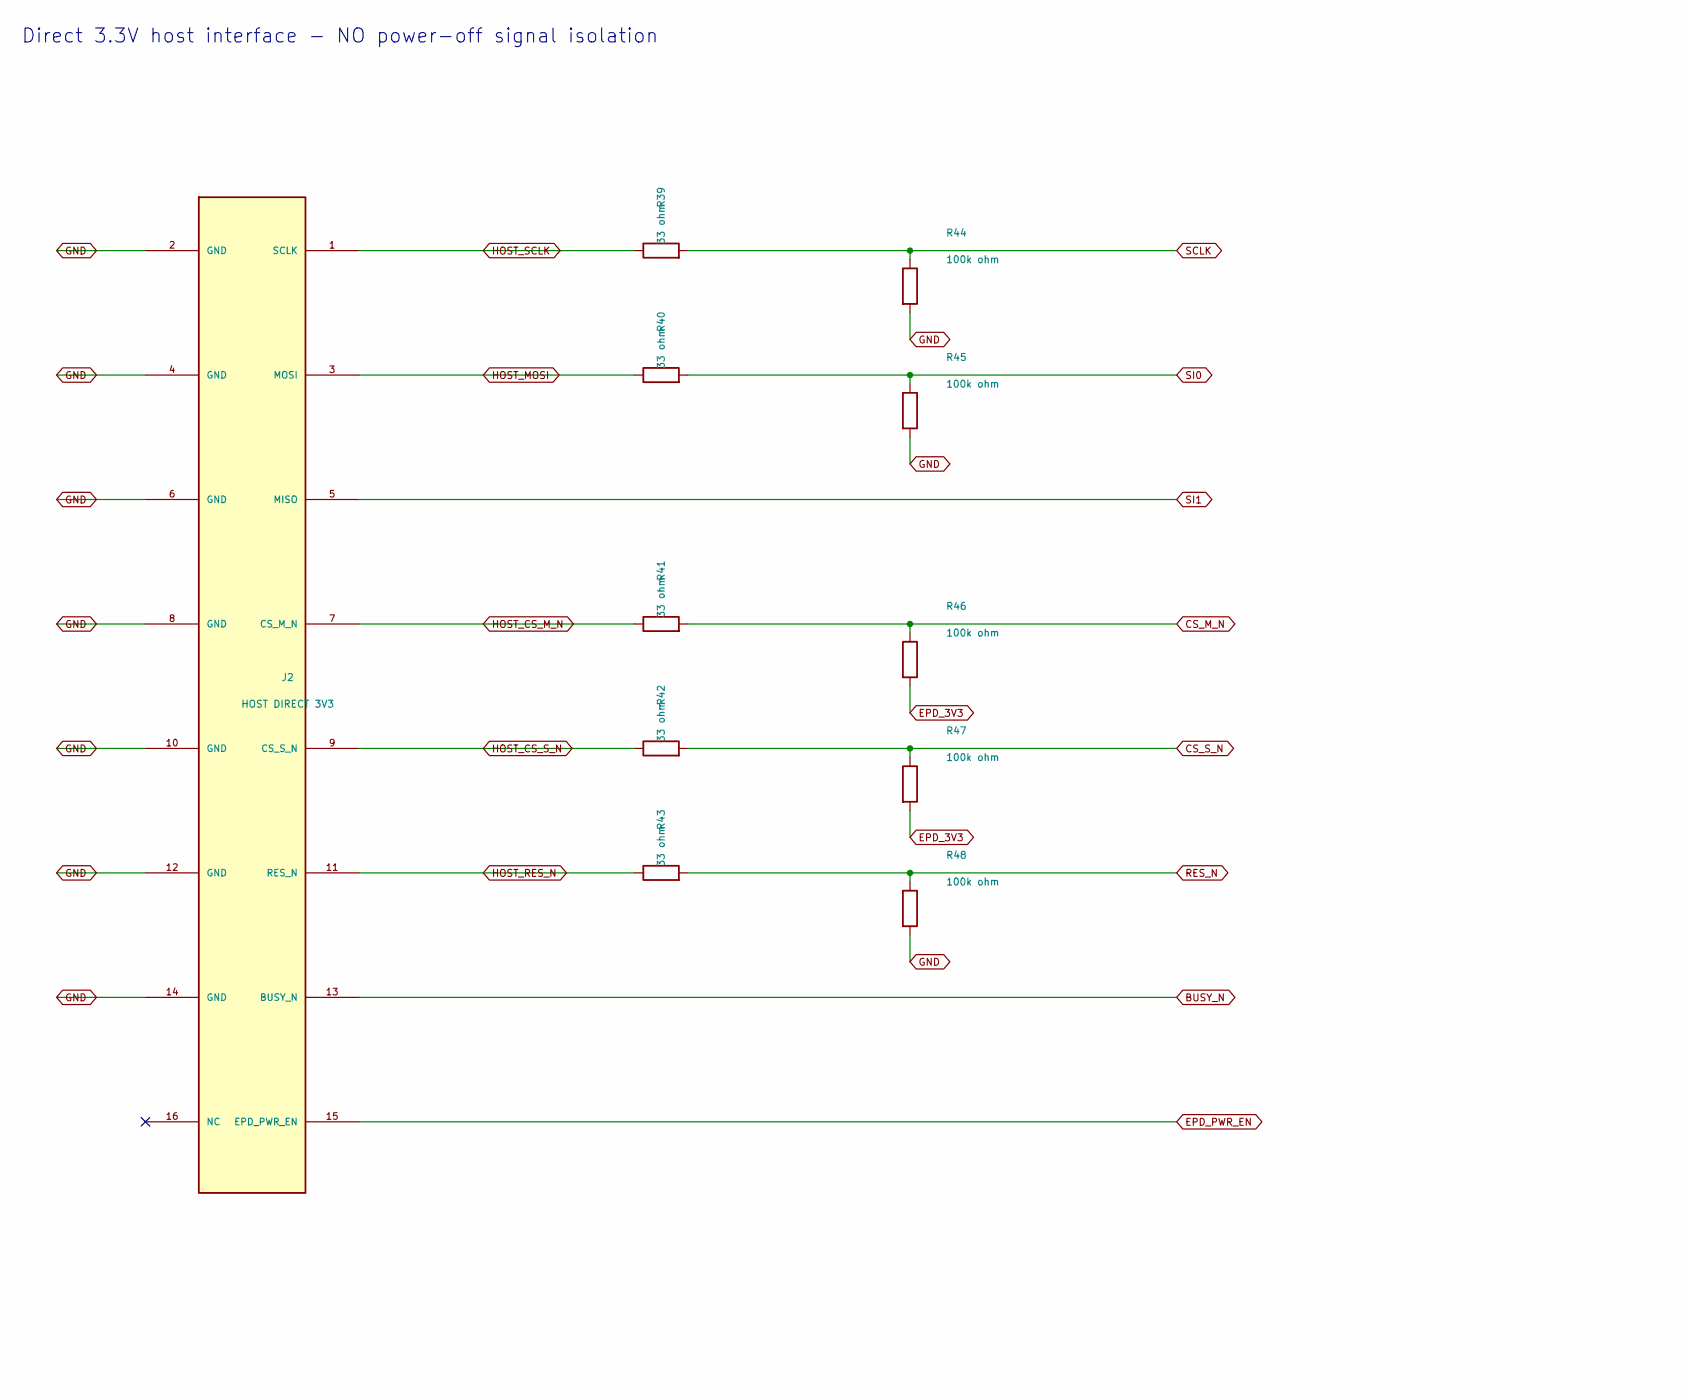
[picture p37: schematic interface.kicad_sch, Interface - wired functional circuits, part in row 1, column 1]

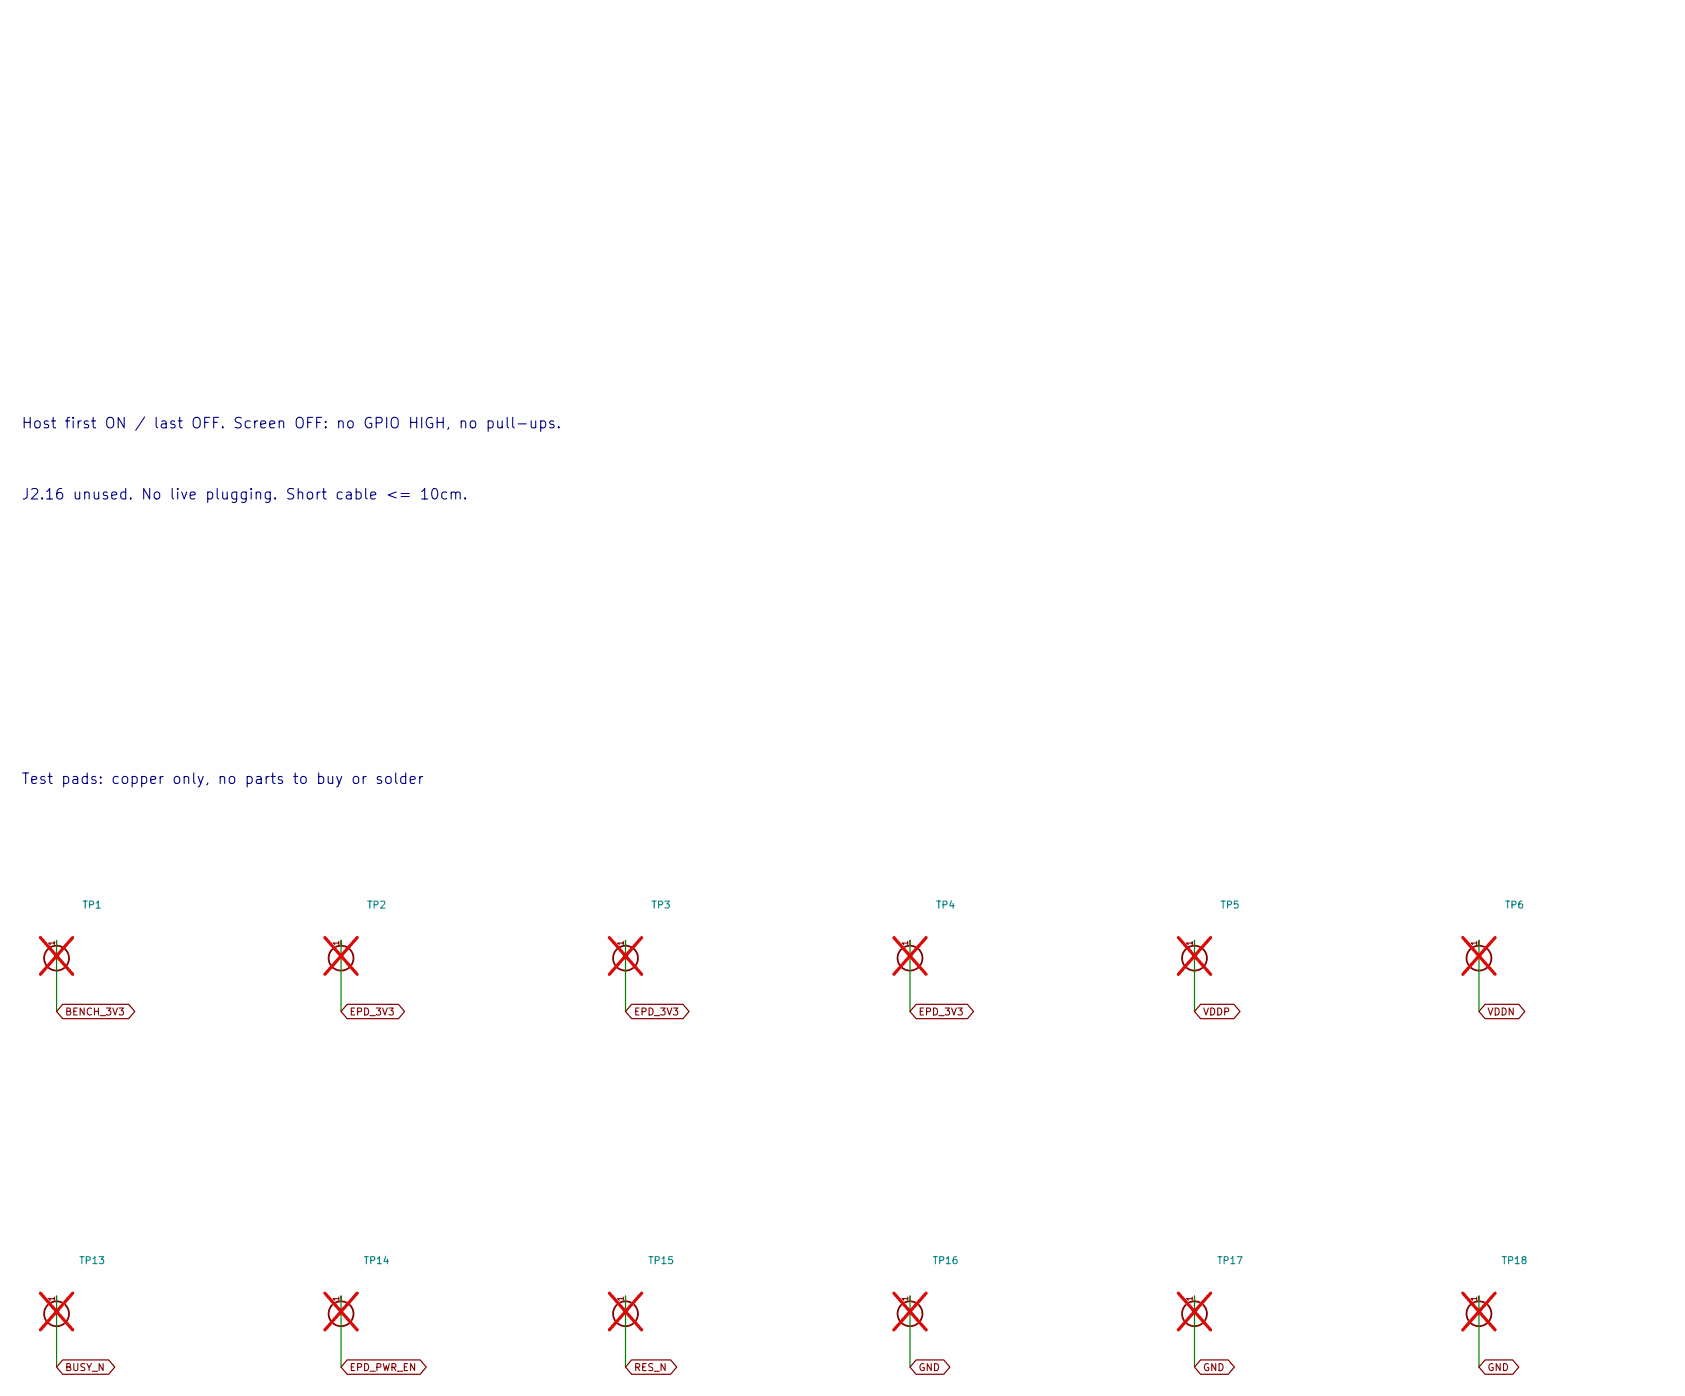
[picture p38: schematic interface.kicad_sch, Interface - wired functional circuits, part in row 2, column 1]

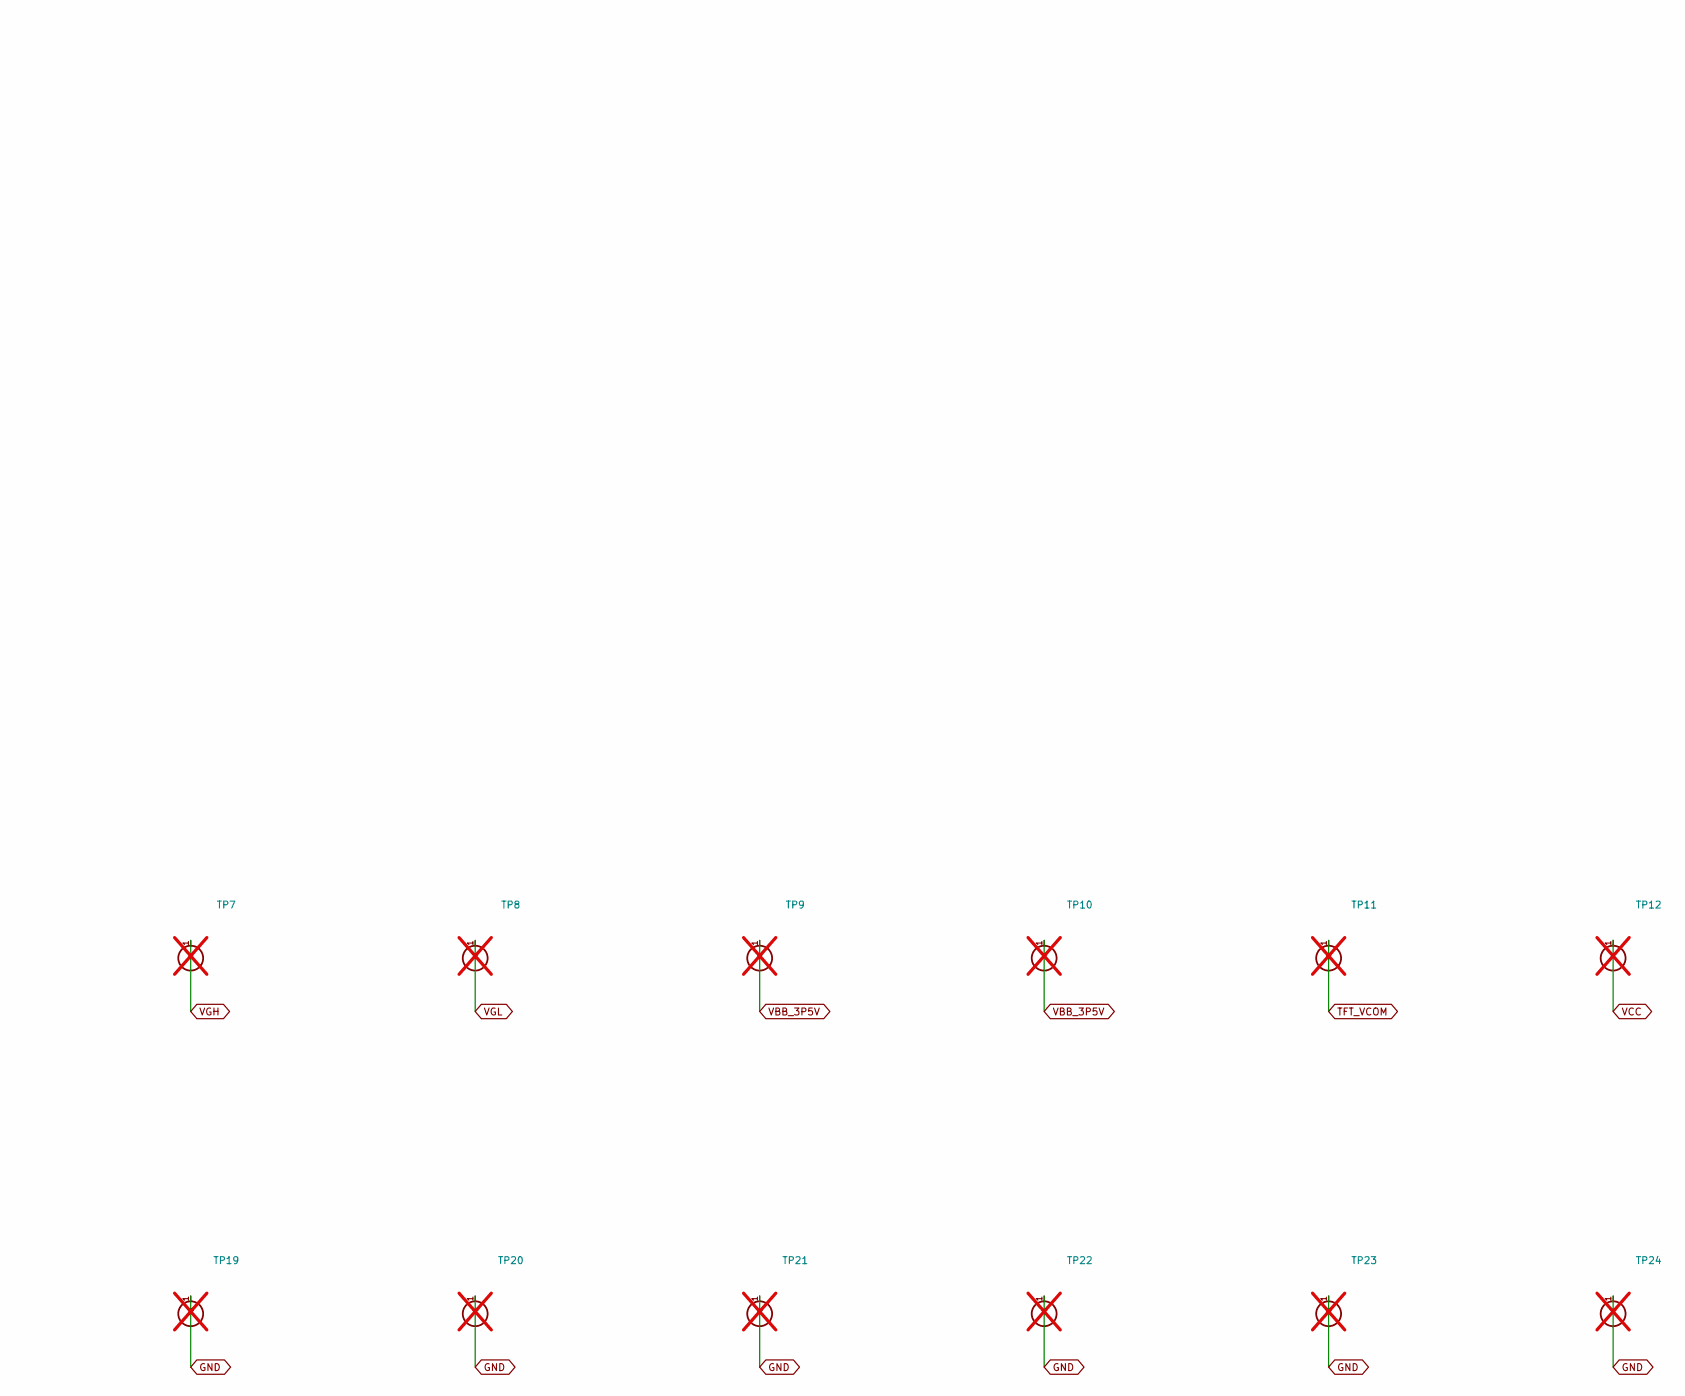
[picture p39: schematic interface.kicad_sch, Interface - wired functional circuits, part in row 2, column 2]

Parts:
J2: HOST DIRECT 3V3; Connector_PinHeader_2.54mm__PinHeader_2x08_P2.54mm_Vertical; MPN SH-PZ254V-2x8P; LCSC C55629829
R39, R40, R41, R42, R43: 33 ohm; R_0805_HandSolder; MPN 0805W8F330JT5E; LCSC C17634
R44, R45, R46, R47, R48: 100k ohm; R_0805_HandSolder; MPN 0805W8F1003T5E; LCSC C149504
TP1: BENCH_3V3; TestPoint__TestPoint_Pad_D1.5mm; MPN PCB test pad; not fitted
TP2, TP3, TP4: EPD_3V3; TestPoint__TestPoint_Pad_D1.5mm; MPN PCB test pad; not fitted
TP5: VDDP; TestPoint__TestPoint_Pad_D1.5mm; MPN PCB test pad; not fitted
TP6: VDDN; TestPoint__TestPoint_Pad_D1.5mm; MPN PCB test pad; not fitted
TP7: VGH; TestPoint__TestPoint_Pad_D1.5mm; MPN PCB test pad; not fitted
TP8: VGL; TestPoint__TestPoint_Pad_D1.5mm; MPN PCB test pad; not fitted
TP9: VBB_3P5V; TestPoint__TestPoint_Pad_D1.5mm; MPN PCB test pad; not fitted
TP10: VNCP_3P5V; TestPoint__TestPoint_Pad_D1.5mm; MPN PCB test pad; not fitted
TP11: TFT_VCOM; TestPoint__TestPoint_Pad_D1.5mm; MPN PCB test pad; not fitted
TP12: VCC; TestPoint__TestPoint_Pad_D1.5mm; MPN PCB test pad; not fitted
TP13: BUSY_N; TestPoint__TestPoint_Pad_D1.5mm; MPN PCB test pad; not fitted
TP14: EPD_PWR_EN; TestPoint__TestPoint_Pad_D1.5mm; MPN PCB test pad; not fitted
TP15: RES_N; TestPoint__TestPoint_Pad_D1.5mm; MPN PCB test pad; not fitted
TP16, TP17, TP18, TP19, TP20, TP21, TP22, TP23, TP24: GND; TestPoint__TestPoint_Pad_D1.5mm; MPN PCB test pad; not fitted

Connections:
BENCH_3V3: TP1.1 (1_1); also elsewhere on the board
BUSY_N: J2.13 (BUSY_N), TP13.1 (1_1); also elsewhere on the board
CS_M_N: R41.2, R46.1; also elsewhere on the board
CS_S_N: R42.2, R47.1; also elsewhere on the board
EPD_3V3: R46.2, R47.2, TP2.1 (1_1), TP3.1 (1_1), TP4.1 (1_1); also elsewhere on the board
EPD_PWR_EN: J2.15 (EPD_PWR_EN), TP14.1 (1_1); also elsewhere on the board
GND: J2.2 (GND), J2.4 (GND), J2.6 (GND), J2.8 (GND), J2.10 (GND), J2.12 (GND), J2.14 (GND), R44.2, R45.2, R48.2, TP16.1 (1_1), TP17.1 (1_1), TP18.1 (1_1), TP19.1 (1_1), TP20.1 (1_1), TP21.1 (1_1), TP22.1 (1_1), TP23.1 (1_1), TP24.1 (1_1); also elsewhere on the board
HOST_CS_M_N: J2.7 (CS_M_N), R41.1
HOST_CS_S_N: J2.9 (CS_S_N), R42.1
HOST_MOSI: J2.3 (MOSI), R40.1
HOST_RES_N: J2.11 (RES_N), R43.1
HOST_SCLK: J2.1 (SCLK), R39.1
RES_N: R43.2, R48.1, TP15.1 (1_1); also elsewhere on the board
SCLK: R39.2, R44.1; also elsewhere on the board
SI0: R40.2, R45.1; also elsewhere on the board
SI1: J2.5 (MISO); also elsewhere on the board
TFT_VCOM: TP11.1 (1_1); also elsewhere on the board
VBB_3P5V: TP9.1 (1_1), TP10.1 (1_1); also elsewhere on the board
VCC: TP12.1 (1_1); also elsewhere on the board
VDDN: TP6.1 (1_1); also elsewhere on the board
VDDP: TP5.1 (1_1); also elsewhere on the board
VGH: TP7.1 (1_1); also elsewhere on the board
VGL: TP8.1 (1_1); also elsewhere on the board

Notes on the sheet:
Direct 3.3V host interface - NO power-off signal isolation
Host first ON / last OFF. Screen OFF: no GPIO HIGH, no pull-ups.
J2.16 unused. No live plugging. Short cable <= 10cm.
Test pads: copper only, no parts to buy or solder
