Rhys-Q/album/hardware/pcb/gdep133c02-driver/gdep133c02-driver.kicad_pcb

## KiCad design hardware/pcb/gdep133c02-driver/gdep133c02-driver.kicad_pcb (continued)

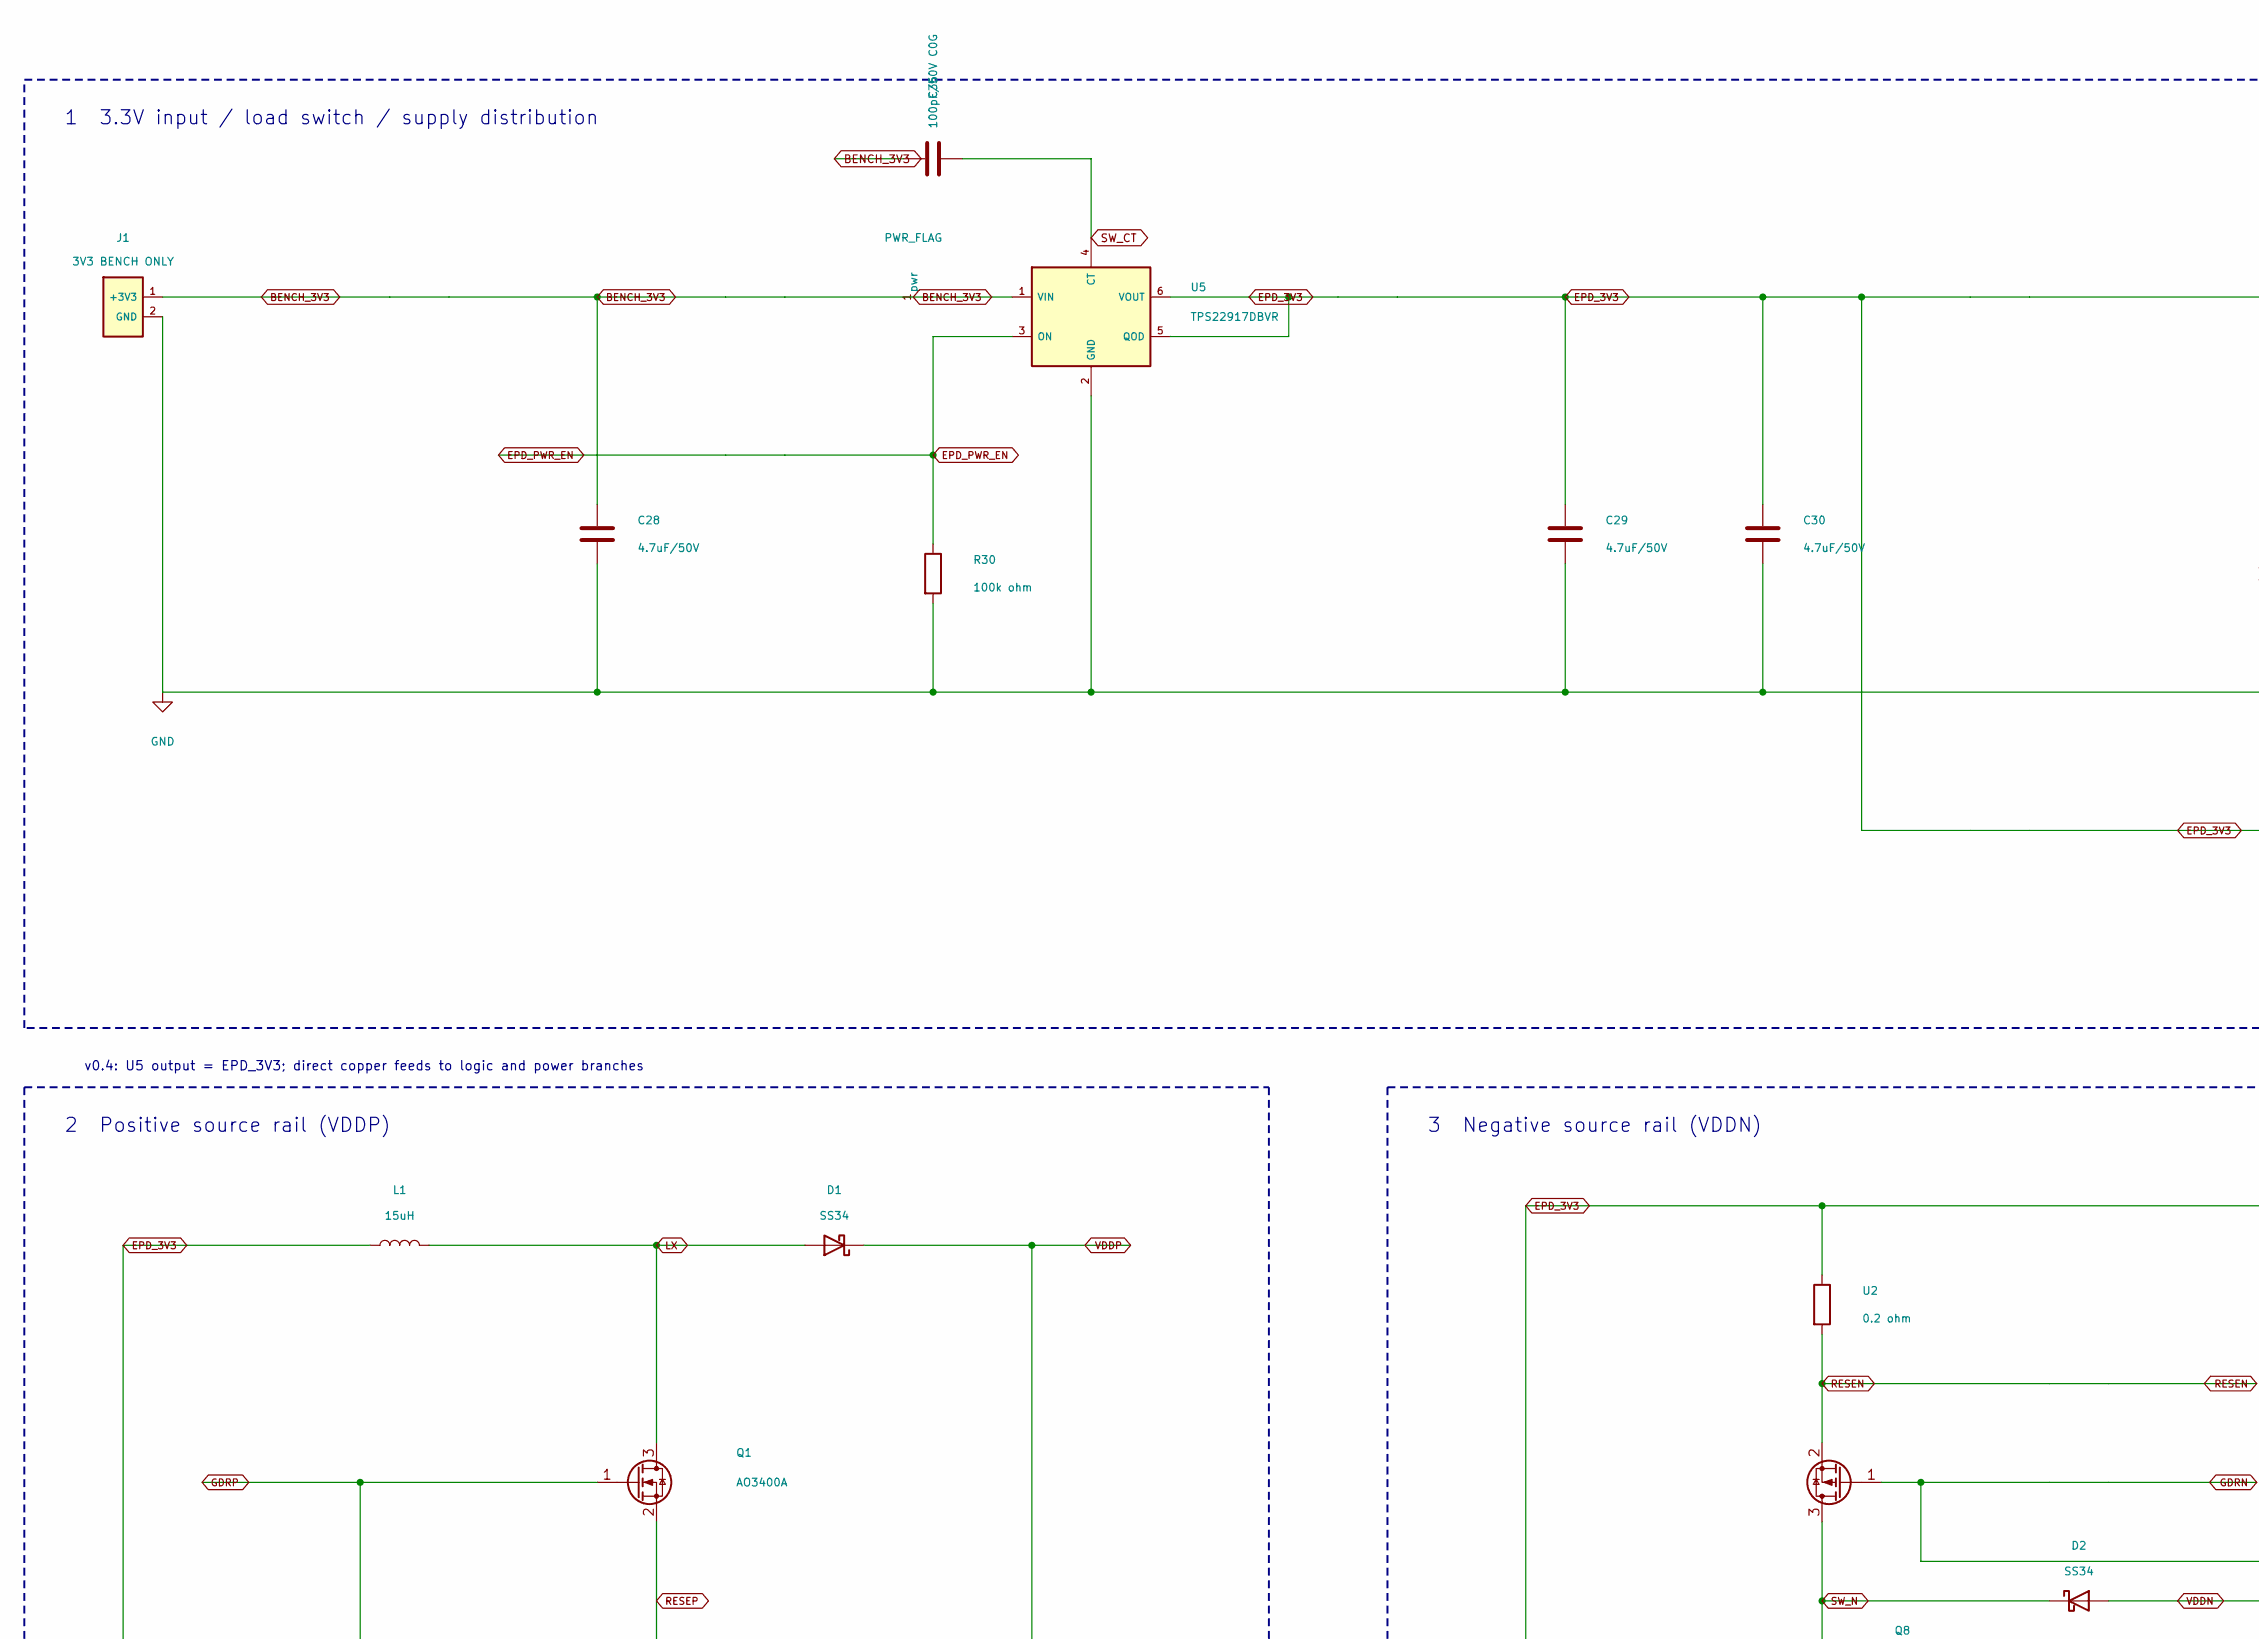
[picture p40: schematic power.kicad_sch, Power - wired functional circuits, part in row 1, column 1]

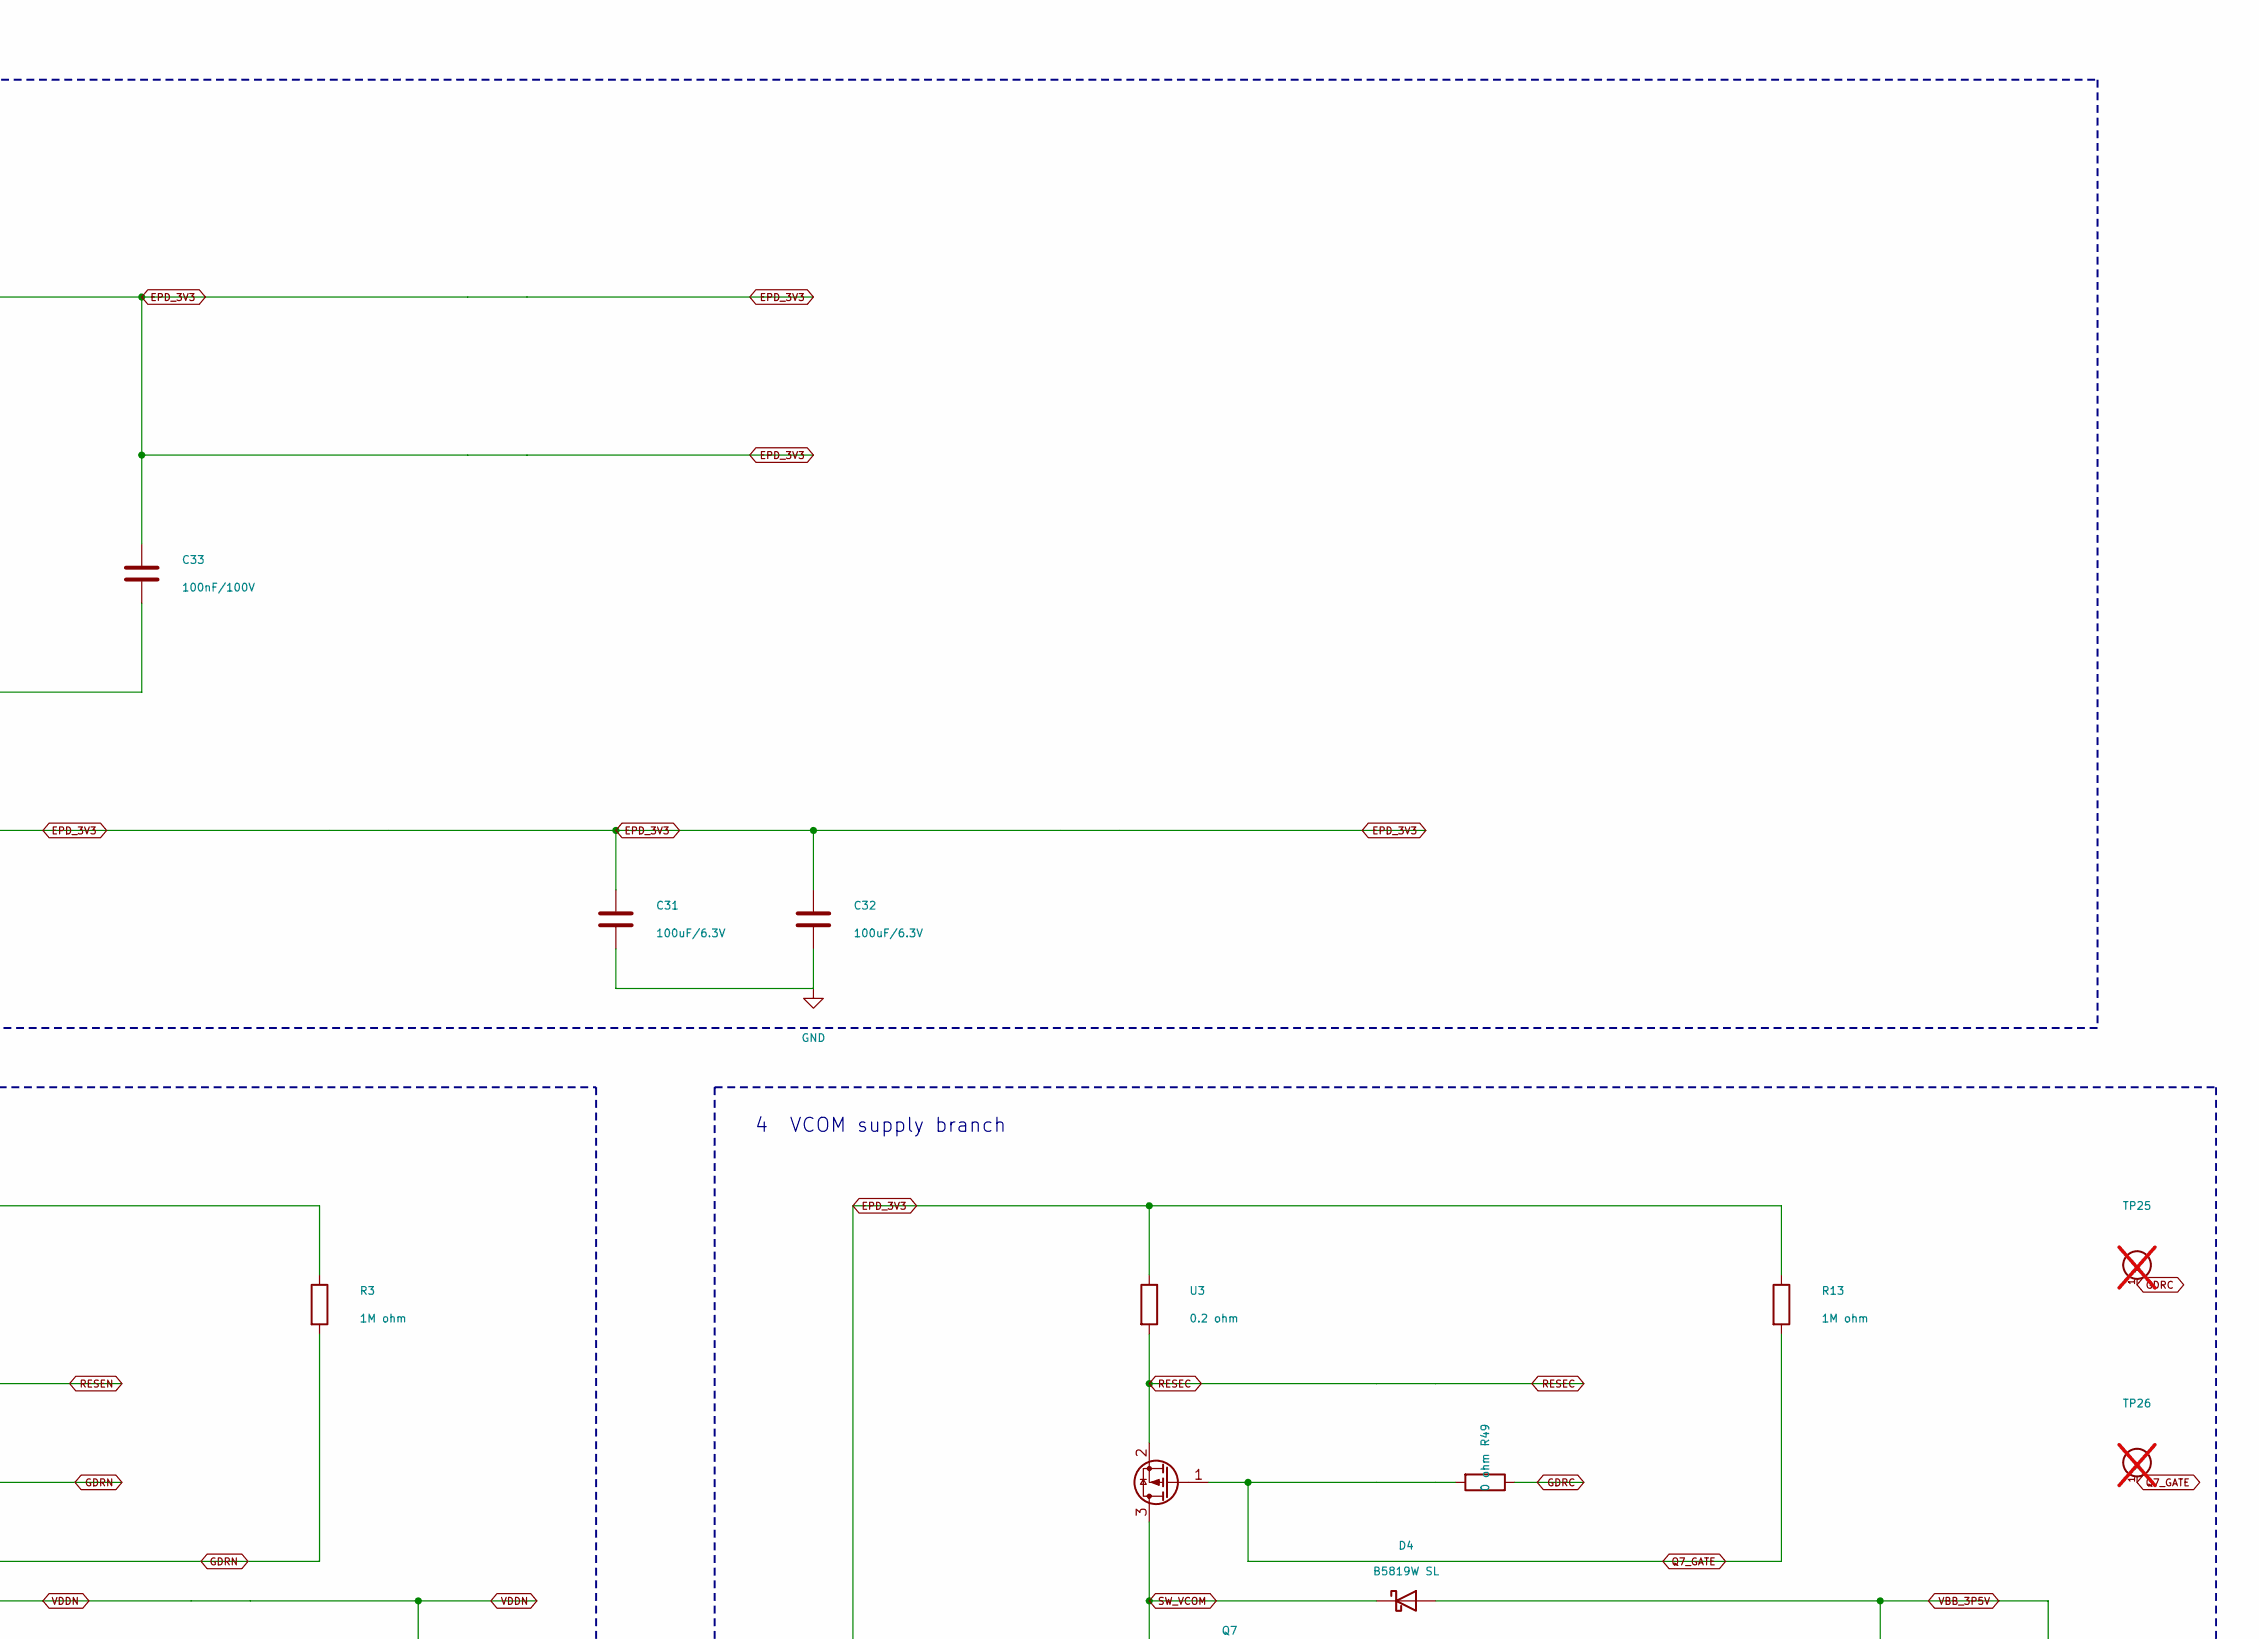
[picture p41: schematic power.kicad_sch, Power - wired functional circuits, part in row 1, column 2]

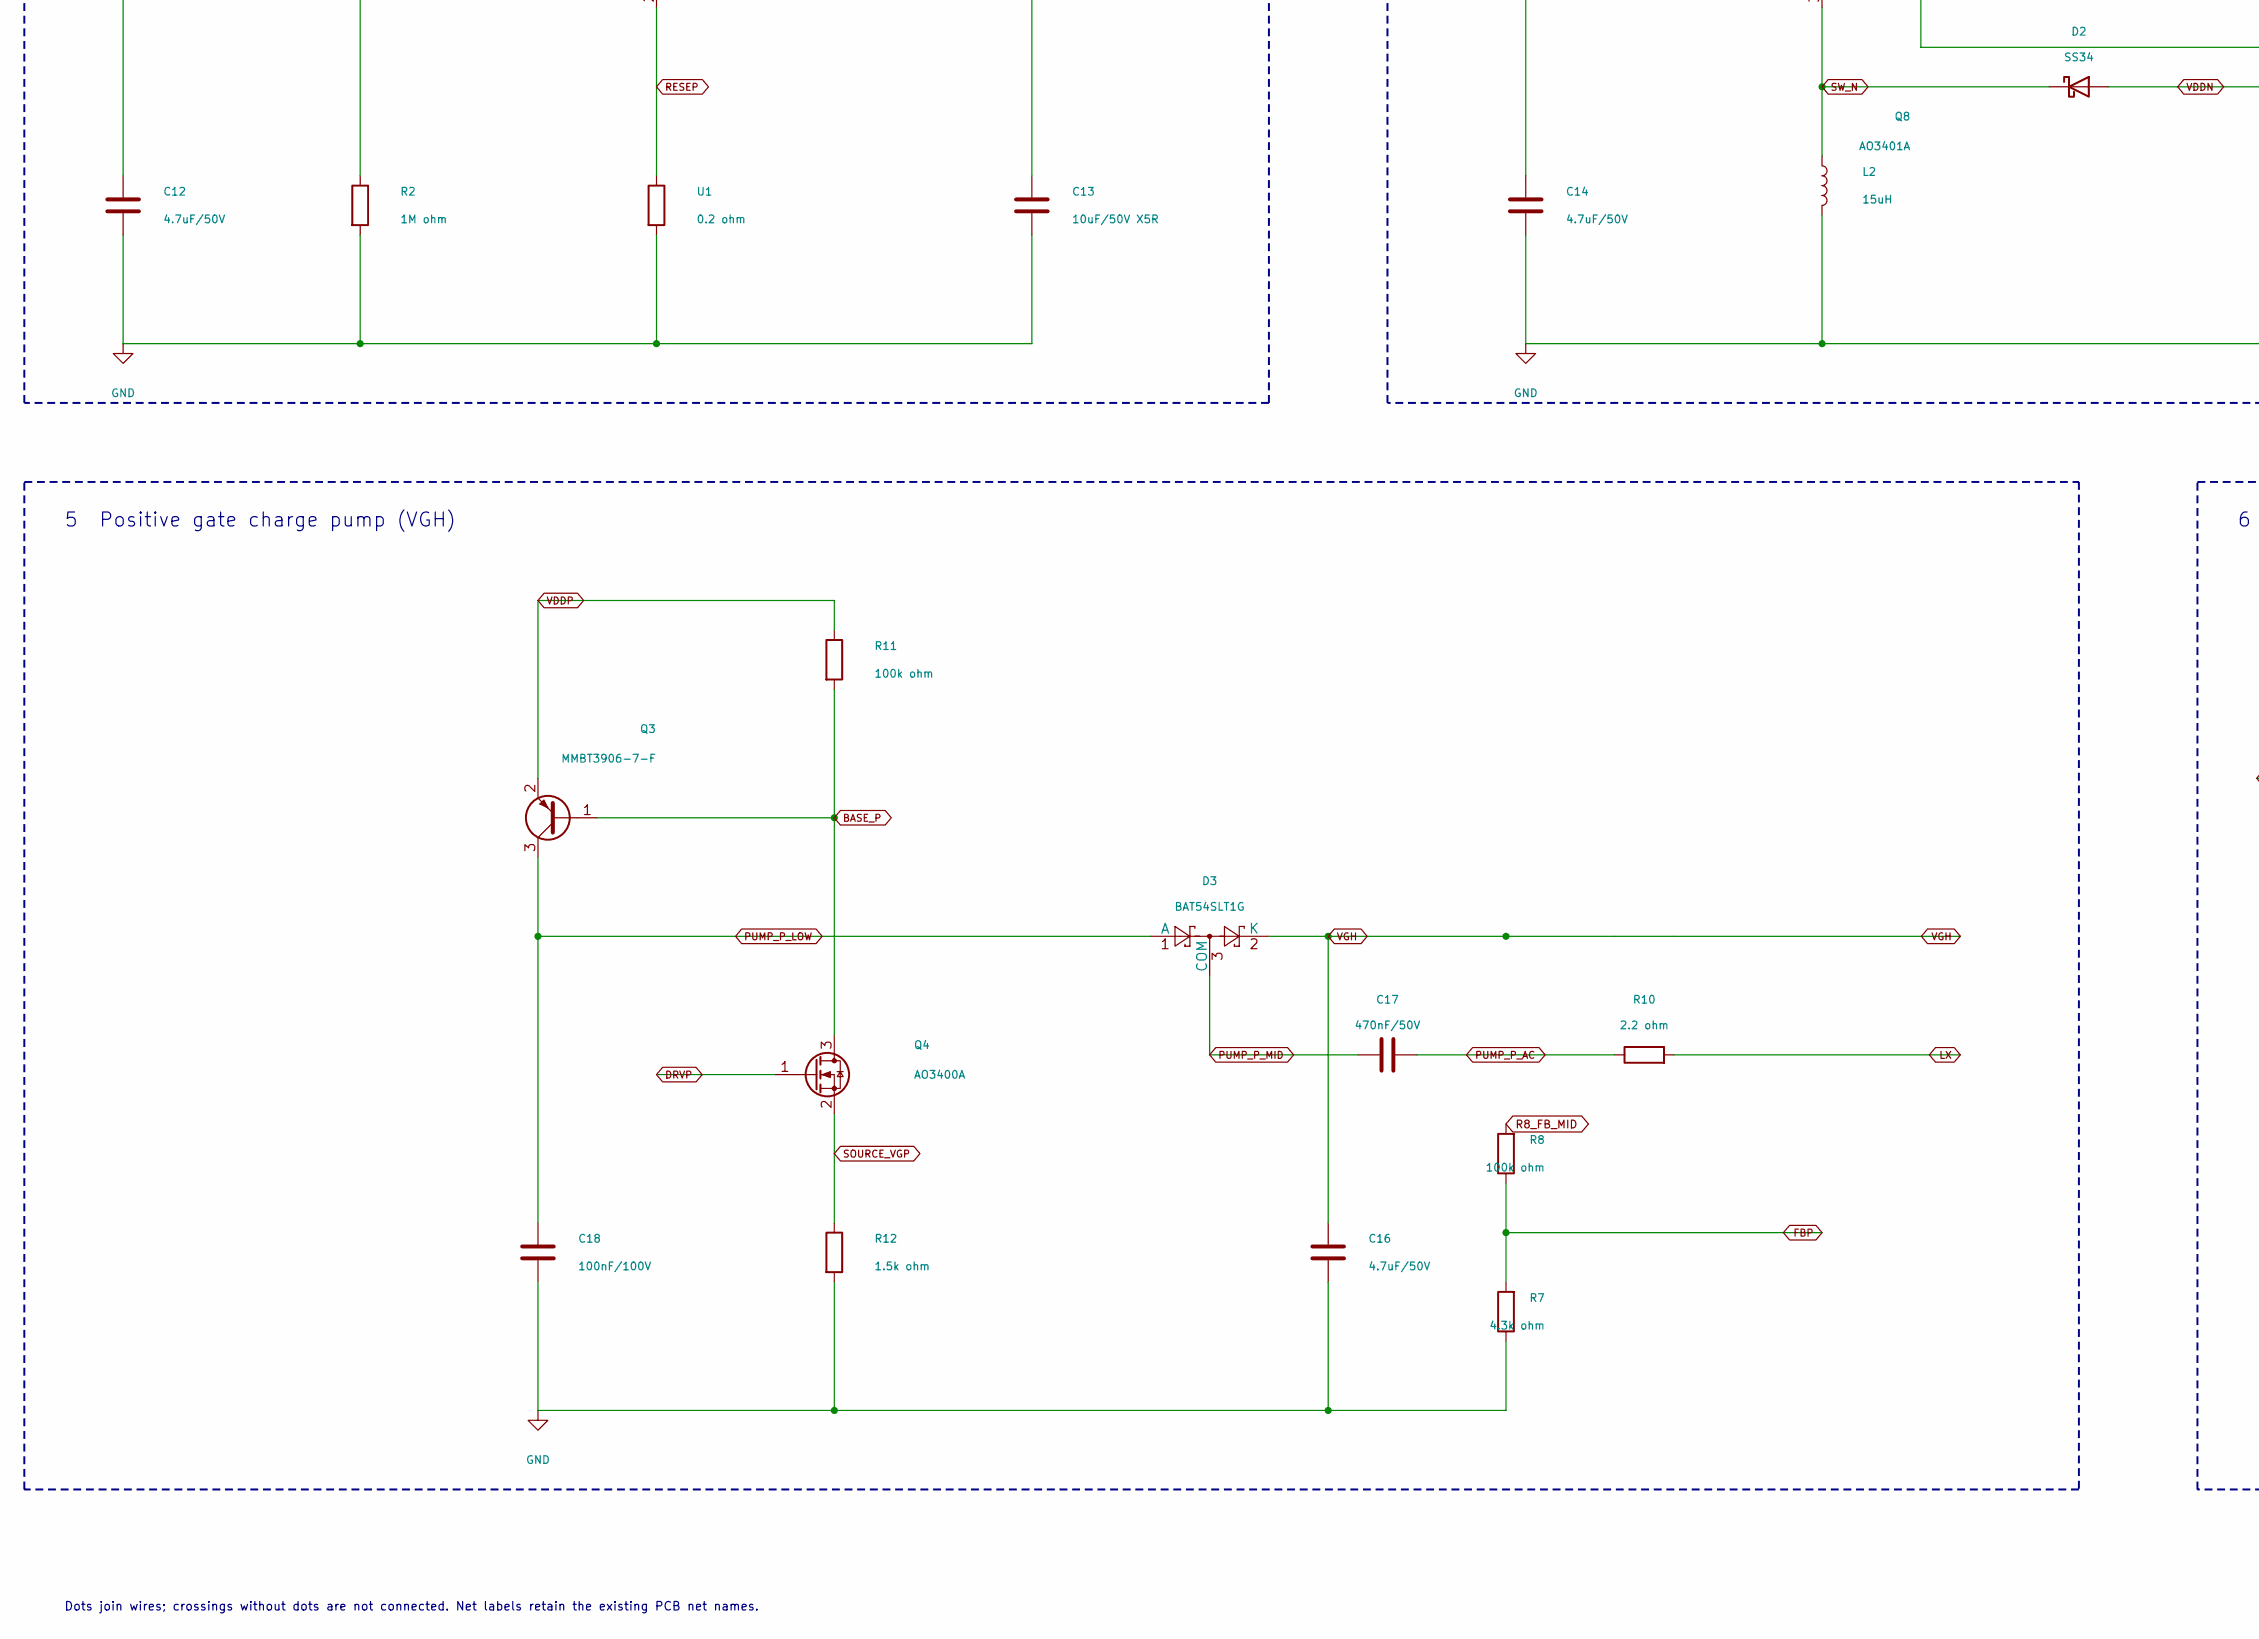
[picture p42: schematic power.kicad_sch, Power - wired functional circuits, part in row 2, column 1]

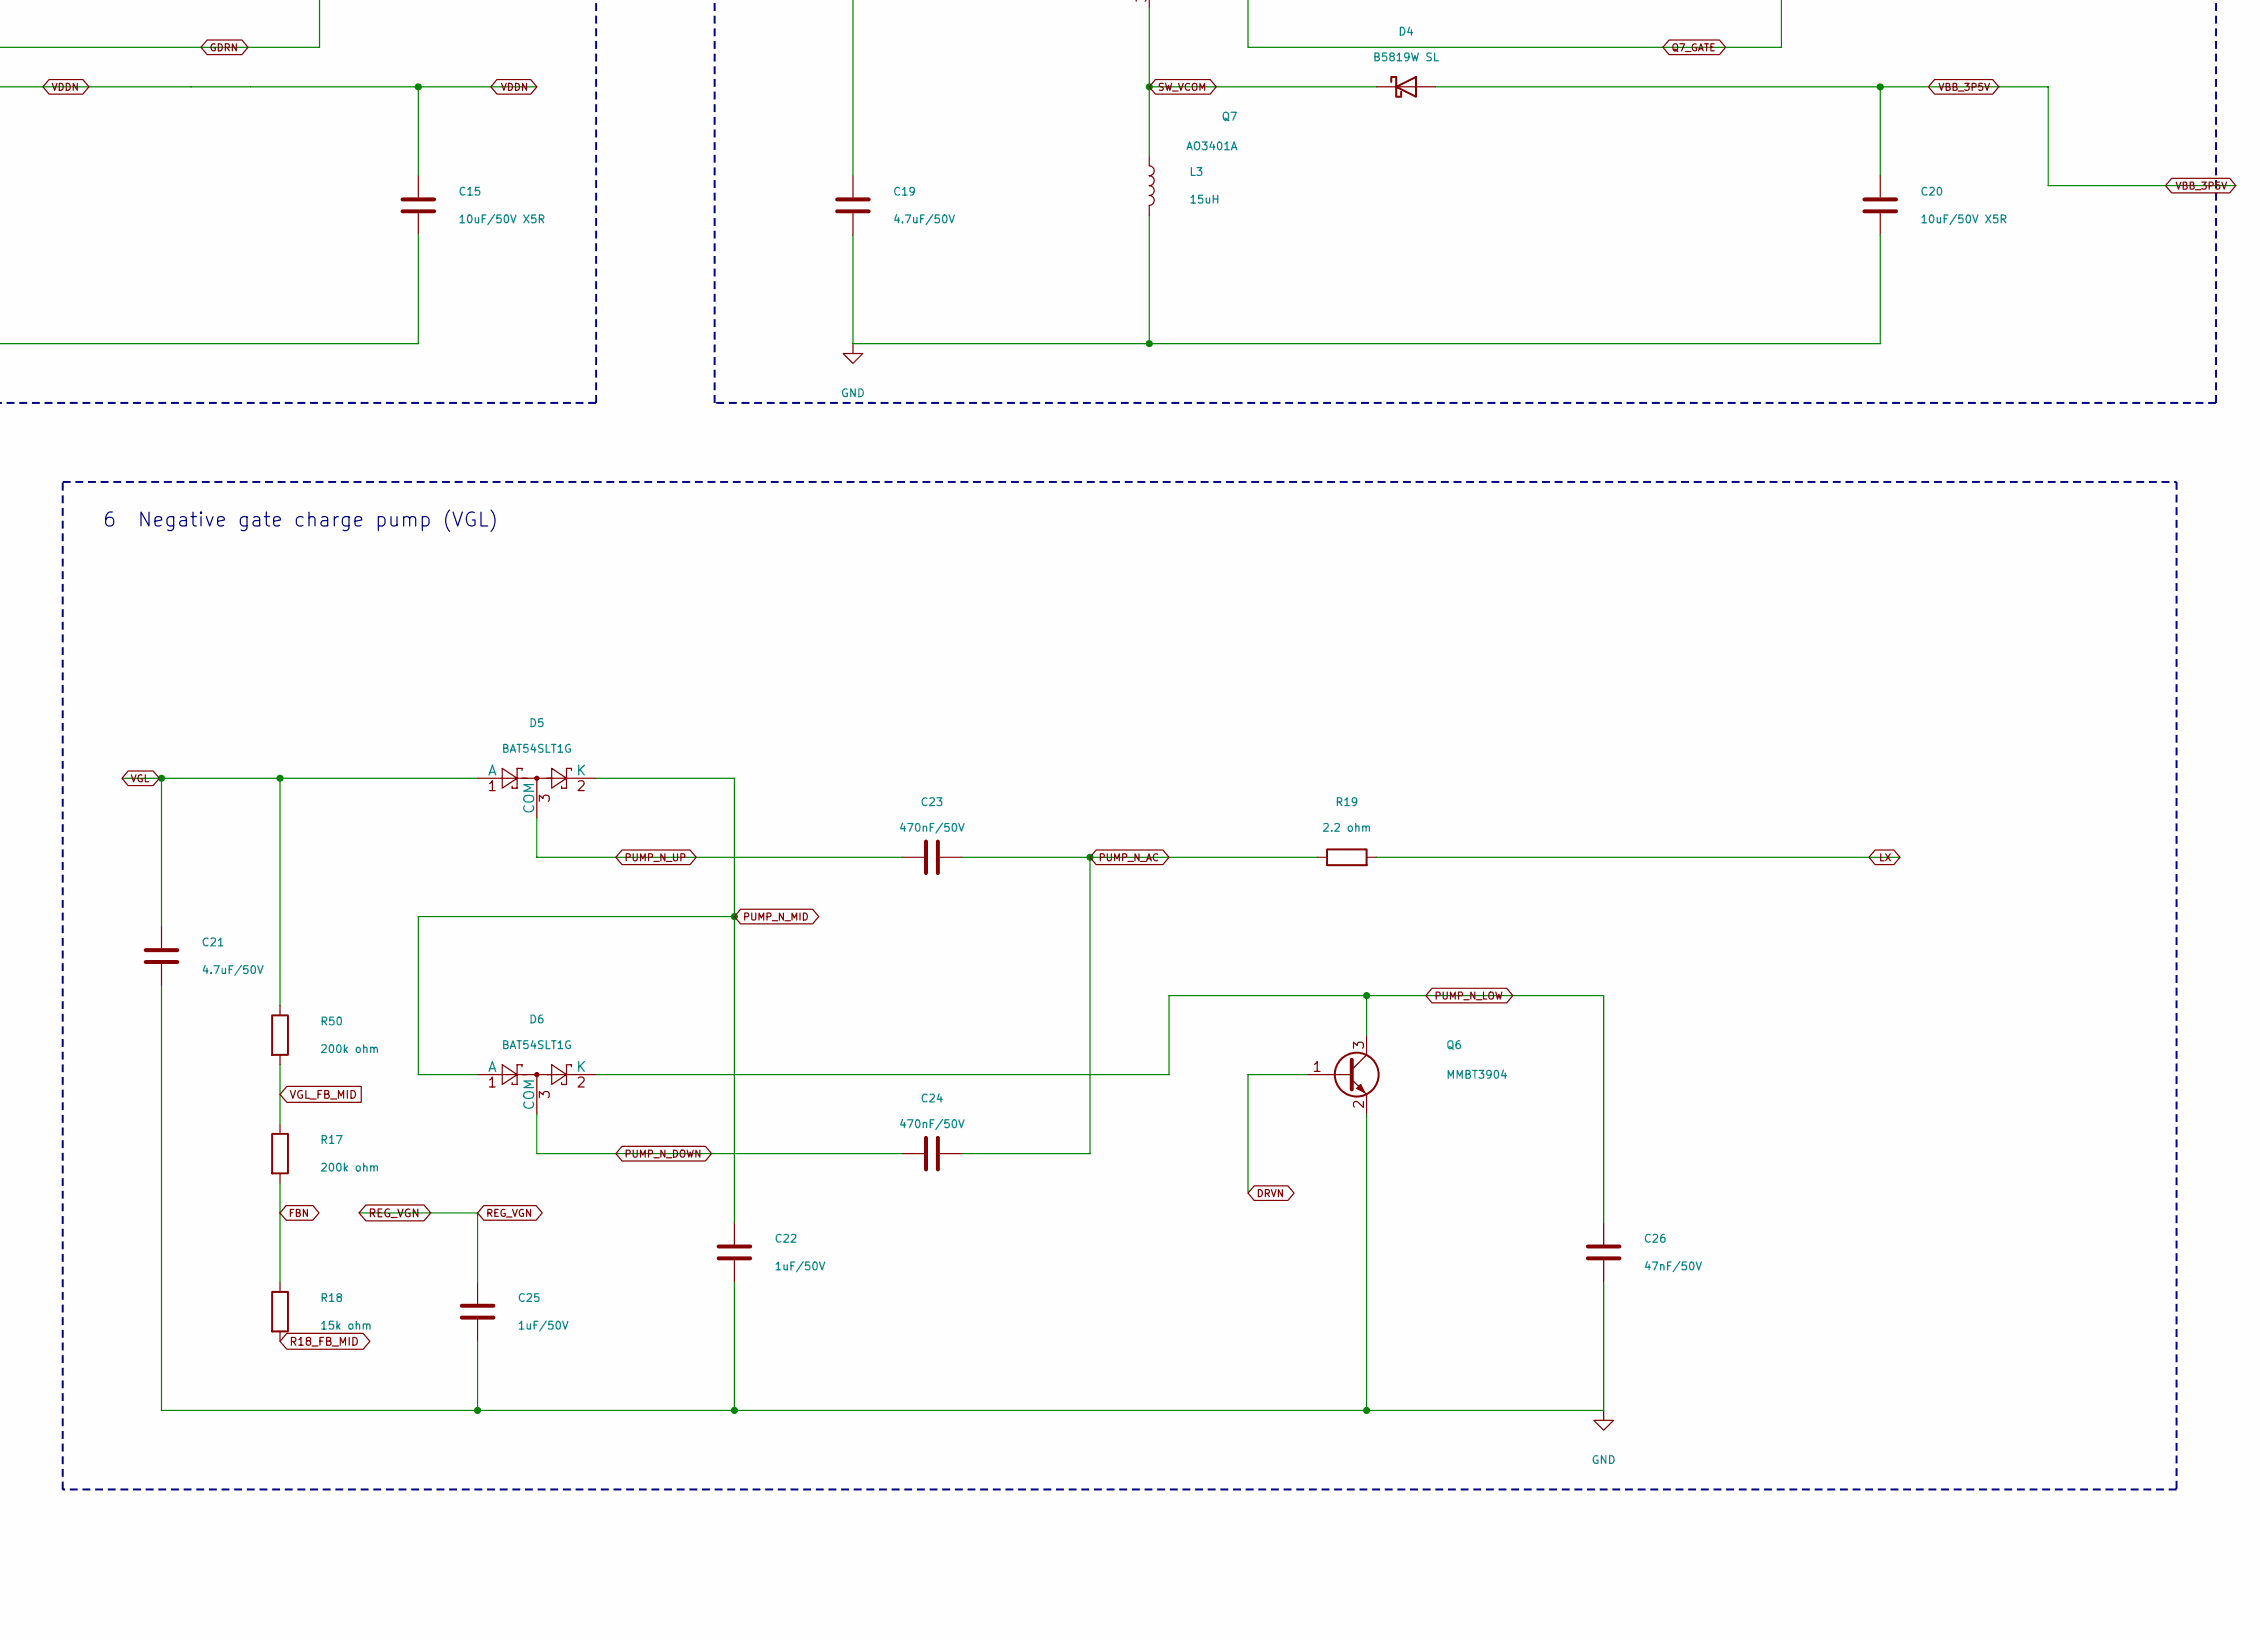
[picture p43: schematic power.kicad_sch, Power - wired functional circuits, part in row 2, column 2]

Parts:
C12, C14, C16, C19, C21, C28, C29, C30: 4.7uF/50V; C_1206_HandSolder; MPN 1206B475K500NT; LCSC C29823
C13, C15, C20: 10uF/50V X5R; C_0805_HandSolder; MPN GRM21BR61H106KE43L; LCSC C440198
C17, C23, C24: 470nF/50V; C_0805_HandSolder; MPN CL21B474KBFNNNE; LCSC C13967
C18, C33: 100nF/100V; C_0805_HandSolder; MPN CL21B104KCFNNNE; LCSC C28233
C22, C25: 1uF/50V; C_0805_HandSolder; MPN CL21B105KBFNNNE; LCSC C28323
C26: 47nF/50V; Capacitor_SMD__C_0603_1608Metric; MPN CL10B473KB8NNNC; LCSC C1622
C31, C32: 100uF/6.3V; C_1206_HandSolder; MPN CL31A107MQHNNNE; LCSC C15008
C36: 100pF/50V C0G; Capacitor_SMD__C_0603_1608Metric; MPN CL10C101JB8NNNC; LCSC C14858
D1, D2: SS34; D_SMA_HandSolder; MPN SS34; LCSC C8678
D3, D5, D6: BAT54SLT1G; Package_TO_SOT_SMD__SOT-23; MPN BAT54SLT1G; LCSC C19726
D4: B5819W SL; Diode_SMD__D_SOD-123; MPN B5819W SL; LCSC C8598
J1: 3V3 BENCH ONLY; Connector_PinHeader_2.54mm__PinHeader_1x02_P2.54mm_Vertical; MPN TJC8-2.54-2A; LCSC C42410552
L1, L2, L3: 15uH; L_JIERR_PCR1040; MPN PCR1040-150-M; LCSC C53896892
Q1, Q4: AO3400A; Package_TO_SOT_SMD__SOT-23; MPN AO3400A; LCSC C20917
Q3: MMBT3906-7-F; Package_TO_SOT_SMD__SOT-23; MPN MMBT3906-7-F; LCSC C82762
Q6: MMBT3904; Package_TO_SOT_SMD__SOT-23; MPN MMBT3904(RANGE:100-300); LCSC C20526
Q7, Q8: AO3401A; Package_TO_SOT_SMD__SOT-23; MPN AO3401A; LCSC C15127
R2, R3, R13: 1M ohm; R_0805_HandSolder; MPN 0805W8F1004T5E; LCSC C17514
R7: 4.3k ohm; R_0805_HandSolder; MPN 0805W8F4301T5E; LCSC C17667
R8, R11, R30: 100k ohm; R_0805_HandSolder; MPN 0805W8F1003T5E; LCSC C149504
R10, R19: 2.2 ohm; R_0805_HandSolder; MPN 0805W8F220KT5E; LCSC C17521
R12: 1.5k ohm; R_0805_HandSolder; MPN 0805W8F1501T5E; LCSC C4310
R17, R50: 200k ohm; R_0805_HandSolder; MPN 0805W8F2003T5E; LCSC C17539
R18: 15k ohm; R_0805_HandSolder; MPN 0805W8F1502T5E; LCSC C17475
R49: 0 ohm; Resistor_SMD__R_0805_2012Metric; MPN 0805W8F0000T5E; LCSC C17477
TP25: GDRC; TestPoint__TestPoint_Pad_D1.5mm; MPN PCB test pad; not fitted
TP26: Q7_GATE; TestPoint__TestPoint_Pad_D1.5mm; MPN PCB test pad; not fitted
U1, U2, U3: 0.2 ohm; Resistor_SMD__R_1206_3216Metric; MPN WSL1206R2000FEA; LCSC C2073442
U5: TPS22917DBVR; Package_TO_SOT_SMD__SOT-23-6; MPN TPS22917DBVR; LCSC C2681320

Connections:
BASE_P: Q3.1 (B), Q4.3 (D), R11.2
BENCH_3V3: C28.1, C36.1, J1.1 (+3V3), U5.1 (VIN); also elsewhere on the board
DRVN: Q6.1 (B); also elsewhere on the board
DRVP: Q4.1 (G); also elsewhere on the board
EPD_3V3: C12.1, C14.1, C19.1, C29.1, C30.1, C31.1, C32.1, C33.1, L1.1, R3.1, R13.1, U2.1, U3.1, U5.5 (QOD), U5.6 (VOUT); also elsewhere on the board
EPD_PWR_EN: R30.1, U5.3 (ON); also elsewhere on the board
FBN: R17.2, R18.1; also elsewhere on the board
FBP: R7.2, R8.1; also elsewhere on the board
GDRC: R49.1, TP25.1 (1_1); also elsewhere on the board
GDRN: Q8.1 (G), R3.2; also elsewhere on the board
GDRP: Q1.1 (G), R2.1; also elsewhere on the board
GND: C12.2, C13.2, C14.2, C15.2, C16.2, C18.2, C19.2, C20.2, C21.2, C22.2, C25.2, C26.2, C28.2, C29.2, C30.2, C31.2, C32.2, C33.2, J1.2 (GND), L2.2, L3.2, Q6.2 (E), R2.2, R7.1, R12.2, R30.2, U1.2, U5.2 (GND); also elsewhere on the board
LX: D1.2 (A), L1.2, Q1.3 (D), R10.2, R19.2
PUMP_N_AC: C23.2, C24.2, R19.1
PUMP_N_DOWN: C24.1, D6.3 (COM)
PUMP_N_LOW: C26.1, D6.2 (K), Q6.3 (C)
PUMP_N_MID: C22.1, D5.2 (K), D6.1 (A)
PUMP_N_UP: C23.1, D5.3 (COM)
PUMP_P_AC: C17.2, R10.1
PUMP_P_LOW: C18.1, D3.1 (A), Q3.3 (C); also elsewhere on the board
PUMP_P_MID: C17.1, D3.3 (COM)
Q7_GATE: Q7.1 (G), R13.2, R49.2, TP26.1 (1_1)
R8_FB_MID: R8.2; also elsewhere on the board
R18_FB_MID: R18.2; also elsewhere on the board
REG_VGN: C25.1; also elsewhere on the board
RESEC: Q7.2 (S), U3.2; also elsewhere on the board
RESEN: Q8.2 (S), U2.2; also elsewhere on the board
RESEP: Q1.2 (S), U1.1; also elsewhere on the board
SOURCE_VGP: Q4.2 (S), R12.1
SW_CT: C36.2, U5.4 (CT); also elsewhere on the board
SW_N: D2.1 (K), L2.1, Q8.3 (D)
SW_VCOM: D4.1 (K), L3.1, Q7.3 (D)
VBB_3P5V: C20.1, D4.2 (A); also elsewhere on the board
VDDN: C15.1, D2.2 (A); also elsewhere on the board
VDDP: C13.1, D1.1 (K), Q3.2 (E), R11.1; also elsewhere on the board
VGH: C16.1, D3.2 (K); also elsewhere on the board
VGL: C21.1, D5.1 (A), R50.1; also elsewhere on the board
VGL_FB_MID: R17.1, R50.2

Notes on the sheet:
1 3.3V input / load switch / supply distribution
2 Positive source rail (VDDP)
3 Negative source rail (VDDN)
4 VCOM supply branch
5 Positive gate charge pump (VGH)
6 Negative gate charge pump (VGL)
Dots join wires; crossings without dots are not connected. Net labels retain the existing PCB net names.
v0.4: U5 output = EPD_3V3; direct copper feeds to logic and power branches
