Rhys-Q/album/hardware/pcb/gdep133c02-driver/gdep133c02-driver.kicad_pcb

## KiCad design hardware/pcb/gdep133c02-driver/gdep133c02-driver.kicad_pcb (continued)

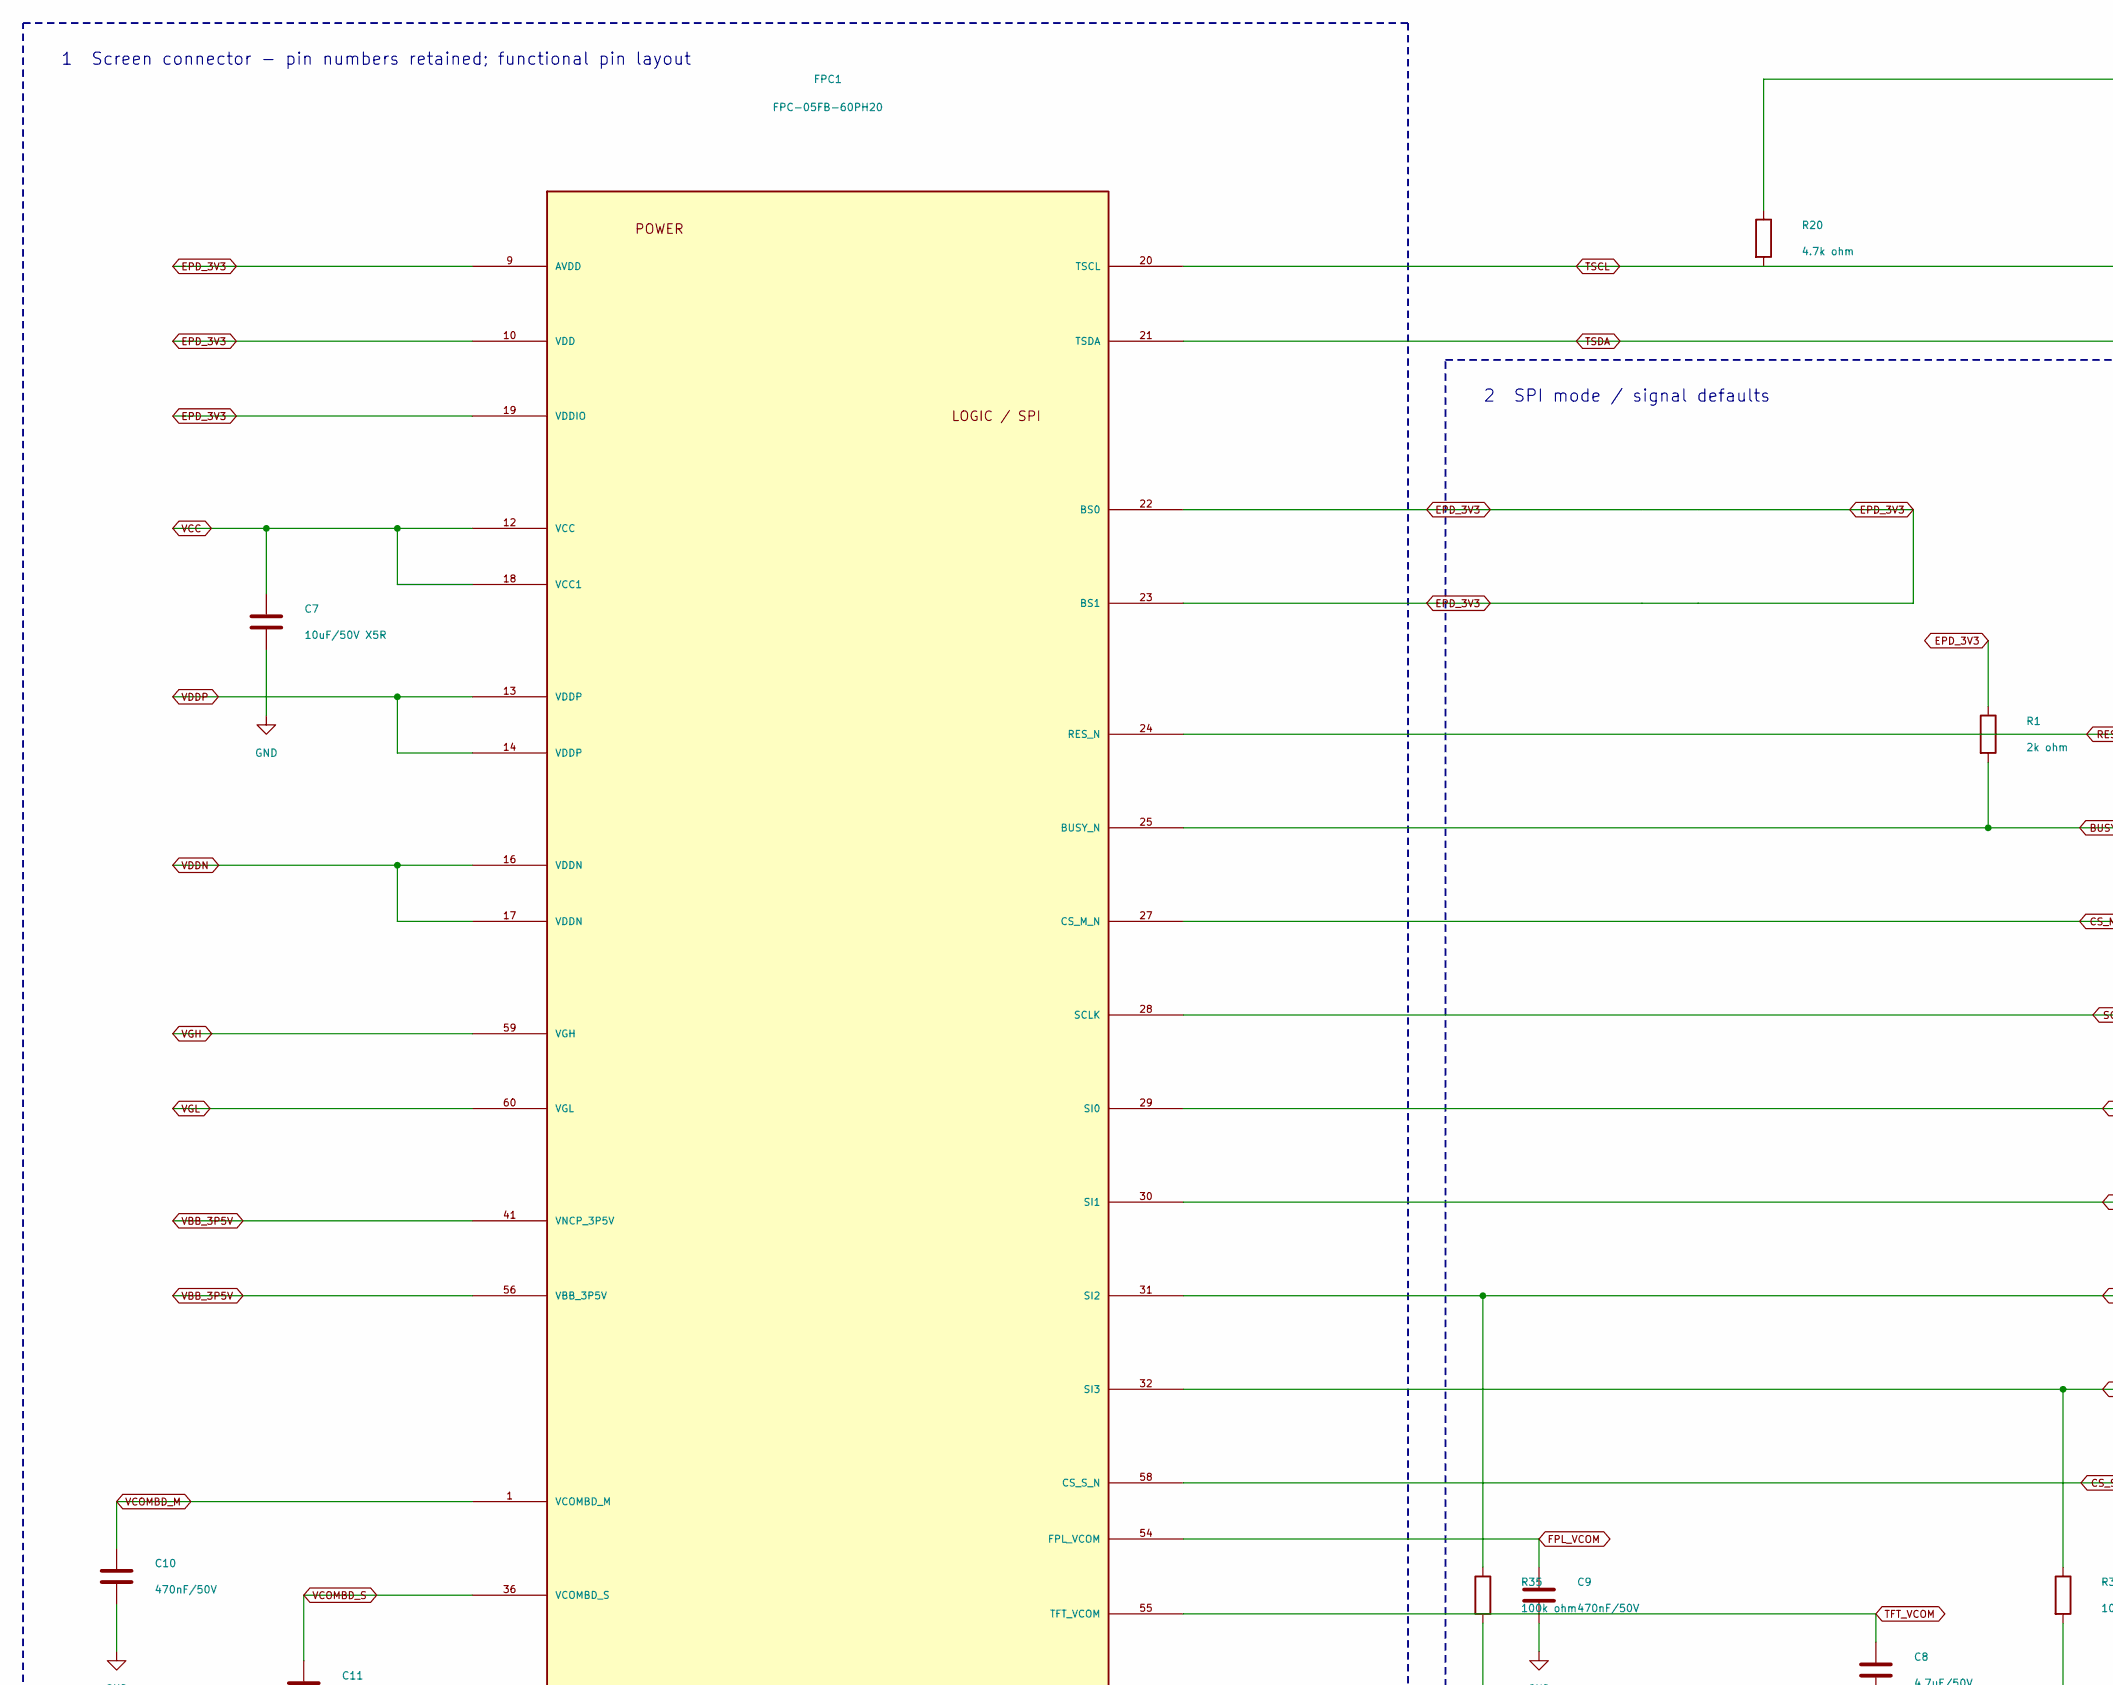
[picture p44: schematic panel.kicad_sch, Panel - wired functional circuits, part in row 1, column 1]

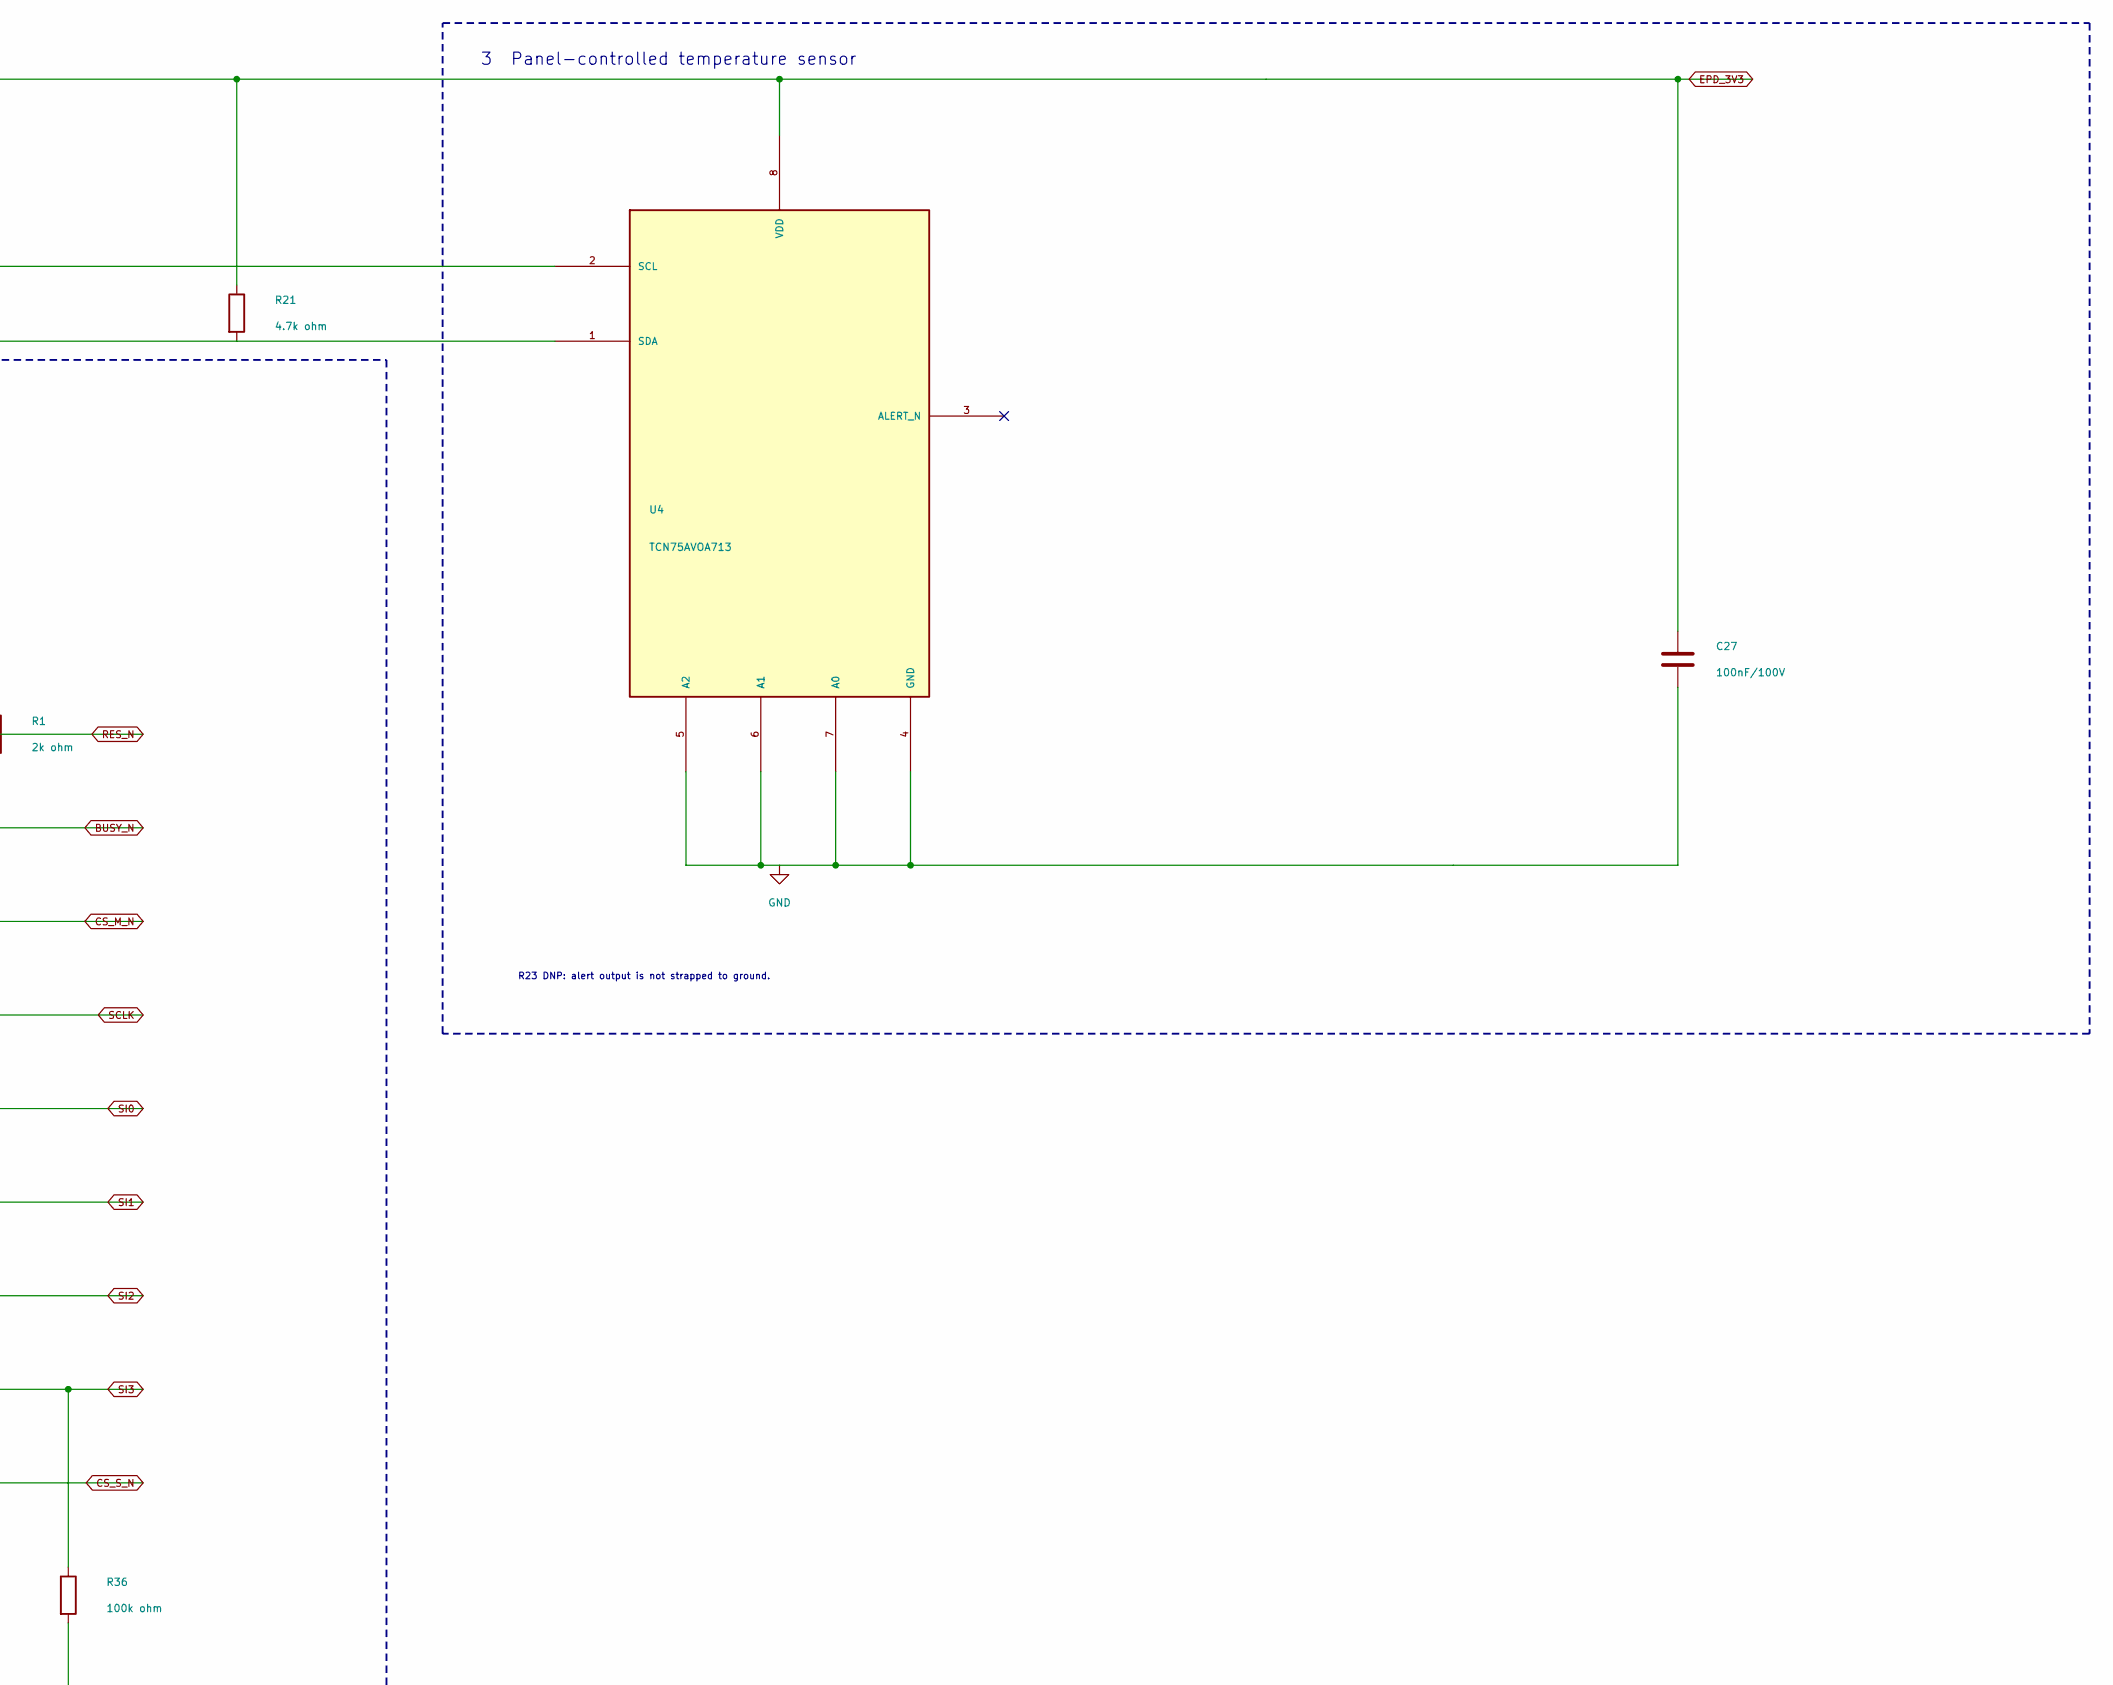
[picture p45: schematic panel.kicad_sch, Panel - wired functional circuits, part in row 1, column 2]

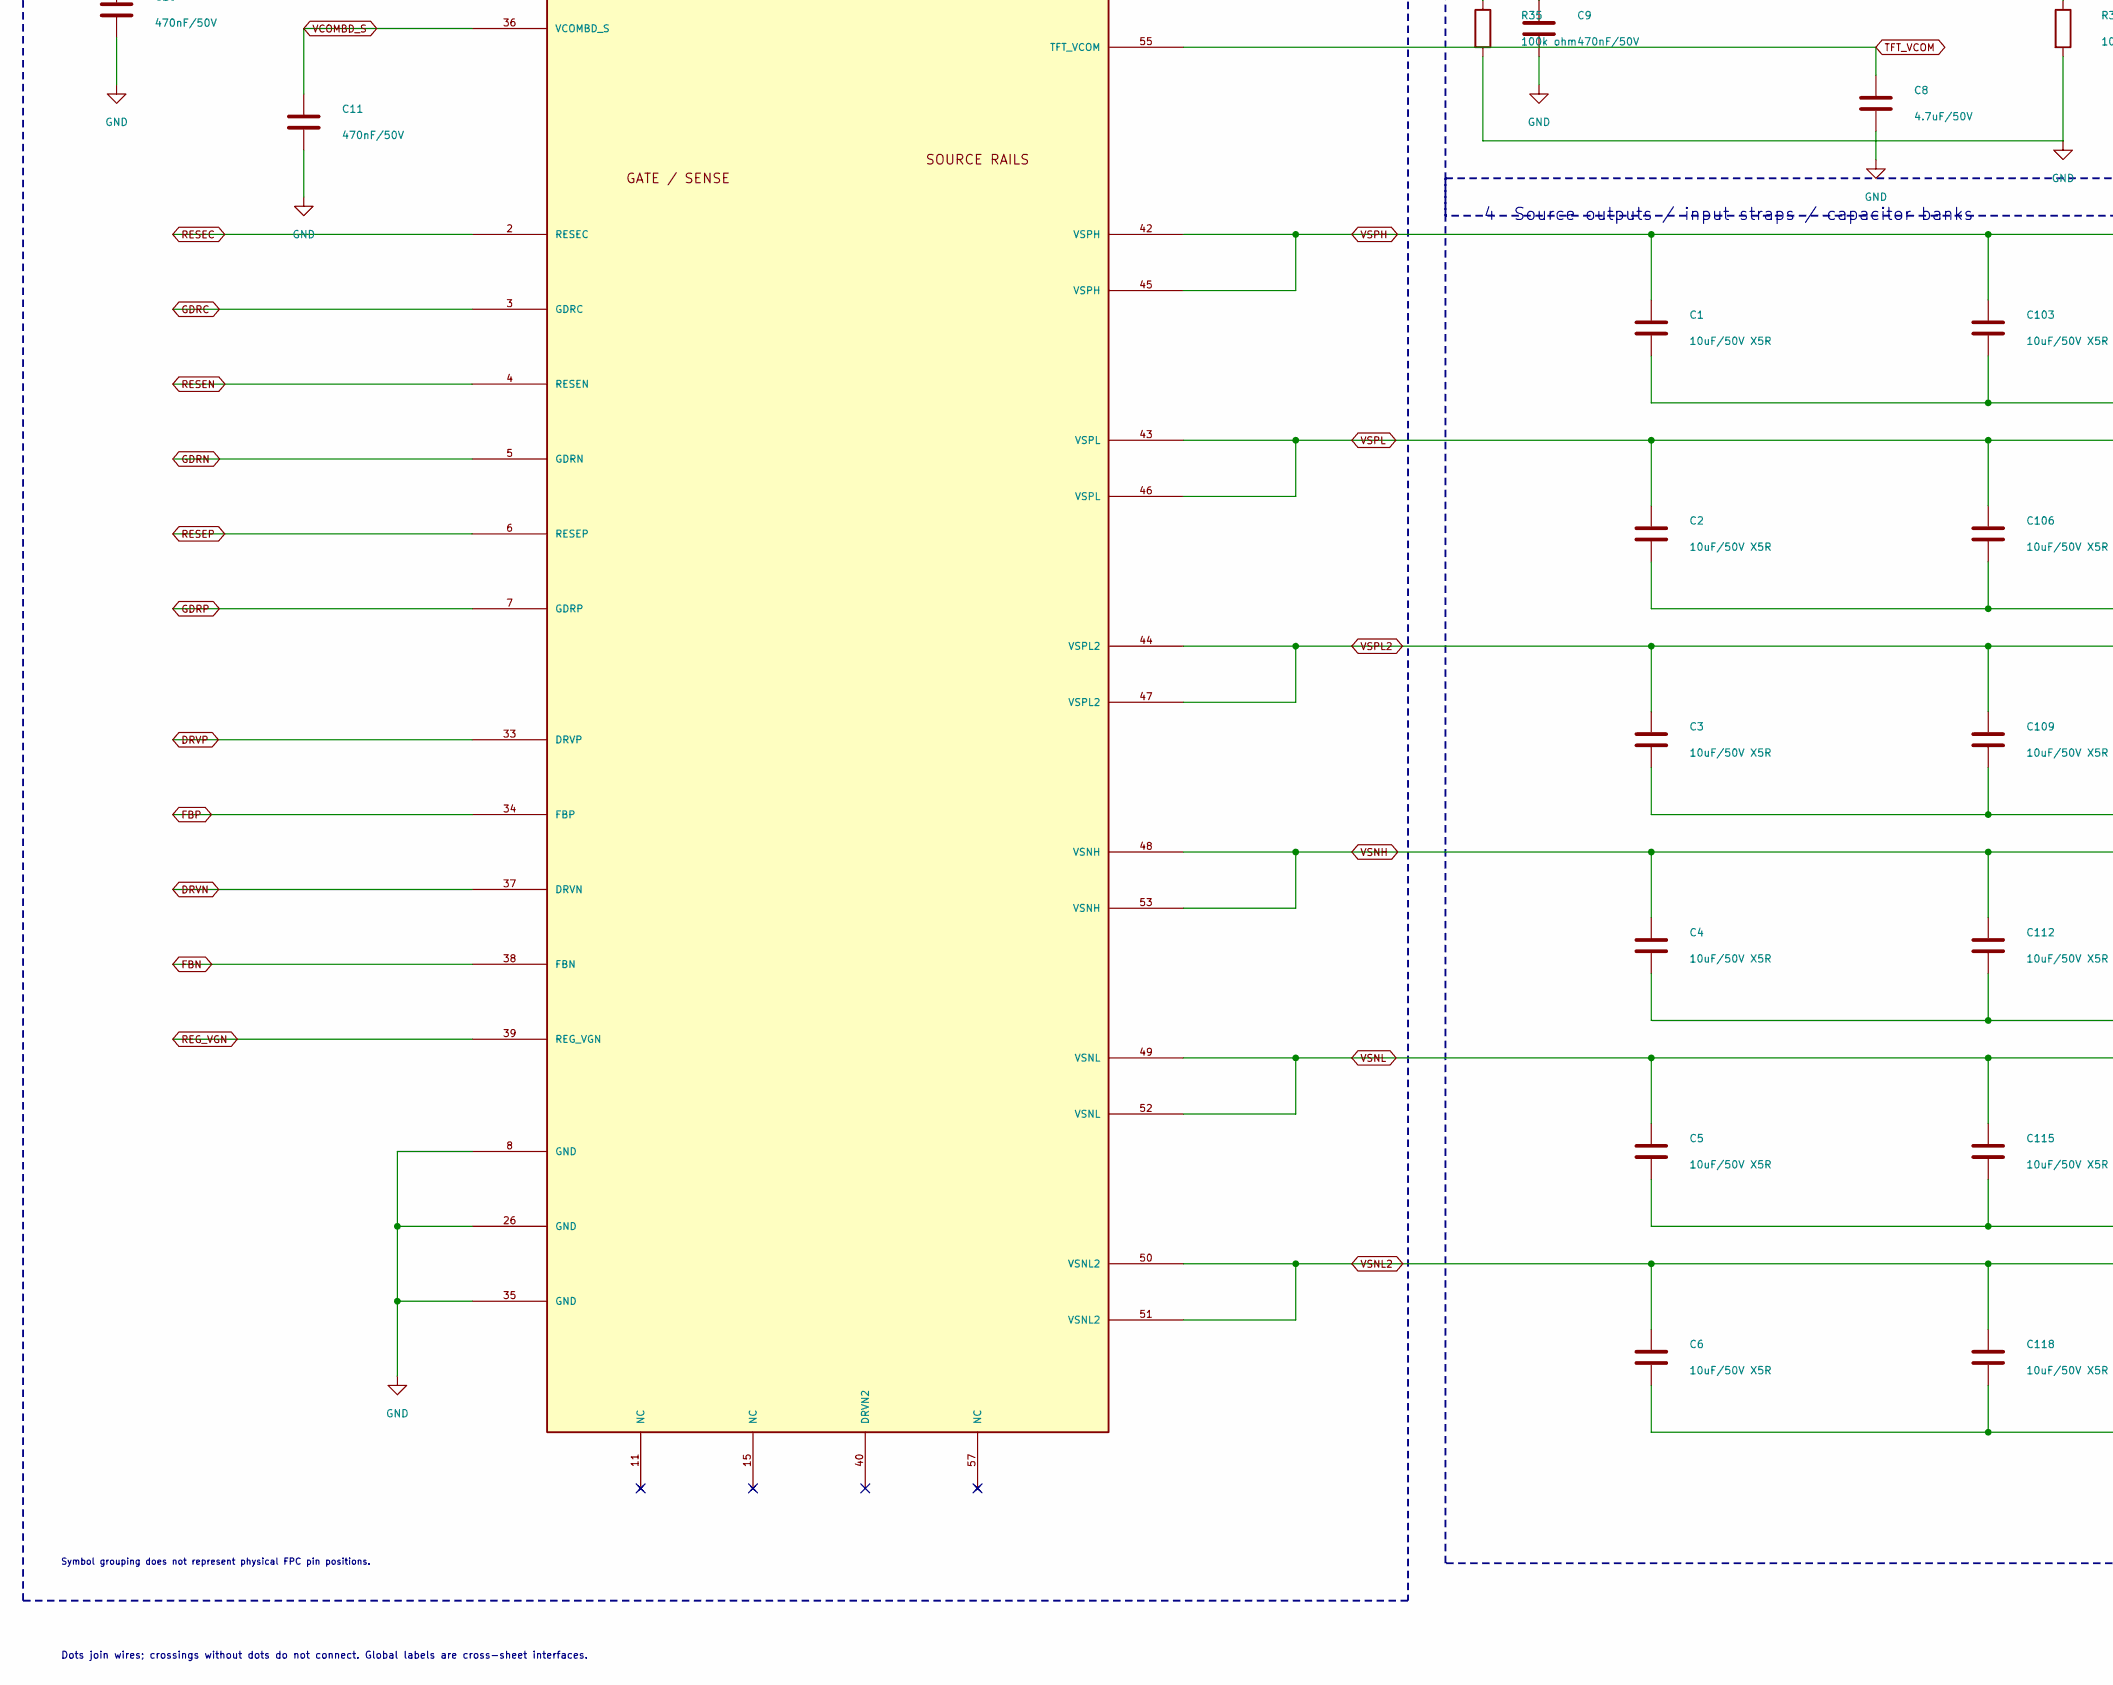
[picture p46: schematic panel.kicad_sch, Panel - wired functional circuits, part in row 2, column 1]

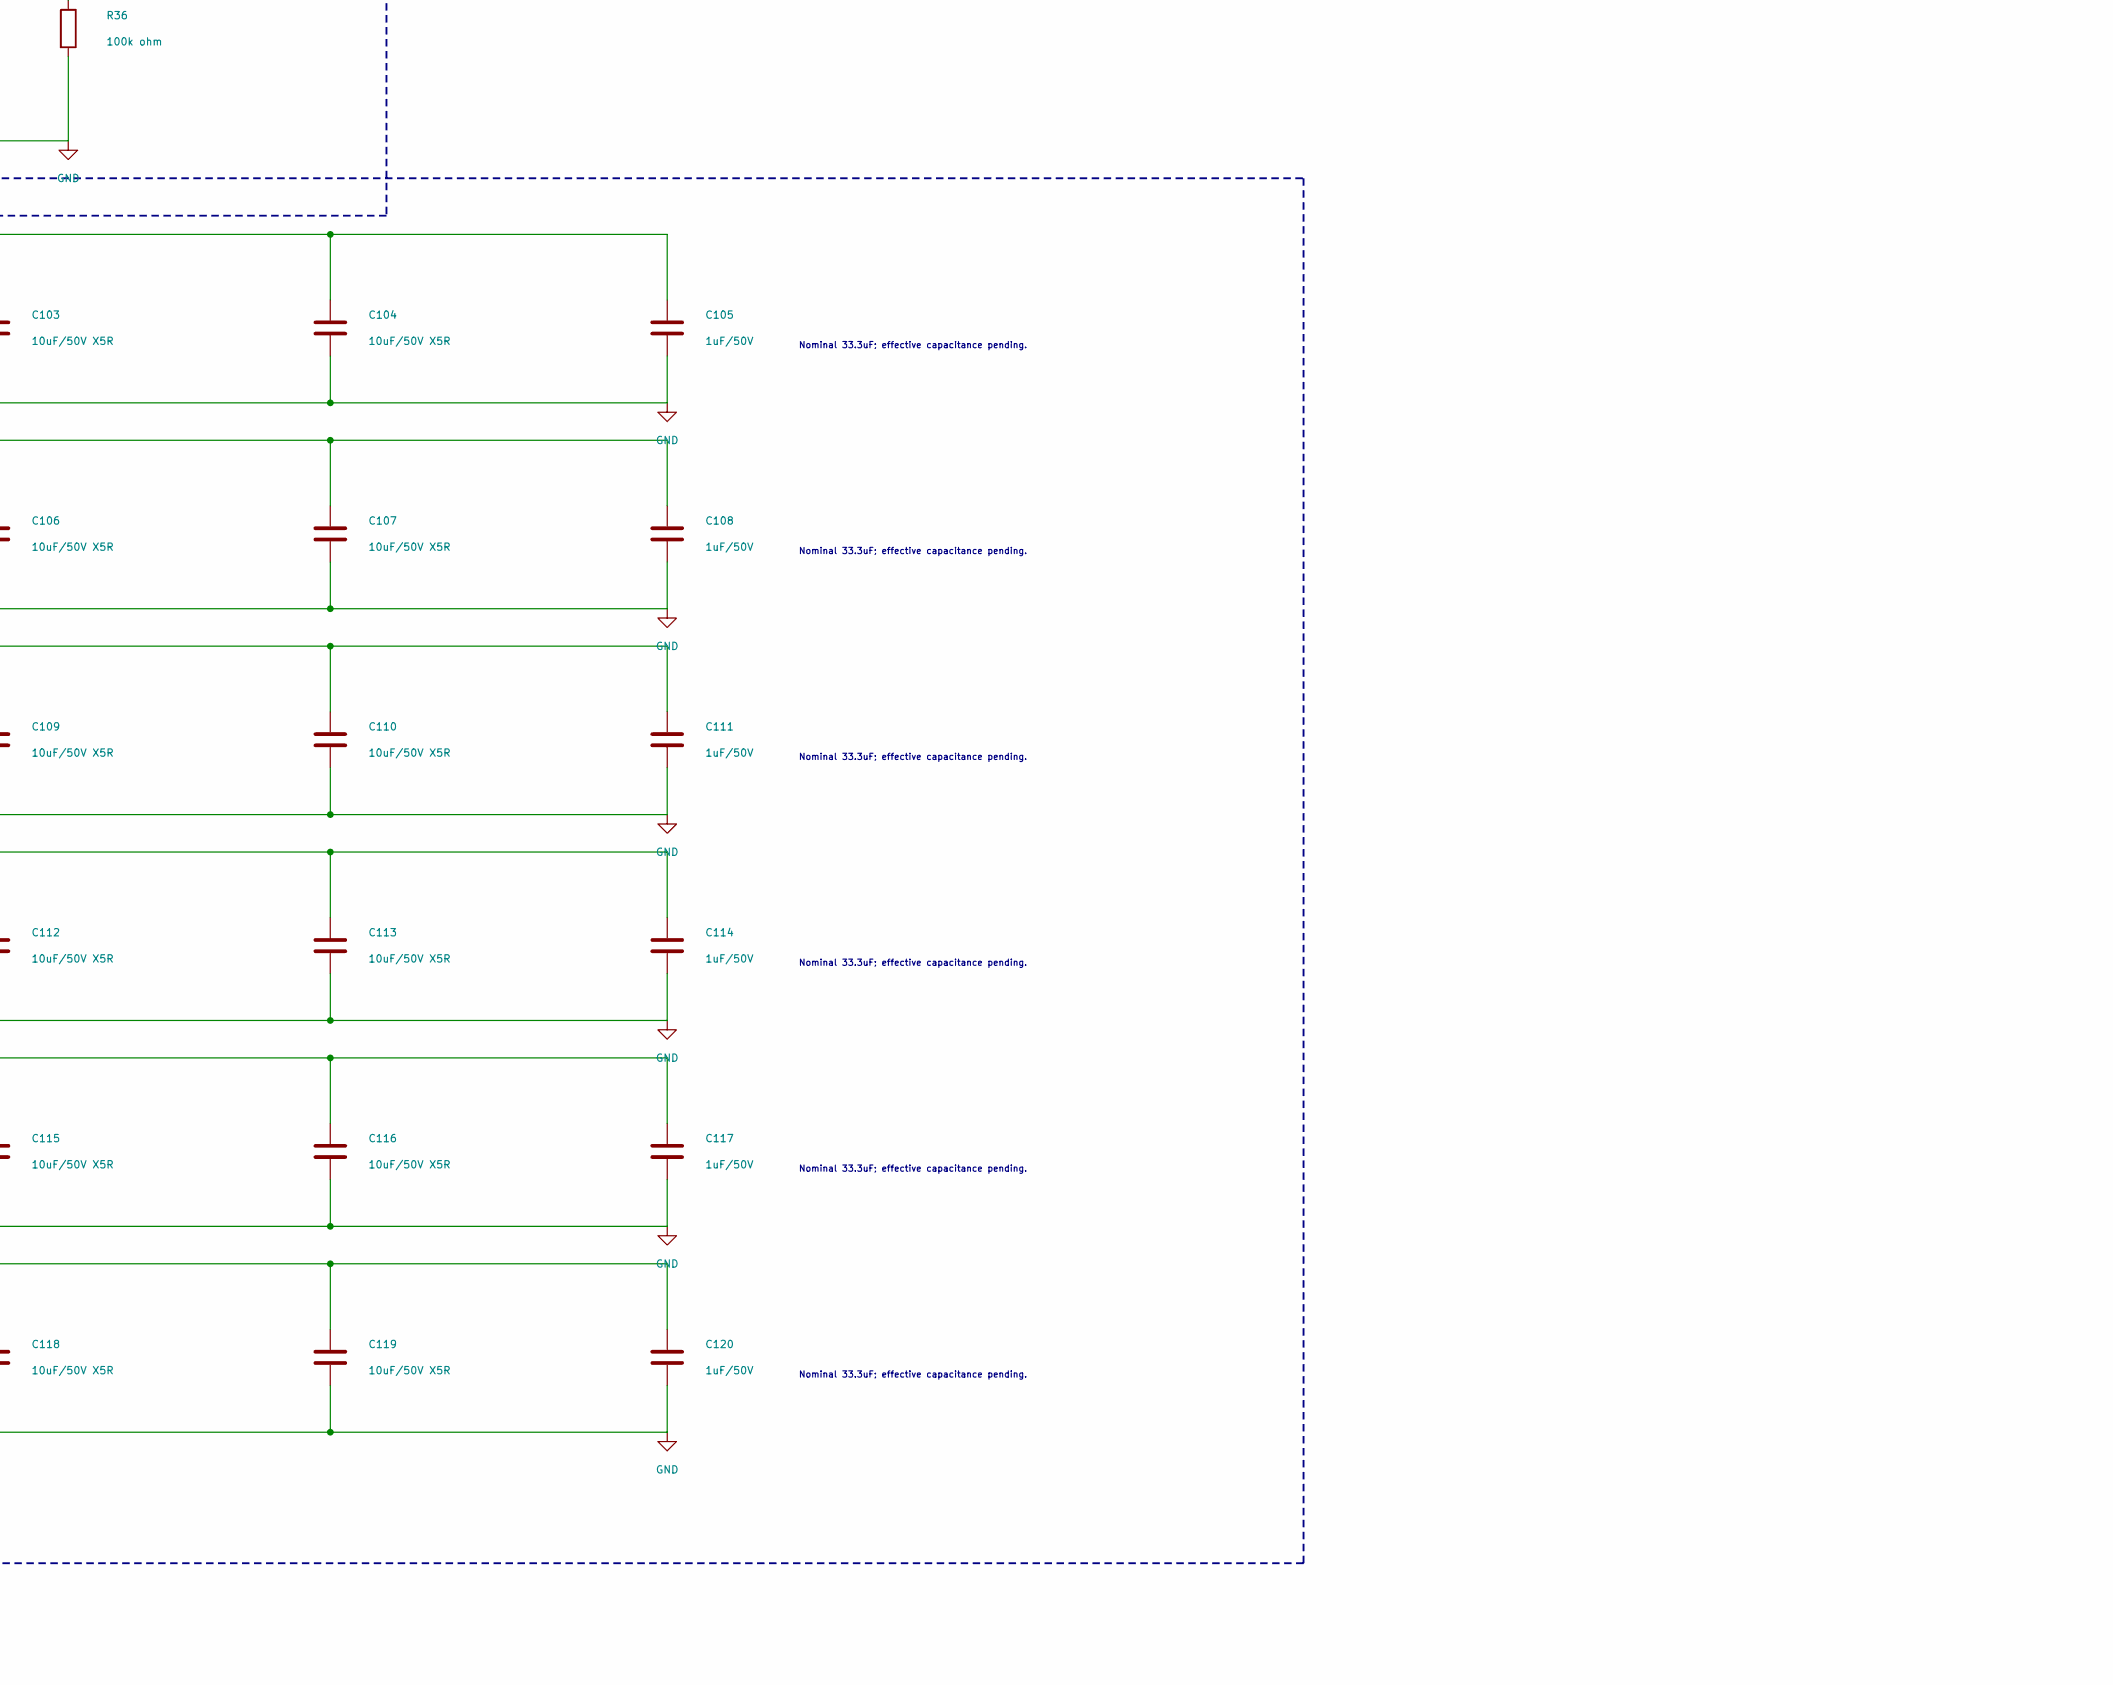
[picture p47: schematic panel.kicad_sch, Panel - wired functional circuits, part in row 2, column 2]

Parts:
C1, C2, C3, C4, C5, C6, C7, C103, C104, C106, C107, C109, C110, C112, C113, C115, C116, C118, C119: 10uF/50V X5R; C_0805_HandSolder; MPN GRM21BR61H106KE43L; LCSC C440198
C8: 4.7uF/50V; C_1206_HandSolder; MPN 1206B475K500NT; LCSC C29823
C9, C10, C11: 470nF/50V; C_0805_HandSolder; MPN CL21B474KBFNNNE; LCSC C13967
C27: 100nF/100V; C_0805_HandSolder; MPN CL21B104KCFNNNE; LCSC C28233
C105, C108, C111, C114, C117, C120: 1uF/50V; C_0805_HandSolder; MPN CL21B105KBFNNNE; LCSC C28323
FPC1: FPC-05FB-60PH20; FPC_05FB_60PH20; MPN FPC-05FB-60PH20; LCSC C2856839
R1: 2k ohm; R_0805_HandSolder; MPN 0805W8F2001T5E; LCSC C17604
R20, R21: 4.7k ohm; R_0805_HandSolder; MPN 0805W8F4701T5E; LCSC C17673
R35, R36: 100k ohm; R_0805_HandSolder; MPN 0805W8F1003T5E; LCSC C149504
U4: TCN75AVOA713; Package_SO__SOIC-8_3.9x4.9mm_P1.27mm; MPN TCN75AVOA713; LCSC C144313

Connections:
BUSY_N: FPC1.25 (BUSY_N), R1.1; also elsewhere on the board
CS_M_N: FPC1.27 (CS_M_N); also elsewhere on the board
CS_S_N: FPC1.58 (CS_S_N); also elsewhere on the board
DRVN: FPC1.37 (DRVN); also elsewhere on the board
DRVP: FPC1.33 (DRVP); also elsewhere on the board
EPD_3V3: C27.1, FPC1.9 (AVDD), FPC1.10 (VDD), FPC1.19 (VDDIO), FPC1.22 (BS0), FPC1.23 (BS1), R1.2, R20.2, R21.2, U4.8 (VDD); also elsewhere on the board
FBN: FPC1.38 (FBN); also elsewhere on the board
FBP: FPC1.34 (FBP); also elsewhere on the board
FPL_VCOM: C9.1, FPC1.54 (FPL_VCOM)
GDRC: FPC1.3 (GDRC); also elsewhere on the board
GDRN: FPC1.5 (GDRN); also elsewhere on the board
GDRP: FPC1.7 (GDRP); also elsewhere on the board
GND: C1.2, C2.2, C3.2, C4.2, C5.2, C6.2, C7.2, C8.2, C9.2, C10.2, C11.2, C27.2, C103.2, C104.2, C105.2, C106.2, C107.2, C108.2, C109.2, C110.2, C111.2, C112.2, C113.2, C114.2, C115.2, C116.2, C117.2, C118.2, C119.2, C120.2, FPC1.8 (GND), FPC1.26 (GND), FPC1.35 (GND), R35.2, R36.2, U4.4 (GND), U4.5 (A2), U4.6 (A1), U4.7 (A0); also elsewhere on the board
REG_VGN: FPC1.39 (REG_VGN); also elsewhere on the board
RESEC: FPC1.2 (RESEC); also elsewhere on the board
RESEN: FPC1.4 (RESEN); also elsewhere on the board
RESEP: FPC1.6 (RESEP); also elsewhere on the board
RES_N: FPC1.24 (RES_N); also elsewhere on the board
SCLK: FPC1.28 (SCLK); also elsewhere on the board
SI0: FPC1.29 (SI0); also elsewhere on the board
SI1: FPC1.30 (SI1); also elsewhere on the board
SI2: FPC1.31 (SI2), R35.1
SI3: FPC1.32 (SI3), R36.1
TFT_VCOM: C8.1, FPC1.55 (TFT_VCOM); also elsewhere on the board
TSCL: FPC1.20 (TSCL), R20.1, U4.2 (SCL)
TSDA: FPC1.21 (TSDA), R21.1, U4.1 (SDA)
VBB_3P5V: FPC1.41 (VNCP_3P5V), FPC1.56 (VBB_3P5V); also elsewhere on the board
VCC: C7.1, FPC1.12 (VCC), FPC1.18 (VCC1); also elsewhere on the board
VCOMBD_M: C10.1, FPC1.1 (VCOMBD_M)
VCOMBD_S: C11.1, FPC1.36 (VCOMBD_S)
VDDN: FPC1.16 (VDDN), FPC1.17 (VDDN); also elsewhere on the board
VDDP: FPC1.13 (VDDP), FPC1.14 (VDDP); also elsewhere on the board
VGH: FPC1.59 (VGH); also elsewhere on the board
VGL: FPC1.60 (VGL); also elsewhere on the board
VSNH: C4.1, C112.1, C113.1, C114.1, FPC1.48 (VSNH), FPC1.53 (VSNH); also elsewhere on the board
VSNL: C5.1, C115.1, C116.1, C117.1, FPC1.49 (VSNL), FPC1.52 (VSNL); also elsewhere on the board
VSNL2: C6.1, C118.1, C119.1, C120.1, FPC1.50 (VSNL2), FPC1.51 (VSNL2); also elsewhere on the board
VSPH: C1.1, C103.1, C104.1, C105.1, FPC1.42 (VSPH), FPC1.45 (VSPH); also elsewhere on the board
VSPL: C2.1, C106.1, C107.1, C108.1, FPC1.43 (VSPL), FPC1.46 (VSPL); also elsewhere on the board
VSPL2: C3.1, C109.1, C110.1, C111.1, FPC1.44 (VSPL2), FPC1.47 (VSPL2); also elsewhere on the board

Notes on the sheet:
1 Screen connector - pin numbers retained; functional pin layout
Symbol grouping does not represent physical FPC pin positions.
2 SPI mode / signal defaults
3 Panel-controlled temperature sensor
R23 DNP: alert output is not strapped to ground.
4 Source outputs / input straps / capacitor banks
Nominal 33.3uF; effective capacitance pending.
Dots join wires; crossings without dots do not connect. Global labels are cross-sheet interfaces.
