Rhys-Q/album/hardware/pcb/gdep133c02-driver/gdep133c02-driver.kicad_pcb

## KiCad design hardware/pcb/gdep133c02-driver/gdep133c02-driver.kicad_pcb (continued)

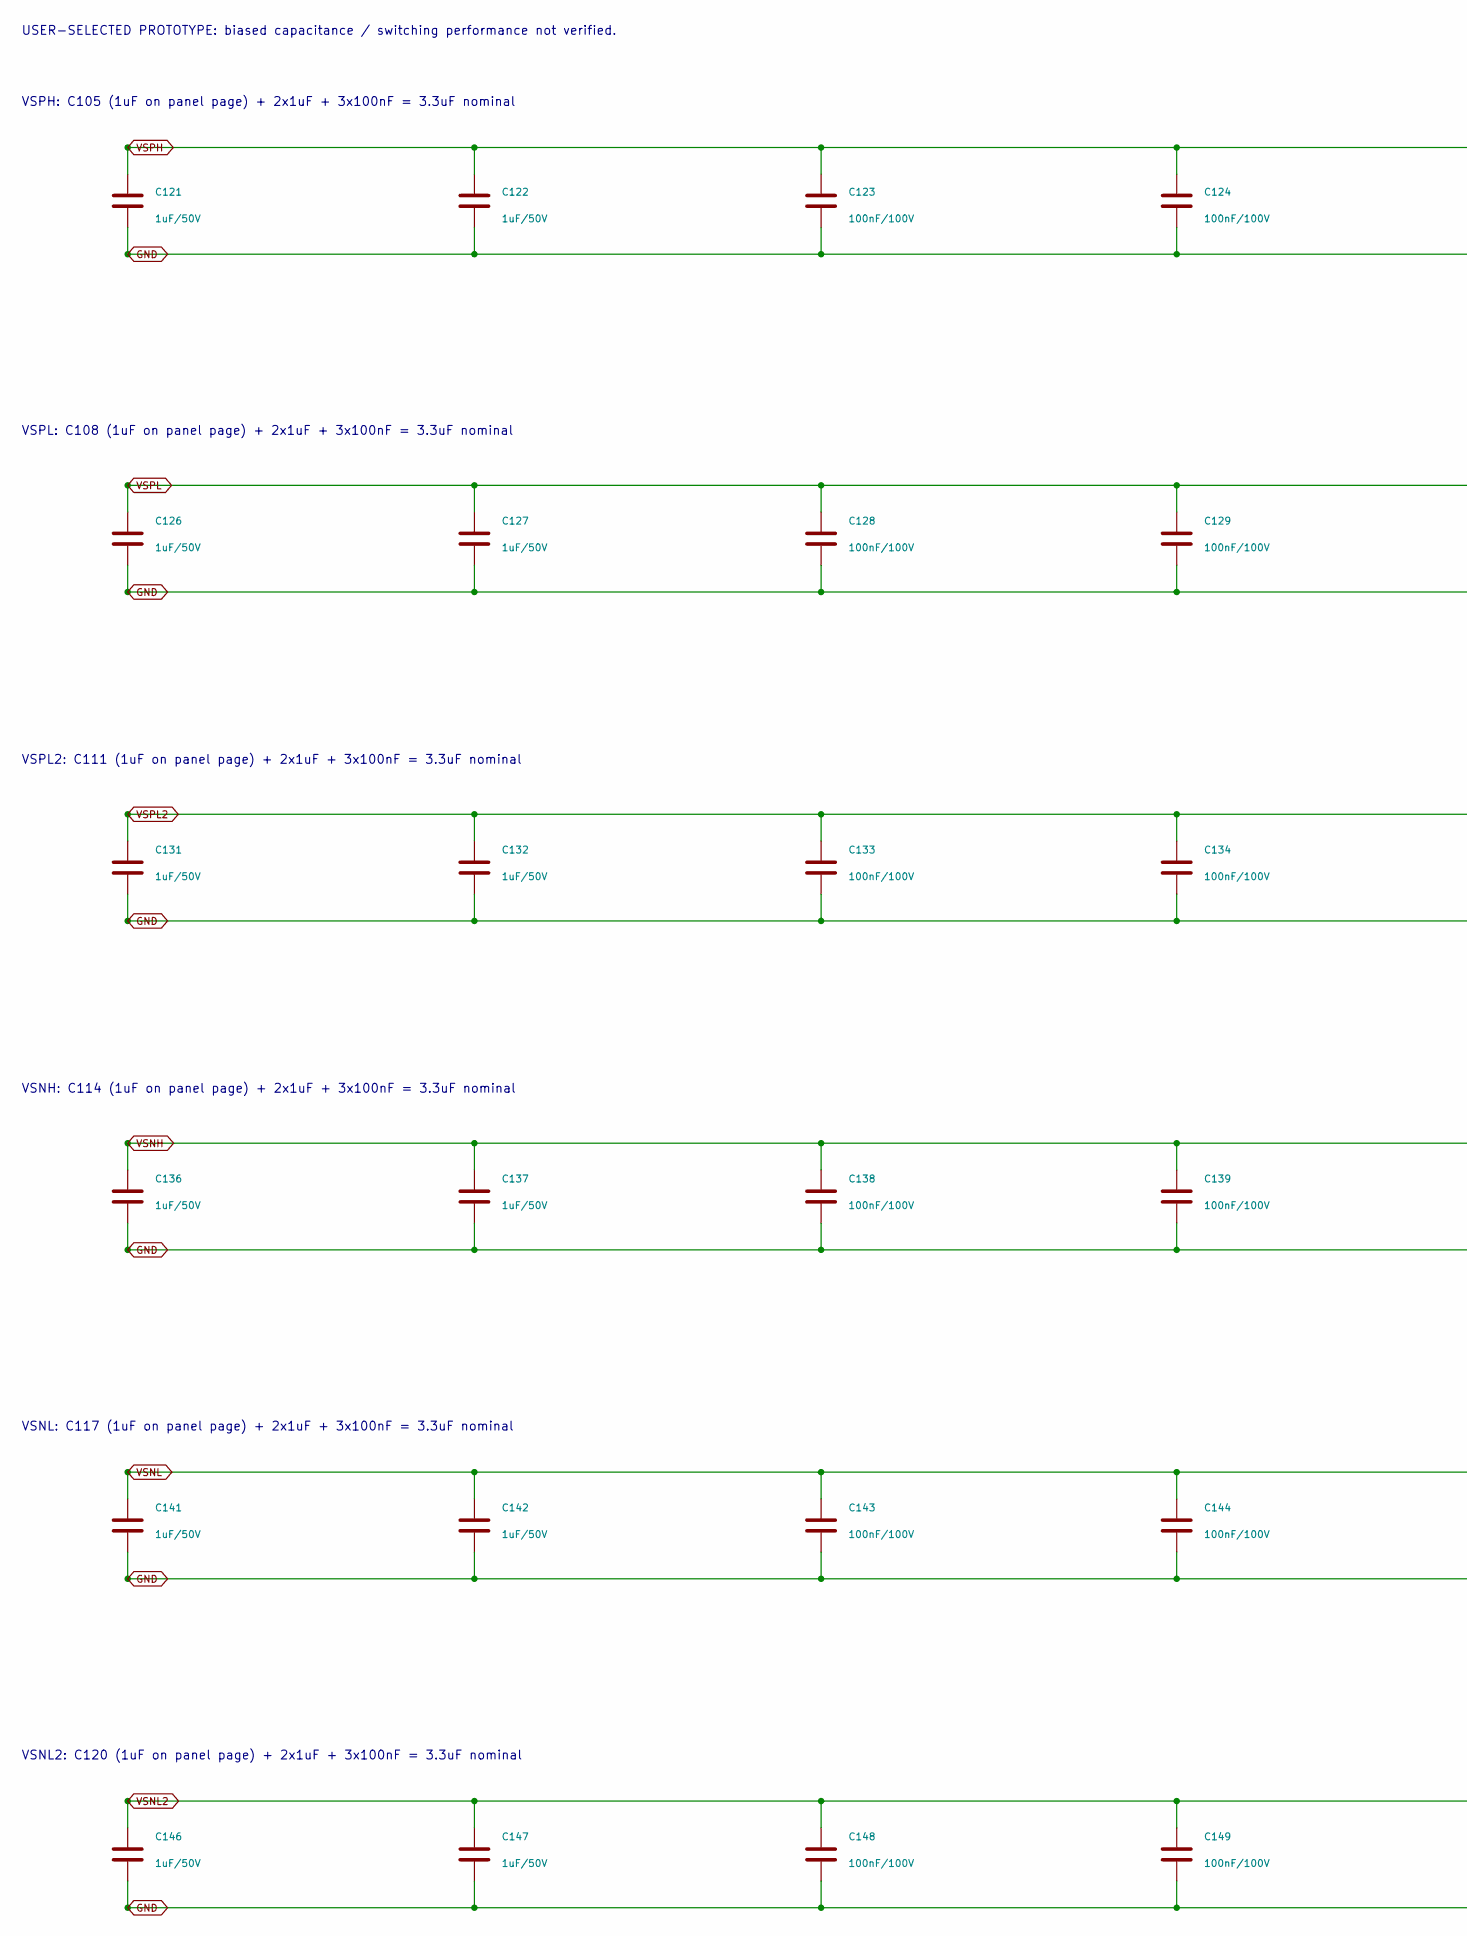
[picture p48: schematic basic-composites.kicad_sch, Basic-library composites / prototype v0.11, part in row 1, column 1]

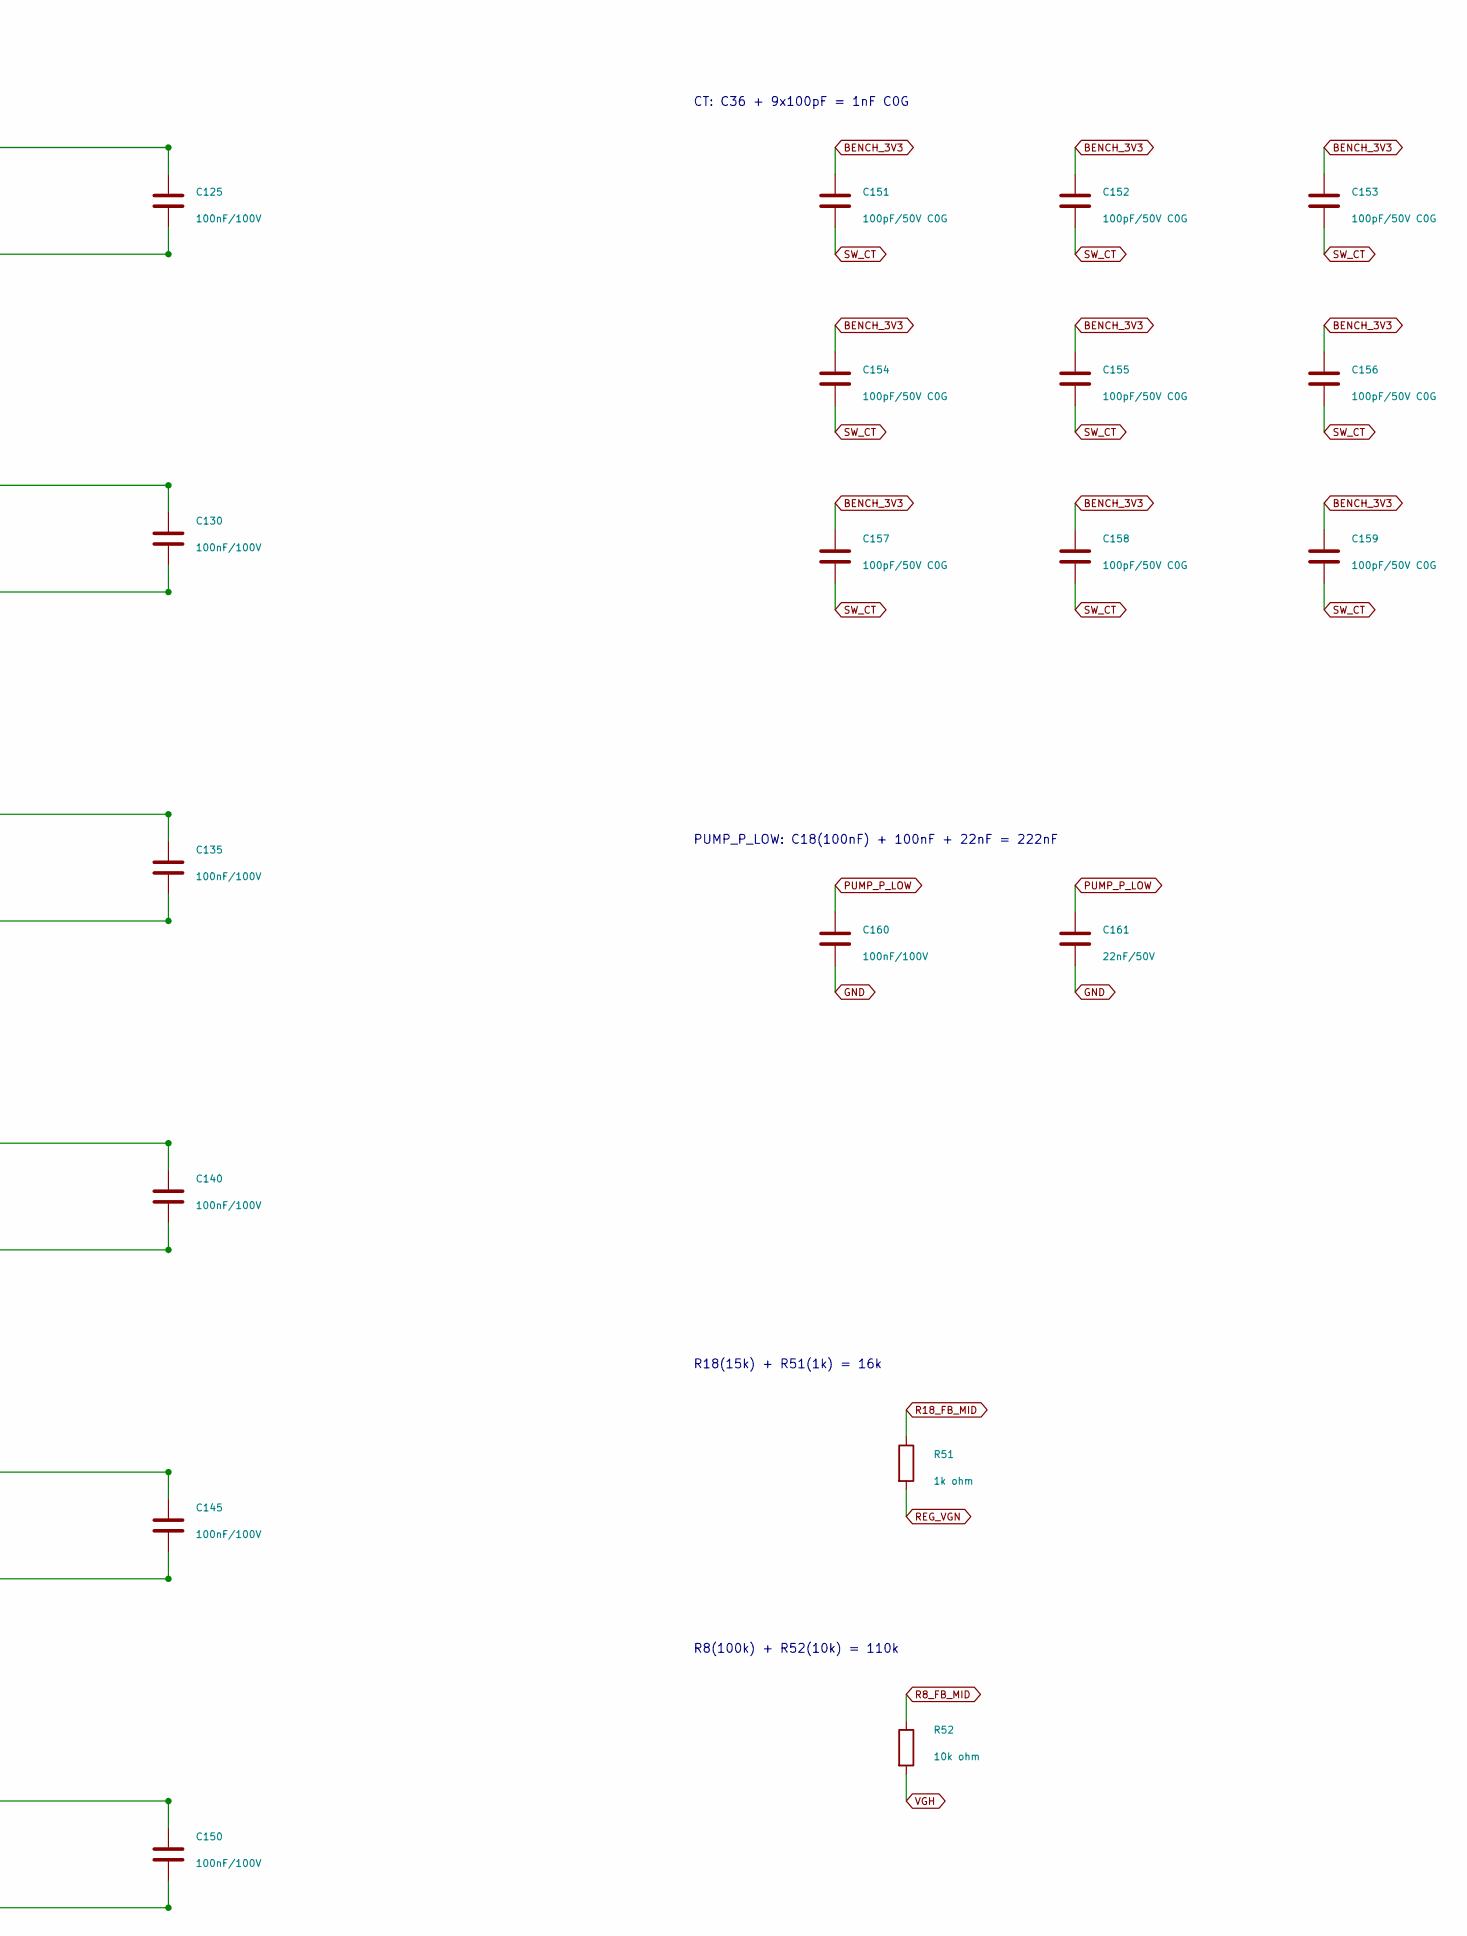
[picture p49: schematic basic-composites.kicad_sch, Basic-library composites / prototype v0.11, part in row 1, column 2]

Parts:
C121, C122, C126, C127, C131, C132, C136, C137, C141, C142, C146, C147: 1uF/50V; C_0805_HandSolder; MPN CL21B105KBFNNNE; LCSC C28323
C123, C124, C125, C128, C129, C130, C133, C134, C135, C138, C139, C140, C143, C144, C145, C148, C149, C150, C160: 100nF/100V; C_0805_HandSolder; MPN CL21B104KCFNNNE; LCSC C28233
C151, C152, C153, C154, C155, C156, C157, C158, C159: 100pF/50V C0G; Capacitor_SMD__C_0603_1608Metric; MPN CL10C101JB8NNNC; LCSC C14858
C161: 22nF/50V; C_0805_HandSolder; MPN CL21B223KBANNNC; LCSC C1729
R51: 1k ohm; R_0805_HandSolder; MPN 0805W8F1001T5E; LCSC C17513
R52: 10k ohm; R_0805_HandSolder; MPN 0805W8F1002T5E; LCSC C17414

Connections:
BENCH_3V3: C151.1, C152.1, C153.1, C154.1, C155.1, C156.1, C157.1, C158.1, C159.1; also elsewhere on the board
GND: C121.2, C122.2, C123.2, C124.2, C125.2, C126.2, C127.2, C128.2, C129.2, C130.2, C131.2, C132.2, C133.2, C134.2, C135.2, C136.2, C137.2, C138.2, C139.2, C140.2, C141.2, C142.2, C143.2, C144.2, C145.2, C146.2, C147.2, C148.2, C149.2, C150.2, C160.2, C161.2; also elsewhere on the board
PUMP_P_LOW: C160.1, C161.1; also elsewhere on the board
R8_FB_MID: R52.1; also elsewhere on the board
R18_FB_MID: R51.1; also elsewhere on the board
REG_VGN: R51.2; also elsewhere on the board
SW_CT: C151.2, C152.2, C153.2, C154.2, C155.2, C156.2, C157.2, C158.2, C159.2; also elsewhere on the board
VGH: R52.2; also elsewhere on the board
VSNH: C136.1, C137.1, C138.1, C139.1, C140.1; also elsewhere on the board
VSNL: C141.1, C142.1, C143.1, C144.1, C145.1; also elsewhere on the board
VSNL2: C146.1, C147.1, C148.1, C149.1, C150.1; also elsewhere on the board
VSPH: C121.1, C122.1, C123.1, C124.1, C125.1; also elsewhere on the board
VSPL: C126.1, C127.1, C128.1, C129.1, C130.1; also elsewhere on the board
VSPL2: C131.1, C132.1, C133.1, C134.1, C135.1; also elsewhere on the board

Notes on the sheet:
USER-SELECTED PROTOTYPE: biased capacitance / switching performance not verified.
VSPH: C105 (1uF on panel page) + 2x1uF + 3x100nF = 3.3uF nominal
VSPL: C108 (1uF on panel page) + 2x1uF + 3x100nF = 3.3uF nominal
VSPL2: C111 (1uF on panel page) + 2x1uF + 3x100nF = 3.3uF nominal
VSNH: C114 (1uF on panel page) + 2x1uF + 3x100nF = 3.3uF nominal
VSNL: C117 (1uF on panel page) + 2x1uF + 3x100nF = 3.3uF nominal
VSNL2: C120 (1uF on panel page) + 2x1uF + 3x100nF = 3.3uF nominal
CT: C36 + 9x100pF = 1nF C0G
PUMP_P_LOW: C18(100nF) + 100nF + 22nF = 222nF
R18(15k) + R51(1k) = 16k
R8(100k) + R52(10k) = 110k

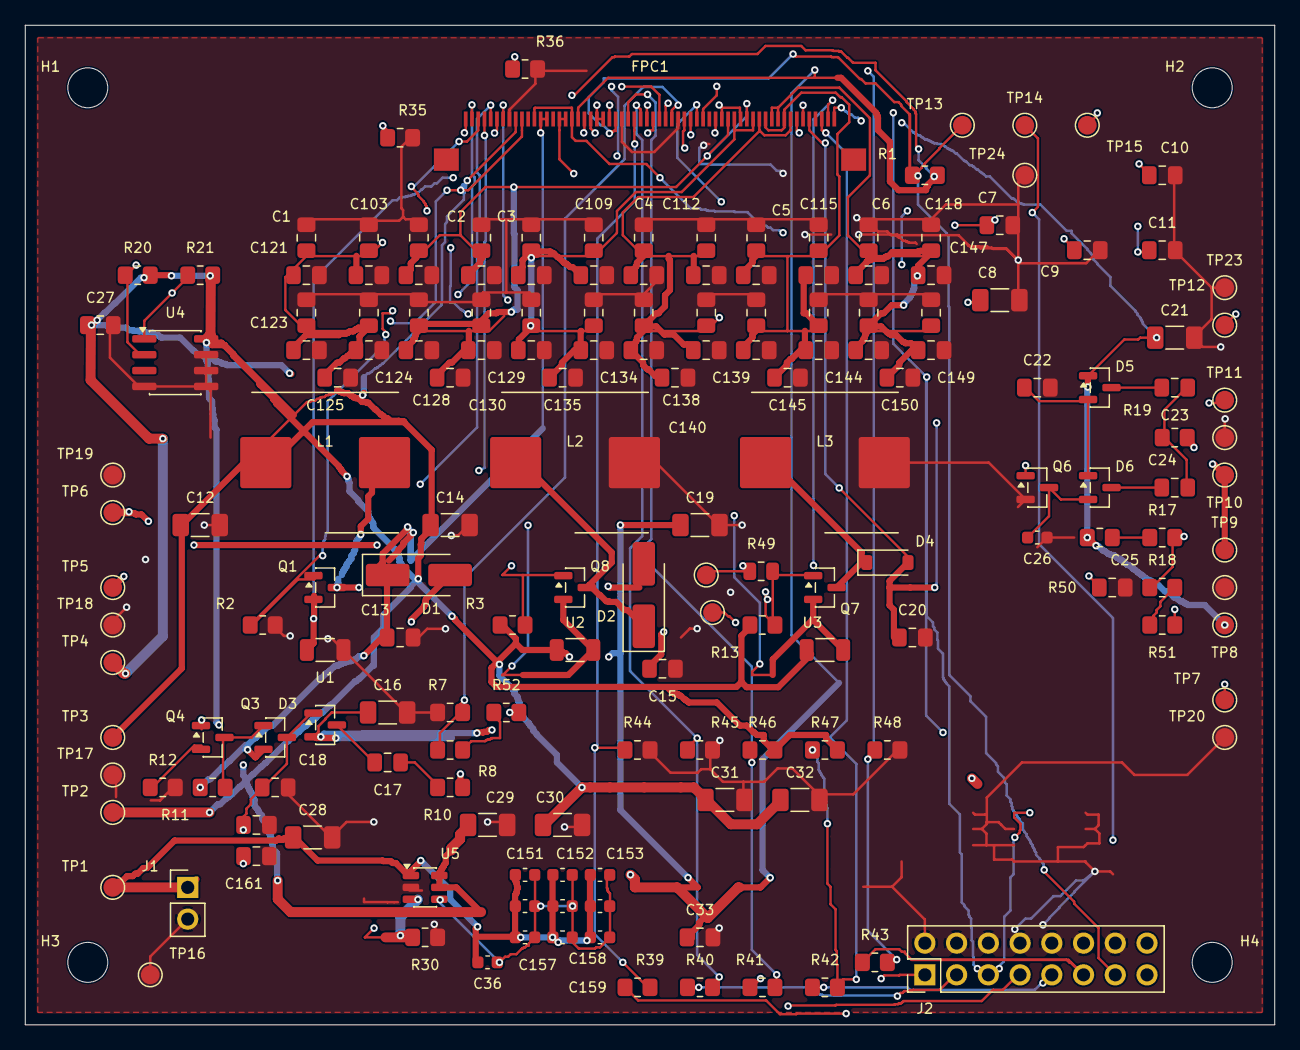
[picture p50: board gdep133c02-driver.kicad_pcb from above]

Board: 4 copper layers, 100.0 x 80.0 mm, 177 parts (0 on the bottom side), 65 nets.

Other parts of the board:
H1, H2, H3, H4: MountingHole_3.2mm_M3
