Rhys-Q/album/(commit log)

2026-10-10 feat(pcb): release v0.9 with fee-waived resistor selections
    [bom-review.csv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]
2026-10-11 hardware: use Murata C440198 0805 capacitors and release v0.10
2026-10-11 feat(pcb): adopt 17 basic-library groups and release v0.11 prototype
2026-10-11 chore(pcb): split self-sourced parts from v0.11 SMT release
